BehrensG/MADC_ARTY/Hardware/Pinout.txt

GAIN_x10 - IO0 - T14
GAIN_x100 - IO1 - U12
SW_VRH - IO3 - V13
AD_CMP - IO4 - V15
AD_IRN - IO5 - T15
AD_IRP - IO6 - R16
AD_ID - IO7 - U17
AD_IIN - IO8 - V17
AZ_CTR - IO9 - V18
