BehrensG/MADC_ARTY/Software/vivado/MADC_ARTY_Z7/MADC_ARTY_Z7.runs/impl_1/.init_design.begin.rst

<?xml version="1.0"?>
<ProcessHandle Version="1" Minor="0">
    <Process Command=".planAhead." Owner="grzegorz" Host="" Pid="397433">
    </Process>
</ProcessHandle>
