BehrensG/MADC_ARTY/Software/vivado/MADC_ARTY_Z7/MADC_ARTY_Z7.runs/impl_1/.vivado.begin.rst

<?xml version="1.0"?>
<ProcessHandle Version="1" Minor="0">
    <Process Command="vivado" Owner="grzegorz" Host="archlinux" Pid="49196" HostCore="12" HostMemory="65488520">
    </Process>
</ProcessHandle>
<?xml version="1.0"?>
<ProcessHandle Version="1" Minor="0">
    <Process Command="vivado" Owner="grzegorz" Host="archlinux" Pid="86323" HostCore="12" HostMemory="65488520">
    </Process>
</ProcessHandle>
<?xml version="1.0"?>
<ProcessHandle Version="1" Minor="0">
    <Process Command="vivado" Owner="grzegorz" Host="archlinux" Pid="127596" HostCore="12" HostMemory="65488520">
    </Process>
</ProcessHandle>
<?xml version="1.0"?>
<ProcessHandle Version="1" Minor="0">
    <Process Command="vivado" Owner="grzegorz" Host="archlinux" Pid="166918" HostCore="12" HostMemory="65488520">
    </Process>
</ProcessHandle>
<?xml version="1.0"?>
<ProcessHandle Version="1" Minor="0">
    <Process Command="vivado" Owner="grzegorz" Host="archlinux" Pid="196931" HostCore="12" HostMemory="65488520">
    </Process>
</ProcessHandle>
<?xml version="1.0"?>
<ProcessHandle Version="1" Minor="0">
    <Process Command="vivado" Owner="grzegorz" Host="archlinux" Pid="236867" HostCore="12" HostMemory="65488520">
    </Process>
</ProcessHandle>
<?xml version="1.0"?>
<ProcessHandle Version="1" Minor="0">
    <Process Command="vivado" Owner="grzegorz" Host="archlinux" Pid="271964" HostCore="12" HostMemory="65488520">
    </Process>
</ProcessHandle>
<?xml version="1.0"?>
<ProcessHandle Version="1" Minor="0">
    <Process Command="vivado" Owner="grzegorz" Host="archlinux" Pid="322385" HostCore="12" HostMemory="65488520">
    </Process>
</ProcessHandle>
<?xml version="1.0"?>
<ProcessHandle Version="1" Minor="0">
    <Process Command="vivado" Owner="grzegorz" Host="archlinux" Pid="364940" HostCore="12" HostMemory="65488520">
    </Process>
</ProcessHandle>
<?xml version="1.0"?>
<ProcessHandle Version="1" Minor="0">
    <Process Command="vivado" Owner="grzegorz" Host="archlinux" Pid="397376" HostCore="12" HostMemory="65488520">
    </Process>
</ProcessHandle>
