BehrensG/MADC_ARTY/Software/vivado/MADC_ARTY_Z7/MADC_ARTY_Z7.runs/impl_1/clockInfo.txt

-------------------------------------
| Tool Version : Vivado v.2024.1
| Date         : Wed Oct 14 21:35:47 2026
| Host         : archlinux
| Design       : design_1
| Device       : xc7z010-clg400-1--
-------------------------------------

For more information on clockInfo.txt clock routing debug file see https://support.xilinx.com/s/article/000035660?language=en_US
