BehrensG/MADC_ARTY/Software/vivado/MADC_ARTY_Z7/MADC_ARTY_Z7.runs/MADC_ARTY_Z7_MADC_0_0_synth_1/.vivado.begin.rst

<?xml version="1.0"?>
<ProcessHandle Version="1" Minor="0">
    <Process Command="vivado" Owner="grzegorz" Host="archlinux" Pid="396401" HostCore="12" HostMemory="65488520">
    </Process>
</ProcessHandle>
