BehrensG/MADC_ARTY/Hardware/MADC_ARTY/CMRR.ods

Freq (Hz) | Sig A (Vrms) | Sig B (Vrms) | CMRR (dB)
100 | 3.5 | 1.83E-03 | 65.6323390923969 | 0.2196
200 | 3.57 | 1.84E-03 | 65.7570078620531 | 0.2208
300 | 3.64 | 3.80E-03 | 59.6263557406449 | 0.456
400 | 3.42 | 3.80E-03 | 59.0848501887865 | 0.456
500 | 3.5 | 3.81E-03 | 59.2628613734931 | 0.4572
600 | 3.53 | 3.81E-03 | 59.3369945942441 | 0.4572
700 | 3.64 | 3.40E-03 | 60.592449332136 | 0.408
800 | 3.57 | 3.40E-03 | 60.4237859813988 | 0.408
900 | 3.39 | 3.36E-03 | 60.0772084162648 | 0.4032
1000 | 3.42 | 3.40E-03 | 60.0509437802776 | 0.408
2000 | 3.42 | 3.04E-03 | 61.0230504489476 | 0.3648
3000 | 3.54 | 3.03E-03 | 61.3512126704697 | 0.3636
4000 | 3.41 | 2.60E-03 | 62.3556206204336 | 0.312
5000 | 3.51 | 2.60E-03 | 62.6066753699001 | 0.312
6000 | 3.54 | 2.60E-03 | 62.6805982810994 | 0.312
7000 | 3.43 | 2.63E-03 | 62.3067674310603 | 0.3156
8000 | 3.57 | 1.90E-03 | 65.4782923031873 | 0.228
9000 | 3.39 | 1.90E-03 | 65.0289219450051 | 0.228
10000 | 3.42 | 1.90E-03 | 65.1054501020661 | 0.228
20000 | 3.55 | 2.14E-03 | 64.3962915941181 | 0.2568
30000 | 3.54 | 2.41E-03 | 63.3397243890184 | 0.2892
40000 | 3.55 | 2.70E-03 | 62.3772917779221 | 0.324
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
