BehrensG/MADC_ARTY/Hardware/MADC/MADC.step

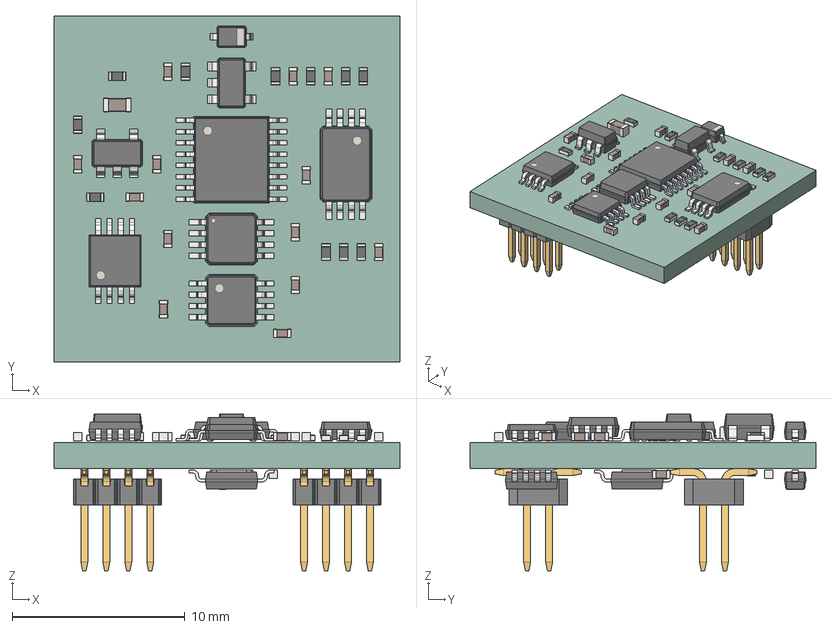
[picture p1: CAD file, 2025-08-14]
Hardware/MADC/MADC.step
20.0 x 20.0 x 9.05 mm
C_0402_1005Metric x 15
D_SOD-323 x 2
R_0402_1005Metric x 12
TSSOP-8_4.4x3mm_P0.65mm
C_0603_1608Metric
SOT-23-5 x 2
TSSOP-16_4.4x5mm_P0.65mm
VSSOP-8_3x3mm_P0.65mm
MSOP-8-1EP_3x3mm_P0.65mm_EP1.73x1.85mm x 3
MSOP-8_3x3mm_P0.65mm
621x0821021_Housing x 2
6210xx21021_PIN x 16
MADC_PCB
