BehrensG/MADC_ARTY/LTSpice/MADC.asc

A1: and
A3: dflop; Vhigh=3.3 Vlow=0 Ref=1.65
C1: cap; 0.0022µ; V=50 Irms=0 Rser=0.0481 Lser=423p mfg="Würth Elektronik" pn="885012008051 WCAP-CSGP 1206" type="NP0"
C2: cap; 33p; V=25 Irms=0 Rser=0 Lser=0 mfg="Murata" pn="GRM0335C1E330JA01" type="C0G"
D1: diode; 1N4148
D2: diode; 1N4148
R1: res; 62k
R2: res; 62
R3: res; 39k
R4: res; 3k9
R5: res; 3k9
R6: res; 620
R7: res; 12k
U1: OPAx140
U2: OPAx192
U3: ADA4177
U4: LT5400-1
U5: ADA4177
U6: LT5400-2
U8: ADG5412
U10: RH111
V1: voltage; 7
V2: voltage; 18
V3: voltage; -14
V4: voltage; 3.3
V5: voltage; 6
V6: voltage; 3.3
V9: voltage; 0
V11: voltage; PULSE(3.3 0 100u 100n 100n 50u 100u)
Named nets: 0, VDD, VSS, AD_REF_N, AD_REF_P, AD_IIN, AD_IRP, AD_IRN, AD_ID, MEAS_VOLT, VCC, AD_CMP, WAVE
.tran 0 0.021 40u 1u uic
.options plotwinsize=0
.wave "Z:\\home\\grzegorz\\git\\MADC_ARTY\\LTSpice\\wave.wav" 16 1000000 V(wave)
