BehrensG/MADC_ARTY/LTSpice/Logic.asc

A2: srflop; Vhigh=3.3 Vlow=0 Ref=1.65
C1: cap; 100n
R1: res; 10
V1: voltage; PULSE(0 3.3 0 1n 1n 1u 200u)
V2: voltage; PULSE(0 3.3 0 1n 1n 100u 200u)
Named nets: 0
.tran 25m uic
