BehrensG/MADC_ARTY/LTSpice/Draft1.asc

J1: njf
R1: res; 10k
R2: res; 10k
R3: res; 3k2
U1: OP07
Named nets: 0
