BehrensG/MADC_ARTY/LTSpice/Frontend.asc

1Meg: res; 100k
J1: njf; 2N4392
J2: njf; 2N4392
Q1: npn; SST3904
Q2: npn; SST3904
Q3: npn; SST3904
Q4: npn; SST3904
Q5: npn; SST3904
Q6: npn; SST3904
Q7: npn; SST3904
Q8: npn; SST3904
R1: res; 21k5
R2: res; 2k
R3: res; 14k7
R4: res; 2k
R5: res; 2k
R6: res; 21k5
R7: res; 21k5
R8: res; 21k5
R9: res; 2k
R10: res; 14k7
R11: res; 2k
R12: res; 2k
R13: res; 21k5
R14: res; 21k5
R15: res; 10
R16: res; 10
R17: res; 100k
U1: ADA4622
U2: ADA4622
U3: ADA4622
U4: ADA4622
U5: JFEx140
U6: JFEx140
U7: JFEx140
U8: JFEx140
U9: OP27
U10: ADA4622
U11: OP27
U12: ADA4622
U13: ADA4622
U14: ADA4622
V1: voltage; 16
V2: voltage; -16
V3: voltage; 10
V4: voltage; SINE(0 10 800k); AC 1
Named nets: 0, VCC, VEE, VREF, OUT_P, OUT_N, IN_P, IN_N
.tran 0.0001 uic
.ac oct 1000 1 50Meg
