BehrensG/MADC_ARTY/LTSpice/LDOs.asc

C1: cap; 10µ; V=50 Irms=0 Rser=0.003 Lser=1.2n mfg="Würth Elektronik" pn="885012214005 WCAP-CSGP 2220" type="X7R"
C2: cap; 10µ; V=50 Irms=0 Rser=0.003 Lser=1.2n mfg="Würth Elektronik" pn="885012214005 WCAP-CSGP 2220" type="X7R"
C3: cap; 10µ; V=50 Irms=0 Rser=0.003 Lser=1.2n mfg="Würth Elektronik" pn="885012214005 WCAP-CSGP 2220" type="X7R"
C4: cap; 10µ; V=50 Irms=0 Rser=0.003 Lser=1.2n mfg="Würth Elektronik" pn="885012214005 WCAP-CSGP 2220" type="X7R"
C5: cap; 10µ; V=50 Irms=0 Rser=0.003 Lser=1.2n mfg="Würth Elektronik" pn="885012214005 WCAP-CSGP 2220" type="X7R"
C6: cap; 10µ; V=50 Irms=0 Rser=0.003 Lser=1.2n mfg="Würth Elektronik" pn="885012214005 WCAP-CSGP 2220" type="X7R"
C7: cap; 10µ; V=50 Irms=0 Rser=0.003 Lser=1.2n mfg="Würth Elektronik" pn="885012214005 WCAP-CSGP 2220" type="X7R"
R1: res; 620k
R2: res; 44.3k
R3: res; 620k
R4: res; 49.9k
R5: res; 620k
R6: res; 45.2k
R7: res; 620k
R8: res; 51.1k
R9: res; 620k
R10: res; 59k
U1: ADP7142
U2: ADP7142
U3: ADP7182
U5: ADP7182
U6: ADP7182
V1: voltage; 20
V2: voltage; -20
V3: voltage; -20
Named nets: 0
.tran 1
