BehrensG/MADC_ARTY/LTSpice/REFV.asc

C1: cap; 1µ; V=50 Irms=0 Rser=0.008 Lser=0 mfg="TDK" pn="C3225X7RlHlO5M" type="X7R"
D1: diode; STZ5_6N
D2: diode; STZ5_6N
Q1: npn; BC847C
Q2: pnp; BC857C
R1: res; 12
R2: res; 12k
R3: res; 2.49k
R4: res; 12k
R5: res; 8.2k
R6: res; 100k
U1: ADR1399E
U2: AD706
U3: LT5400-1
U5: AD706
V1: voltage; 15
V2: voltage; -15
Named nets: 0, VCC, VEE
.tran 0.5 startup
