BehrensG/MADC_ARTY/LTSpice/VREF.asc

C1: cap; 0.1µ; V=100 Irms=835m Rser=0.0936732 Lser=0 mfg="KEMET" pn="C1812C104K1RAC" type="X7R"
C2: cap; 0.1µ; V=100 Irms=835m Rser=0.0936732 Lser=0 mfg="KEMET" pn="C1812C104K1RAC" type="X7R"
R1: res; 2k7
R2: res; 62
R3: res; 2k7
R4: res; 62
R5: res; 5k
R6: res; 5k
R7: res; 10k
R8: res; 6k98
R9: res; 69.8
R10: res; 5k
R11: res; 5k
R12: res; 10k
R13: res; 6k98
R14: res; 69.8
U1: ADR1399E
U2: OP27
U3: ADR1399H
U4: OP27
U5: OP27
U6: OP27
U7: OP27
U8: OP27
V1: voltage; 18
V2: voltage; -18
V3: voltage; -14
Named nets: 0, VCC, VEE, VDD, P7VA, N7VA, P10VA, P7VB, N7VB, P10VB
.tran 40
