BehrensG/MADC_ARTY/Hardware/MADC_ARTY/MADC_ARTY.kicad_pcb

## KiCad design Hardware/MADC_ARTY/MADC_ARTY.kicad_pcb (2025-08-14)

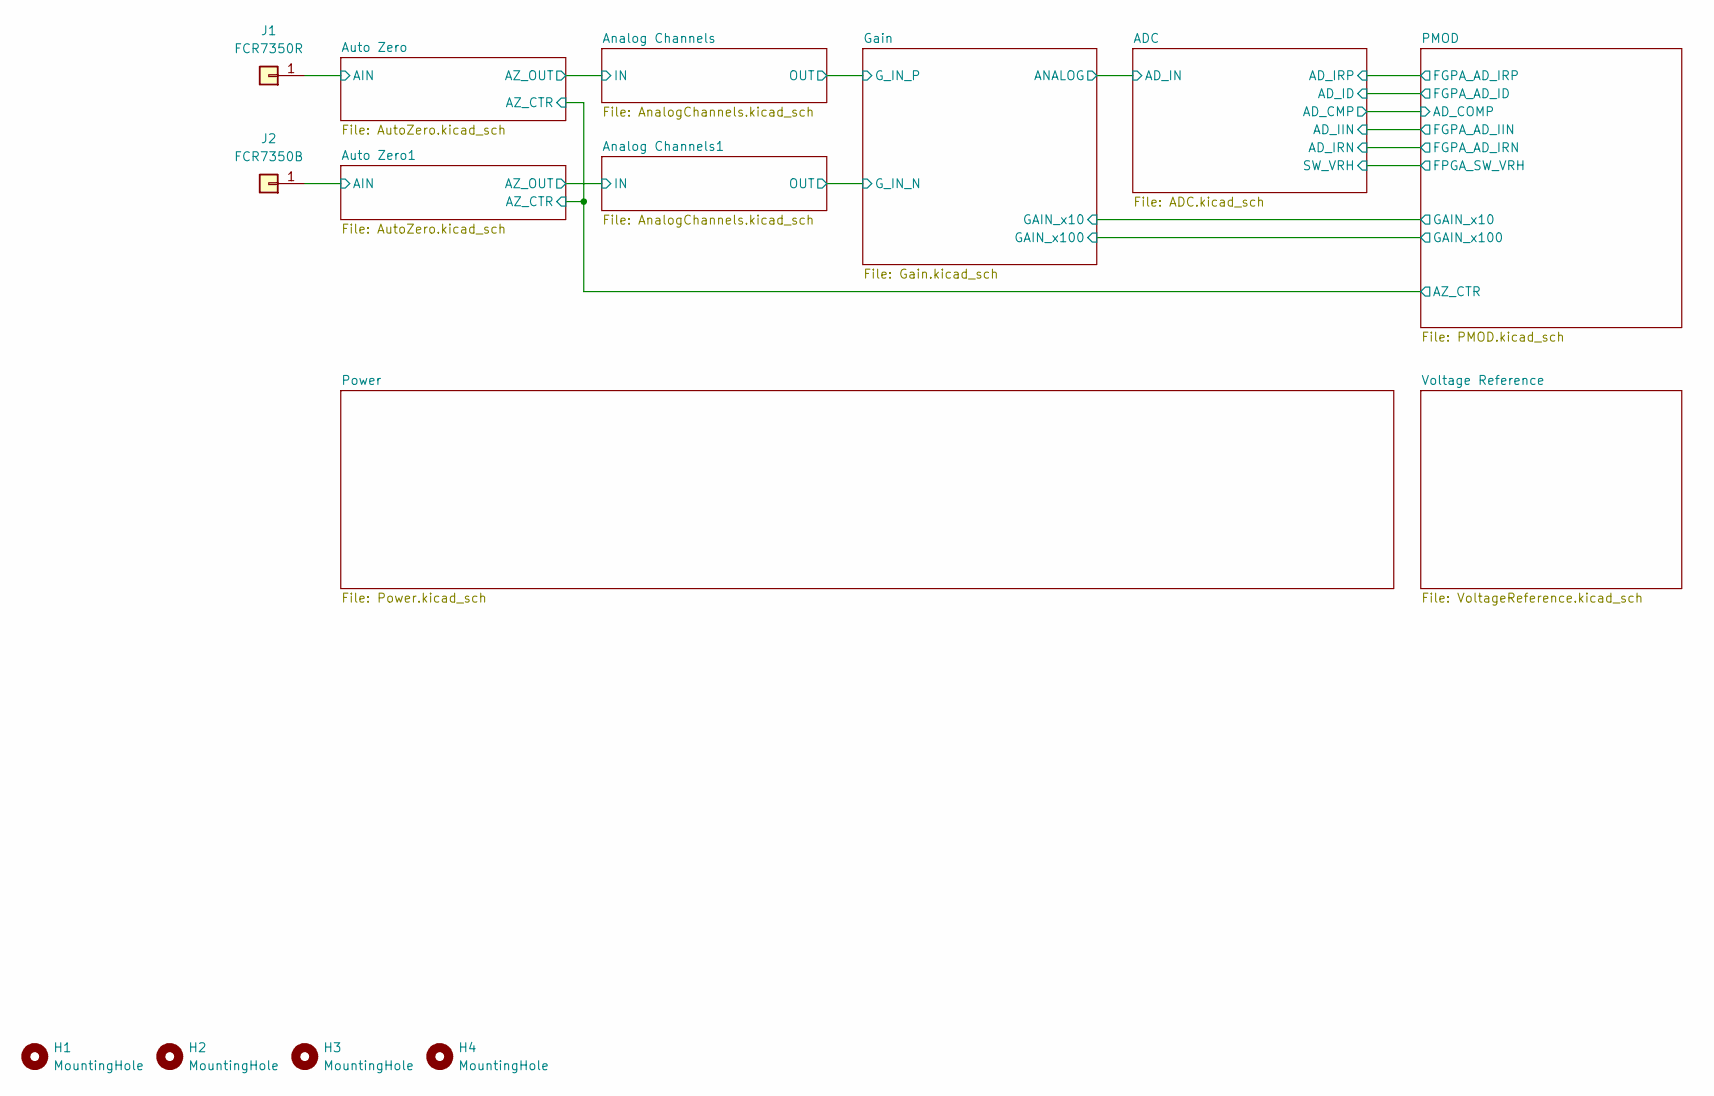
[picture p2: schematic BlockDiagram.kicad_sch]

Parts:
H1, H2, H3, H4: MountingHole; MountingHole_3.2mm_M3_DIN965_Pad
J1: FCR7350R; S16N-PC
J2: FCR7350B; S16N-PC

Connections:
/Block Diagram/Auto Zero1/AIN: J2.1; also elsewhere on the board
/Block Diagram/Auto Zero/AIN: J1.1; also elsewhere on the board

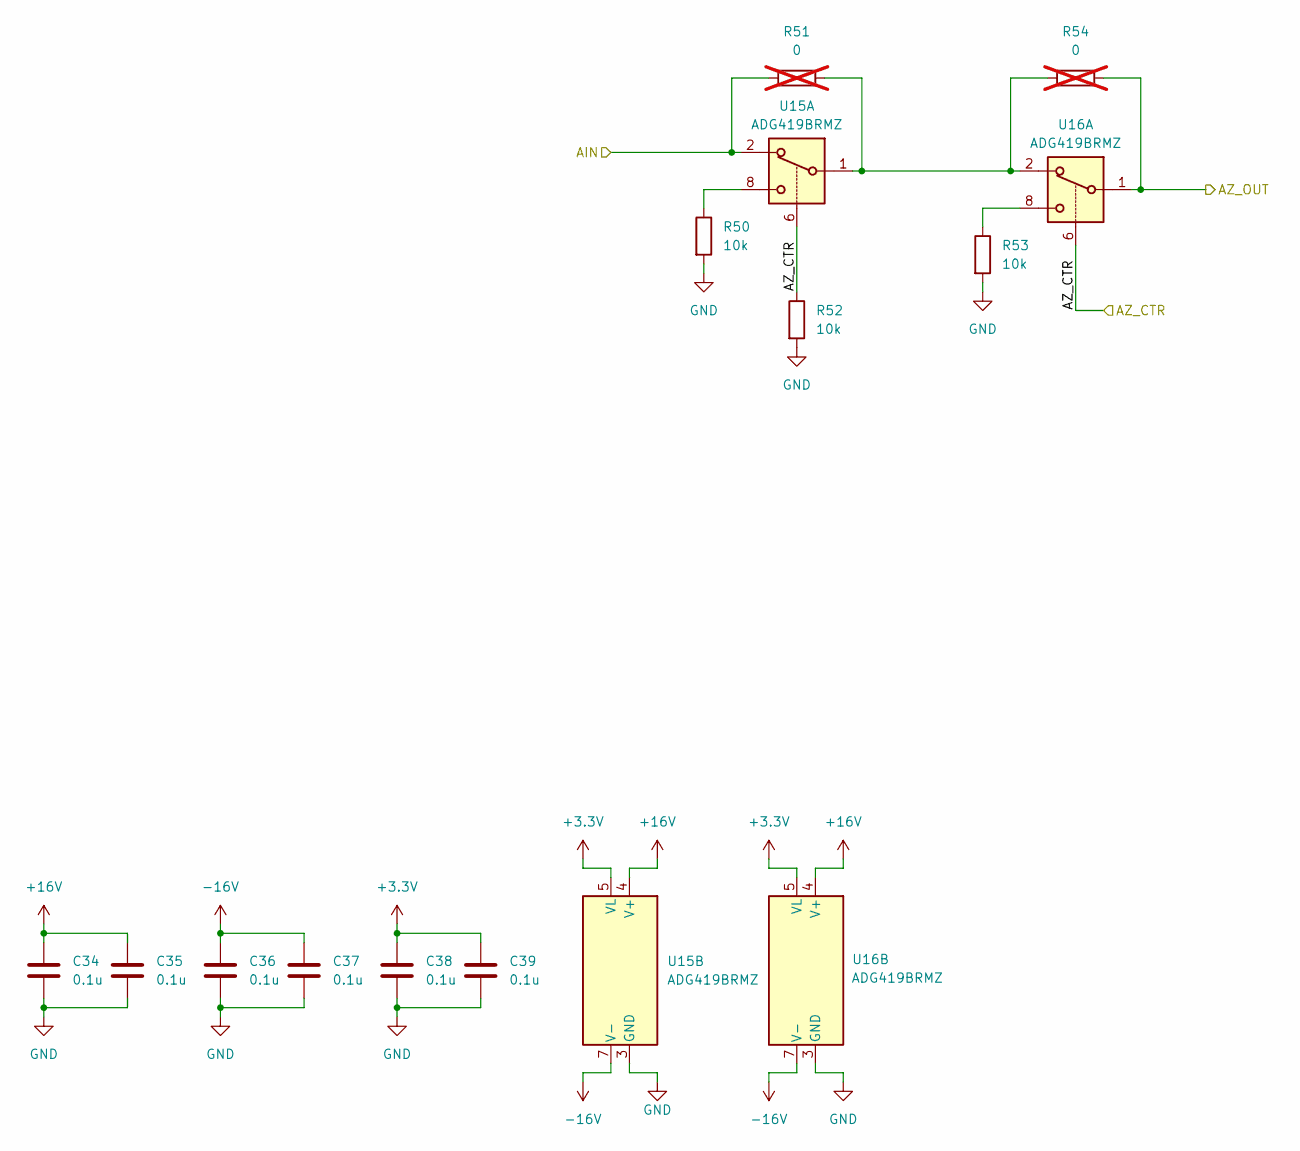
[picture p3: schematic AutoZero.kicad_sch]

Parts:
C34, C35, C36, C37, C38, C39: 0.1u; C_0603_1608Metric
R50, R52, R53: 10k; R_0603_1608Metric
R51, R54: 0; R_0603_1608Metric; not fitted
U15, U16: ADG419BRMZ; MSOP-8_3x3mm_P0.65mm

Connections:
+3.3V: C38.1, C39.1, U15.5 (VL), U16.5 (VL); also elsewhere on the board
+16V: C34.1, C35.1, U15.4 (V+), U16.4 (V+); also elsewhere on the board
-16V: C36.1, C37.1, U15.7 (V-), U16.7 (V-); also elsewhere on the board
/Block Diagram/Analog Channels/IN: R54.2, U16.1; also elsewhere on the board
/Block Diagram/Auto Zero/AIN: R51.1, U15.2; also elsewhere on the board
/Block Diagram/Auto Zero/AZ_CTR: R52.1, U15.6, U16.6; also elsewhere on the board
GND: C34.2, C35.2, C36.2, C37.2, C38.2, C39.2, R50.2, R52.2, R53.2, U15.3 (GND), U16.3 (GND); also elsewhere on the board
unnamed: R50.1, U15.8
unnamed: R51.2, R54.1, U15.1, U16.2
unnamed: R53.1, U16.8

Parts of its further copies:
C47, C48, C49, C50, C51, C52: 0.1u; C_0603_1608Metric
R76, R78, R79: 10k; R_0603_1608Metric
R77, R80: 0; R_0603_1608Metric; not fitted
U23, U24: ADG419BRMZ; MSOP-8_3x3mm_P0.65mm

Connections of its further copies:
+3.3V: C51.1, C52.1, U23.5 (VL), U24.5 (VL); also elsewhere on the board
+16V: C47.1, C48.1, U23.4 (V+), U24.4 (V+); also elsewhere on the board
-16V: C49.1, C50.1, U23.7 (V-), U24.7 (V-); also elsewhere on the board
/Block Diagram/Analog Channels1/IN: R80.2, U24.1; also elsewhere on the board
/Block Diagram/Auto Zero1/AIN: R77.1, U23.2; also elsewhere on the board
/Block Diagram/Auto Zero/AZ_CTR: R78.1, U23.6, U24.6; also elsewhere on the board
GND: C47.2, C48.2, C49.2, C50.2, C51.2, C52.2, R76.2, R78.2, R79.2, U23.3 (GND), U24.3 (GND); also elsewhere on the board
unnamed: R76.1, U23.8
unnamed: R77.2, R80.1, U23.1, U24.2
unnamed: R79.1, U24.8

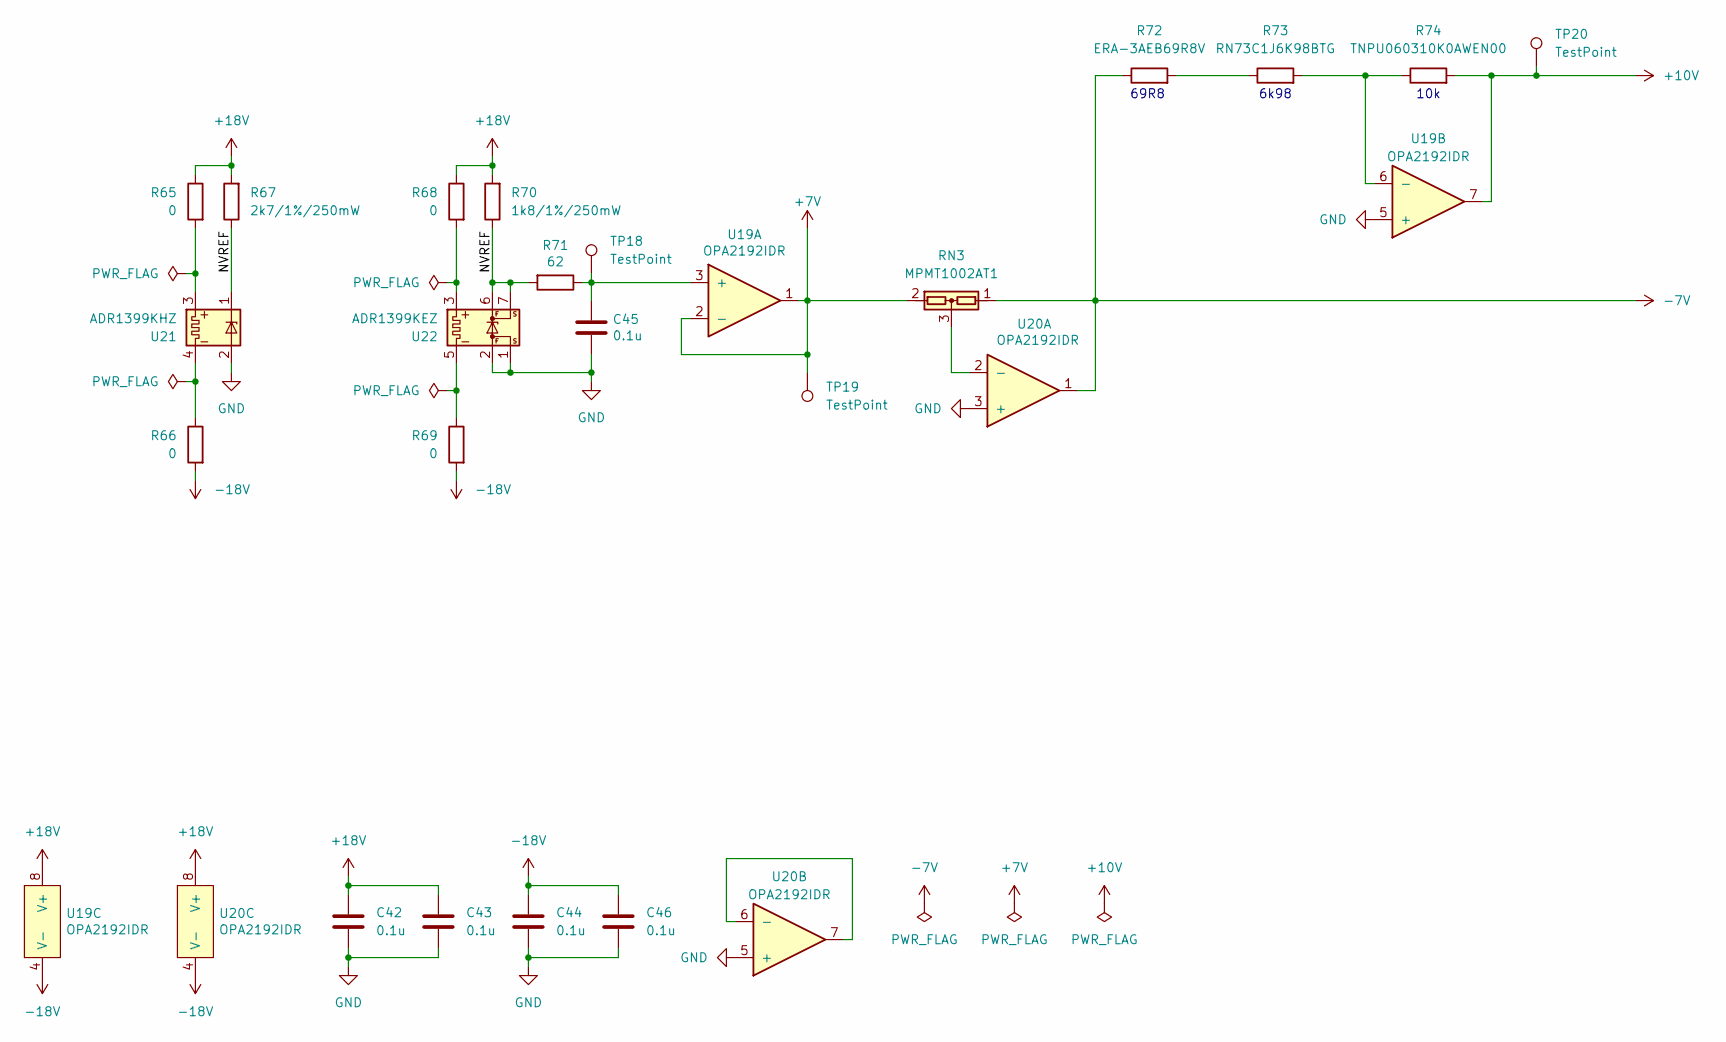
[picture p4: schematic VoltageReference.kicad_sch]

Parts:
C42, C43, C44, C45, C46: 0.1u; C_0603_1608Metric
R65, R66, R68, R69: 0; R_0603_1608Metric
R67: 2k7/1%/250mW; R_0603_1608Metric
R70: 1k8/1%/250mW; R_0603_1608Metric
R71: 62; R_0603_1608Metric
R72: ERA-3AEB69R8V; R_0603_1608Metric
R73: RN73C1J6K98BTG; R_0603_1608Metric
R74: TNPU060310K0AWEN00; R_0603_1608Metric
RN3: MPMT1002AT1; SOT-23
TP18, TP19, TP20: TestPoint; TestPoint_Pad_D2.0mm
U19, U20: OPA2192IDR; SOIC-8_3.9x4.9mm_P1.27mm
U21: ADR1399KHZ; Analog_TO-46-4_ThermalShield
U22: ADR1399KEZ; Analog_LCC-8_5x5mm_P1.27mm

Connections:
+7V: RN3.2, TP19.1, U19.1, U19.2 (-); also elsewhere on the board
+10V: R74.2, TP20.1, U19.7; also elsewhere on the board
+18V: C42.1, C43.1, R65.1, R67.2, R68.1, R70.2, U19.8 (V+), U20.8 (V+); also elsewhere on the board
-7V: R72.1, RN3.1, U20.1; also elsewhere on the board
-18V: C44.1, C46.1, R66.2, R69.2, U19.4 (V-), U20.4 (V-); also elsewhere on the board
/Block Diagram/Voltage Reference/NVREF: R67.1, R70.1, R71.2, U21.1, U22.6 (+REFF), U22.7 (+REFS)
GND: C42.2, C43.2, C44.2, C45.2, C46.2, U19.5 (+), U20.3 (+), U20.5 (+), U21.2, U22.1 (-REFS), U22.2 (-REFF); also elsewhere on the board
unnamed: R65.2, U21.3
unnamed: R66.1, U21.4
unnamed: R72.2, R73.1
unnamed: C45.1, R71.1, TP18.1, U19.3 (+)
unnamed: R73.2, R74.1, U19.6 (-)
unnamed: RN3.3, U20.2 (-)
unnamed: U20.6 (-), U20.7
unnamed: R68.2, U22.3 (HEATER+)
unnamed: R69.1, U22.5 (HEATER-)

Notes on the sheet:
6k98
10k
69R8

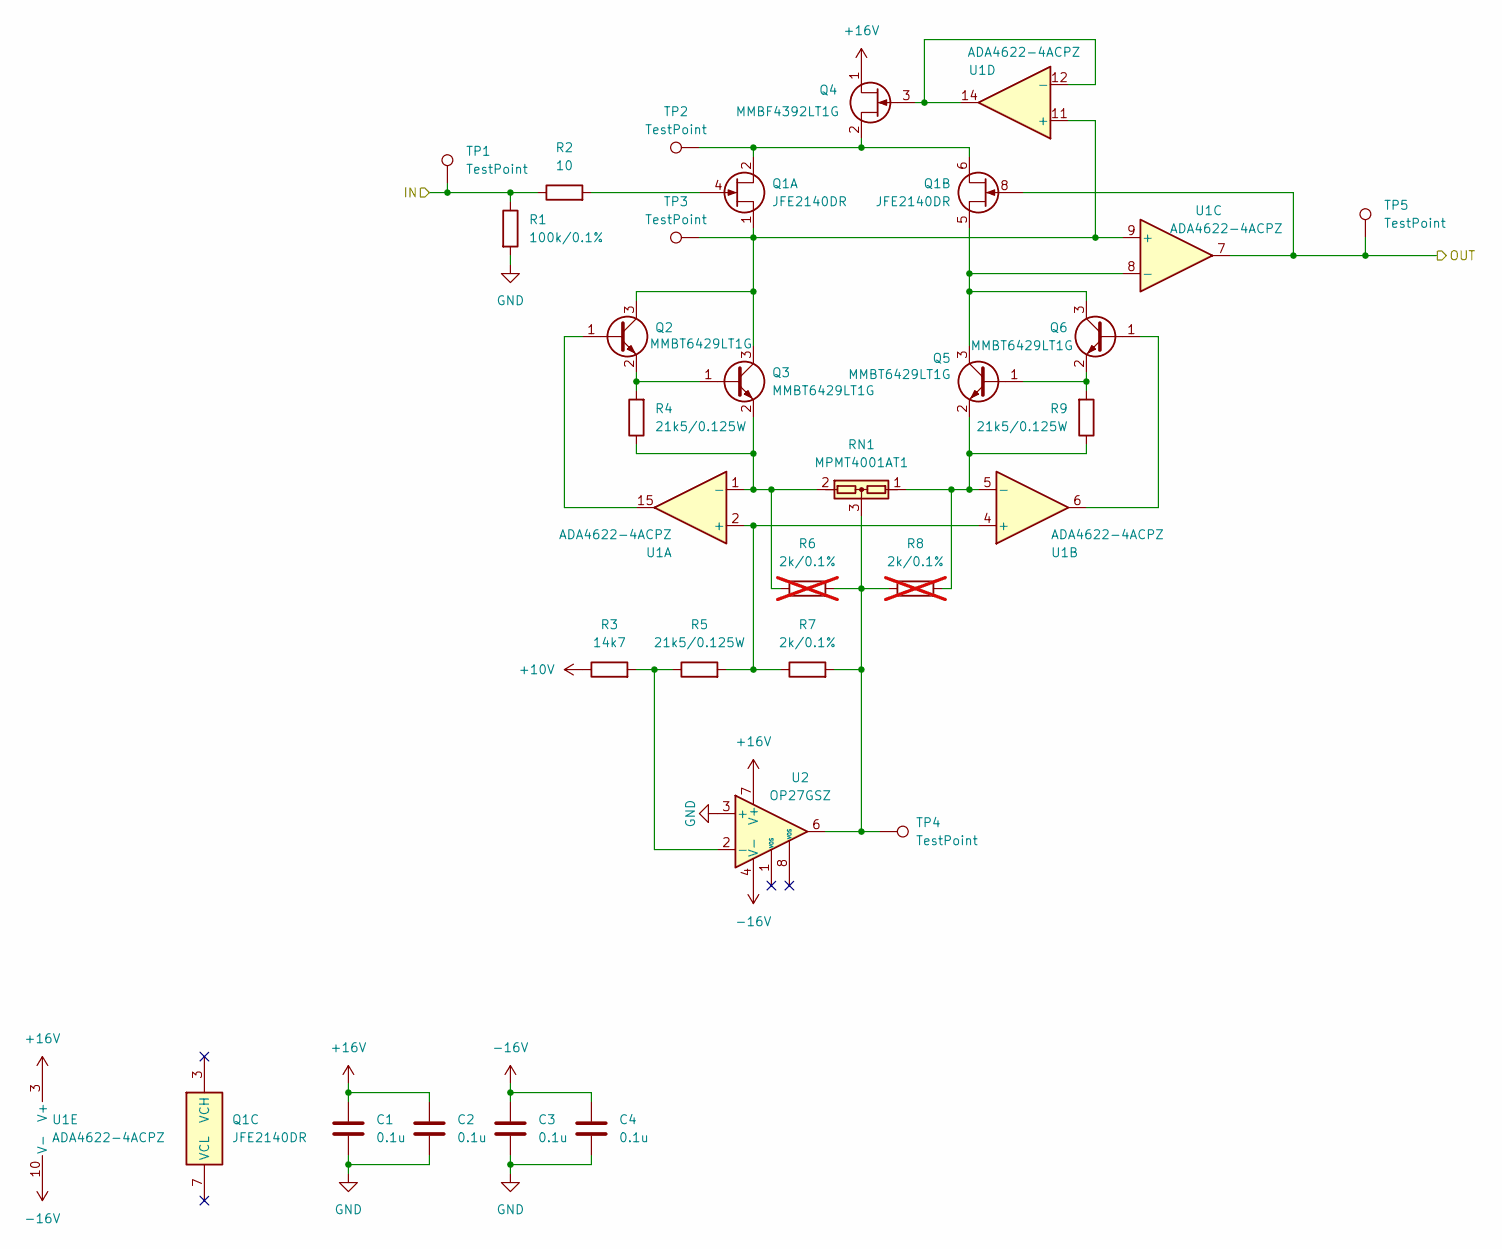
[picture p5: schematic AnalogChannels.kicad_sch]

Parts:
C1, C2, C3, C4: 0.1u; C_0603_1608Metric
Q1: JFE2140DR; SOIC-8_3.9x4.9mm_P1.27mm
Q2, Q3, Q5, Q6: MMBT6429LT1G; SOT-23
Q4: MMBF4392LT1G; SOT-23
R1: 100k/0.1%; R_0603_1608Metric
R2: 10; R_0603_1608Metric
R3: 14k7; R_0603_1608Metric
R4, R5, R9: 21k5/0.125W; R_0603_1608Metric
R6, R8: 2k/0.1%; R_0603_1608Metric; not fitted
R7: 2k/0.1%; R_0603_1608Metric
RN1: MPMT4001AT1; SOT-23
TP1, TP2, TP3, TP4, TP5: TestPoint; TestPoint_Pad_D2.0mm
U1: ADA4622-4ACPZ; Analog_LFCSP-16-1EP_4x4mm_P0.65mm_EP2.35x2.35mm
U2: OP27GSZ; SOIC-8_3.9x4.9mm_P1.27mm

Connections:
+10V: R3.1; also elsewhere on the board
+16V: C1.1, C2.1, Q4.1 (D), U1.3 (V+), U1.17 (V+), U2.7 (V+); also elsewhere on the board
-16V: C3.1, C4.1, U1.10 (V-), U2.4 (V-); also elsewhere on the board
/Block Diagram/Analog Channels/IN: R1.1, R2.1, TP1.1; also elsewhere on the board
/Block Diagram/Analog Channels/OUT: Q1.8, TP5.1, U1.7; also elsewhere on the board
GND: C1.2, C2.2, C3.2, C4.2, R1.2, U2.3 (+); also elsewhere on the board
unnamed: Q1.4, R2.2
unnamed: Q2.1 (B), U1.15
unnamed: Q1.1, Q2.3 (C), Q3.3 (C), TP3.1, U1.9 (+), U1.11 (+)
unnamed: Q2.2 (E), Q3.1 (B), R4.2
unnamed: Q3.2 (E), R4.1, R6.1, RN1.2, U1.1 (-)
unnamed: Q4.3 (G), U1.12 (-), U1.14
unnamed: Q1.2, Q1.6, Q4.2 (S), TP2.1
unnamed: Q5.1 (B), Q6.2 (E), R9.2
unnamed: Q1.5, Q5.3 (C), Q6.3 (C), U1.8 (-)
unnamed: Q5.2 (E), R8.2, R9.1, RN1.1, U1.5 (-)
unnamed: Q6.1 (B), U1.6
unnamed: R6.2, R7.2, R8.1, RN1.3, TP4.1, U2.6
unnamed: R5.2, R7.1, U1.2 (+), U1.4 (+)
unnamed: R3.2, R5.1, U2.2 (-)

Parts of its further copies:
C53, C54, C55, C56: 0.1u; C_0603_1608Metric
Q9: JFE2140DR; SOIC-8_3.9x4.9mm_P1.27mm
Q10, Q11, Q13, Q14: MMBT6429LT1G; SOT-23
Q12: MMBF4392LT1G; SOT-23
R81: 100k/0.1%; R_0603_1608Metric
R82: 10; R_0603_1608Metric
R83: 14k7; R_0603_1608Metric
R84, R85, R89: 21k5/0.125W; R_0603_1608Metric
R86, R88: 2k/0.1%; R_0603_1608Metric; not fitted
R87: 2k/0.1%; R_0603_1608Metric
RN4: MPMT4001AT1; SOT-23
TP30, TP31, TP32, TP33, TP34: TestPoint; TestPoint_Pad_D2.0mm
U25: ADA4622-4ACPZ; Analog_LFCSP-16-1EP_4x4mm_P0.65mm_EP2.35x2.35mm
U26: OP27GSZ; SOIC-8_3.9x4.9mm_P1.27mm

Connections of its further copies:
+10V: R83.1; also elsewhere on the board
+16V: C53.1, C54.1, Q12.1 (D), U25.3 (V+), U25.17 (V+), U26.7 (V+); also elsewhere on the board
-16V: C55.1, C56.1, U25.10 (V-), U26.4 (V-); also elsewhere on the board
/Block Diagram/Analog Channels1/IN: R81.1, R82.1, TP30.1; also elsewhere on the board
/Block Diagram/Analog Channels1/OUT: Q9.8, TP34.1, U25.7; also elsewhere on the board
GND: C53.2, C54.2, C55.2, C56.2, R81.2, U26.3 (+); also elsewhere on the board
unnamed: Q9.4, R82.2
unnamed: Q10.1 (B), U25.15
unnamed: Q9.1, Q10.3 (C), Q11.3 (C), TP32.1, U25.9 (+), U25.11 (+)
unnamed: Q10.2 (E), Q11.1 (B), R84.2
unnamed: Q11.2 (E), R84.1, R86.1, RN4.2, U25.1 (-)
unnamed: Q12.3 (G), U25.12 (-), U25.14
unnamed: Q9.2, Q9.6, Q12.2 (S), TP31.1
unnamed: Q13.1 (B), Q14.2 (E), R89.2
unnamed: Q9.5, Q13.3 (C), Q14.3 (C), U25.8 (-)
unnamed: Q13.2 (E), R88.2, R89.1, RN4.1, U25.5 (-)
unnamed: Q14.1 (B), U25.6
unnamed: R86.2, R87.2, R88.1, RN4.3, TP33.1, U26.6
unnamed: R85.2, R87.1, U25.2 (+), U25.4 (+)
unnamed: R83.2, R85.1, U26.2 (-)

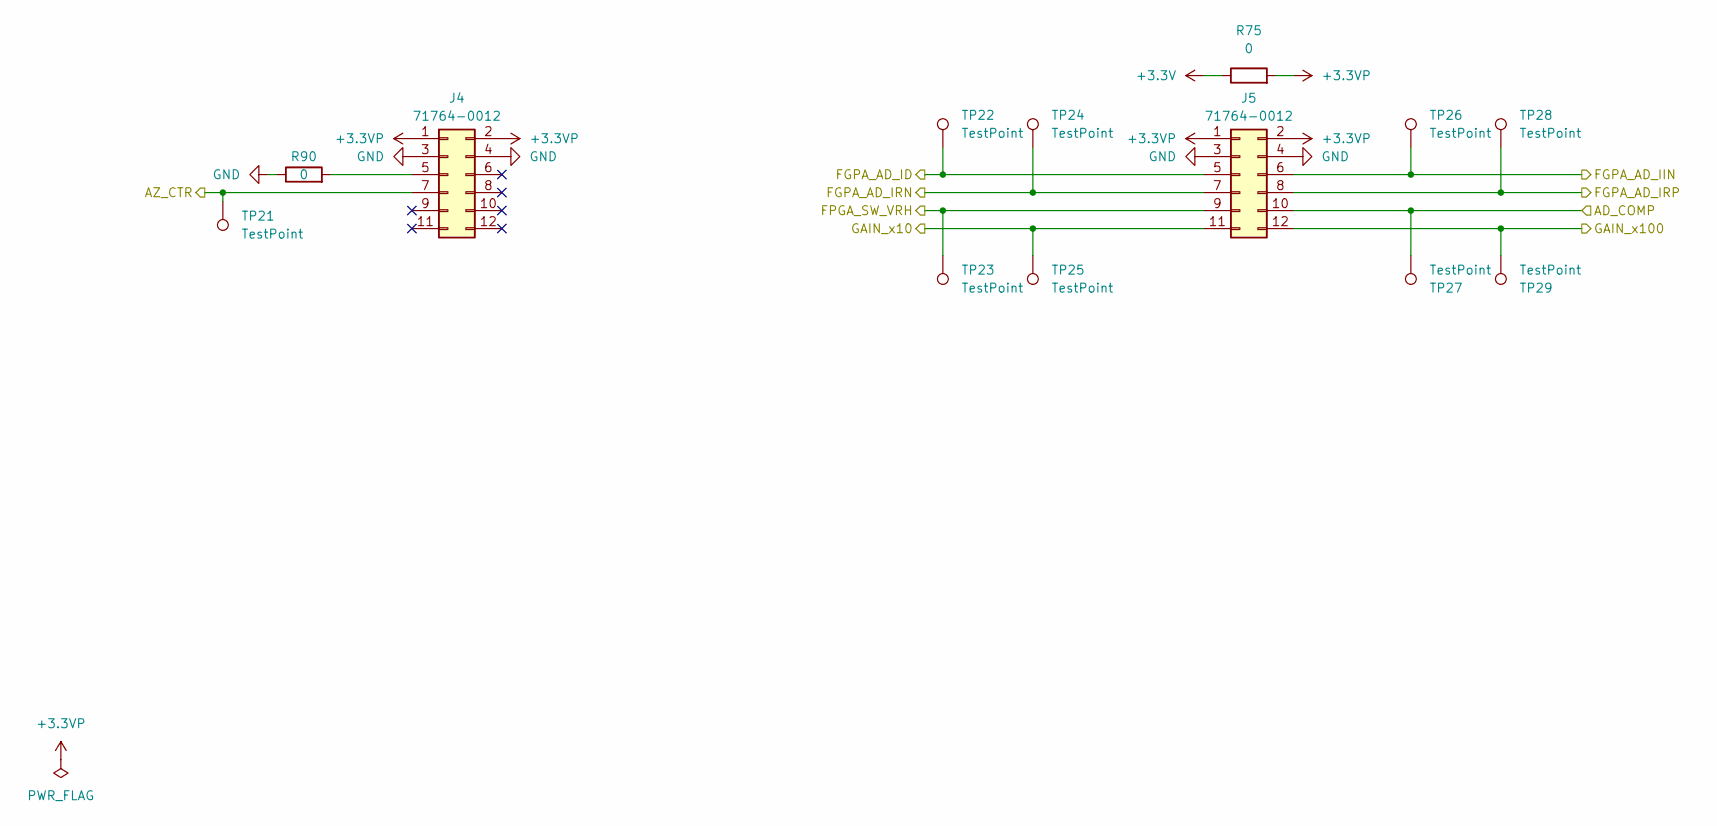
[picture p6: schematic PMOD.kicad_sch]

Parts:
J4, J5: 71764-0012; PinHeader_2x06_P2.54mm_Horizontal
R75, R90: 0; R_0603_1608Metric
TP21, TP22, TP23, TP24, TP25, TP26, TP27, TP28, TP29: TestPoint; TestPoint_Pad_D2.0mm

Connections:
+3.3V: R75.1; also elsewhere on the board
+3.3VP: J4.1, J4.2, J5.1, J5.2, R75.2; also elsewhere on the board
/Block Diagram/ADC/AD_CMP: J5.10, TP27.1; also elsewhere on the board
/Block Diagram/ADC/AD_ID: J5.5, TP22.1; also elsewhere on the board
/Block Diagram/ADC/AD_IIN: J5.6, TP26.1; also elsewhere on the board
/Block Diagram/ADC/AD_IRN: J5.7, TP24.1; also elsewhere on the board
/Block Diagram/ADC/AD_IRP: J5.8, TP28.1; also elsewhere on the board
/Block Diagram/ADC/SW_VRH: J5.9, TP23.1; also elsewhere on the board
/Block Diagram/Auto Zero/AZ_CTR: J4.7, TP21.1; also elsewhere on the board
/Block Diagram/Gain/GAIN_x10: J5.11, TP25.1; also elsewhere on the board
/Block Diagram/Gain/GAIN_x100: J5.12, TP29.1; also elsewhere on the board
GND: J4.3, J4.4, J5.3, J5.4, R90.1; also elsewhere on the board
unnamed: J4.5, R90.2

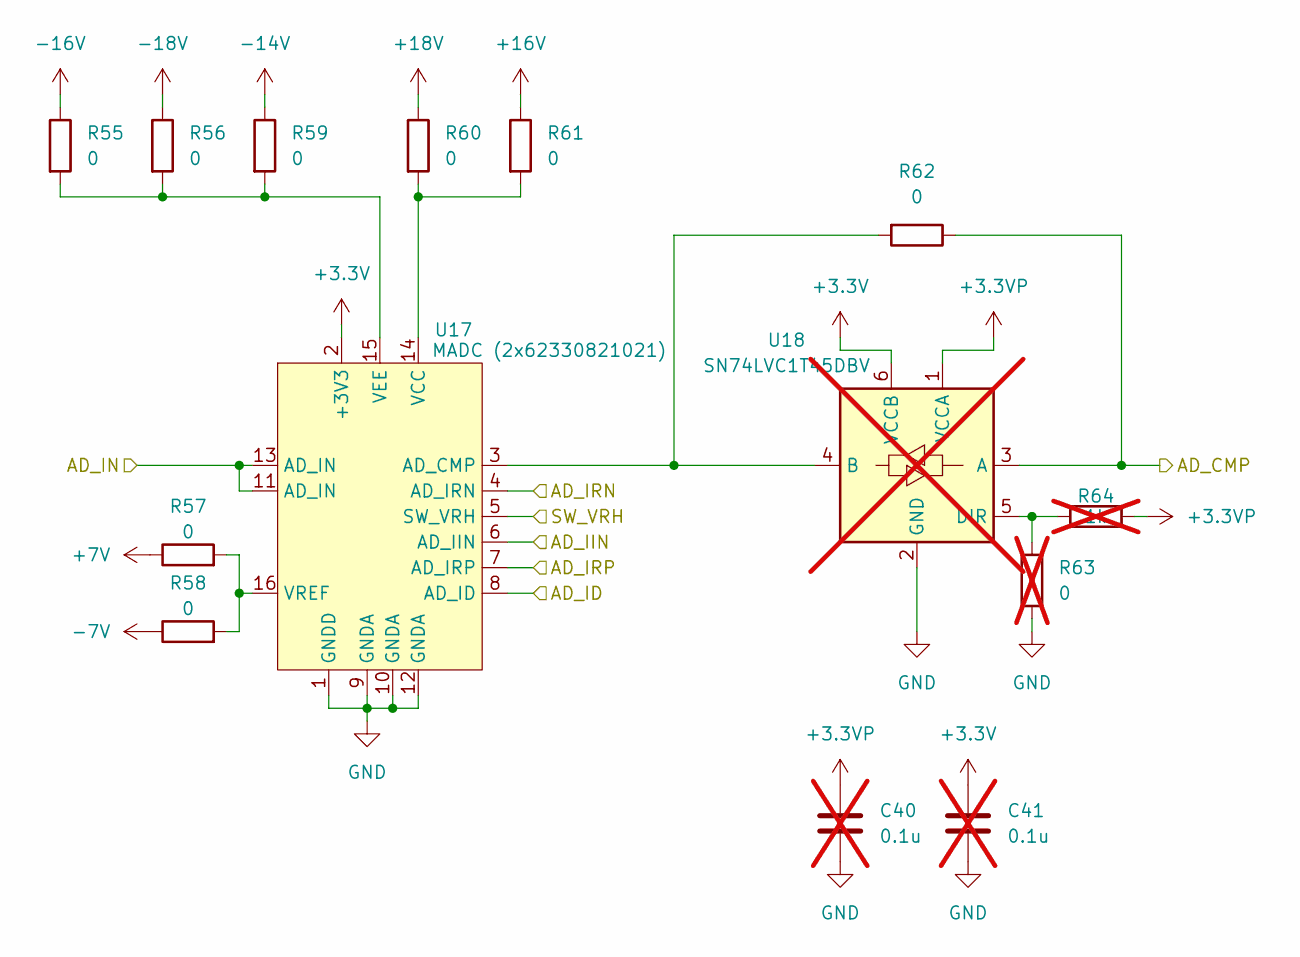
[picture p7: schematic ADC.kicad_sch]

Parts:
C40, C41: 0.1u; C_0603_1608Metric; not fitted
R55, R56, R57, R58, R59, R60, R61, R62: 0; R_0603_1608Metric
R63: 0; R_0603_1608Metric; not fitted
R64: 1k; R_0603_1608Metric; not fitted
U17: MADC (2x62330821021); MADC
U18: SN74LVC1T45DBV; SOT-23-6; not fitted

Connections:
+3.3V: C41.1, U17.2 (+3V3), U18.6 (VCCB); also elsewhere on the board
+3.3VP: C40.1, R64.1, U18.1 (VCCA); also elsewhere on the board
+7V: R57.1; also elsewhere on the board
+16V: R61.1; also elsewhere on the board
+18V: R60.1; also elsewhere on the board
-7V: R58.1; also elsewhere on the board
-14V: R59.1; also elsewhere on the board
-16V: R55.1; also elsewhere on the board
-18V: R56.1; also elsewhere on the board
/Block Diagram/ADC/AD_CMP: R62.1, U18.3 (A); also elsewhere on the board
/Block Diagram/ADC/AD_ID: U17.8 (AD_ID); also elsewhere on the board
/Block Diagram/ADC/AD_IIN: U17.6 (AD_IIN); also elsewhere on the board
/Block Diagram/ADC/AD_IN: U17.11 (AD_IN), U17.13 (AD_IN); also elsewhere on the board
/Block Diagram/ADC/AD_IRN: U17.4 (AD_IRN); also elsewhere on the board
/Block Diagram/ADC/AD_IRP: U17.7 (AD_IRP); also elsewhere on the board
/Block Diagram/ADC/SW_VRH: U17.5 (SW_VRH); also elsewhere on the board
GND: C40.2, C41.2, R63.1, U17.1 (GNDD), U17.9 (GNDA), U17.10 (GNDA), U17.12 (GNDA), U18.2 (GND); also elsewhere on the board
unnamed: R62.2, U17.3 (AD_CMP), U18.4 (B)
unnamed: R60.2, R61.2, U17.14 (VCC)
unnamed: R55.2, R56.2, R59.2, U17.15 (VEE)
unnamed: R57.2, R58.2, U17.16 (VREF)
unnamed: R63.2, R64.2, U18.5 (DIR)

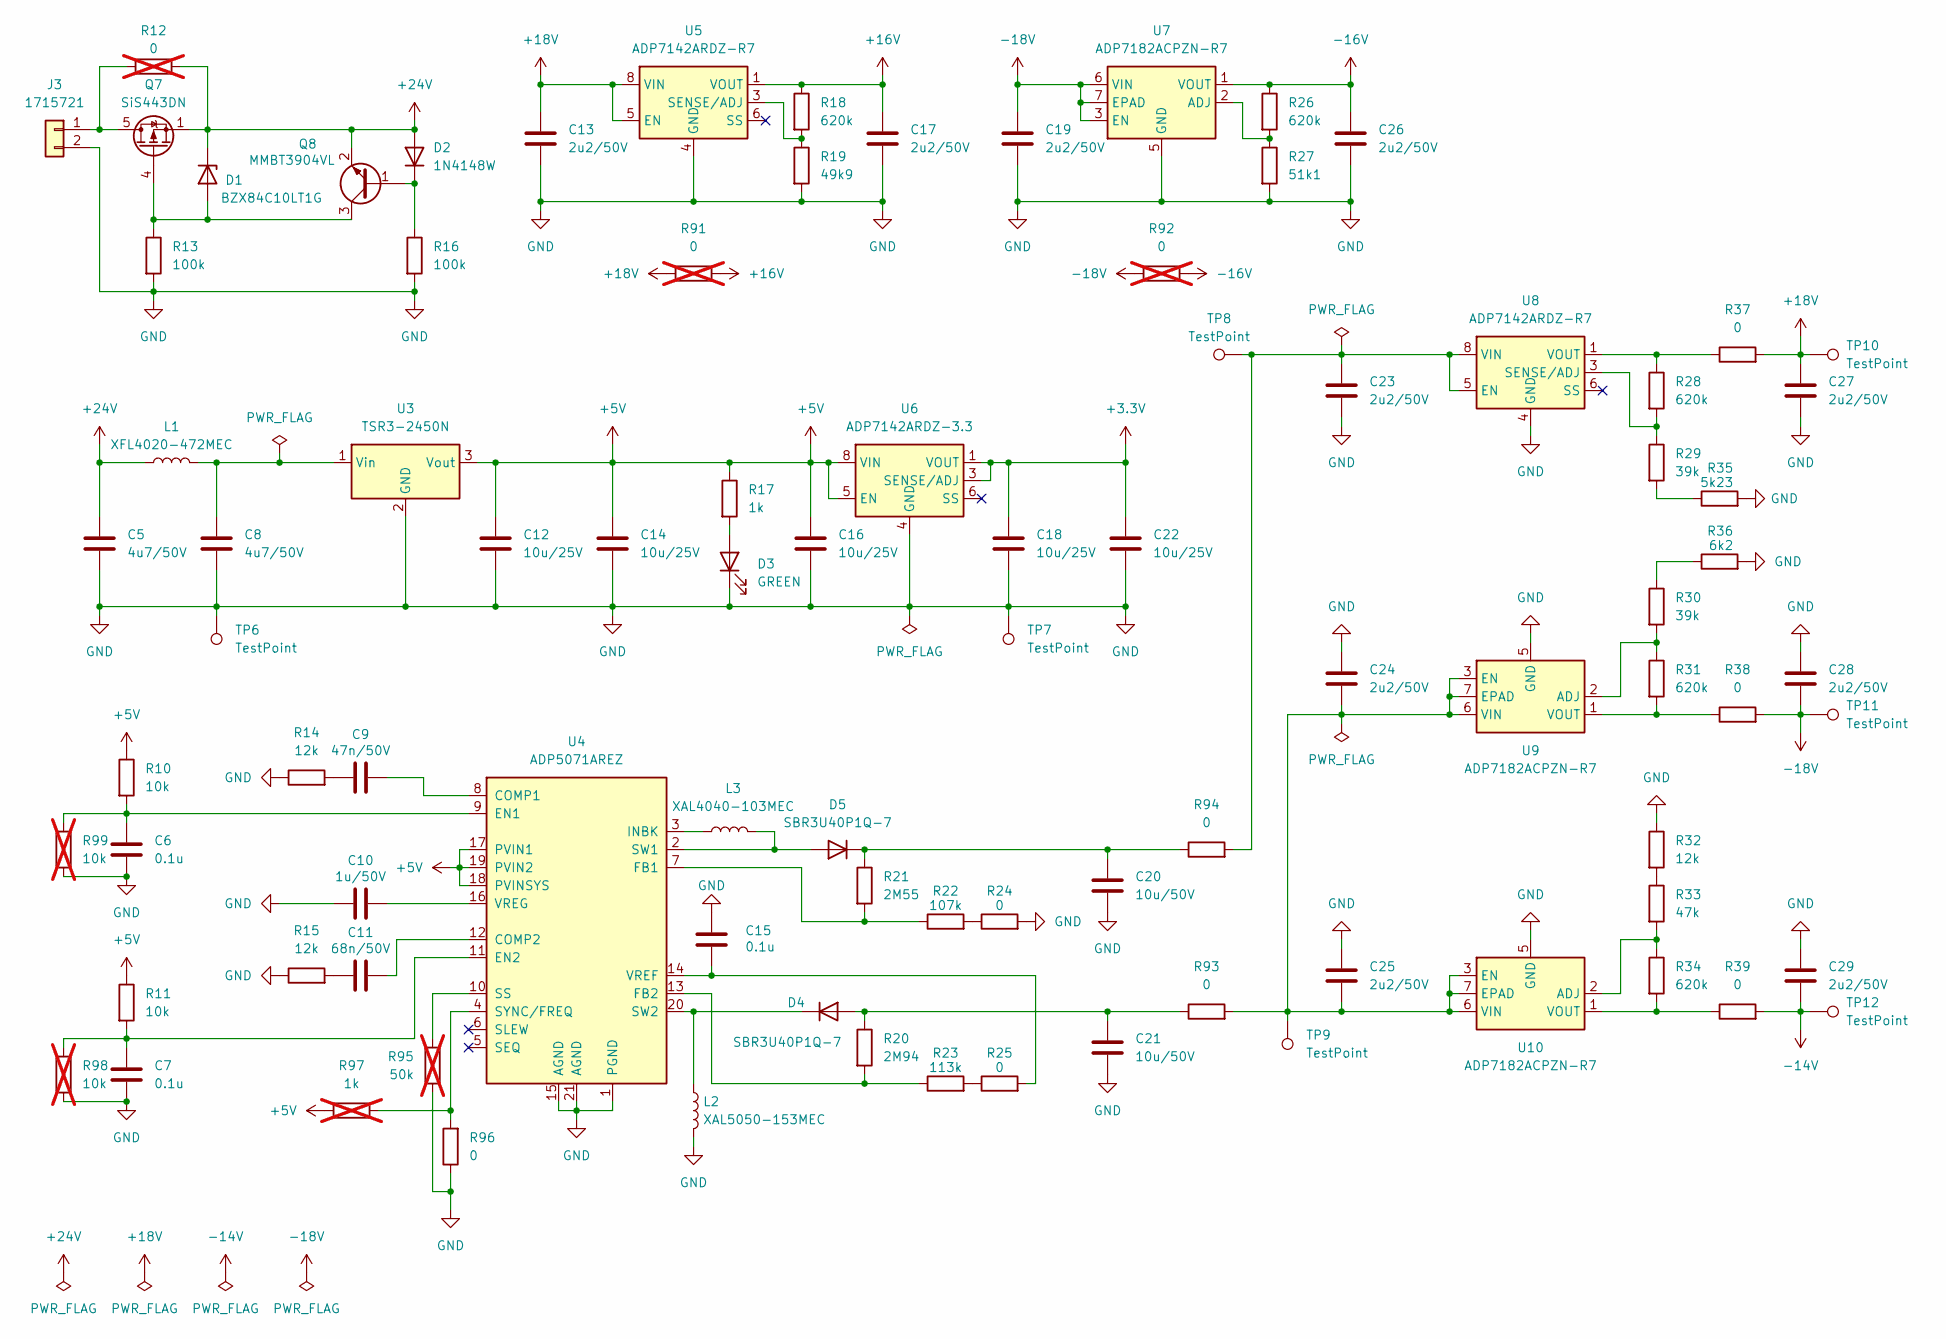
[picture p8: schematic Power.kicad_sch]

Parts:
C5, C8: 4u7/50V; C_0805_2012Metric
C6, C7, C15: 0.1u; C_0603_1608Metric
C9: 47n/50V; C_0603_1608Metric
C10: 1u/50V; C_0603_1608Metric
C11: 68n/50V; C_0603_1608Metric
C12, C14, C16, C18, C22: 10u/25V; C_0805_2012Metric
C13, C17, C19, C23, C24, C25, C26, C27, C28, C29: 2u2/50V; C_1206_3216Metric
C20, C21: 10u/50V; C_1206_3216Metric
D1: BZX84C10LT1G; SOT-23
D2: 1N4148W; D_SOD-123
D3: GREEN; LED_0603_1608Metric_Pad1.05x0.95mm_HandSolder
D4, D5: SBR3U40P1Q-7; D_PowerDI-123
J3: 1715721; TerminalBlock_Phoenix_MKDS-1,5-2-5.08_1x02_P5.08mm_Horizont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
L1: XFL4020-472MEC; L_Coilcraft_XAL4020-XXX
L2: XAL5050-153MEC; L_Coilcraft_XAL5050-XXX
L3: XAL4040-103MEC; L_Coilcraft_XAL4040-XXX
Q7: SiS443DN; Vishay_PowerPAK_1212-8_Single
Q8: MMBT3904VL; SOT-23
R10, R11: 10k; R_0603_1608Metric
R12, R91, R92: 0; R_0603_1608Metric; not fitted
R13, R16: 100k; R_0603_1608Metric
R14, R15, R32: 12k; R_0603_1608Metric
R17: 1k; R_0603_1608Metric
R18, R26, R28, R31, R34: 620k; R_0603_1608Metric
R19: 49k9; R_0603_1608Metric
R20: 2M94; R_0603_1608Metric
R21: 2M55; R_0603_1608Metric
R22: 107k; R_0603_1608Metric
R23: 113k; R_0603_1608Metric
R24, R25, R37, R38, R39, R93, R94, R96: 0; R_0603_1608Metric
R27: 51k1; R_0603_1608Metric
R29, R30: 39k; R_0603_1608Metric
R33: 47k; R_0603_1608Metric
R35: 5k23; R_0603_1608Metric
R36: 6k2; R_0603_1608Metric
R95: 50k; R_0603_1608Metric; not fitted
R97: 1k; R_0603_1608Metric; not fitted
R98, R99: 10k; R_0603_1608Metric; not fitted
TP6, TP7: TestPoint; TestPoint_Keystone_5010-5014_Multipurpose
TP8, TP9, TP10, TP11, TP12: TestPoint; TestPoint_Pad_D2.0mm
U3: TSR3-2450N; Converter_DCDC_TRACO_TSR2-24xxN_TSR2-24xxxN_THT
U4: ADP5071AREZ; ETSSOP-20-1EP_4.4x6.5mm_P0.65mm_EP3x4.2mm
U5, U8: ADP7142ARDZ-R7; SOIC-8-1EP_3.9x4.9mm_P1.27mm_EP2.29x3mm
U6: ADP7142ARDZ-3.3; SOIC-8-1EP_3.9x4.9mm_P1.27mm_EP2.29x3mm
U7, U9, U10: ADP7182ACPZN-R7; LFCSP-6-1EP_2x2mm_P0.65mm_EP1x1.6mm

Connections:
+3.3V: C18.1, C22.1, U6.1 (VOUT), U6.2 (VOUT), U6.3 (SENSE/ADJ); also elsewhere on the board
+5V: C12.1, C14.1, C16.1, R10.1, R11.1, R17.1, R97.2, U3.3 (Vout), U4.17 (PVIN1), U4.18 (PVINSYS), U4.19 (PVIN2), U6.5 (EN), U6.7 (VIN), U6.8 (VIN)
+16V: C17.1, R18.1, R91.2, U5.1 (VOUT), U5.2 (VOUT); also elsewhere on the board
+18V: C13.1, C27.1, R37.2, R91.1, TP10.1, U5.5 (EN), U5.7 (VIN), U5.8 (VIN); also elsewhere on the board
+24V: C5.1, D1.3 (K), D2.2 (A), L1.1, Q7.1 (S), Q7.2 (S), Q7.3 (S), Q8.2 (E), R12.2
-14V: C29.2, R39.2, TP12.1; also elsewhere on the board
-16V: C26.1, R26.1, R92.2, U7.1 (VOUT); also elsewhere on the board
-18V: C19.1, C28.2, R38.2, R92.1, TP11.1, U7.3 (EN), U7.6 (VIN), U7.7 (EPAD); also elsewhere on the board
GND: C5.2, C6.2, C7.2, C8.2, C10.1, C12.2, C13.2, C14.2, C15.2, C16.2, C17.2, C18.2, C19.2, C20.2, C21.2, C22.2, C23.2, C24.1, C25.1, C26.2, C27.2, C28.1, C29.1, D3.1 (K), J3.2, L2.2, R13.2, R14.1, R15.1, R16.2, R19.2, R24.2, R27.2, R32.1, R35.2, R36.2, R95.1, R96.1, R98.2, R99.2, TP6.1, TP7.1, U3.2 (GND), U4.1 (PGND), U4.15 (AGND), U4.21 (AGND), U5.4 (GND), U5.9 (GND), U6.4 (GND), U6.9 (GND), U7.5 (GND), U8.4 (GND), U8.9 (GND), U9.5 (GND), U10.5 (GND); also elsewhere on the board
unnamed: C9.1, R14.2
unnamed: C11.1, R15.2
unnamed: D1.1 (A), Q7.4 (G), Q8.3 (C), R13.1
unnamed: D2.1 (K), Q8.1 (B), R16.1
unnamed: D3.2 (A), R17.2
unnamed: C21.1, D4.2 (A), R20.1, R93.1
unnamed: D4.1 (K), L2.1, U4.20 (SW2)
unnamed: D5.2 (A), L3.2, U4.2 (SW1)
unnamed: C20.1, D5.1 (K), R21.1, R94.1
unnamed: J3.1, Q7.5 (D), R12.1
unnamed: R22.2, R24.1
unnamed: R23.2, R25.1
unnamed: R28.1, R37.1, U8.1 (VOUT), U8.2 (VOUT)
unnamed: R29.2, R35.1
unnamed: R30.1, R36.1
unnamed: R32.2, R33.1
unnamed: C8.1, L1.2, U3.1 (Vin)
unnamed: C9.2, U4.8 (COMP1)
unnamed: C11.2, U4.12 (COMP2)
unnamed: C6.1, R10.2, R99.1, U4.9 (EN1)
unnamed: C7.1, R11.2, R98.1, U4.11 (EN2)
unnamed: R21.2, R22.1, U4.7 (FB1)
unnamed: R20.2, R23.1, U4.13 (FB2)
unnamed: L3.1, U4.3 (INBK)
unnamed: R95.2, U4.10 (SS)
unnamed: R96.2, R97.1, U4.4 (SYNC/FREQ)
unnamed: C15.1, R25.2, U4.14 (VREF)
unnamed: C10.2, U4.16 (VREG)
unnamed: R18.2, R19.1, U5.3 (SENSE/ADJ)
unnamed: R26.2, R27.1, U7.2 (ADJ)
unnamed: C23.1, R94.2, TP8.1, U8.5 (EN), U8.7 (VIN), U8.8 (VIN)
unnamed: R28.2, R29.1, U8.3 (SENSE/ADJ)
unnamed: R30.2, R31.1, U9.2 (ADJ)
unnamed: R31.2, R38.1, U9.1 (VOUT)
unnamed: R33.2, R34.1, U10.2 (ADJ)
unnamed: C24.2, C25.2, R93.2, TP9.1, U9.3 (EN), U9.6 (VIN), U9.7 (EPAD), U10.3 (EN), U10.6 (VIN), U10.7 (EPAD)
unnamed: R34.2, R39.1, U10.1 (VOUT)
