BehrensG/MADC_ARTY/Hardware/MADC_ARTY/MADC_ARTY.kicad_pcb

## KiCad design Hardware/MADC_ARTY/MADC_ARTY.kicad_pcb (continued)

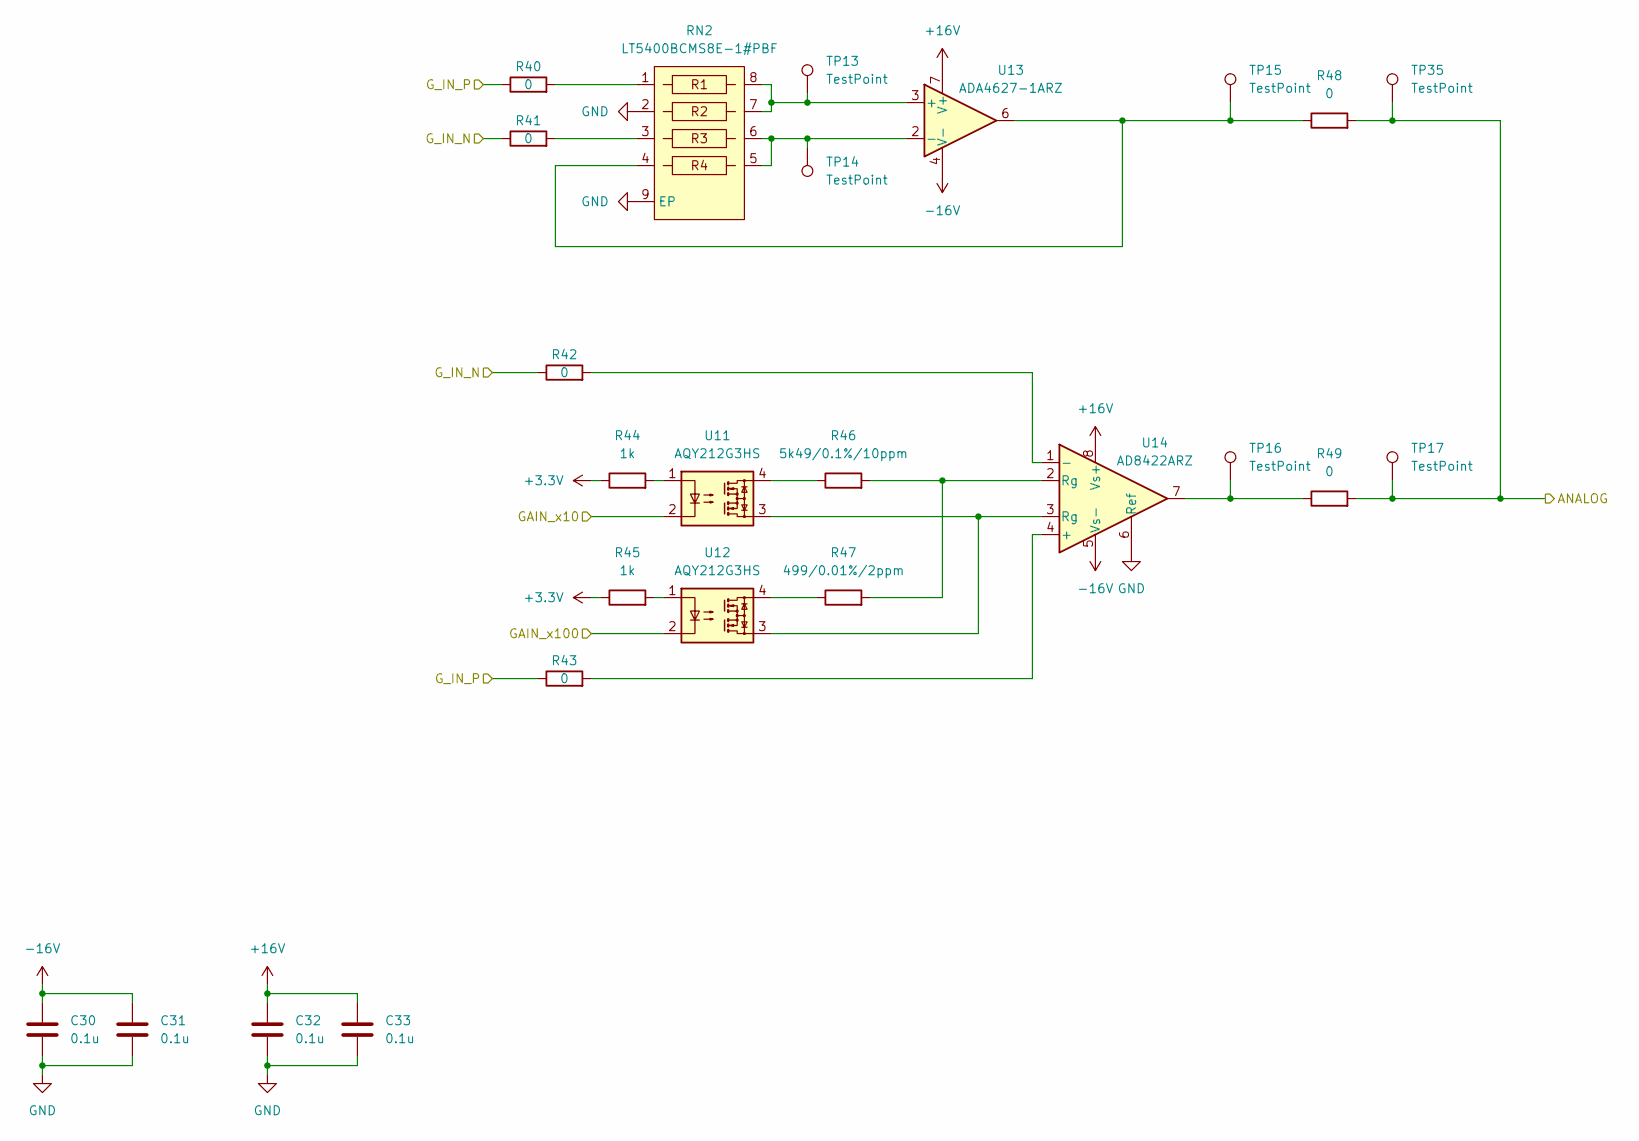
[picture p9: schematic Gain.kicad_sch]

Parts:
C30, C31, C32, C33: 0.1u; C_0603_1608Metric
R40, R41, R42, R43, R48, R49: 0; R_0603_1608Metric
R44, R45: 1k; R_0603_1608Metric
R46: 5k49/0.1%/10ppm; R_0603_1608Metric
R47: 499/0.01%/2ppm; R_0603_1608Metric
RN2: LT5400BCMS8E-1#PBF; MSOP-8-1EP_3x3mm_P0.65mm_EP1.73x1.85mm
TP13, TP14, TP15, TP16, TP17, TP35: TestPoint; TestPoint_Pad_D2.0mm
U11, U12: AQY212G3HS; SO-4_4.4x4.3mm_P2.54mm
U13: ADA4627-1ARZ; SOIC-8_3.9x4.9mm_P1.27mm
U14: AD8422ARZ; SOIC-8_3.9x4.9mm_P1.27mm

Connections:
+3.3V: R44.1, R45.1; also elsewhere on the board
+16V: C32.1, C33.1, U13.7 (V+), U14.8 (Vs+); also elsewhere on the board
-16V: C30.1, C31.1, U13.4 (V-), U14.5 (Vs-); also elsewhere on the board
/Block Diagram/ADC/AD_IN: R48.2, R49.2, TP17.1, TP35.1; also elsewhere on the board
/Block Diagram/Analog Channels1/OUT: R41.1, R42.1; also elsewhere on the board
/Block Diagram/Analog Channels/OUT: R40.1, R43.1; also elsewhere on the board
/Block Diagram/Gain/GAIN_x10: U11.2; also elsewhere on the board
/Block Diagram/Gain/GAIN_x100: U12.2; also elsewhere on the board
GND: C30.2, C31.2, C32.2, C33.2, RN2.2, RN2.9 (EP), U14.6 (Ref); also elsewhere on the board
unnamed: R40.2, RN2.1
unnamed: R41.2, RN2.3
unnamed: R44.2, U11.1
unnamed: R45.2, U12.1
unnamed: R46.1, U11.4
unnamed: R46.2, R47.2, U14.2 (Rg)
unnamed: R47.1, U12.4
unnamed: R48.1, RN2.4, TP15.1, U13.6
unnamed: R49.1, TP16.1, U14.7
unnamed: U11.3, U12.3, U14.3 (Rg)
unnamed: RN2.7, RN2.8, TP13.1, U13.3 (+)
unnamed: RN2.5, RN2.6, TP14.1, U13.2 (-)
unnamed: R43.2, U14.4 (+)
unnamed: R42.2, U14.1 (-)

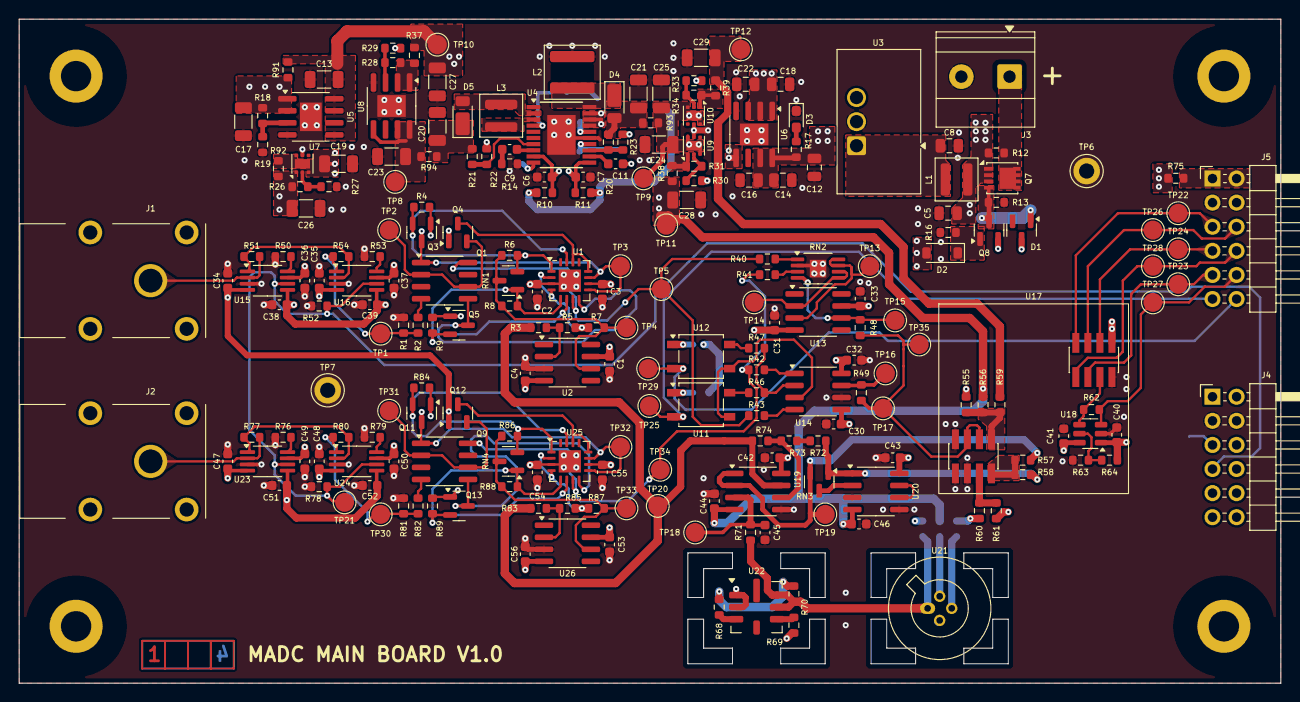
[picture p10: board MADC_ARTY.kicad_pcb from above]

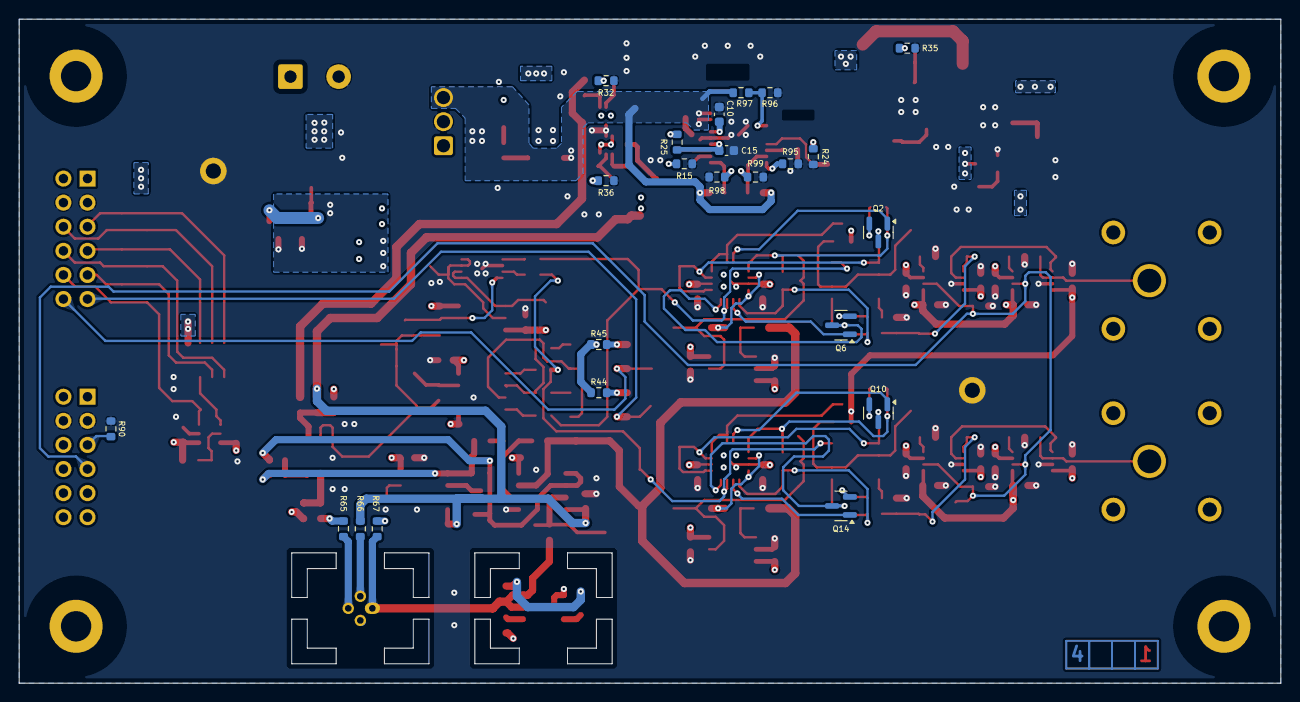
[picture p11: board MADC_ARTY.kicad_pcb from below]

Board: 4 copper layers, 133.0 x 70.0 mm, 251 parts (23 on the bottom side), 130 nets.
