BehrensG/MADC_ARTY/Hardware/NJFET_MATCHING/NJFET_MATCHING.kicad_pcb

## KiCad design Hardware/NJFET_MATCHING/NJFET_MATCHING.kicad_pcb (2025-08-14)

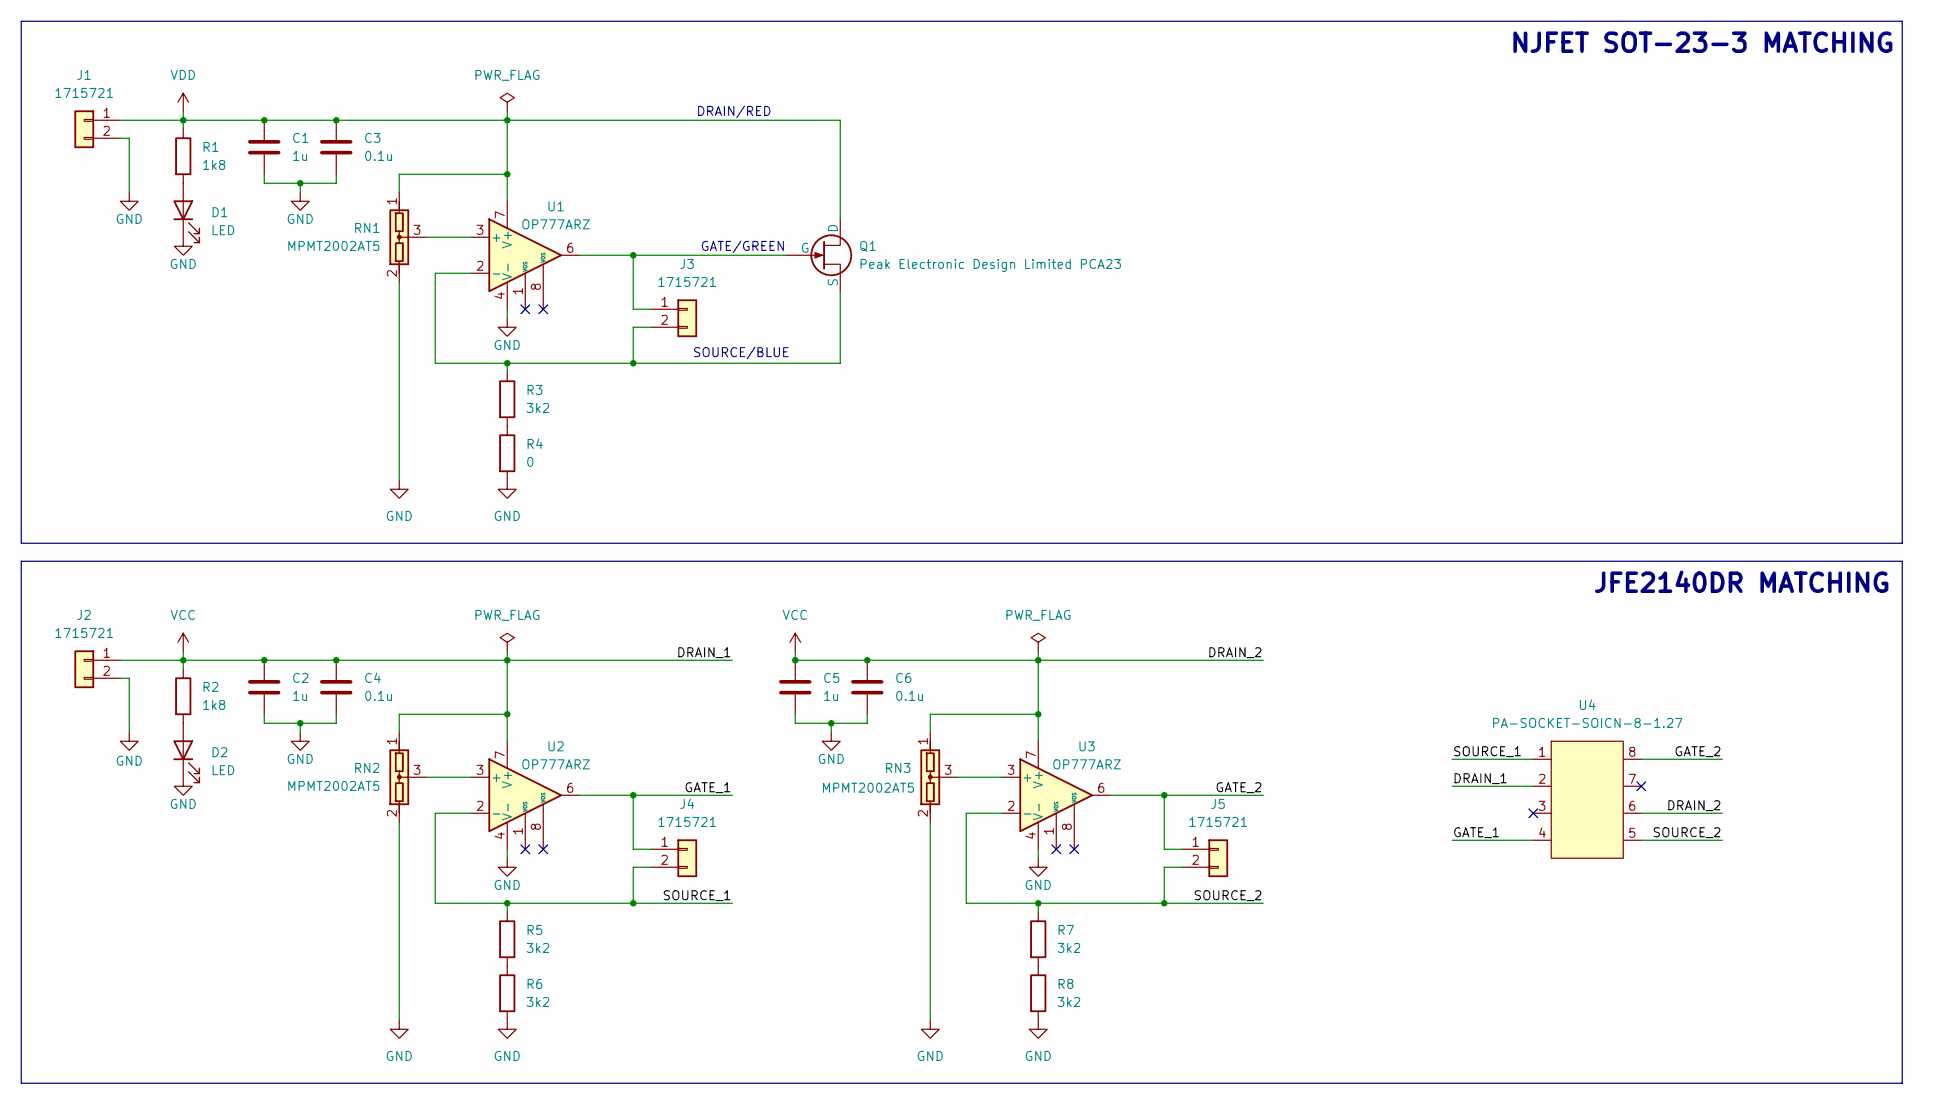
[picture p12: schematic NJFET_MATCHING.kicad_sch]

Parts:
C1, C2, C5: 1u; C_0603_1608Metric
C3, C4, C6: 0.1u; C_0603_1608Metric
D1, D2: LED; LED_0603_1608Metric
J1, J2, J3, J4, J5: 1715721; TerminalBlock_Phoenix_MKDS-1,5-2-5.08_1x02_P5.08mm_Horizont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
Q1: Peak Electronic Design Limited PCA23; PCA23
R1, R2: 1k8; R_0603_1608Metric
R3, R5, R6, R7, R8: 3k2; R_0603_1608Metric
R4: 0; R_0603_1608Metric
RN1, RN2, RN3: MPMT2002AT5; SOT-23
U1, U2, U3: OP777ARZ; SOIC-8_3.9x4.9mm_P1.27mm
U4: PA-SOCKET-SOICN-8-1.27; PA-SOCKET-SOICN-8-1_27

Connections:
/GATE_1: J4.1, U2.6, U4.4
/GATE_2: J5.1, U3.6, U4.8
/SOURCE_1: J4.2, R5.1, U2.2 (-), U4.1
/SOURCE_2: J5.2, R7.1, U3.2 (-), U4.5
GND: C1.2, C2.2, C3.2, C4.2, C5.2, C6.2, D1.1 (K), D2.1 (K), J1.2, J2.2, R4.2, R6.2, R8.2, RN1.2, RN2.2, RN3.2, U1.4 (V-), U2.4 (V-), U3.4 (V-)
unnamed: D1.2 (A), R1.2
unnamed: D2.2 (A), R2.2
unnamed: J3.1, Q1.2 (G), U1.6
unnamed: J3.2, Q1.3 (S), R3.1, U1.2 (-)
unnamed: R3.2, R4.1
unnamed: R5.2, R6.1
unnamed: R7.2, R8.1
unnamed: RN1.3, U1.3 (+)
unnamed: RN2.3, U2.3 (+)
unnamed: RN3.3, U3.3 (+)
VCC: C2.1, C4.1, C5.1, C6.1, J2.1, R2.1, RN2.1, RN3.1, U2.7 (V+), U3.7 (V+), U4.2, U4.6
VDD: C1.1, C3.1, J1.1, Q1.1 (D), R1.1, RN1.1, U1.7 (V+)

Notes on the sheet:
JFE2140DR MATCHING
NJFET SOT-23-3 MATCHING
SOURCE/BLUE
GATE/GREEN
DRAIN/RED

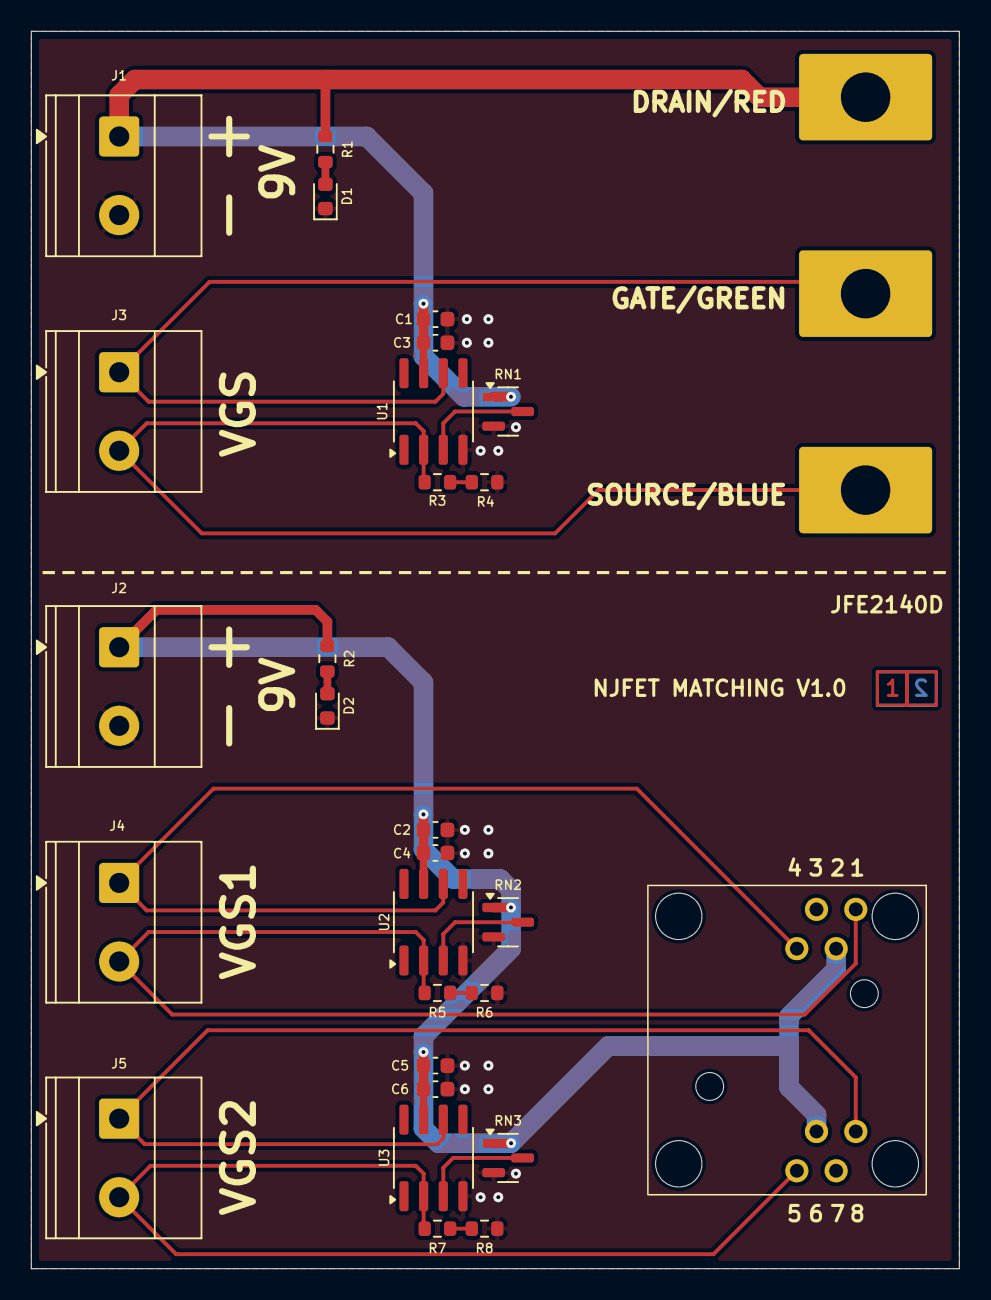
[picture p13: board NJFET_MATCHING.kicad_pcb from above]

Board: 2 copper layers, 60.0 x 80.0 mm, 29 parts (0 on the bottom side), 17 nets.
