BehrensG/MADC_ARTY/Hardware/MADC/MADC.kicad_pcb

## KiCad design Hardware/MADC/MADC.kicad_pcb (2025-08-14)

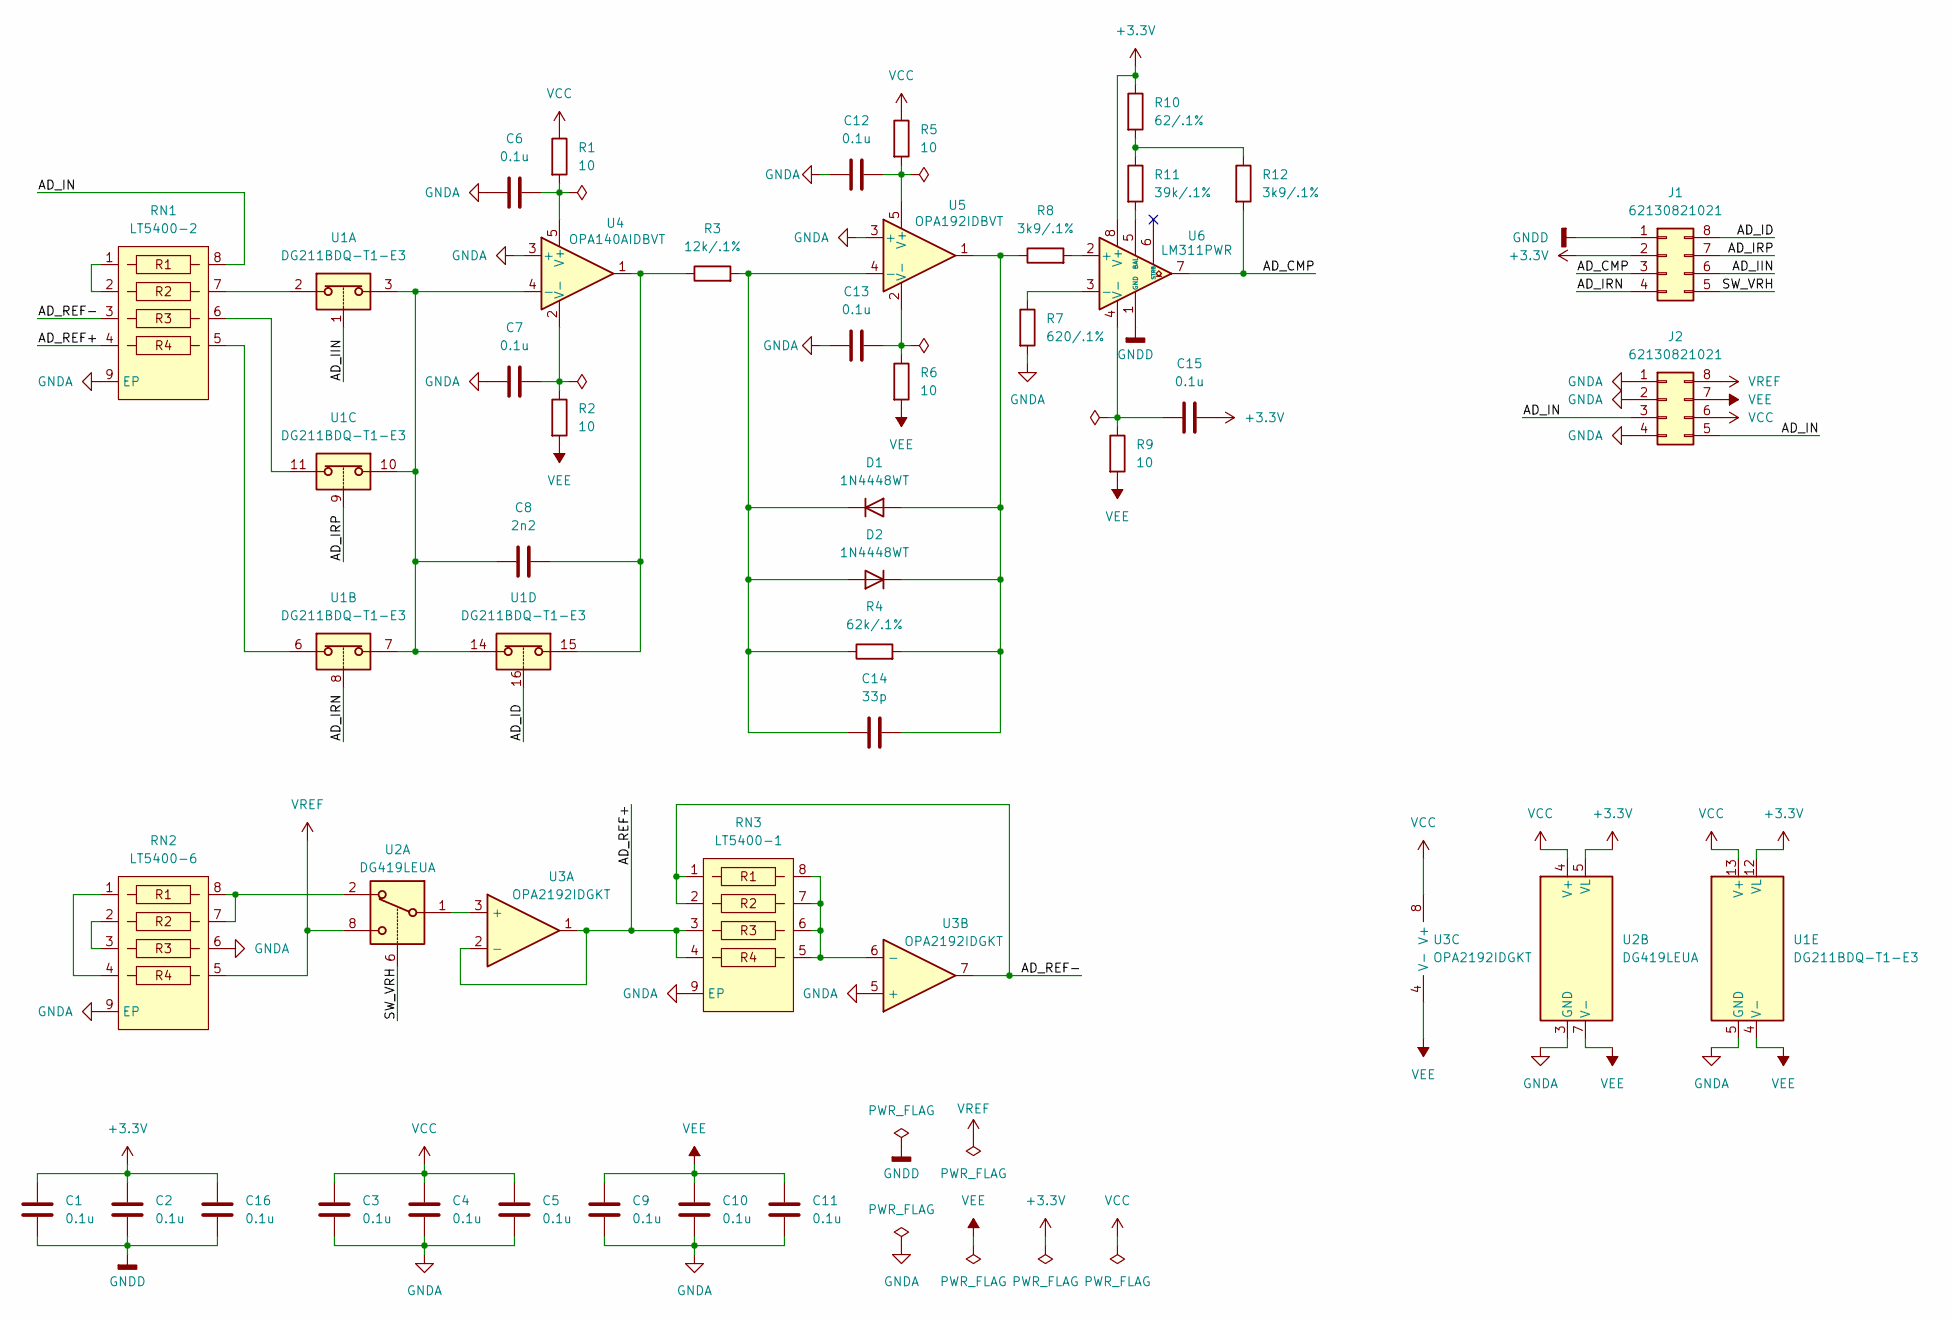
[picture p14: schematic MADC.kicad_sch]

Parts:
C1, C2, C3, C4, C5, C6, C7, C9, C10, C11, C12, C13, C15, C16: 0.1u; C_0402_1005Metric_Pad0.74x0.62mm_HandSolder
C8: 2n2; C_0603_1608Metric
C14: 33p; C_0402_1005Metric_Pad0.74x0.62mm_HandSolder
D1, D2: 1N4448WT; D_SOD-323
J1, J2: 62130821021; PinHeader_2x04_P1.27mm_Vertical_SMD
R1, R2, R5, R6, R9: 10; R_0402_1005Metric_Pad0.72x0.64mm_HandSolder
R3: 12k/.1%; R_0402_1005Metric_Pad0.72x0.64mm_HandSolder
R4: 62k/.1%; R_0402_1005Metric_Pad0.72x0.64mm_HandSolder
R7: 620/.1%; R_0402_1005Metric_Pad0.72x0.64mm_HandSolder
R8, R12: 3k9/.1%; R_0402_1005Metric_Pad0.72x0.64mm_HandSolder
R10: 62/.1%; R_0402_1005Metric_Pad0.72x0.64mm_HandSolder
R11: 39k/.1%; R_0402_1005Metric_Pad0.72x0.64mm_HandSolder
RN1: LT5400-2; MSOP-8-1EP_3x3mm_P0.65mm_EP1.73x1.85mm
RN2: LT5400-6; MSOP-8-1EP_3x3mm_P0.65mm_EP1.73x1.85mm
RN3: LT5400-1; MSOP-8-1EP_3x3mm_P0.65mm_EP1.73x1.85mm
U1: DG211BDQ-T1-E3; TSSOP-16_4.4x5mm_P0.65mm
U2: DG419LEUA; MSOP-8_3x3mm_P0.65mm
U3: OPA2192IDGKT; VSSOP-8_3x3mm_P0.65mm
U4: OPA140AIDBVT; SOT-23-5
U5: OPA192IDBVT; SOT-23-5
U6: LM311PWR; TSSOP-8_4.4x3mm_P0.65mm

Connections:
+3.3V: C1.2, C2.2, C15.2, C16.2, J1.2, R10.1, U1.12 (VL), U2.5 (VL), U6.8 (V+)
/AD_CMP: J1.3, R12.2, U6.7
/AD_ID: J1.8, U1.16
/AD_IIN: J1.6, U1.1
/AD_IN: J2.3, J2.5, RN1.8
/AD_IRN: J1.4, U1.8
/AD_IRP: J1.7, U1.9
/AD_REF+: RN1.4, RN3.3, RN3.4, U3.1, U3.2 (-)
/AD_REF-: RN1.3, RN3.1, RN3.2, U3.7
/SW_VRH: J1.5, U2.6
GNDA: C3.1, C4.1, C5.1, C6.1, C7.1, C9.1, C10.1, C11.1, C12.1, C13.1, J2.1, J2.2, J2.4, R7.2, RN1.9 (EP), RN2.6, RN2.9 (EP), RN3.9 (EP), U1.5 (GND), U2.3 (GND), U3.5 (+), U4.3 (+), U5.3 (+)
GNDD: C1.1, C2.1, C16.1, J1.1, U6.1 (GND)
unnamed: C8.2, R3.1, U1.15, U4.1
unnamed: C14.2, D1.2 (A), D2.1 (K), R4.2, R8.1, U5.1
unnamed: C14.1, D1.1 (K), D2.2 (A), R3.2, R4.1, U5.4 (-)
unnamed: R10.2, R11.1, R12.1
unnamed: RN1.1, RN1.2
unnamed: RN1.5, U1.6
unnamed: RN1.6, U1.11
unnamed: RN1.7, U1.2
unnamed: RN2.1, RN2.4
unnamed: RN2.2, RN2.3
unnamed: RN2.7, RN2.8, U2.2
unnamed: U2.1, U3.3 (+)
unnamed: RN3.5, RN3.6, RN3.7, RN3.8, U3.6 (-)
unnamed: C8.1, U1.3, U1.7, U1.10, U1.14, U4.4 (-)
unnamed: C6.2, R1.2, U4.5 (V+)
unnamed: C7.2, R2.1, U4.2 (V-)
unnamed: C12.2, R5.2, U5.5 (V+)
unnamed: C13.2, R6.1, U5.2 (V-)
unnamed: R8.2, U6.2 (+)
unnamed: R7.1, U6.3 (-)
unnamed: R11.2, U6.5 (BAL)
unnamed: C15.1, R9.1, U6.4 (V-)
VCC: C3.2, C4.2, C5.2, J2.6, R1.1, R5.1, U1.13 (V+), U2.4 (V+), U3.8 (V+)
VEE: C9.2, C10.2, C11.2, J2.7, R2.2, R6.2, R9.2, U1.4 (V-), U2.7 (V-), U3.4 (V-)
VREF: J2.8, RN2.5, U2.8

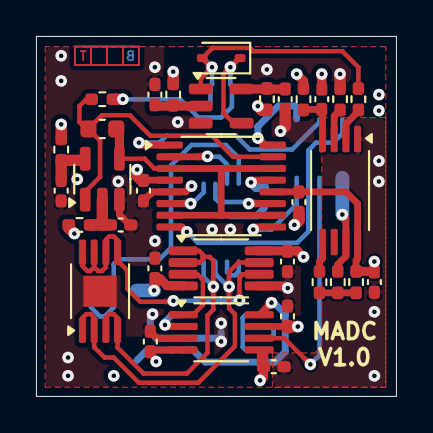
[picture p15: board MADC.kicad_pcb from above]

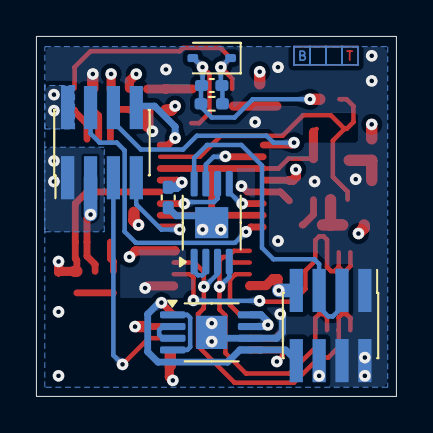
[picture p16: board MADC.kicad_pcb from below]

Board: 4 copper layers, 20.0 x 20.0 mm, 41 parts (8 on the bottom side), 37 nets.
