BehrensG/MADC_ARTY/Software/vivado/MADC_ARTY_Z7/MADC_ARTY_Z7.runs/MADC_ARTY_Z7_processing_system7_0_0_synth_1/.Xil/MADC_ARTY_Z7_processing_system7_0_0_propImpl.xdc

set_property SRC_FILE_INFO {cfile:/home/grzegorz/git/MADC_ARTY/Software/vivado/MADC_ARTY_Z7/MADC_ARTY_Z7.gen/sources_1/bd/MADC_ARTY_Z7/ip/MADC_ARTY_Z7_processing_system7_0_0/MADC_ARTY_Z7_processing_system7_0_0.xdc rfile:../../../MADC_ARTY_Z7.gen/sources_1/bd/MADC_ARTY_Z7/ip/MADC_ARTY_Z7_processing_system7_0_0/MADC_ARTY_Z7_processing_system7_0_0.xdc id:1 order:EARLY scoped_inst:inst} [current_design]
current_instance inst
set_property src_info {type:SCOPED_XDC file:1 line:21 export:INPUT save:INPUT read:READ} [current_design]
set_input_jitter clk_fpga_0 0.3
set_property src_info {type:SCOPED_XDC file:1 line:31 export:INPUT save:INPUT read:READ} [current_design]
set_property PACKAGE_PIN "C11" [get_ports "MIO[53]"]
set_property src_info {type:SCOPED_XDC file:1 line:38 export:INPUT save:INPUT read:READ} [current_design]
set_property PACKAGE_PIN "C10" [get_ports "MIO[52]"]
set_property src_info {type:SCOPED_XDC file:1 line:45 export:INPUT save:INPUT read:READ} [current_design]
set_property PACKAGE_PIN "B9" [get_ports "MIO[51]"]
set_property src_info {type:SCOPED_XDC file:1 line:52 export:INPUT save:INPUT read:READ} [current_design]
set_property PACKAGE_PIN "B13" [get_ports "MIO[50]"]
set_property src_info {type:SCOPED_XDC file:1 line:59 export:INPUT save:INPUT read:READ} [current_design]
set_property PACKAGE_PIN "C12" [get_ports "MIO[49]"]
set_property src_info {type:SCOPED_XDC file:1 line:66 export:INPUT save:INPUT read:READ} [current_design]
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
set_property PACKAGE_PIN "D6" [get_ports "MIO[3]"]
set_property src_info {type:SCOPED_XDC file:1 line:382 export:INPUT save:INPUT read:READ} [current_design]
set_property PACKAGE_PIN "B8" [get_ports "MIO[2]"]
set_property src_info {type:SCOPED_XDC file:1 line:388 export:INPUT save:INPUT read:READ} [current_design]
set_property PACKAGE_PIN "A7" [get_ports "MIO[1]"]
set_property src_info {type:SCOPED_XDC file:1 line:395 export:INPUT save:INPUT read:READ} [current_design]
set_property PACKAGE_PIN "E6" [get_ports "MIO[0]"]
set_property src_info {type:SCOPED_XDC file:1 line:401 export:INPUT save:INPUT read:READ} [current_design]
set_property PACKAGE_PIN "H5" [get_ports "DDR_VRP"]
set_property src_info {type:SCOPED_XDC file:1 line:405 export:INPUT save:INPUT read:READ} [current_design]
set_property PACKAGE_PIN "G5" [get_ports "DDR_VRN"]
set_property src_info {type:SCOPED_XDC file:1 line:409 export:INPUT save:INPUT read:READ} [current_design]
set_property PACKAGE_PIN "M5" [get_ports "DDR_WEB"]
set_property src_info {type:SCOPED_XDC file:1 line:413 export:INPUT save:INPUT read:READ} [current_design]
set_property PACKAGE_PIN "P4" [get_ports "DDR_RAS_n"]
set_property src_info {type:SCOPED_XDC file:1 line:417 export:INPUT save:INPUT read:READ} [current_design]
set_property PACKAGE_PIN "N5" [get_ports "DDR_ODT"]
set_property src_info {type:SCOPED_XDC file:1 line:421 export:INPUT save:INPUT read:READ} [current_design]
set_property PACKAGE_PIN "B4" [get_ports "DDR_DRSTB"]
set_property src_info {type:SCOPED_XDC file:1 line:425 export:INPUT save:INPUT read:READ} [current_design]
set_property PACKAGE_PIN "W5" [get_ports "DDR_DQS[3]"]
set_property src_info {type:SCOPED_XDC file:1 line:430 export:INPUT save:INPUT read:READ} [current_design]
set_property PACKAGE_PIN "R2" [get_ports "DDR_DQS[2]"]
set_property src_info {type:SCOPED_XDC file:1 line:435 export:INPUT save:INPUT read:READ} [current_design]
set_property PACKAGE_PIN "G2" [get_ports "DDR_DQS[1]"]
set_property src_info {type:SCOPED_XDC file:1 line:439 export:INPUT save:INPUT read:READ} [current_design]
set_property PACKAGE_PIN "C2" [get_ports "DDR_DQS[0]"]
set_property src_info {type:SCOPED_XDC file:1 line:443 export:INPUT save:INPUT read:READ} [current_design]
set_property PACKAGE_PIN "W4" [get_ports "DDR_DQS_n[3]"]
set_property src_info {type:SCOPED_XDC file:1 line:448 export:INPUT save:INPUT read:READ} [current_design]
set_property PACKAGE_PIN "T2" [get_ports "DDR_DQS_n[2]"]
set_property src_info {type:SCOPED_XDC file:1 line:453 export:INPUT save:INPUT read:READ} [current_design]
set_property PACKAGE_PIN "F2" [get_ports "DDR_DQS_n[1]"]
set_property src_info {type:SCOPED_XDC file:1 line:457 export:INPUT save:INPUT read:READ} [current_design]
set_property PACKAGE_PIN "B2" [get_ports "DDR_DQS_n[0]"]
set_property src_info {type:SCOPED_XDC file:1 line:461 export:INPUT save:INPUT read:READ} [current_design]
set_property PACKAGE_PIN "E3" [get_ports "DDR_DQ[9]"]
set_property src_info {type:SCOPED_XDC file:1 line:465 export:INPUT save:INPUT read:READ} [current_design]
set_property PACKAGE_PIN "E2" [get_ports "DDR_DQ[8]"]
set_property src_info {type:SCOPED_XDC file:1 line:469 export:INPUT save:INPUT read:READ} [current_design]
set_property PACKAGE_PIN "E1" [get_ports "DDR_DQ[7]"]
set_property src_info {type:SCOPED_XDC file:1 line:473 export:INPUT save:INPUT read:READ} [current_design]
set_property PACKAGE_PIN "C1" [get_ports "DDR_DQ[6]"]
set_property src_info {type:SCOPED_XDC file:1 line:477 export:INPUT save:INPUT read:READ} [current_design]
set_property PACKAGE_PIN "D1" [get_ports "DDR_DQ[5]"]
set_property src_info {type:SCOPED_XDC file:1 line:481 export:INPUT save:INPUT read:READ} [current_design]
set_property PACKAGE_PIN "D3" [get_ports "DDR_DQ[4]"]
set_property src_info {type:SCOPED_XDC file:1 line:485 export:INPUT save:INPUT read:READ} [current_design]
set_property PACKAGE_PIN "A4" [get_ports "DDR_DQ[3]"]
set_property src_info {type:SCOPED_XDC file:1 line:489 export:INPUT save:INPUT read:READ} [current_design]
set_property PACKAGE_PIN "V3" [get_ports "DDR_DQ[31]"]
set_property src_info {type:SCOPED_XDC file:1 line:494 export:INPUT save:INPUT read:READ} [current_design]
set_property PACKAGE_PIN "V2" [get_ports "DDR_DQ[30]"]
set_property src_info {type:SCOPED_XDC file:1 line:499 export:INPUT save:INPUT read:READ} [current_design]
set_property PACKAGE_PIN "A2" [get_ports "DDR_DQ[2]"]
set_property src_info {type:SCOPED_XDC file:1 line:503 export:INPUT save:INPUT read:READ} [current_design]
set_property PACKAGE_PIN "W3" [get_ports "DDR_DQ[29]"]
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
set_property PACKAGE_PIN "D4" [get_ports "DDR_Addr[13]"]
set_property src_info {type:SCOPED_XDC file:1 line:699 export:INPUT save:INPUT read:READ} [current_design]
set_property PACKAGE_PIN "E4" [get_ports "DDR_Addr[12]"]
set_property src_info {type:SCOPED_XDC file:1 line:703 export:INPUT save:INPUT read:READ} [current_design]
set_property PACKAGE_PIN "G4" [get_ports "DDR_Addr[11]"]
set_property src_info {type:SCOPED_XDC file:1 line:707 export:INPUT save:INPUT read:READ} [current_design]
set_property PACKAGE_PIN "F5" [get_ports "DDR_Addr[10]"]
set_property src_info {type:SCOPED_XDC file:1 line:711 export:INPUT save:INPUT read:READ} [current_design]
set_property PACKAGE_PIN "N2" [get_ports "DDR_Addr[0]"]
set_property src_info {type:SCOPED_XDC file:1 line:715 export:INPUT save:INPUT read:READ} [current_design]
set_property PACKAGE_PIN "C7" [get_ports "PS_PORB"]
set_property src_info {type:SCOPED_XDC file:1 line:718 export:INPUT save:INPUT read:READ} [current_design]
set_property PACKAGE_PIN "B10" [get_ports "PS_SRSTB"]
set_property src_info {type:SCOPED_XDC file:1 line:721 export:INPUT save:INPUT read:READ} [current_design]
set_property PACKAGE_PIN "E7" [get_ports "PS_CLK"]
