BehrensG/MADC_ARTY/Software/vivado/MADC_ARTY_Z7/MADC_ARTY_Z7.runs/synth_1/.Xil/MADC_ARTY_Z7_wrapper_propImpl.xdc

set_property SRC_FILE_INFO {cfile:/home/grzegorz/git/MADC_ARTY/Software/vivado/MADC_ARTY_Z7/MADC_ARTY_Z7.srcs/constrs_1/new/madc_constr.xdc rfile:../../../MADC_ARTY_Z7.srcs/constrs_1/new/madc_constr.xdc id:1} [current_design]
set_property src_info {type:XDC file:1 line:10 export:INPUT save:INPUT read:READ} [current_design]
set_property PACKAGE_PIN V18 [get_ports {ctr_4bits_tri_o[0]}]
set_property src_info {type:XDC file:1 line:11 export:INPUT save:INPUT read:READ} [current_design]
set_property PACKAGE_PIN T14 [get_ports {ctr_4bits_tri_o[1]}]
set_property src_info {type:XDC file:1 line:12 export:INPUT save:INPUT read:READ} [current_design]
set_property PACKAGE_PIN U12 [get_ports {ctr_4bits_tri_o[2]}]
set_property src_info {type:XDC file:1 line:13 export:INPUT save:INPUT read:READ} [current_design]
set_property PACKAGE_PIN T16 [get_ports {ctr_4bits_tri_o[3]}]
set_property src_info {type:XDC file:1 line:20 export:INPUT save:INPUT read:READ} [current_design]
set_property PACKAGE_PIN V13 [get_ports sw_vrh]
set_property src_info {type:XDC file:1 line:21 export:INPUT save:INPUT read:READ} [current_design]
set_property PACKAGE_PIN V15 [get_ports ad_cmp]
set_property src_info {type:XDC file:1 line:22 export:INPUT save:INPUT read:READ} [current_design]
set_property PACKAGE_PIN U17 [get_ports ad_id]
set_property src_info {type:XDC file:1 line:23 export:INPUT save:INPUT read:READ} [current_design]
set_property PACKAGE_PIN V17 [get_ports ad_iin]
set_property src_info {type:XDC file:1 line:24 export:INPUT save:INPUT read:READ} [current_design]
set_property PACKAGE_PIN T15 [get_ports ad_irn]
set_property src_info {type:XDC file:1 line:25 export:INPUT save:INPUT read:READ} [current_design]
set_property PACKAGE_PIN R16 [get_ports ad_irp]
