BehrensG/MADC_ARTY/Software/vivado/MADC_ARTY_Z7/MADC_ARTY_Z7.srcs/constrs_1/new/madc_constr.xdc

set_property IOSTANDARD LVCMOS33 [get_ports {ctr_4bits_tri_o[3]}]
set_property IOSTANDARD LVCMOS33 [get_ports {ctr_4bits_tri_o[2]}]
set_property IOSTANDARD LVCMOS33 [get_ports {ctr_4bits_tri_o[1]}]
set_property IOSTANDARD LVCMOS33 [get_ports {ctr_4bits_tri_o[0]}]
set_property OFFCHIP_TERM NONE [get_ports ad_id]
set_property OFFCHIP_TERM NONE [get_ports ad_iin]
set_property OFFCHIP_TERM NONE [get_ports ad_irn]
set_property OFFCHIP_TERM NONE [get_ports ad_irp]
set_property OFFCHIP_TERM NONE [get_ports sw_vrh]
set_property PACKAGE_PIN V18 [get_ports {ctr_4bits_tri_o[0]}]
set_property PACKAGE_PIN T14 [get_ports {ctr_4bits_tri_o[1]}]
set_property PACKAGE_PIN U12 [get_ports {ctr_4bits_tri_o[2]}]
set_property PACKAGE_PIN T16 [get_ports {ctr_4bits_tri_o[3]}]
set_property IOSTANDARD LVCMOS33 [get_ports ad_cmp]
set_property IOSTANDARD LVCMOS33 [get_ports ad_id]
set_property IOSTANDARD LVCMOS33 [get_ports ad_iin]
set_property IOSTANDARD LVCMOS33 [get_ports ad_irn]
set_property IOSTANDARD LVCMOS33 [get_ports ad_irp]
set_property IOSTANDARD LVCMOS33 [get_ports sw_vrh]
set_property PACKAGE_PIN V13 [get_ports sw_vrh]
set_property PACKAGE_PIN V15 [get_ports ad_cmp]
set_property PACKAGE_PIN U17 [get_ports ad_id]
set_property PACKAGE_PIN V17 [get_ports ad_iin]
set_property PACKAGE_PIN T15 [get_ports ad_irn]
set_property PACKAGE_PIN R16 [get_ports ad_irp]
