BehrensG/MADC_ARTY/Software/vivado/MADC_ARTY_Z7/MADC_ARTY_Z7.gen/sources_1/bd/MADC_ARTY_Z7/synth/MADC_ARTY_Z7.vhd

--Copyright 1986-2022 Xilinx, Inc. All Rights Reserved.
--Copyright 2022-2024 Advanced Micro Devices, Inc. All Rights Reserved.
----------------------------------------------------------------------------------
--Tool Version: Vivado v.2024.1 (lin64) Build 5076996 Wed May 22 18:36:09 MDT 2024
--Date        : Wed Oct 14 21:33:25 2026
--Host        : archlinux running 64-bit Arch Linux
--Command     : generate_target MADC_ARTY_Z7.bd
--Design      : MADC_ARTY_Z7
--Purpose     : IP block netlist
----------------------------------------------------------------------------------
library IEEE;
use IEEE.STD_LOGIC_1164.ALL;
library UNISIM;
use UNISIM.VCOMPONENTS.ALL;
entity m00_couplers_imp_RXNZS0 is
  port (
    M_ACLK : in STD_LOGIC;
    M_ARESETN : in STD_LOGIC;
    M_AXI_araddr : out STD_LOGIC_VECTOR ( 31 downto 0 );
    M_AXI_arready : in STD_LOGIC_VECTOR ( 0 to 0 );
    M_AXI_arvalid : out STD_LOGIC_VECTOR ( 0 to 0 );
    M_AXI_awaddr : out STD_LOGIC_VECTOR ( 31 downto 0 );
    M_AXI_awready : in STD_LOGIC_VECTOR ( 0 to 0 );
    M_AXI_awvalid : out STD_LOGIC_VECTOR ( 0 to 0 );
    M_AXI_bready : out STD_LOGIC_VECTOR ( 0 to 0 );
    M_AXI_bresp : in STD_LOGIC_VECTOR ( 1 downto 0 );
    M_AXI_bvalid : in STD_LOGIC_VECTOR ( 0 to 0 );
    M_AXI_rdata : in STD_LOGIC_VECTOR ( 31 downto 0 );
    M_AXI_rready : out STD_LOGIC_VECTOR ( 0 to 0 );
    M_AXI_rresp : in STD_LOGIC_VECTOR ( 1 downto 0 );
    M_AXI_rvalid : in STD_LOGIC_VECTOR ( 0 to 0 );
    M_AXI_wdata : out STD_LOGIC_VECTOR ( 31 downto 0 );
    M_AXI_wready : in STD_LOGIC_VECTOR ( 0 to 0 );
    M_AXI_wstrb : out STD_LOGIC_VECTOR ( 3 downto 0 );
    M_AXI_wvalid : out STD_LOGIC_VECTOR ( 0 to 0 );
    S_ACLK : in STD_LOGIC;
    S_ARESETN : in STD_LOGIC;
    S_AXI_araddr : in STD_LOGIC_VECTOR ( 31 downto 0 );
    S_AXI_arready : out STD_LOGIC_VECTOR ( 0 to 0 );
    S_AXI_arvalid : in STD_LOGIC_VECTOR ( 0 to 0 );
    S_AXI_awaddr : in STD_LOGIC_VECTOR ( 31 downto 0 );
    S_AXI_awready : out STD_LOGIC_VECTOR ( 0 to 0 );
    S_AXI_awvalid : in STD_LOGIC_VECTOR ( 0 to 0 );
    S_AXI_bready : in STD_LOGIC_VECTOR ( 0 to 0 );
    S_AXI_bresp : out STD_LOGIC_VECTOR ( 1 downto 0 );
    S_AXI_bvalid : out STD_LOGIC_VECTOR ( 0 to 0 );
    S_AXI_rdata : out STD_LOGIC_VECTOR ( 31 downto 0 );
    S_AXI_rready : in STD_LOGIC_VECTOR ( 0 to 0 );
    S_AXI_rresp : out STD_LOGIC_VECTOR ( 1 downto 0 );
    S_AXI_rvalid : out STD_LOGIC_VECTOR ( 0 to 0 );
    S_AXI_wdata : in STD_LOGIC_VECTOR ( 31 downto 0 );
    S_AXI_wready : out STD_LOGIC_VECTOR ( 0 to 0 );
    S_AXI_wstrb : in STD_LOGIC_VECTOR ( 3 downto 0 );
    S_AXI_wvalid : in STD_LOGIC_VECTOR ( 0 to 0 )
  );
end m00_couplers_imp_RXNZS0;

architecture STRUCTURE of m00_couplers_imp_RXNZS0 is
  signal m00_couplers_to_m00_couplers_ARADDR : STD_LOGIC_VECTOR ( 31 downto 0 );
  signal m00_couplers_to_m00_couplers_ARREADY : STD_LOGIC_VECTOR ( 0 to 0 );
  signal m00_couplers_to_m00_couplers_ARVALID : STD_LOGIC_VECTOR ( 0 to 0 );
  signal m00_couplers_to_m00_couplers_AWADDR : STD_LOGIC_VECTOR ( 31 downto 0 );
  signal m00_couplers_to_m00_couplers_AWREADY : STD_LOGIC_VECTOR ( 0 to 0 );
  signal m00_couplers_to_m00_couplers_AWVALID : STD_LOGIC_VECTOR ( 0 to 0 );
  signal m00_couplers_to_m00_couplers_BREADY : STD_LOGIC_VECTOR ( 0 to 0 );
  signal m00_couplers_to_m00_couplers_BRESP : STD_LOGIC_VECTOR ( 1 downto 0 );
  signal m00_couplers_to_m00_couplers_BVALID : STD_LOGIC_VECTOR ( 0 to 0 );
  signal m00_couplers_to_m00_couplers_RDATA : STD_LOGIC_VECTOR ( 31 downto 0 );
  signal m00_couplers_to_m00_couplers_RREADY : STD_LOGIC_VECTOR ( 0 to 0 );
  signal m00_couplers_to_m00_couplers_RRESP : STD_LOGIC_VECTOR ( 1 downto 0 );
  signal m00_couplers_to_m00_couplers_RVALID : STD_LOGIC_VECTOR ( 0 to 0 );
  signal m00_couplers_to_m00_couplers_WDATA : STD_LOGIC_VECTOR ( 31 downto 0 );
  signal m00_couplers_to_m00_couplers_WREADY : STD_LOGIC_VECTOR ( 0 to 0 );
  signal m00_couplers_to_m00_couplers_WSTRB : STD_LOGIC_VECTOR ( 3 downto 0 );
  signal m00_couplers_to_m00_couplers_WVALID : STD_LOGIC_VECTOR ( 0 to 0 );
begin
  M_AXI_araddr(31 downto 0) <= m00_couplers_to_m00_couplers_ARADDR(31 downto 0);
  M_AXI_arvalid(0) <= m00_couplers_to_m00_couplers_ARVALID(0);
  M_AXI_awaddr(31 downto 0) <= m00_couplers_to_m00_couplers_AWADDR(31 downto 0);
  M_AXI_awvalid(0) <= m00_couplers_to_m00_couplers_AWVALID(0);
  M_AXI_bready(0) <= m00_couplers_to_m00_couplers_BREADY(0);
  M_AXI_rready(0) <= m00_couplers_to_m00_couplers_RREADY(0);
  M_AXI_wdata(31 downto 0) <= m00_couplers_to_m00_couplers_WDATA(31 downto 0);
  M_AXI_wstrb(3 downto 0) <= m00_couplers_to_m00_couplers_WSTRB(3 downto 0);
  M_AXI_wvalid(0) <= m00_couplers_to_m00_couplers_WVALID(0);
  S_AXI_arready(0) <= m00_couplers_to_m00_couplers_ARREADY(0);
  S_AXI_awready(0) <= m00_couplers_to_m00_couplers_AWREADY(0);
  S_AXI_bresp(1 downto 0) <= m00_couplers_to_m00_couplers_BRESP(1 downto 0);
  S_AXI_bvalid(0) <= m00_couplers_to_m00_couplers_BVALID(0);
  S_AXI_rdata(31 downto 0) <= m00_couplers_to_m00_couplers_RDATA(31 downto 0);
  S_AXI_rresp(1 downto 0) <= m00_couplers_to_m00_couplers_RRESP(1 downto 0);
  S_AXI_rvalid(0) <= m00_couplers_to_m00_couplers_RVALID(0);
  S_AXI_wready(0) <= m00_couplers_to_m00_couplers_WREADY(0);
  m00_couplers_to_m00_couplers_ARADDR(31 downto 0) <= S_AXI_araddr(31 downto 0);
  m00_couplers_to_m00_couplers_ARREADY(0) <= M_AXI_arready(0);
  m00_couplers_to_m00_couplers_ARVALID(0) <= S_AXI_arvalid(0);
  m00_couplers_to_m00_couplers_AWADDR(31 downto 0) <= S_AXI_awaddr(31 downto 0);
  m00_couplers_to_m00_couplers_AWREADY(0) <= M_AXI_awready(0);
  m00_couplers_to_m00_couplers_AWVALID(0) <= S_AXI_awvalid(0);
  m00_couplers_to_m00_couplers_BREADY(0) <= S_AXI_bready(0);
  m00_couplers_to_m00_couplers_BRESP(1 downto 0) <= M_AXI_bresp(1 downto 0);
  m00_couplers_to_m00_couplers_BVALID(0) <= M_AXI_bvalid(0);
  m00_couplers_to_m00_couplers_RDATA(31 downto 0) <= M_AXI_rdata(31 downto 0);
  m00_couplers_to_m00_couplers_RREADY(0) <= S_AXI_rready(0);
  m00_couplers_to_m00_couplers_RRESP(1 downto 0) <= M_AXI_rresp(1 downto 0);
  m00_couplers_to_m00_couplers_RVALID(0) <= M_AXI_rvalid(0);
  m00_couplers_to_m00_couplers_WDATA(31 downto 0) <= S_AXI_wdata(31 downto 0);
  m00_couplers_to_m00_couplers_WREADY(0) <= M_AXI_wready(0);
  m00_couplers_to_m00_couplers_WSTRB(3 downto 0) <= S_AXI_wstrb(3 downto 0);
  m00_couplers_to_m00_couplers_WVALID(0) <= S_AXI_wvalid(0);
end STRUCTURE;
library IEEE;
use IEEE.STD_LOGIC_1164.ALL;
library UNISIM;
use UNISIM.VCOMPONENTS.ALL;
entity m01_couplers_imp_W1XWRK is
  port (
    M_ACLK : in STD_LOGIC;
    M_ARESETN : in STD_LOGIC;
    M_AXI_araddr : out STD_LOGIC_VECTOR ( 31 downto 0 );
    M_AXI_arprot : out STD_LOGIC_VECTOR ( 2 downto 0 );
    M_AXI_arready : in STD_LOGIC;
    M_AXI_arvalid : out STD_LOGIC;
    M_AXI_awaddr : out STD_LOGIC_VECTOR ( 31 downto 0 );
    M_AXI_awprot : out STD_LOGIC_VECTOR ( 2 downto 0 );
    M_AXI_awready : in STD_LOGIC;
    M_AXI_awvalid : out STD_LOGIC;
    M_AXI_bready : out STD_LOGIC;
    M_AXI_bresp : in STD_LOGIC_VECTOR ( 1 downto 0 );
    M_AXI_bvalid : in STD_LOGIC;
    M_AXI_rdata : in STD_LOGIC_VECTOR ( 31 downto 0 );
    M_AXI_rready : out STD_LOGIC;
    M_AXI_rresp : in STD_LOGIC_VECTOR ( 1 downto 0 );
    M_AXI_rvalid : in STD_LOGIC;
    M_AXI_wdata : out STD_LOGIC_VECTOR ( 31 downto 0 );
    M_AXI_wready : in STD_LOGIC;
    M_AXI_wstrb : out STD_LOGIC_VECTOR ( 3 downto 0 );
    M_AXI_wvalid : out STD_LOGIC;
    S_ACLK : in STD_LOGIC;
    S_ARESETN : in STD_LOGIC;
    S_AXI_araddr : in STD_LOGIC_VECTOR ( 31 downto 0 );
    S_AXI_arprot : in STD_LOGIC_VECTOR ( 2 downto 0 );
    S_AXI_arready : out STD_LOGIC;
    S_AXI_arvalid : in STD_LOGIC;
    S_AXI_awaddr : in STD_LOGIC_VECTOR ( 31 downto 0 );
    S_AXI_awprot : in STD_LOGIC_VECTOR ( 2 downto 0 );
    S_AXI_awready : out STD_LOGIC;
    S_AXI_awvalid : in STD_LOGIC;
    S_AXI_bready : in STD_LOGIC;
    S_AXI_bresp : out STD_LOGIC_VECTOR ( 1 downto 0 );
    S_AXI_bvalid : out STD_LOGIC;
    S_AXI_rdata : out STD_LOGIC_VECTOR ( 31 downto 0 );
    S_AXI_rready : in STD_LOGIC;
    S_AXI_rresp : out STD_LOGIC_VECTOR ( 1 downto 0 );
    S_AXI_rvalid : out STD_LOGIC;
    S_AXI_wdata : in STD_LOGIC_VECTOR ( 31 downto 0 );
    S_AXI_wready : out STD_LOGIC;
    S_AXI_wstrb : in STD_LOGIC_VECTOR ( 3 downto 0 );
    S_AXI_wvalid : in STD_LOGIC
  );
end m01_couplers_imp_W1XWRK;

architecture STRUCTURE of m01_couplers_imp_W1XWRK is
  signal m01_couplers_to_m01_couplers_ARADDR : STD_LOGIC_VECTOR ( 31 downto 0 );
  signal m01_couplers_to_m01_couplers_ARPROT : STD_LOGIC_VECTOR ( 2 downto 0 );
  signal m01_couplers_to_m01_couplers_ARREADY : STD_LOGIC;
  signal m01_couplers_to_m01_couplers_ARVALID : STD_LOGIC;
  signal m01_couplers_to_m01_couplers_AWADDR : STD_LOGIC_VECTOR ( 31 downto 0 );
  signal m01_couplers_to_m01_couplers_AWPROT : STD_LOGIC_VECTOR ( 2 downto 0 );
  signal m01_couplers_to_m01_couplers_AWREADY : STD_LOGIC;
  signal m01_couplers_to_m01_couplers_AWVALID : STD_LOGIC;
  signal m01_couplers_to_m01_couplers_BREADY : STD_LOGIC;
  signal m01_couplers_to_m01_couplers_BRESP : STD_LOGIC_VECTOR ( 1 downto 0 );
  signal m01_couplers_to_m01_couplers_BVALID : STD_LOGIC;
  signal m01_couplers_to_m01_couplers_RDATA : STD_LOGIC_VECTOR ( 31 downto 0 );
  signal m01_couplers_to_m01_couplers_RREADY : STD_LOGIC;
  signal m01_couplers_to_m01_couplers_RRESP : STD_LOGIC_VECTOR ( 1 downto 0 );
  signal m01_couplers_to_m01_couplers_RVALID : STD_LOGIC;
  signal m01_couplers_to_m01_couplers_WDATA : STD_LOGIC_VECTOR ( 31 downto 0 );
  signal m01_couplers_to_m01_couplers_WREADY : STD_LOGIC;
  signal m01_couplers_to_m01_couplers_WSTRB : STD_LOGIC_VECTOR ( 3 downto 0 );
  signal m01_couplers_to_m01_couplers_WVALID : STD_LOGIC;
begin
  M_AXI_araddr(31 downto 0) <= m01_couplers_to_m01_couplers_ARADDR(31 downto 0);
  M_AXI_arprot(2 downto 0) <= m01_couplers_to_m01_couplers_ARPROT(2 downto 0);
  M_AXI_arvalid <= m01_couplers_to_m01_couplers_ARVALID;
  M_AXI_awaddr(31 downto 0) <= m01_couplers_to_m01_couplers_AWADDR(31 downto 0);
  M_AXI_awprot(2 downto 0) <= m01_couplers_to_m01_couplers_AWPROT(2 downto 0);
  M_AXI_awvalid <= m01_couplers_to_m01_couplers_AWVALID;
  M_AXI_bready <= m01_couplers_to_m01_couplers_BREADY;
  M_AXI_rready <= m01_couplers_to_m01_couplers_RREADY;
  M_AXI_wdata(31 downto 0) <= m01_couplers_to_m01_couplers_WDATA(31 downto 0);
  M_AXI_wstrb(3 downto 0) <= m01_couplers_to_m01_couplers_WSTRB(3 downto 0);
  M_AXI_wvalid <= m01_couplers_to_m01_couplers_WVALID;
  S_AXI_arready <= m01_couplers_to_m01_couplers_ARREADY;
  S_AXI_awready <= m01_couplers_to_m01_couplers_AWREADY;
  S_AXI_bresp(1 downto 0) <= m01_couplers_to_m01_couplers_BRESP(1 downto 0);
  S_AXI_bvalid <= m01_couplers_to_m01_couplers_BVALID;
  S_AXI_rdata(31 downto 0) <= m01_couplers_to_m01_couplers_RDATA(31 downto 0);
  S_AXI_rresp(1 downto 0) <= m01_couplers_to_m01_couplers_RRESP(1 downto 0);
  S_AXI_rvalid <= m01_couplers_to_m01_couplers_RVALID;
  S_AXI_wready <= m01_couplers_to_m01_couplers_WREADY;
  m01_couplers_to_m01_couplers_ARADDR(31 downto 0) <= S_AXI_araddr(31 downto 0);
  m01_couplers_to_m01_couplers_ARPROT(2 downto 0) <= S_AXI_arprot(2 downto 0);
  m01_couplers_to_m01_couplers_ARREADY <= M_AXI_arready;
  m01_couplers_to_m01_couplers_ARVALID <= S_AXI_arvalid;
  m01_couplers_to_m01_couplers_AWADDR(31 downto 0) <= S_AXI_awaddr(31 downto 0);
  m01_couplers_to_m01_couplers_AWPROT(2 downto 0) <= S_AXI_awprot(2 downto 0);
  m01_couplers_to_m01_couplers_AWREADY <= M_AXI_awready;
  m01_couplers_to_m01_couplers_AWVALID <= S_AXI_awvalid;
  m01_couplers_to_m01_couplers_BREADY <= S_AXI_bready;
  m01_couplers_to_m01_couplers_BRESP(1 downto 0) <= M_AXI_bresp(1 downto 0);
  m01_couplers_to_m01_couplers_BVALID <= M_AXI_bvalid;
  m01_couplers_to_m01_couplers_RDATA(31 downto 0) <= M_AXI_rdata(31 downto 0);
  m01_couplers_to_m01_couplers_RREADY <= S_AXI_rready;
  m01_couplers_to_m01_couplers_RRESP(1 downto 0) <= M_AXI_rresp(1 downto 0);
  m01_couplers_to_m01_couplers_RVALID <= M_AXI_rvalid;
  m01_couplers_to_m01_couplers_WDATA(31 downto 0) <= S_AXI_wdata(31 downto 0);
  m01_couplers_to_m01_couplers_WREADY <= M_AXI_wready;
  m01_couplers_to_m01_couplers_WSTRB(3 downto 0) <= S_AXI_wstrb(3 downto 0);
  m01_couplers_to_m01_couplers_WVALID <= S_AXI_wvalid;
end STRUCTURE;
library IEEE;
use IEEE.STD_LOGIC_1164.ALL;
library UNISIM;
use UNISIM.VCOMPONENTS.ALL;
entity s00_couplers_imp_XU79YR is
  port (
    M_ACLK : in STD_LOGIC;
    M_ARESETN : in STD_LOGIC;
    M_AXI_araddr : out STD_LOGIC_VECTOR ( 31 downto 0 );
    M_AXI_arprot : out STD_LOGIC_VECTOR ( 2 downto 0 );
    M_AXI_arready : in STD_LOGIC;
    M_AXI_arvalid : out STD_LOGIC;
    M_AXI_awaddr : out STD_LOGIC_VECTOR ( 31 downto 0 );
    M_AXI_awprot : out STD_LOGIC_VECTOR ( 2 downto 0 );
    M_AXI_awready : in STD_LOGIC;
    M_AXI_awvalid : out STD_LOGIC;
    M_AXI_bready : out STD_LOGIC;
    M_AXI_bresp : in STD_LOGIC_VECTOR ( 1 downto 0 );
    M_AXI_bvalid : in STD_LOGIC;
    M_AXI_rdata : in STD_LOGIC_VECTOR ( 31 downto 0 );
    M_AXI_rready : out STD_LOGIC;
    M_AXI_rresp : in STD_LOGIC_VECTOR ( 1 downto 0 );
    M_AXI_rvalid : in STD_LOGIC;
    M_AXI_wdata : out STD_LOGIC_VECTOR ( 31 downto 0 );
    M_AXI_wready : in STD_LOGIC;
    M_AXI_wstrb : out STD_LOGIC_VECTOR ( 3 downto 0 );
    M_AXI_wvalid : out STD_LOGIC;
    S_ACLK : in STD_LOGIC;
    S_ARESETN : in STD_LOGIC;
    S_AXI_araddr : in STD_LOGIC_VECTOR ( 31 downto 0 );
    S_AXI_arburst : in STD_LOGIC_VECTOR ( 1 downto 0 );
    S_AXI_arcache : in STD_LOGIC_VECTOR ( 3 downto 0 );
    S_AXI_arid : in STD_LOGIC_VECTOR ( 11 downto 0 );
    S_AXI_arlen : in STD_LOGIC_VECTOR ( 3 downto 0 );
    S_AXI_arlock : in STD_LOGIC_VECTOR ( 1 downto 0 );
    S_AXI_arprot : in STD_LOGIC_VECTOR ( 2 downto 0 );
    S_AXI_arqos : in STD_LOGIC_VECTOR ( 3 downto 0 );
    S_AXI_arready : out STD_LOGIC;
    S_AXI_arsize : in STD_LOGIC_VECTOR ( 2 downto 0 );
    S_AXI_arvalid : in STD_LOGIC;
    S_AXI_awaddr : in STD_LOGIC_VECTOR ( 31 downto 0 );
    S_AXI_awburst : in STD_LOGIC_VECTOR ( 1 downto 0 );
    S_AXI_awcache : in STD_LOGIC_VECTOR ( 3 downto 0 );
    S_AXI_awid : in STD_LOGIC_VECTOR ( 11 downto 0 );
    S_AXI_awlen : in STD_LOGIC_VECTOR ( 3 downto 0 );
    S_AXI_awlock : in STD_LOGIC_VECTOR ( 1 downto 0 );
    S_AXI_awprot : in STD_LOGIC_VECTOR ( 2 downto 0 );
    S_AXI_awqos : in STD_LOGIC_VECTOR ( 3 downto 0 );
    S_AXI_awready : out STD_LOGIC;
    S_AXI_awsize : in STD_LOGIC_VECTOR ( 2 downto 0 );
    S_AXI_awvalid : in STD_LOGIC;
    S_AXI_bid : out STD_LOGIC_VECTOR ( 11 downto 0 );
    S_AXI_bready : in STD_LOGIC;
    S_AXI_bresp : out STD_LOGIC_VECTOR ( 1 downto 0 );
    S_AXI_bvalid : out STD_LOGIC;
    S_AXI_rdata : out STD_LOGIC_VECTOR ( 31 downto 0 );
    S_AXI_rid : out STD_LOGIC_VECTOR ( 11 downto 0 );
    S_AXI_rlast : out STD_LOGIC;
    S_AXI_rready : in STD_LOGIC;
    S_AXI_rresp : out STD_LOGIC_VECTOR ( 1 downto 0 );
    S_AXI_rvalid : out STD_LOGIC;
    S_AXI_wdata : in STD_LOGIC_VECTOR ( 31 downto 0 );
    S_AXI_wid : in STD_LOGIC_VECTOR ( 11 downto 0 );
    S_AXI_wlast : in STD_LOGIC;
    S_AXI_wready : out STD_LOGIC;
    S_AXI_wstrb : in STD_LOGIC_VECTOR ( 3 downto 0 );
    S_AXI_wvalid : in STD_LOGIC
  );
end s00_couplers_imp_XU79YR;

architecture STRUCTURE of s00_couplers_imp_XU79YR is
  component MADC_ARTY_Z7_auto_pc_0 is
  port (
    aclk : in STD_LOGIC;
    aresetn : in STD_LOGIC;
    s_axi_awid : in STD_LOGIC_VECTOR ( 11 downto 0 );
    s_axi_awaddr : in STD_LOGIC_VECTOR ( 31 downto 0 );
    s_axi_awlen : in STD_LOGIC_VECTOR ( 3 downto 0 );
    s_axi_awsize : in STD_LOGIC_VECTOR ( 2 downto 0 );
    s_axi_awburst : in STD_LOGIC_VECTOR ( 1 downto 0 );
    s_axi_awlock : in STD_LOGIC_VECTOR ( 1 downto 0 );
    s_axi_awcache : in STD_LOGIC_VECTOR ( 3 downto 0 );
    s_axi_awprot : in STD_LOGIC_VECTOR ( 2 downto 0 );
    s_axi_awqos : in STD_LOGIC_VECTOR ( 3 downto 0 );
    s_axi_awvalid : in STD_LOGIC;
    s_axi_awready : out STD_LOGIC;
    s_axi_wid : in STD_LOGIC_VECTOR ( 11 downto 0 );
    s_axi_wdata : in STD_LOGIC_VECTOR ( 31 downto 0 );
    s_axi_wstrb : in STD_LOGIC_VECTOR ( 3 downto 0 );
    s_axi_wlast : in STD_LOGIC;
    s_axi_wvalid : in STD_LOGIC;
    s_axi_wready : out STD_LOGIC;
    s_axi_bid : out STD_LOGIC_VECTOR ( 11 downto 0 );
    s_axi_bresp : out STD_LOGIC_VECTOR ( 1 downto 0 );
    s_axi_bvalid : out STD_LOGIC;
    s_axi_bready : in STD_LOGIC;
    s_axi_arid : in STD_LOGIC_VECTOR ( 11 downto 0 );
    s_axi_araddr : in STD_LOGIC_VECTOR ( 31 downto 0 );
    s_axi_arlen : in STD_LOGIC_VECTOR ( 3 downto 0 );
    s_axi_arsize : in STD_LOGIC_VECTOR ( 2 downto 0 );
    s_axi_arburst : in STD_LOGIC_VECTOR ( 1 downto 0 );
    s_axi_arlock : in STD_LOGIC_VECTOR ( 1 downto 0 );
    s_axi_arcache : in STD_LOGIC_VECTOR ( 3 downto 0 );
    s_axi_arprot : in STD_LOGIC_VECTOR ( 2 downto 0 );
    s_axi_arqos : in STD_LOGIC_VECTOR ( 3 downto 0 );
    s_axi_arvalid : in STD_LOGIC;
    s_axi_arready : out STD_LOGIC;
    s_axi_rid : out STD_LOGIC_VECTOR ( 11 downto 0 );
    s_axi_rdata : out STD_LOGIC_VECTOR ( 31 downto 0 );
    s_axi_rresp : out STD_LOGIC_VECTOR ( 1 downto 0 );
    s_axi_rlast : out STD_LOGIC;
    s_axi_rvalid : out STD_LOGIC;
    s_axi_rready : in STD_LOGIC;
    m_axi_awaddr : out STD_LOGIC_VECTOR ( 31 downto 0 );
    m_axi_awprot : out STD_LOGIC_VECTOR ( 2 downto 0 );
    m_axi_awvalid : out STD_LOGIC;
    m_axi_awready : in STD_LOGIC;
    m_axi_wdata : out STD_LOGIC_VECTOR ( 31 downto 0 );
    m_axi_wstrb : out STD_LOGIC_VECTOR ( 3 downto 0 );
    m_axi_wvalid : out STD_LOGIC;
    m_axi_wready : in STD_LOGIC;
    m_axi_bresp : in STD_LOGIC_VECTOR ( 1 downto 0 );
    m_axi_bvalid : in STD_LOGIC;
    m_axi_bready : out STD_LOGIC;
    m_axi_araddr : out STD_LOGIC_VECTOR ( 31 downto 0 );
    m_axi_arprot : out STD_LOGIC_VECTOR ( 2 downto 0 );
    m_axi_arvalid : out STD_LOGIC;
    m_axi_arready : in STD_LOGIC;
    m_axi_rdata : in STD_LOGIC_VECTOR ( 31 downto 0 );
    m_axi_rresp : in STD_LOGIC_VECTOR ( 1 downto 0 );
    m_axi_rvalid : in STD_LOGIC;
    m_axi_rready : out STD_LOGIC
  );
  end component MADC_ARTY_Z7_auto_pc_0;
  signal S_ACLK_1 : STD_LOGIC;
  signal S_ARESETN_1 : STD_LOGIC;
  signal auto_pc_to_s00_couplers_ARADDR : STD_LOGIC_VECTOR ( 31 downto 0 );
  signal auto_pc_to_s00_couplers_ARPROT : STD_LOGIC_VECTOR ( 2 downto 0 );
  signal auto_pc_to_s00_couplers_ARREADY : STD_LOGIC;
  signal auto_pc_to_s00_couplers_ARVALID : STD_LOGIC;
  signal auto_pc_to_s00_couplers_AWADDR : STD_LOGIC_VECTOR ( 31 downto 0 );
  signal auto_pc_to_s00_couplers_AWPROT : STD_LOGIC_VECTOR ( 2 downto 0 );
  signal auto_pc_to_s00_couplers_AWREADY : STD_LOGIC;
  signal auto_pc_to_s00_couplers_AWVALID : STD_LOGIC;
  signal auto_pc_to_s00_couplers_BREADY : STD_LOGIC;
  signal auto_pc_to_s00_couplers_BRESP : STD_LOGIC_VECTOR ( 1 downto 0 );
  signal auto_pc_to_s00_couplers_BVALID : STD_LOGIC;
  signal auto_pc_to_s00_couplers_RDATA : STD_LOGIC_VECTOR ( 31 downto 0 );
  signal auto_pc_to_s00_couplers_RREADY : STD_LOGIC;
  signal auto_pc_to_s00_couplers_RRESP : STD_LOGIC_VECTOR ( 1 downto 0 );
  signal auto_pc_to_s00_couplers_RVALID : STD_LOGIC;
  signal auto_pc_to_s00_couplers_WDATA : STD_LOGIC_VECTOR ( 31 downto 0 );
  signal auto_pc_to_s00_couplers_WREADY : STD_LOGIC;
  signal auto_pc_to_s00_couplers_WSTRB : STD_LOGIC_VECTOR ( 3 downto 0 );
  signal auto_pc_to_s00_couplers_WVALID : STD_LOGIC;
  signal s00_couplers_to_auto_pc_ARADDR : STD_LOGIC_VECTOR ( 31 downto 0 );
  signal s00_couplers_to_auto_pc_ARBURST : STD_LOGIC_VECTOR ( 1 downto 0 );
  signal s00_couplers_to_auto_pc_ARCACHE : STD_LOGIC_VECTOR ( 3 downto 0 );
  signal s00_couplers_to_auto_pc_ARID : STD_LOGIC_VECTOR ( 11 downto 0 );
  signal s00_couplers_to_auto_pc_ARLEN : STD_LOGIC_VECTOR ( 3 downto 0 );
  signal s00_couplers_to_auto_pc_ARLOCK : STD_LOGIC_VECTOR ( 1 downto 0 );
  signal s00_couplers_to_auto_pc_ARPROT : STD_LOGIC_VECTOR ( 2 downto 0 );
  signal s00_couplers_to_auto_pc_ARQOS : STD_LOGIC_VECTOR ( 3 downto 0 );
  signal s00_couplers_to_auto_pc_ARREADY : STD_LOGIC;
  signal s00_couplers_to_auto_pc_ARSIZE : STD_LOGIC_VECTOR ( 2 downto 0 );
  signal s00_couplers_to_auto_pc_ARVALID : STD_LOGIC;
  signal s00_couplers_to_auto_pc_AWADDR : STD_LOGIC_VECTOR ( 31 downto 0 );
  signal s00_couplers_to_auto_pc_AWBURST : STD_LOGIC_VECTOR ( 1 downto 0 );
  signal s00_couplers_to_auto_pc_AWCACHE : STD_LOGIC_VECTOR ( 3 downto 0 );
  signal s00_couplers_to_auto_pc_AWID : STD_LOGIC_VECTOR ( 11 downto 0 );
  signal s00_couplers_to_auto_pc_AWLEN : STD_LOGIC_VECTOR ( 3 downto 0 );
  signal s00_couplers_to_auto_pc_AWLOCK : STD_LOGIC_VECTOR ( 1 downto 0 );
  signal s00_couplers_to_auto_pc_AWPROT : STD_LOGIC_VECTOR ( 2 downto 0 );
  signal s00_couplers_to_auto_pc_AWQOS : STD_LOGIC_VECTOR ( 3 downto 0 );
  signal s00_couplers_to_auto_pc_AWREADY : STD_LOGIC;
  signal s00_couplers_to_auto_pc_AWSIZE : STD_LOGIC_VECTOR ( 2 downto 0 );
  signal s00_couplers_to_auto_pc_AWVALID : STD_LOGIC;
  signal s00_couplers_to_auto_pc_BID : STD_LOGIC_VECTOR ( 11 downto 0 );
  signal s00_couplers_to_auto_pc_BREADY : STD_LOGIC;
  signal s00_couplers_to_auto_pc_BRESP : STD_LOGIC_VECTOR ( 1 downto 0 );
  signal s00_couplers_to_auto_pc_BVALID : STD_LOGIC;
  signal s00_couplers_to_auto_pc_RDATA : STD_LOGIC_VECTOR ( 31 downto 0 );
  signal s00_couplers_to_auto_pc_RID : STD_LOGIC_VECTOR ( 11 downto 0 );
  signal s00_couplers_to_auto_pc_RLAST : STD_LOGIC;
  signal s00_couplers_to_auto_pc_RREADY : STD_LOGIC;
  signal s00_couplers_to_auto_pc_RRESP : STD_LOGIC_VECTOR ( 1 downto 0 );
  signal s00_couplers_to_auto_pc_RVALID : STD_LOGIC;
  signal s00_couplers_to_auto_pc_WDATA : STD_LOGIC_VECTOR ( 31 downto 0 );
  signal s00_couplers_to_auto_pc_WID : STD_LOGIC_VECTOR ( 11 downto 0 );
  signal s00_couplers_to_auto_pc_WLAST : STD_LOGIC;
  signal s00_couplers_to_auto_pc_WREADY : STD_LOGIC;
  signal s00_couplers_to_auto_pc_WSTRB : STD_LOGIC_VECTOR ( 3 downto 0 );
  signal s00_couplers_to_auto_pc_WVALID : STD_LOGIC;
begin
  M_AXI_araddr(31 downto 0) <= auto_pc_to_s00_couplers_ARADDR(31 downto 0);
  M_AXI_arprot(2 downto 0) <= auto_pc_to_s00_couplers_ARPROT(2 downto 0);
  M_AXI_arvalid <= auto_pc_to_s00_couplers_ARVALID;
  M_AXI_awaddr(31 downto 0) <= auto_pc_to_s00_couplers_AWADDR(31 downto 0);
  M_AXI_awprot(2 downto 0) <= auto_pc_to_s00_couplers_AWPROT(2 downto 0);
  M_AXI_awvalid <= auto_pc_to_s00_couplers_AWVALID;
  M_AXI_bready <= auto_pc_to_s00_couplers_BREADY;
  M_AXI_rready <= auto_pc_to_s00_couplers_RREADY;
  M_AXI_wdata(31 downto 0) <= auto_pc_to_s00_couplers_WDATA(31 downto 0);
  M_AXI_wstrb(3 downto 0) <= auto_pc_to_s00_couplers_WSTRB(3 downto 0);
  M_AXI_wvalid <= auto_pc_to_s00_couplers_WVALID;
  S_ACLK_1 <= S_ACLK;
  S_ARESETN_1 <= S_ARESETN;
  S_AXI_arready <= s00_couplers_to_auto_pc_ARREADY;
  S_AXI_awready <= s00_couplers_to_auto_pc_AWREADY;
  S_AXI_bid(11 downto 0) <= s00_couplers_to_auto_pc_BID(11 downto 0);
  S_AXI_bresp(1 downto 0) <= s00_couplers_to_auto_pc_BRESP(1 downto 0);
  S_AXI_bvalid <= s00_couplers_to_auto_pc_BVALID;
  S_AXI_rdata(31 downto 0) <= s00_couplers_to_auto_pc_RDATA(31 downto 0);
  S_AXI_rid(11 downto 0) <= s00_couplers_to_auto_pc_RID(11 downto 0);
  S_AXI_rlast <= s00_couplers_to_auto_pc_RLAST;
  S_AXI_rresp(1 downto 0) <= s00_couplers_to_auto_pc_RRESP(1 downto 0);
  S_AXI_rvalid <= s00_couplers_to_auto_pc_RVALID;
  S_AXI_wready <= s00_couplers_to_auto_pc_WREADY;
  auto_pc_to_s00_couplers_ARREADY <= M_AXI_arready;
  auto_pc_to_s00_couplers_AWREADY <= M_AXI_awready;
  auto_pc_to_s00_couplers_BRESP(1 downto 0) <= M_AXI_bresp(1 downto 0);
  auto_pc_to_s00_couplers_BVALID <= M_AXI_bvalid;
  auto_pc_to_s00_couplers_RDATA(31 downto 0) <= M_AXI_rdata(31 downto 0);
  auto_pc_to_s00_couplers_RRESP(1 downto 0) <= M_AXI_rresp(1 downto 0);
  auto_pc_to_s00_couplers_RVALID <= M_AXI_rvalid;
  auto_pc_to_s00_couplers_WREADY <= M_AXI_wready;
  s00_couplers_to_auto_pc_ARADDR(31 downto 0) <= S_AXI_araddr(31 downto 0);
  s00_couplers_to_auto_pc_ARBURST(1 downto 0) <= S_AXI_arburst(1 downto 0);
  s00_couplers_to_auto_pc_ARCACHE(3 downto 0) <= S_AXI_arcache(3 downto 0);
  s00_couplers_to_auto_pc_ARID(11 downto 0) <= S_AXI_arid(11 downto 0);
  s00_couplers_to_auto_pc_ARLEN(3 downto 0) <= S_AXI_arlen(3 downto 0);
  s00_couplers_to_auto_pc_ARLOCK(1 downto 0) <= S_AXI_arlock(1 downto 0);
  s00_couplers_to_auto_pc_ARPROT(2 downto 0) <= S_AXI_arprot(2 downto 0);
  s00_couplers_to_auto_pc_ARQOS(3 downto 0) <= S_AXI_arqos(3 downto 0);
  s00_couplers_to_auto_pc_ARSIZE(2 downto 0) <= S_AXI_arsize(2 downto 0);
  s00_couplers_to_auto_pc_ARVALID <= S_AXI_arvalid;
  s00_couplers_to_auto_pc_AWADDR(31 downto 0) <= S_AXI_awaddr(31 downto 0);
  s00_couplers_to_auto_pc_AWBURST(1 downto 0) <= S_AXI_awburst(1 downto 0);
  s00_couplers_to_auto_pc_AWCACHE(3 downto 0) <= S_AXI_awcache(3 downto 0);
  s00_couplers_to_auto_pc_AWID(11 downto 0) <= S_AXI_awid(11 downto 0);
  s00_couplers_to_auto_pc_AWLEN(3 downto 0) <= S_AXI_awlen(3 downto 0);
  s00_couplers_to_auto_pc_AWLOCK(1 downto 0) <= S_AXI_awlock(1 downto 0);
  s00_couplers_to_auto_pc_AWPROT(2 downto 0) <= S_AXI_awprot(2 downto 0);
  s00_couplers_to_auto_pc_AWQOS(3 downto 0) <= S_AXI_awqos(3 downto 0);
  s00_couplers_to_auto_pc_AWSIZE(2 downto 0) <= S_AXI_awsize(2 downto 0);
  s00_couplers_to_auto_pc_AWVALID <= S_AXI_awvalid;
  s00_couplers_to_auto_pc_BREADY <= S_AXI_bready;
  s00_couplers_to_auto_pc_RREADY <= S_AXI_rready;
  s00_couplers_to_auto_pc_WDATA(31 downto 0) <= S_AXI_wdata(31 downto 0);
  s00_couplers_to_auto_pc_WID(11 downto 0) <= S_AXI_wid(11 downto 0);
  s00_couplers_to_auto_pc_WLAST <= S_AXI_wlast;
  s00_couplers_to_auto_pc_WSTRB(3 downto 0) <= S_AXI_wstrb(3 downto 0);
  s00_couplers_to_auto_pc_WVALID <= S_AXI_wvalid;
auto_pc: component MADC_ARTY_Z7_auto_pc_0
     port map (
      aclk => S_ACLK_1,
      aresetn => S_ARESETN_1,
      m_axi_araddr(31 downto 0) => auto_pc_to_s00_couplers_ARADDR(31 downto 0),
      m_axi_arprot(2 downto 0) => auto_pc_to_s00_couplers_ARPROT(2 downto 0),
      m_axi_arready => auto_pc_to_s00_couplers_ARREADY,
      m_axi_arvalid => auto_pc_to_s00_couplers_ARVALID,
      m_axi_awaddr(31 downto 0) => auto_pc_to_s00_couplers_AWADDR(31 downto 0),
      m_axi_awprot(2 downto 0) => auto_pc_to_s00_couplers_AWPROT(2 downto 0),
      m_axi_awready => auto_pc_to_s00_couplers_AWREADY,
      m_axi_awvalid => auto_pc_to_s00_couplers_AWVALID,
      m_axi_bready => auto_pc_to_s00_couplers_BREADY,
      m_axi_bresp(1 downto 0) => auto_pc_to_s00_couplers_BRESP(1 downto 0),
      m_axi_bvalid => auto_pc_to_s00_couplers_BVALID,
      m_axi_rdata(31 downto 0) => auto_pc_to_s00_couplers_RDATA(31 downto 0),
      m_axi_rready => auto_pc_to_s00_couplers_RREADY,
      m_axi_rresp(1 downto 0) => auto_pc_to_s00_couplers_RRESP(1 downto 0),
      m_axi_rvalid => auto_pc_to_s00_couplers_RVALID,
      m_axi_wdata(31 downto 0) => auto_pc_to_s00_couplers_WDATA(31 downto 0),
      m_axi_wready => auto_pc_to_s00_couplers_WREADY,
      m_axi_wstrb(3 downto 0) => auto_pc_to_s00_couplers_WSTRB(3 downto 0),
      m_axi_wvalid => auto_pc_to_s00_couplers_WVALID,
      s_axi_araddr(31 downto 0) => s00_couplers_to_auto_pc_ARADDR(31 downto 0),
      s_axi_arburst(1 downto 0) => s00_couplers_to_auto_pc_ARBURST(1 downto 0),
      s_axi_arcache(3 downto 0) => s00_couplers_to_auto_pc_ARCACHE(3 downto 0),
      s_axi_arid(11 downto 0) => s00_couplers_to_auto_pc_ARID(11 downto 0),
      s_axi_arlen(3 downto 0) => s00_couplers_to_auto_pc_ARLEN(3 downto 0),
      s_axi_arlock(1 downto 0) => s00_couplers_to_auto_pc_ARLOCK(1 downto 0),
      s_axi_arprot(2 downto 0) => s00_couplers_to_auto_pc_ARPROT(2 downto 0),
      s_axi_arqos(3 downto 0) => s00_couplers_to_auto_pc_ARQOS(3 downto 0),
      s_axi_arready => s00_couplers_to_auto_pc_ARREADY,
      s_axi_arsize(2 downto 0) => s00_couplers_to_auto_pc_ARSIZE(2 downto 0),
      s_axi_arvalid => s00_couplers_to_auto_pc_ARVALID,
      s_axi_awaddr(31 downto 0) => s00_couplers_to_auto_pc_AWADDR(31 downto 0),
      s_axi_awburst(1 downto 0) => s00_couplers_to_auto_pc_AWBURST(1 downto 0),
      s_axi_awcache(3 downto 0) => s00_couplers_to_auto_pc_AWCACHE(3 downto 0),
      s_axi_awid(11 downto 0) => s00_couplers_to_auto_pc_AWID(11 downto 0),
      s_axi_awlen(3 downto 0) => s00_couplers_to_auto_pc_AWLEN(3 downto 0),
      s_axi_awlock(1 downto 0) => s00_couplers_to_auto_pc_AWLOCK(1 downto 0),
      s_axi_awprot(2 downto 0) => s00_couplers_to_auto_pc_AWPROT(2 downto 0),
      s_axi_awqos(3 downto 0) => s00_couplers_to_auto_pc_AWQOS(3 downto 0),
      s_axi_awready => s00_couplers_to_auto_pc_AWREADY,
      s_axi_awsize(2 downto 0) => s00_couplers_to_auto_pc_AWSIZE(2 downto 0),
      s_axi_awvalid => s00_couplers_to_auto_pc_AWVALID,
      s_axi_bid(11 downto 0) => s00_couplers_to_auto_pc_BID(11 downto 0),
      s_axi_bready => s00_couplers_to_auto_pc_BREADY,
      s_axi_bresp(1 downto 0) => s00_couplers_to_auto_pc_BRESP(1 downto 0),
      s_axi_bvalid => s00_couplers_to_auto_pc_BVALID,
      s_axi_rdata(31 downto 0) => s00_couplers_to_auto_pc_RDATA(31 downto 0),
      s_axi_rid(11 downto 0) => s00_couplers_to_auto_pc_RID(11 downto 0),
      s_axi_rlast => s00_couplers_to_auto_pc_RLAST,
      s_axi_rready => s00_couplers_to_auto_pc_RREADY,
      s_axi_rresp(1 downto 0) => s00_couplers_to_auto_pc_RRESP(1 downto 0),
      s_axi_rvalid => s00_couplers_to_auto_pc_RVALID,
      s_axi_wdata(31 downto 0) => s00_couplers_to_auto_pc_WDATA(31 downto 0),
      s_axi_wid(11 downto 0) => s00_couplers_to_auto_pc_WID(11 downto 0),
      s_axi_wlast => s00_couplers_to_auto_pc_WLAST,
      s_axi_wready => s00_couplers_to_auto_pc_WREADY,
      s_axi_wstrb(3 downto 0) => s00_couplers_to_auto_pc_WSTRB(3 downto 0),
      s_axi_wvalid => s00_couplers_to_auto_pc_WVALID
    );
end STRUCTURE;
library IEEE;
use IEEE.STD_LOGIC_1164.ALL;
library UNISIM;
use UNISIM.VCOMPONENTS.ALL;
entity MADC_ARTY_Z7_ps7_0_axi_periph_0 is
  port (
    ACLK : in STD_LOGIC;
    ARESETN : in STD_LOGIC;
    M00_ACLK : in STD_LOGIC;
    M00_ARESETN : in STD_LOGIC;
    M00_AXI_araddr : out STD_LOGIC_VECTOR ( 31 downto 0 );
    M00_AXI_arready : in STD_LOGIC_VECTOR ( 0 to 0 );
    M00_AXI_arvalid : out STD_LOGIC_VECTOR ( 0 to 0 );
    M00_AXI_awaddr : out STD_LOGIC_VECTOR ( 31 downto 0 );
    M00_AXI_awready : in STD_LOGIC_VECTOR ( 0 to 0 );
    M00_AXI_awvalid : out STD_LOGIC_VECTOR ( 0 to 0 );
    M00_AXI_bready : out STD_LOGIC_VECTOR ( 0 to 0 );
    M00_AXI_bresp : in STD_LOGIC_VECTOR ( 1 downto 0 );
    M00_AXI_bvalid : in STD_LOGIC_VECTOR ( 0 to 0 );
    M00_AXI_rdata : in STD_LOGIC_VECTOR ( 31 downto 0 );
    M00_AXI_rready : out STD_LOGIC_VECTOR ( 0 to 0 );
    M00_AXI_rresp : in STD_LOGIC_VECTOR ( 1 downto 0 );
    M00_AXI_rvalid : in STD_LOGIC_VECTOR ( 0 to 0 );
    M00_AXI_wdata : out STD_LOGIC_VECTOR ( 31 downto 0 );
    M00_AXI_wready : in STD_LOGIC_VECTOR ( 0 to 0 );
    M00_AXI_wstrb : out STD_LOGIC_VECTOR ( 3 downto 0 );
    M00_AXI_wvalid : out STD_LOGIC_VECTOR ( 0 to 0 );
    M01_ACLK : in STD_LOGIC;
    M01_ARESETN : in STD_LOGIC;
    M01_AXI_araddr : out STD_LOGIC_VECTOR ( 31 downto 0 );
    M01_AXI_arprot : out STD_LOGIC_VECTOR ( 2 downto 0 );
    M01_AXI_arready : in STD_LOGIC;
    M01_AXI_arvalid : out STD_LOGIC;
    M01_AXI_awaddr : out STD_LOGIC_VECTOR ( 31 downto 0 );
    M01_AXI_awprot : out STD_LOGIC_VECTOR ( 2 downto 0 );
    M01_AXI_awready : in STD_LOGIC;
    M01_AXI_awvalid : out STD_LOGIC;
    M01_AXI_bready : out STD_LOGIC;
    M01_AXI_bresp : in STD_LOGIC_VECTOR ( 1 downto 0 );
    M01_AXI_bvalid : in STD_LOGIC;
    M01_AXI_rdata : in STD_LOGIC_VECTOR ( 31 downto 0 );
    M01_AXI_rready : out STD_LOGIC;
    M01_AXI_rresp : in STD_LOGIC_VECTOR ( 1 downto 0 );
    M01_AXI_rvalid : in STD_LOGIC;
    M01_AXI_wdata : out STD_LOGIC_VECTOR ( 31 downto 0 );
    M01_AXI_wready : in STD_LOGIC;
    M01_AXI_wstrb : out STD_LOGIC_VECTOR ( 3 downto 0 );
    M01_AXI_wvalid : out STD_LOGIC;
    S00_ACLK : in STD_LOGIC;
    S00_ARESETN : in STD_LOGIC;
    S00_AXI_araddr : in STD_LOGIC_VECTOR ( 31 downto 0 );
    S00_AXI_arburst : in STD_LOGIC_VECTOR ( 1 downto 0 );
    S00_AXI_arcache : in STD_LOGIC_VECTOR ( 3 downto 0 );
    S00_AXI_arid : in STD_LOGIC_VECTOR ( 11 downto 0 );
    S00_AXI_arlen : in STD_LOGIC_VECTOR ( 3 downto 0 );
    S00_AXI_arlock : in STD_LOGIC_VECTOR ( 1 downto 0 );
    S00_AXI_arprot : in STD_LOGIC_VECTOR ( 2 downto 0 );
    S00_AXI_arqos : in STD_LOGIC_VECTOR ( 3 downto 0 );
    S00_AXI_arready : out STD_LOGIC;
    S00_AXI_arsize : in STD_LOGIC_VECTOR ( 2 downto 0 );
    S00_AXI_arvalid : in STD_LOGIC;
    S00_AXI_awaddr : in STD_LOGIC_VECTOR ( 31 downto 0 );
    S00_AXI_awburst : in STD_LOGIC_VECTOR ( 1 downto 0 );
    S00_AXI_awcache : in STD_LOGIC_VECTOR ( 3 downto 0 );
    S00_AXI_awid : in STD_LOGIC_VECTOR ( 11 downto 0 );
    S00_AXI_awlen : in STD_LOGIC_VECTOR ( 3 downto 0 );
    S00_AXI_awlock : in STD_LOGIC_VECTOR ( 1 downto 0 );
    S00_AXI_awprot : in STD_LOGIC_VECTOR ( 2 downto 0 );
    S00_AXI_awqos : in STD_LOGIC_VECTOR ( 3 downto 0 );
    S00_AXI_awready : out STD_LOGIC;
    S00_AXI_awsize : in STD_LOGIC_VECTOR ( 2 downto 0 );
    S00_AXI_awvalid : in STD_LOGIC;
    S00_AXI_bid : out STD_LOGIC_VECTOR ( 11 downto 0 );
    S00_AXI_bready : in STD_LOGIC;
    S00_AXI_bresp : out STD_LOGIC_VECTOR ( 1 downto 0 );
    S00_AXI_bvalid : out STD_LOGIC;
    S00_AXI_rdata : out STD_LOGIC_VECTOR ( 31 downto 0 );
    S00_AXI_rid : out STD_LOGIC_VECTOR ( 11 downto 0 );
    S00_AXI_rlast : out STD_LOGIC;
    S00_AXI_rready : in STD_LOGIC;
    S00_AXI_rresp : out STD_LOGIC_VECTOR ( 1 downto 0 );
    S00_AXI_rvalid : out STD_LOGIC;
    S00_AXI_wdata : in STD_LOGIC_VECTOR ( 31 downto 0 );
    S00_AXI_wid : in STD_LOGIC_VECTOR ( 11 downto 0 );
    S00_AXI_wlast : in STD_LOGIC;
    S00_AXI_wready : out STD_LOGIC;
    S00_AXI_wstrb : in STD_LOGIC_VECTOR ( 3 downto 0 );
    S00_AXI_wvalid : in STD_LOGIC
  );
end MADC_ARTY_Z7_ps7_0_axi_periph_0;

architecture STRUCTURE of MADC_ARTY_Z7_ps7_0_axi_periph_0 is
  component MADC_ARTY_Z7_xbar_0 is
  port (
    aclk : in STD_LOGIC;
    aresetn : in STD_LOGIC;
    s_axi_awaddr : in STD_LOGIC_VECTOR ( 31 downto 0 );
    s_axi_awprot : in STD_LOGIC_VECTOR ( 2 downto 0 );
    s_axi_awvalid : in STD_LOGIC_VECTOR ( 0 to 0 );
    s_axi_awready : out STD_LOGIC_VECTOR ( 0 to 0 );
    s_axi_wdata : in STD_LOGIC_VECTOR ( 31 downto 0 );
    s_axi_wstrb : in STD_LOGIC_VECTOR ( 3 downto 0 );
    s_axi_wvalid : in STD_LOGIC_VECTOR ( 0 to 0 );
    s_axi_wready : out STD_LOGIC_VECTOR ( 0 to 0 );
    s_axi_bresp : out STD_LOGIC_VECTOR ( 1 downto 0 );
    s_axi_bvalid : out STD_LOGIC_VECTOR ( 0 to 0 );
    s_axi_bready : in STD_LOGIC_VECTOR ( 0 to 0 );
    s_axi_araddr : in STD_LOGIC_VECTOR ( 31 downto 0 );
    s_axi_arprot : in STD_LOGIC_VECTOR ( 2 downto 0 );
    s_axi_arvalid : in STD_LOGIC_VECTOR ( 0 to 0 );
    s_axi_arready : out STD_LOGIC_VECTOR ( 0 to 0 );
    s_axi_rdata : out STD_LOGIC_VECTOR ( 31 downto 0 );
    s_axi_rresp : out STD_LOGIC_VECTOR ( 1 downto 0 );
    s_axi_rvalid : out STD_LOGIC_VECTOR ( 0 to 0 );
    s_axi_rready : in STD_LOGIC_VECTOR ( 0 to 0 );
    m_axi_awaddr : out STD_LOGIC_VECTOR ( 63 downto 0 );
    m_axi_awprot : out STD_LOGIC_VECTOR ( 5 downto 0 );
    m_axi_awvalid : out STD_LOGIC_VECTOR ( 1 downto 0 );
    m_axi_awready : in STD_LOGIC_VECTOR ( 1 downto 0 );
    m_axi_wdata : out STD_LOGIC_VECTOR ( 63 downto 0 );
    m_axi_wstrb : out STD_LOGIC_VECTOR ( 7 downto 0 );
    m_axi_wvalid : out STD_LOGIC_VECTOR ( 1 downto 0 );
    m_axi_wready : in STD_LOGIC_VECTOR ( 1 downto 0 );
    m_axi_bresp : in STD_LOGIC_VECTOR ( 3 downto 0 );
    m_axi_bvalid : in STD_LOGIC_VECTOR ( 1 downto 0 );
    m_axi_bready : out STD_LOGIC_VECTOR ( 1 downto 0 );
    m_axi_araddr : out STD_LOGIC_VECTOR ( 63 downto 0 );
    m_axi_arprot : out STD_LOGIC_VECTOR ( 5 downto 0 );
    m_axi_arvalid : out STD_LOGIC_VECTOR ( 1 downto 0 );
    m_axi_arready : in STD_LOGIC_VECTOR ( 1 downto 0 );
    m_axi_rdata : in STD_LOGIC_VECTOR ( 63 downto 0 );
    m_axi_rresp : in STD_LOGIC_VECTOR ( 3 downto 0 );
    m_axi_rvalid : in STD_LOGIC_VECTOR ( 1 downto 0 );
    m_axi_rready : out STD_LOGIC_VECTOR ( 1 downto 0 )
  );
  end component MADC_ARTY_Z7_xbar_0;
  signal m00_couplers_to_ps7_0_axi_periph_ARADDR : STD_LOGIC_VECTOR ( 31 downto 0 );
  signal m00_couplers_to_ps7_0_axi_periph_ARREADY : STD_LOGIC_VECTOR ( 0 to 0 );
  signal m00_couplers_to_ps7_0_axi_periph_ARVALID : STD_LOGIC_VECTOR ( 0 to 0 );
  signal m00_couplers_to_ps7_0_axi_periph_AWADDR : STD_LOGIC_VECTOR ( 31 downto 0 );
  signal m00_couplers_to_ps7_0_axi_periph_AWREADY : STD_LOGIC_VECTOR ( 0 to 0 );
  signal m00_couplers_to_ps7_0_axi_periph_AWVALID : STD_LOGIC_VECTOR ( 0 to 0 );
  signal m00_couplers_to_ps7_0_axi_periph_BREADY : STD_LOGIC_VECTOR ( 0 to 0 );
  signal m00_couplers_to_ps7_0_axi_periph_BRESP : STD_LOGIC_VECTOR ( 1 downto 0 );
  signal m00_couplers_to_ps7_0_axi_periph_BVALID : STD_LOGIC_VECTOR ( 0 to 0 );
  signal m00_couplers_to_ps7_0_axi_periph_RDATA : STD_LOGIC_VECTOR ( 31 downto 0 );
  signal m00_couplers_to_ps7_0_axi_periph_RREADY : STD_LOGIC_VECTOR ( 0 to 0 );
  signal m00_couplers_to_ps7_0_axi_periph_RRESP : STD_LOGIC_VECTOR ( 1 downto 0 );
  signal m00_couplers_to_ps7_0_axi_periph_RVALID : STD_LOGIC_VECTOR ( 0 to 0 );
  signal m00_couplers_to_ps7_0_axi_periph_WDATA : STD_LOGIC_VECTOR ( 31 downto 0 );
  signal m00_couplers_to_ps7_0_axi_periph_WREADY : STD_LOGIC_VECTOR ( 0 to 0 );
  signal m00_couplers_to_ps7_0_axi_periph_WSTRB : STD_LOGIC_VECTOR ( 3 downto 0 );
  signal m00_couplers_to_ps7_0_axi_periph_WVALID : STD_LOGIC_VECTOR ( 0 to 0 );
  signal m01_couplers_to_ps7_0_axi_periph_ARADDR : STD_LOGIC_VECTOR ( 31 downto 0 );
  signal m01_couplers_to_ps7_0_axi_periph_ARPROT : STD_LOGIC_VECTOR ( 2 downto 0 );
  signal m01_couplers_to_ps7_0_axi_periph_ARREADY : STD_LOGIC;
  signal m01_couplers_to_ps7_0_axi_periph_ARVALID : STD_LOGIC;
  signal m01_couplers_to_ps7_0_axi_periph_AWADDR : STD_LOGIC_VECTOR ( 31 downto 0 );
  signal m01_couplers_to_ps7_0_axi_periph_AWPROT : STD_LOGIC_VECTOR ( 2 downto 0 );
  signal m01_couplers_to_ps7_0_axi_periph_AWREADY : STD_LOGIC;
  signal m01_couplers_to_ps7_0_axi_periph_AWVALID : STD_LOGIC;
  signal m01_couplers_to_ps7_0_axi_periph_BREADY : STD_LOGIC;
  signal m01_couplers_to_ps7_0_axi_periph_BRESP : STD_LOGIC_VECTOR ( 1 downto 0 );
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
  signal s00_couplers_to_xbar_BREADY : STD_LOGIC;
  signal s00_couplers_to_xbar_BRESP : STD_LOGIC_VECTOR ( 1 downto 0 );
  signal s00_couplers_to_xbar_BVALID : STD_LOGIC_VECTOR ( 0 to 0 );
  signal s00_couplers_to_xbar_RDATA : STD_LOGIC_VECTOR ( 31 downto 0 );
  signal s00_couplers_to_xbar_RREADY : STD_LOGIC;
  signal s00_couplers_to_xbar_RRESP : STD_LOGIC_VECTOR ( 1 downto 0 );
  signal s00_couplers_to_xbar_RVALID : STD_LOGIC_VECTOR ( 0 to 0 );
  signal s00_couplers_to_xbar_WDATA : STD_LOGIC_VECTOR ( 31 downto 0 );
  signal s00_couplers_to_xbar_WREADY : STD_LOGIC_VECTOR ( 0 to 0 );
  signal s00_couplers_to_xbar_WSTRB : STD_LOGIC_VECTOR ( 3 downto 0 );
  signal s00_couplers_to_xbar_WVALID : STD_LOGIC;
  signal xbar_to_m00_couplers_ARADDR : STD_LOGIC_VECTOR ( 31 downto 0 );
  signal xbar_to_m00_couplers_ARREADY : STD_LOGIC_VECTOR ( 0 to 0 );
  signal xbar_to_m00_couplers_ARVALID : STD_LOGIC_VECTOR ( 0 to 0 );
  signal xbar_to_m00_couplers_AWADDR : STD_LOGIC_VECTOR ( 31 downto 0 );
  signal xbar_to_m00_couplers_AWREADY : STD_LOGIC_VECTOR ( 0 to 0 );
  signal xbar_to_m00_couplers_AWVALID : STD_LOGIC_VECTOR ( 0 to 0 );
  signal xbar_to_m00_couplers_BREADY : STD_LOGIC_VECTOR ( 0 to 0 );
  signal xbar_to_m00_couplers_BRESP : STD_LOGIC_VECTOR ( 1 downto 0 );
  signal xbar_to_m00_couplers_BVALID : STD_LOGIC_VECTOR ( 0 to 0 );
  signal xbar_to_m00_couplers_RDATA : STD_LOGIC_VECTOR ( 31 downto 0 );
  signal xbar_to_m00_couplers_RREADY : STD_LOGIC_VECTOR ( 0 to 0 );
  signal xbar_to_m00_couplers_RRESP : STD_LOGIC_VECTOR ( 1 downto 0 );
  signal xbar_to_m00_couplers_RVALID : STD_LOGIC_VECTOR ( 0 to 0 );
  signal xbar_to_m00_couplers_WDATA : STD_LOGIC_VECTOR ( 31 downto 0 );
  signal xbar_to_m00_couplers_WREADY : STD_LOGIC_VECTOR ( 0 to 0 );
  signal xbar_to_m00_couplers_WSTRB : STD_LOGIC_VECTOR ( 3 downto 0 );
  signal xbar_to_m00_couplers_WVALID : STD_LOGIC_VECTOR ( 0 to 0 );
  signal xbar_to_m01_couplers_ARADDR : STD_LOGIC_VECTOR ( 63 downto 32 );
  signal xbar_to_m01_couplers_ARPROT : STD_LOGIC_VECTOR ( 5 downto 3 );
  signal xbar_to_m01_couplers_ARREADY : STD_LOGIC;
  signal xbar_to_m01_couplers_ARVALID : STD_LOGIC_VECTOR ( 1 to 1 );
  signal xbar_to_m01_couplers_AWADDR : STD_LOGIC_VECTOR ( 63 downto 32 );
  signal xbar_to_m01_couplers_AWPROT : STD_LOGIC_VECTOR ( 5 downto 3 );
  signal xbar_to_m01_couplers_AWREADY : STD_LOGIC;
  signal xbar_to_m01_couplers_AWVALID : STD_LOGIC_VECTOR ( 1 to 1 );
  signal xbar_to_m01_couplers_BREADY : STD_LOGIC_VECTOR ( 1 to 1 );
  signal xbar_to_m01_couplers_BRESP : STD_LOGIC_VECTOR ( 1 downto 0 );
  signal xbar_to_m01_couplers_BVALID : STD_LOGIC;
  signal xbar_to_m01_couplers_RDATA : STD_LOGIC_VECTOR ( 31 downto 0 );
  signal xbar_to_m01_couplers_RREADY : STD_LOGIC_VECTOR ( 1 to 1 );
  signal xbar_to_m01_couplers_RRESP : STD_LOGIC_VECTOR ( 1 downto 0 );
  signal xbar_to_m01_couplers_RVALID : STD_LOGIC;
  signal xbar_to_m01_couplers_WDATA : STD_LOGIC_VECTOR ( 63 downto 32 );
  signal xbar_to_m01_couplers_WREADY : STD_LOGIC;
  signal xbar_to_m01_couplers_WSTRB : STD_LOGIC_VECTOR ( 7 downto 4 );
  signal xbar_to_m01_couplers_WVALID : STD_LOGIC_VECTOR ( 1 to 1 );
  signal NLW_xbar_m_axi_arprot_UNCONNECTED : STD_LOGIC_VECTOR ( 2 downto 0 );
  signal NLW_xbar_m_axi_awprot_UNCONNECTED : STD_LOGIC_VECTOR ( 2 downto 0 );
begin
  M00_AXI_araddr(31 downto 0) <= m00_couplers_to_ps7_0_axi_periph_ARADDR(31 downto 0);
  M00_AXI_arvalid(0) <= m00_couplers_to_ps7_0_axi_periph_ARVALID(0);
  M00_AXI_awaddr(31 downto 0) <= m00_couplers_to_ps7_0_axi_periph_AWADDR(31 downto 0);
  M00_AXI_awvalid(0) <= m00_couplers_to_ps7_0_axi_periph_AWVALID(0);
  M00_AXI_bready(0) <= m00_couplers_to_ps7_0_axi_periph_BREADY(0);
  M00_AXI_rready(0) <= m00_couplers_to_ps7_0_axi_periph_RREADY(0);
  M00_AXI_wdata(31 downto 0) <= m00_couplers_to_ps7_0_axi_periph_WDATA(31 downto 0);
  M00_AXI_wstrb(3 downto 0) <= m00_couplers_to_ps7_0_axi_periph_WSTRB(3 downto 0);
  M00_AXI_wvalid(0) <= m00_couplers_to_ps7_0_axi_periph_WVALID(0);
  M01_AXI_araddr(31 downto 0) <= m01_couplers_to_ps7_0_axi_periph_ARADDR(31 downto 0);
  M01_AXI_arprot(2 downto 0) <= m01_couplers_to_ps7_0_axi_periph_ARPROT(2 downto 0);
  M01_AXI_arvalid <= m01_couplers_to_ps7_0_axi_periph_ARVALID;
  M01_AXI_awaddr(31 downto 0) <= m01_couplers_to_ps7_0_axi_periph_AWADDR(31 downto 0);
  M01_AXI_awprot(2 downto 0) <= m01_couplers_to_ps7_0_axi_periph_AWPROT(2 downto 0);
  M01_AXI_awvalid <= m01_couplers_to_ps7_0_axi_periph_AWVALID;
  M01_AXI_bready <= m01_couplers_to_ps7_0_axi_periph_BREADY;
  M01_AXI_rready <= m01_couplers_to_ps7_0_axi_periph_RREADY;
  M01_AXI_wdata(31 downto 0) <= m01_couplers_to_ps7_0_axi_periph_WDATA(31 downto 0);
  M01_AXI_wstrb(3 downto 0) <= m01_couplers_to_ps7_0_axi_periph_WSTRB(3 downto 0);
  M01_AXI_wvalid <= m01_couplers_to_ps7_0_axi_periph_WVALID;
  S00_AXI_arready <= ps7_0_axi_periph_to_s00_couplers_ARREADY;
  S00_AXI_awready <= ps7_0_axi_periph_to_s00_couplers_AWREADY;
  S00_AXI_bid(11 downto 0) <= ps7_0_axi_periph_to_s00_couplers_BID(11 downto 0);
  S00_AXI_bresp(1 downto 0) <= ps7_0_axi_periph_to_s00_couplers_BRESP(1 downto 0);
  S00_AXI_bvalid <= ps7_0_axi_periph_to_s00_couplers_BVALID;
  S00_AXI_rdata(31 downto 0) <= ps7_0_axi_periph_to_s00_couplers_RDATA(31 downto 0);
  S00_AXI_rid(11 downto 0) <= ps7_0_axi_periph_to_s00_couplers_RID(11 downto 0);
  S00_AXI_rlast <= ps7_0_axi_periph_to_s00_couplers_RLAST;
  S00_AXI_rresp(1 downto 0) <= ps7_0_axi_periph_to_s00_couplers_RRESP(1 downto 0);
  S00_AXI_rvalid <= ps7_0_axi_periph_to_s00_couplers_RVALID;
  S00_AXI_wready <= ps7_0_axi_periph_to_s00_couplers_WREADY;
  m00_couplers_to_ps7_0_axi_periph_ARREADY(0) <= M00_AXI_arready(0);
  m00_couplers_to_ps7_0_axi_periph_AWREADY(0) <= M00_AXI_awready(0);
  m00_couplers_to_ps7_0_axi_periph_BRESP(1 downto 0) <= M00_AXI_bresp(1 downto 0);
  m00_couplers_to_ps7_0_axi_periph_BVALID(0) <= M00_AXI_bvalid(0);
  m00_couplers_to_ps7_0_axi_periph_RDATA(31 downto 0) <= M00_AXI_rdata(31 downto 0);
  m00_couplers_to_ps7_0_axi_periph_RRESP(1 downto 0) <= M00_AXI_rresp(1 downto 0);
  m00_couplers_to_ps7_0_axi_periph_RVALID(0) <= M00_AXI_rvalid(0);
  m00_couplers_to_ps7_0_axi_periph_WREADY(0) <= M00_AXI_wready(0);
  m01_couplers_to_ps7_0_axi_periph_ARREADY <= M01_AXI_arready;
  m01_couplers_to_ps7_0_axi_periph_AWREADY <= M01_AXI_awready;
  m01_couplers_to_ps7_0_axi_periph_BRESP(1 downto 0) <= M01_AXI_bresp(1 downto 0);
  m01_couplers_to_ps7_0_axi_periph_BVALID <= M01_AXI_bvalid;
  m01_couplers_to_ps7_0_axi_periph_RDATA(31 downto 0) <= M01_AXI_rdata(31 downto 0);
  m01_couplers_to_ps7_0_axi_periph_RRESP(1 downto 0) <= M01_AXI_rresp(1 downto 0);
  m01_couplers_to_ps7_0_axi_periph_RVALID <= M01_AXI_rvalid;
  m01_couplers_to_ps7_0_axi_periph_WREADY <= M01_AXI_wready;
  ps7_0_axi_periph_ACLK_net <= ACLK;
  ps7_0_axi_periph_ARESETN_net <= ARESETN;
  ps7_0_axi_periph_to_s00_couplers_ARADDR(31 downto 0) <= S00_AXI_araddr(31 downto 0);
  ps7_0_axi_periph_to_s00_couplers_ARBURST(1 downto 0) <= S00_AXI_arburst(1 downto 0);
  ps7_0_axi_periph_to_s00_couplers_ARCACHE(3 downto 0) <= S00_AXI_arcache(3 downto 0);
  ps7_0_axi_periph_to_s00_couplers_ARID(11 downto 0) <= S00_AXI_arid(11 downto 0);
  ps7_0_axi_periph_to_s00_couplers_ARLEN(3 downto 0) <= S00_AXI_arlen(3 downto 0);
  ps7_0_axi_periph_to_s00_couplers_ARLOCK(1 downto 0) <= S00_AXI_arlock(1 downto 0);
  ps7_0_axi_periph_to_s00_couplers_ARPROT(2 downto 0) <= S00_AXI_arprot(2 downto 0);
  ps7_0_axi_periph_to_s00_couplers_ARQOS(3 downto 0) <= S00_AXI_arqos(3 downto 0);
  ps7_0_axi_periph_to_s00_couplers_ARSIZE(2 downto 0) <= S00_AXI_arsize(2 downto 0);
  ps7_0_axi_periph_to_s00_couplers_ARVALID <= S00_AXI_arvalid;
  ps7_0_axi_periph_to_s00_couplers_AWADDR(31 downto 0) <= S00_AXI_awaddr(31 downto 0);
  ps7_0_axi_periph_to_s00_couplers_AWBURST(1 downto 0) <= S00_AXI_awburst(1 downto 0);
  ps7_0_axi_periph_to_s00_couplers_AWCACHE(3 downto 0) <= S00_AXI_awcache(3 downto 0);
  ps7_0_axi_periph_to_s00_couplers_AWID(11 downto 0) <= S00_AXI_awid(11 downto 0);
  ps7_0_axi_periph_to_s00_couplers_AWLEN(3 downto 0) <= S00_AXI_awlen(3 downto 0);
  ps7_0_axi_periph_to_s00_couplers_AWLOCK(1 downto 0) <= S00_AXI_awlock(1 downto 0);
  ps7_0_axi_periph_to_s00_couplers_AWPROT(2 downto 0) <= S00_AXI_awprot(2 downto 0);
  ps7_0_axi_periph_to_s00_couplers_AWQOS(3 downto 0) <= S00_AXI_awqos(3 downto 0);
  ps7_0_axi_periph_to_s00_couplers_AWSIZE(2 downto 0) <= S00_AXI_awsize(2 downto 0);
  ps7_0_axi_periph_to_s00_couplers_AWVALID <= S00_AXI_awvalid;
  ps7_0_axi_periph_to_s00_couplers_BREADY <= S00_AXI_bready;
  ps7_0_axi_periph_to_s00_couplers_RREADY <= S00_AXI_rready;
  ps7_0_axi_periph_to_s00_couplers_WDATA(31 downto 0) <= S00_AXI_wdata(31 downto 0);
  ps7_0_axi_periph_to_s00_couplers_WID(11 downto 0) <= S00_AXI_wid(11 downto 0);
  ps7_0_axi_periph_to_s00_couplers_WLAST <= S00_AXI_wlast;
  ps7_0_axi_periph_to_s00_couplers_WSTRB(3 downto 0) <= S00_AXI_wstrb(3 downto 0);
  ps7_0_axi_periph_to_s00_couplers_WVALID <= S00_AXI_wvalid;
m00_couplers: entity work.m00_couplers_imp_RXNZS0
     port map (
      M_ACLK => ps7_0_axi_periph_ACLK_net,
      M_ARESETN => ps7_0_axi_periph_ARESETN_net,
      M_AXI_araddr(31 downto 0) => m00_couplers_to_ps7_0_axi_periph_ARADDR(31 downto 0),
      M_AXI_arready(0) => m00_couplers_to_ps7_0_axi_periph_ARREADY(0),
      M_AXI_arvalid(0) => m00_couplers_to_ps7_0_axi_periph_ARVALID(0),
      M_AXI_awaddr(31 downto 0) => m00_couplers_to_ps7_0_axi_periph_AWADDR(31 downto 0),
      M_AXI_awready(0) => m00_couplers_to_ps7_0_axi_periph_AWREADY(0),
      M_AXI_awvalid(0) => m00_couplers_to_ps7_0_axi_periph_AWVALID(0),
      M_AXI_bready(0) => m00_couplers_to_ps7_0_axi_periph_BREADY(0),
      M_AXI_bresp(1 downto 0) => m00_couplers_to_ps7_0_axi_periph_BRESP(1 downto 0),
      M_AXI_bvalid(0) => m00_couplers_to_ps7_0_axi_periph_BVALID(0),
      M_AXI_rdata(31 downto 0) => m00_couplers_to_ps7_0_axi_periph_RDATA(31 downto 0),
      M_AXI_rready(0) => m00_couplers_to_ps7_0_axi_periph_RREADY(0),
      M_AXI_rresp(1 downto 0) => m00_couplers_to_ps7_0_axi_periph_RRESP(1 downto 0),
      M_AXI_rvalid(0) => m00_couplers_to_ps7_0_axi_periph_RVALID(0),
      M_AXI_wdata(31 downto 0) => m00_couplers_to_ps7_0_axi_periph_WDATA(31 downto 0),
      M_AXI_wready(0) => m00_couplers_to_ps7_0_axi_periph_WREADY(0),
      M_AXI_wstrb(3 downto 0) => m00_couplers_to_ps7_0_axi_periph_WSTRB(3 downto 0),
      M_AXI_wvalid(0) => m00_couplers_to_ps7_0_axi_periph_WVALID(0),
      S_ACLK => ps7_0_axi_periph_ACLK_net,
      S_ARESETN => ps7_0_axi_periph_ARESETN_net,
      S_AXI_araddr(31 downto 0) => xbar_to_m00_couplers_ARADDR(31 downto 0),
      S_AXI_arready(0) => xbar_to_m00_couplers_ARREADY(0),
      S_AXI_arvalid(0) => xbar_to_m00_couplers_ARVALID(0),
      S_AXI_awaddr(31 downto 0) => xbar_to_m00_couplers_AWADDR(31 downto 0),
      S_AXI_awready(0) => xbar_to_m00_couplers_AWREADY(0),
      S_AXI_awvalid(0) => xbar_to_m00_couplers_AWVALID(0),
      S_AXI_bready(0) => xbar_to_m00_couplers_BREADY(0),
      S_AXI_bresp(1 downto 0) => xbar_to_m00_couplers_BRESP(1 downto 0),
      S_AXI_bvalid(0) => xbar_to_m00_couplers_BVALID(0),
      S_AXI_rdata(31 downto 0) => xbar_to_m00_couplers_RDATA(31 downto 0),
      S_AXI_rready(0) => xbar_to_m00_couplers_RREADY(0),
      S_AXI_rresp(1 downto 0) => xbar_to_m00_couplers_RRESP(1 downto 0),
      S_AXI_rvalid(0) => xbar_to_m00_couplers_RVALID(0),
      S_AXI_wdata(31 downto 0) => xbar_to_m00_couplers_WDATA(31 downto 0),
      S_AXI_wready(0) => xbar_to_m00_couplers_WREADY(0),
      S_AXI_wstrb(3 downto 0) => xbar_to_m00_couplers_WSTRB(3 downto 0),
      S_AXI_wvalid(0) => xbar_to_m00_couplers_WVALID(0)
    );
m01_couplers: entity work.m01_couplers_imp_W1XWRK
     port map (
      M_ACLK => ps7_0_axi_periph_ACLK_net,
      M_ARESETN => ps7_0_axi_periph_ARESETN_net,
      M_AXI_araddr(31 downto 0) => m01_couplers_to_ps7_0_axi_periph_ARADDR(31 downto 0),
      M_AXI_arprot(2 downto 0) => m01_couplers_to_ps7_0_axi_periph_ARPROT(2 downto 0),
      M_AXI_arready => m01_couplers_to_ps7_0_axi_periph_ARREADY,
      M_AXI_arvalid => m01_couplers_to_ps7_0_axi_periph_ARVALID,
      M_AXI_awaddr(31 downto 0) => m01_couplers_to_ps7_0_axi_periph_AWADDR(31 downto 0),
      M_AXI_awprot(2 downto 0) => m01_couplers_to_ps7_0_axi_periph_AWPROT(2 downto 0),
      M_AXI_awready => m01_couplers_to_ps7_0_axi_periph_AWREADY,
      M_AXI_awvalid => m01_couplers_to_ps7_0_axi_periph_AWVALID,
      M_AXI_bready => m01_couplers_to_ps7_0_axi_periph_BREADY,
      M_AXI_bresp(1 downto 0) => m01_couplers_to_ps7_0_axi_periph_BRESP(1 downto 0),
      M_AXI_bvalid => m01_couplers_to_ps7_0_axi_periph_BVALID,
      M_AXI_rdata(31 downto 0) => m01_couplers_to_ps7_0_axi_periph_RDATA(31 downto 0),
      M_AXI_rready => m01_couplers_to_ps7_0_axi_periph_RREADY,
      M_AXI_rresp(1 downto 0) => m01_couplers_to_ps7_0_axi_periph_RRESP(1 downto 0),
      M_AXI_rvalid => m01_couplers_to_ps7_0_axi_periph_RVALID,
      M_AXI_wdata(31 downto 0) => m01_couplers_to_ps7_0_axi_periph_WDATA(31 downto 0),
      M_AXI_wready => m01_couplers_to_ps7_0_axi_periph_WREADY,
      M_AXI_wstrb(3 downto 0) => m01_couplers_to_ps7_0_axi_periph_WSTRB(3 downto 0),
      M_AXI_wvalid => m01_couplers_to_ps7_0_axi_periph_WVALID,
      S_ACLK => ps7_0_axi_periph_ACLK_net,
      S_ARESETN => ps7_0_axi_periph_ARESETN_net,
      S_AXI_araddr(31 downto 0) => xbar_to_m01_couplers_ARADDR(63 downto 32),
      S_AXI_arprot(2 downto 0) => xbar_to_m01_couplers_ARPROT(5 downto 3),
      S_AXI_arready => xbar_to_m01_couplers_ARREADY,
      S_AXI_arvalid => xbar_to_m01_couplers_ARVALID(1),
      S_AXI_awaddr(31 downto 0) => xbar_to_m01_couplers_AWADDR(63 downto 32),
      S_AXI_awprot(2 downto 0) => xbar_to_m01_couplers_AWPROT(5 downto 3),
      S_AXI_awready => xbar_to_m01_couplers_AWREADY,
      S_AXI_awvalid => xbar_to_m01_couplers_AWVALID(1),
      S_AXI_bready => xbar_to_m01_couplers_BREADY(1),
      S_AXI_bresp(1 downto 0) => xbar_to_m01_couplers_BRESP(1 downto 0),
      S_AXI_bvalid => xbar_to_m01_couplers_BVALID,
      S_AXI_rdata(31 downto 0) => xbar_to_m01_couplers_RDATA(31 downto 0),
      S_AXI_rready => xbar_to_m01_couplers_RREADY(1),
      S_AXI_rresp(1 downto 0) => xbar_to_m01_couplers_RRESP(1 downto 0),
      S_AXI_rvalid => xbar_to_m01_couplers_RVALID,
      S_AXI_wdata(31 downto 0) => xbar_to_m01_couplers_WDATA(63 downto 32),
      S_AXI_wready => xbar_to_m01_couplers_WREADY,
      S_AXI_wstrb(3 downto 0) => xbar_to_m01_couplers_WSTRB(7 downto 4),
      S_AXI_wvalid => xbar_to_m01_couplers_WVALID(1)
    );
s00_couplers: entity work.s00_couplers_imp_XU79YR
     port map (
      M_ACLK => ps7_0_axi_periph_ACLK_net,
      M_ARESETN => ps7_0_axi_periph_ARESETN_net,
      M_AXI_araddr(31 downto 0) => s00_couplers_to_xbar_ARADDR(31 downto 0),
      M_AXI_arprot(2 downto 0) => s00_couplers_to_xbar_ARPROT(2 downto 0),
      M_AXI_arready => s00_couplers_to_xbar_ARREADY(0),
      M_AXI_arvalid => s00_couplers_to_xbar_ARVALID,
      M_AXI_awaddr(31 downto 0) => s00_couplers_to_xbar_AWADDR(31 downto 0),
      M_AXI_awprot(2 downto 0) => s00_couplers_to_xbar_AWPROT(2 downto 0),
      M_AXI_awready => s00_couplers_to_xbar_AWREADY(0),
      M_AXI_awvalid => s00_couplers_to_xbar_AWVALID,
      M_AXI_bready => s00_couplers_to_xbar_BREADY,
      M_AXI_bresp(1 downto 0) => s00_couplers_to_xbar_BRESP(1 downto 0),
      M_AXI_bvalid => s00_couplers_to_xbar_BVALID(0),
      M_AXI_rdata(31 downto 0) => s00_couplers_to_xbar_RDATA(31 downto 0),
      M_AXI_rready => s00_couplers_to_xbar_RREADY,
      M_AXI_rresp(1 downto 0) => s00_couplers_to_xbar_RRESP(1 downto 0),
      M_AXI_rvalid => s00_couplers_to_xbar_RVALID(0),
      M_AXI_wdata(31 downto 0) => s00_couplers_to_xbar_WDATA(31 downto 0),
      M_AXI_wready => s00_couplers_to_xbar_WREADY(0),
      M_AXI_wstrb(3 downto 0) => s00_couplers_to_xbar_WSTRB(3 downto 0),
      M_AXI_wvalid => s00_couplers_to_xbar_WVALID,
      S_ACLK => ps7_0_axi_periph_ACLK_net,
      S_ARESETN => ps7_0_axi_periph_ARESETN_net,
      S_AXI_araddr(31 downto 0) => ps7_0_axi_periph_to_s00_couplers_ARADDR(31 downto 0),
      S_AXI_arburst(1 downto 0) => ps7_0_axi_periph_to_s00_couplers_ARBURST(1 downto 0),
      S_AXI_arcache(3 downto 0) => ps7_0_axi_periph_to_s00_couplers_ARCACHE(3 downto 0),
      S_AXI_arid(11 downto 0) => ps7_0_axi_periph_to_s00_couplers_ARID(11 downto 0),
      S_AXI_arlen(3 downto 0) => ps7_0_axi_periph_to_s00_couplers_ARLEN(3 downto 0),
      S_AXI_arlock(1 downto 0) => ps7_0_axi_periph_to_s00_couplers_ARLOCK(1 downto 0),
      S_AXI_arprot(2 downto 0) => ps7_0_axi_periph_to_s00_couplers_ARPROT(2 downto 0),
      S_AXI_arqos(3 downto 0) => ps7_0_axi_periph_to_s00_couplers_ARQOS(3 downto 0),
      S_AXI_arready => ps7_0_axi_periph_to_s00_couplers_ARREADY,
      S_AXI_arsize(2 downto 0) => ps7_0_axi_periph_to_s00_couplers_ARSIZE(2 downto 0),
      S_AXI_arvalid => ps7_0_axi_periph_to_s00_couplers_ARVALID,
      S_AXI_awaddr(31 downto 0) => ps7_0_axi_periph_to_s00_couplers_AWADDR(31 downto 0),
      S_AXI_awburst(1 downto 0) => ps7_0_axi_periph_to_s00_couplers_AWBURST(1 downto 0),
      S_AXI_awcache(3 downto 0) => ps7_0_axi_periph_to_s00_couplers_AWCACHE(3 downto 0),
      S_AXI_awid(11 downto 0) => ps7_0_axi_periph_to_s00_couplers_AWID(11 downto 0),
      S_AXI_awlen(3 downto 0) => ps7_0_axi_periph_to_s00_couplers_AWLEN(3 downto 0),
      S_AXI_awlock(1 downto 0) => ps7_0_axi_periph_to_s00_couplers_AWLOCK(1 downto 0),
      S_AXI_awprot(2 downto 0) => ps7_0_axi_periph_to_s00_couplers_AWPROT(2 downto 0),
      S_AXI_awqos(3 downto 0) => ps7_0_axi_periph_to_s00_couplers_AWQOS(3 downto 0),
      S_AXI_awready => ps7_0_axi_periph_to_s00_couplers_AWREADY,
      S_AXI_awsize(2 downto 0) => ps7_0_axi_periph_to_s00_couplers_AWSIZE(2 downto 0),
      S_AXI_awvalid => ps7_0_axi_periph_to_s00_couplers_AWVALID,
      S_AXI_bid(11 downto 0) => ps7_0_axi_periph_to_s00_couplers_BID(11 downto 0),
      S_AXI_bready => ps7_0_axi_periph_to_s00_couplers_BREADY,
      S_AXI_bresp(1 downto 0) => ps7_0_axi_periph_to_s00_couplers_BRESP(1 downto 0),
      S_AXI_bvalid => ps7_0_axi_periph_to_s00_couplers_BVALID,
      S_AXI_rdata(31 downto 0) => ps7_0_axi_periph_to_s00_couplers_RDATA(31 downto 0),
      S_AXI_rid(11 downto 0) => ps7_0_axi_periph_to_s00_couplers_RID(11 downto 0),
      S_AXI_rlast => ps7_0_axi_periph_to_s00_couplers_RLAST,
      S_AXI_rready => ps7_0_axi_periph_to_s00_couplers_RREADY,
      S_AXI_rresp(1 downto 0) => ps7_0_axi_periph_to_s00_couplers_RRESP(1 downto 0),
      S_AXI_rvalid => ps7_0_axi_periph_to_s00_couplers_RVALID,
      S_AXI_wdata(31 downto 0) => ps7_0_axi_periph_to_s00_couplers_WDATA(31 downto 0),
      S_AXI_wid(11 downto 0) => ps7_0_axi_periph_to_s00_couplers_WID(11 downto 0),
      S_AXI_wlast => ps7_0_axi_periph_to_s00_couplers_WLAST,
      S_AXI_wready => ps7_0_axi_periph_to_s00_couplers_WREADY,
      S_AXI_wstrb(3 downto 0) => ps7_0_axi_periph_to_s00_couplers_WSTRB(3 downto 0),
      S_AXI_wvalid => ps7_0_axi_periph_to_s00_couplers_WVALID
    );
xbar: component MADC_ARTY_Z7_xbar_0
     port map (
      aclk => ps7_0_axi_periph_ACLK_net,
      aresetn => ps7_0_axi_periph_ARESETN_net,
      m_axi_araddr(63 downto 32) => xbar_to_m01_couplers_ARADDR(63 downto 32),
      m_axi_araddr(31 downto 0) => xbar_to_m00_couplers_ARADDR(31 downto 0),
      m_axi_arprot(5 downto 3) => xbar_to_m01_couplers_ARPROT(5 downto 3),
      m_axi_arprot(2 downto 0) => NLW_xbar_m_axi_arprot_UNCONNECTED(2 downto 0),
      m_axi_arready(1) => xbar_to_m01_couplers_ARREADY,
      m_axi_arready(0) => xbar_to_m00_couplers_ARREADY(0),
      m_axi_arvalid(1) => xbar_to_m01_couplers_ARVALID(1),
      m_axi_arvalid(0) => xbar_to_m00_couplers_ARVALID(0),
      m_axi_awaddr(63 downto 32) => xbar_to_m01_couplers_AWADDR(63 downto 32),
      m_axi_awaddr(31 downto 0) => xbar_to_m00_couplers_AWADDR(31 downto 0),
      m_axi_awprot(5 downto 3) => xbar_to_m01_couplers_AWPROT(5 downto 3),
      m_axi_awprot(2 downto 0) => NLW_xbar_m_axi_awprot_UNCONNECTED(2 downto 0),
      m_axi_awready(1) => xbar_to_m01_couplers_AWREADY,
      m_axi_awready(0) => xbar_to_m00_couplers_AWREADY(0),
      m_axi_awvalid(1) => xbar_to_m01_couplers_AWVALID(1),
      m_axi_awvalid(0) => xbar_to_m00_couplers_AWVALID(0),
      m_axi_bready(1) => xbar_to_m01_couplers_BREADY(1),
      m_axi_bready(0) => xbar_to_m00_couplers_BREADY(0),
      m_axi_bresp(3 downto 2) => xbar_to_m01_couplers_BRESP(1 downto 0),
      m_axi_bresp(1 downto 0) => xbar_to_m00_couplers_BRESP(1 downto 0),
      m_axi_bvalid(1) => xbar_to_m01_couplers_BVALID,
      m_axi_bvalid(0) => xbar_to_m00_couplers_BVALID(0),
      m_axi_rdata(63 downto 32) => xbar_to_m01_couplers_RDATA(31 downto 0),
      m_axi_rdata(31 downto 0) => xbar_to_m00_couplers_RDATA(31 downto 0),
      m_axi_rready(1) => xbar_to_m01_couplers_RREADY(1),
      m_axi_rready(0) => xbar_to_m00_couplers_RREADY(0),
      m_axi_rresp(3 downto 2) => xbar_to_m01_couplers_RRESP(1 downto 0),
      m_axi_rresp(1 downto 0) => xbar_to_m00_couplers_RRESP(1 downto 0),
      m_axi_rvalid(1) => xbar_to_m01_couplers_RVALID,
      m_axi_rvalid(0) => xbar_to_m00_couplers_RVALID(0),
      m_axi_wdata(63 downto 32) => xbar_to_m01_couplers_WDATA(63 downto 32),
      m_axi_wdata(31 downto 0) => xbar_to_m00_couplers_WDATA(31 downto 0),
      m_axi_wready(1) => xbar_to_m01_couplers_WREADY,
      m_axi_wready(0) => xbar_to_m00_couplers_WREADY(0),
      m_axi_wstrb(7 downto 4) => xbar_to_m01_couplers_WSTRB(7 downto 4),
      m_axi_wstrb(3 downto 0) => xbar_to_m00_couplers_WSTRB(3 downto 0),
      m_axi_wvalid(1) => xbar_to_m01_couplers_WVALID(1),
      m_axi_wvalid(0) => xbar_to_m00_couplers_WVALID(0),
      s_axi_araddr(31 downto 0) => s00_couplers_to_xbar_ARADDR(31 downto 0),
      s_axi_arprot(2 downto 0) => s00_couplers_to_xbar_ARPROT(2 downto 0),
      s_axi_arready(0) => s00_couplers_to_xbar_ARREADY(0),
      s_axi_arvalid(0) => s00_couplers_to_xbar_ARVALID,
      s_axi_awaddr(31 downto 0) => s00_couplers_to_xbar_AWADDR(31 downto 0),
      s_axi_awprot(2 downto 0) => s00_couplers_to_xbar_AWPROT(2 downto 0),
      s_axi_awready(0) => s00_couplers_to_xbar_AWREADY(0),
      s_axi_awvalid(0) => s00_couplers_to_xbar_AWVALID,
      s_axi_bready(0) => s00_couplers_to_xbar_BREADY,
      s_axi_bresp(1 downto 0) => s00_couplers_to_xbar_BRESP(1 downto 0),
      s_axi_bvalid(0) => s00_couplers_to_xbar_BVALID(0),
      s_axi_rdata(31 downto 0) => s00_couplers_to_xbar_RDATA(31 downto 0),
      s_axi_rready(0) => s00_couplers_to_xbar_RREADY,
      s_axi_rresp(1 downto 0) => s00_couplers_to_xbar_RRESP(1 downto 0),
      s_axi_rvalid(0) => s00_couplers_to_xbar_RVALID(0),
      s_axi_wdata(31 downto 0) => s00_couplers_to_xbar_WDATA(31 downto 0),
      s_axi_wready(0) => s00_couplers_to_xbar_WREADY(0),
      s_axi_wstrb(3 downto 0) => s00_couplers_to_xbar_WSTRB(3 downto 0),
      s_axi_wvalid(0) => s00_couplers_to_xbar_WVALID
    );
end STRUCTURE;
library IEEE;
use IEEE.STD_LOGIC_1164.ALL;
library UNISIM;
use UNISIM.VCOMPONENTS.ALL;
entity MADC_ARTY_Z7 is
  port (
    DDR_addr : inout STD_LOGIC_VECTOR ( 14 downto 0 );
    DDR_ba : inout STD_LOGIC_VECTOR ( 2 downto 0 );
    DDR_cas_n : inout STD_LOGIC;
    DDR_ck_n : inout STD_LOGIC;
    DDR_ck_p : inout STD_LOGIC;
    DDR_cke : inout STD_LOGIC;
    DDR_cs_n : inout STD_LOGIC;
    DDR_dm : inout STD_LOGIC_VECTOR ( 3 downto 0 );
    DDR_dq : inout STD_LOGIC_VECTOR ( 31 downto 0 );
    DDR_dqs_n : inout STD_LOGIC_VECTOR ( 3 downto 0 );
    DDR_dqs_p : inout STD_LOGIC_VECTOR ( 3 downto 0 );
    DDR_odt : inout STD_LOGIC;
    DDR_ras_n : inout STD_LOGIC;
    DDR_reset_n : inout STD_LOGIC;
    DDR_we_n : inout STD_LOGIC;
    FIXED_IO_ddr_vrn : inout STD_LOGIC;
    FIXED_IO_ddr_vrp : inout STD_LOGIC;
    FIXED_IO_mio : inout STD_LOGIC_VECTOR ( 53 downto 0 );
    FIXED_IO_ps_clk : inout STD_LOGIC;
    FIXED_IO_ps_porb : inout STD_LOGIC;
    FIXED_IO_ps_srstb : inout STD_LOGIC;
    ad_cmp : in STD_LOGIC;
    ad_id : out STD_LOGIC;
    ad_iin : out STD_LOGIC;
    ad_irn : out STD_LOGIC;
    ad_irp : out STD_LOGIC;
    ctr_4bits_tri_o : out STD_LOGIC_VECTOR ( 3 downto 0 );
    leds_4bits_tri_o : out STD_LOGIC_VECTOR ( 3 downto 0 );
    sw_vrh : out STD_LOGIC
  );
  attribute CORE_GENERATION_INFO : string;
  attribute CORE_GENERATION_INFO of MADC_ARTY_Z7 : entity is "MADC_ARTY_Z7,IP_Integrator,{x_ipVendor=xilinx.com,x_ipLibrary=BlockDiagram,x_ipName=MADC_ARTY_Z7,x_ipVersion=1.00.a,x_ipLanguage=VHDL,numBlks=10,numReposBlks=6,numNonXlnxBlks=1,numHierBlks=4,maxHierDepth=0,numSysgenBlks=0,numHlsBlks=0,numHdlrefBlks=0,numPkgbdBlks=0,bdsource=USER,da_axi4_cnt=2,da_board_cnt=2,da_ps7_cnt=1,synth_mode=Hierarchical}";
  attribute HW_HANDOFF : string;
  attribute HW_HANDOFF of MADC_ARTY_Z7 : entity is "MADC_ARTY_Z7.hwdef";
end MADC_ARTY_Z7;

architecture STRUCTURE of MADC_ARTY_Z7 is
  component MADC_ARTY_Z7_processing_system7_0_0 is
  port (
    USB0_PORT_INDCTL : out STD_LOGIC_VECTOR ( 1 downto 0 );
    USB0_VBUS_PWRSELECT : out STD_LOGIC;
    USB0_VBUS_PWRFAULT : in STD_LOGIC;
    M_AXI_GP0_ARVALID : out STD_LOGIC;
    M_AXI_GP0_AWVALID : out STD_LOGIC;
    M_AXI_GP0_BREADY : out STD_LOGIC;
    M_AXI_GP0_RREADY : out STD_LOGIC;
    M_AXI_GP0_WLAST : out STD_LOGIC;
    M_AXI_GP0_WVALID : out STD_LOGIC;
    M_AXI_GP0_ARID : out STD_LOGIC_VECTOR ( 11 downto 0 );
    M_AXI_GP0_AWID : out STD_LOGIC_VECTOR ( 11 downto 0 );
    M_AXI_GP0_WID : out STD_LOGIC_VECTOR ( 11 downto 0 );
    M_AXI_GP0_ARBURST : out STD_LOGIC_VECTOR ( 1 downto 0 );
    M_AXI_GP0_ARLOCK : out STD_LOGIC_VECTOR ( 1 downto 0 );
    M_AXI_GP0_ARSIZE : out STD_LOGIC_VECTOR ( 2 downto 0 );
    M_AXI_GP0_AWBURST : out STD_LOGIC_VECTOR ( 1 downto 0 );
    M_AXI_GP0_AWLOCK : out STD_LOGIC_VECTOR ( 1 downto 0 );
    M_AXI_GP0_AWSIZE : out STD_LOGIC_VECTOR ( 2 downto 0 );
    M_AXI_GP0_ARPROT : out STD_LOGIC_VECTOR ( 2 downto 0 );
    M_AXI_GP0_AWPROT : out STD_LOGIC_VECTOR ( 2 downto 0 );
    M_AXI_GP0_ARADDR : out STD_LOGIC_VECTOR ( 31 downto 0 );
    M_AXI_GP0_AWADDR : out STD_LOGIC_VECTOR ( 31 downto 0 );
    M_AXI_GP0_WDATA : out STD_LOGIC_VECTOR ( 31 downto 0 );
    M_AXI_GP0_ARCACHE : out STD_LOGIC_VECTOR ( 3 downto 0 );
    M_AXI_GP0_ARLEN : out STD_LOGIC_VECTOR ( 3 downto 0 );
    M_AXI_GP0_ARQOS : out STD_LOGIC_VECTOR ( 3 downto 0 );
    M_AXI_GP0_AWCACHE : out STD_LOGIC_VECTOR ( 3 downto 0 );
    M_AXI_GP0_AWLEN : out STD_LOGIC_VECTOR ( 3 downto 0 );
    M_AXI_GP0_AWQOS : out STD_LOGIC_VECTOR ( 3 downto 0 );
    M_AXI_GP0_WSTRB : out STD_LOGIC_VECTOR ( 3 downto 0 );
    M_AXI_GP0_ACLK : in STD_LOGIC;
    M_AXI_GP0_ARREADY : in STD_LOGIC;
    M_AXI_GP0_AWREADY : in STD_LOGIC;
    M_AXI_GP0_BVALID : in STD_LOGIC;
    M_AXI_GP0_RLAST : in STD_LOGIC;
    M_AXI_GP0_RVALID : in STD_LOGIC;
    M_AXI_GP0_WREADY : in STD_LOGIC;
    M_AXI_GP0_BID : in STD_LOGIC_VECTOR ( 11 downto 0 );
    M_AXI_GP0_RID : in STD_LOGIC_VECTOR ( 11 downto 0 );
    M_AXI_GP0_BRESP : in STD_LOGIC_VECTOR ( 1 downto 0 );
    M_AXI_GP0_RRESP : in STD_LOGIC_VECTOR ( 1 downto 0 );
    M_AXI_GP0_RDATA : in STD_LOGIC_VECTOR ( 31 downto 0 );
    FCLK_CLK0 : out STD_LOGIC;
    FCLK_RESET0_N : out STD_LOGIC;
    MIO : inout STD_LOGIC_VECTOR ( 53 downto 0 );
    DDR_CAS_n : inout STD_LOGIC;
    DDR_CKE : inout STD_LOGIC;
    DDR_Clk_n : inout STD_LOGIC;
    DDR_Clk : inout STD_LOGIC;
    DDR_CS_n : inout STD_LOGIC;
    DDR_DRSTB : inout STD_LOGIC;
    DDR_ODT : inout STD_LOGIC;
    DDR_RAS_n : inout STD_LOGIC;
    DDR_WEB : inout STD_LOGIC;
    DDR_BankAddr : inout STD_LOGIC_VECTOR ( 2 downto 0 );
    DDR_Addr : inout STD_LOGIC_VECTOR ( 14 downto 0 );
    DDR_VRN : inout STD_LOGIC;
    DDR_VRP : inout STD_LOGIC;
    DDR_DM : inout STD_LOGIC_VECTOR ( 3 downto 0 );
    DDR_DQ : inout STD_LOGIC_VECTOR ( 31 downto 0 );
    DDR_DQS_n : inout STD_LOGIC_VECTOR ( 3 downto 0 );
    DDR_DQS : inout STD_LOGIC_VECTOR ( 3 downto 0 );
    PS_SRSTB : inout STD_LOGIC;
    PS_CLK : inout STD_LOGIC;
    PS_PORB : inout STD_LOGIC
  );
  end component MADC_ARTY_Z7_processing_system7_0_0;
  component MADC_ARTY_Z7_axi_gpio_0_0 is
  port (
    s_axi_aclk : in STD_LOGIC;
    s_axi_aresetn : in STD_LOGIC;
    s_axi_awaddr : in STD_LOGIC_VECTOR ( 8 downto 0 );
    s_axi_awvalid : in STD_LOGIC;
    s_axi_awready : out STD_LOGIC;
    s_axi_wdata : in STD_LOGIC_VECTOR ( 31 downto 0 );
    s_axi_wstrb : in STD_LOGIC_VECTOR ( 3 downto 0 );
    s_axi_wvalid : in STD_LOGIC;
    s_axi_wready : out STD_LOGIC;
    s_axi_bresp : out STD_LOGIC_VECTOR ( 1 downto 0 );
    s_axi_bvalid : out STD_LOGIC;
    s_axi_bready : in STD_LOGIC;
    s_axi_araddr : in STD_LOGIC_VECTOR ( 8 downto 0 );
    s_axi_arvalid : in STD_LOGIC;
    s_axi_arready : out STD_LOGIC;
    s_axi_rdata : out STD_LOGIC_VECTOR ( 31 downto 0 );
    s_axi_rresp : out STD_LOGIC_VECTOR ( 1 downto 0 );
    s_axi_rvalid : out STD_LOGIC;
    s_axi_rready : in STD_LOGIC;
    gpio_io_o : out STD_LOGIC_VECTOR ( 3 downto 0 );
    gpio2_io_o : out STD_LOGIC_VECTOR ( 3 downto 0 )
  );
  end component MADC_ARTY_Z7_axi_gpio_0_0;
  component MADC_ARTY_Z7_rst_ps7_0_100M_0 is
  port (
    slowest_sync_clk : in STD_LOGIC;
    ext_reset_in : in STD_LOGIC;
    aux_reset_in : in STD_LOGIC;
    mb_debug_sys_rst : in STD_LOGIC;
    dcm_locked : in STD_LOGIC;
    mb_reset : out STD_LOGIC;
    bus_struct_reset : out STD_LOGIC_VECTOR ( 0 to 0 );
    peripheral_reset : out STD_LOGIC_VECTOR ( 0 to 0 );
    interconnect_aresetn : out STD_LOGIC_VECTOR ( 0 to 0 );
    peripheral_aresetn : out STD_LOGIC_VECTOR ( 0 to 0 )
  );
  end component MADC_ARTY_Z7_rst_ps7_0_100M_0;
  component MADC_ARTY_Z7_MADC_0_0 is
  port (
    ad_iin : out STD_LOGIC;
    ad_irn : out STD_LOGIC;
    ad_irp : out STD_LOGIC;
    sw_vrh : out STD_LOGIC;
    ad_id : out STD_LOGIC;
    ad_cmp : in STD_LOGIC;
    s00_axi_aclk : in STD_LOGIC;
    s00_axi_aresetn : in STD_LOGIC;
    s00_axi_awaddr : in STD_LOGIC_VECTOR ( 7 downto 0 );
    s00_axi_awprot : in STD_LOGIC_VECTOR ( 2 downto 0 );
    s00_axi_awvalid : in STD_LOGIC;
    s00_axi_awready : out STD_LOGIC;
    s00_axi_wdata : in STD_LOGIC_VECTOR ( 31 downto 0 );
    s00_axi_wstrb : in STD_LOGIC_VECTOR ( 3 downto 0 );
    s00_axi_wvalid : in STD_LOGIC;
    s00_axi_wready : out STD_LOGIC;
    s00_axi_bresp : out STD_LOGIC_VECTOR ( 1 downto 0 );
    s00_axi_bvalid : out STD_LOGIC;
    s00_axi_bready : in STD_LOGIC;
    s00_axi_araddr : in STD_LOGIC_VECTOR ( 7 downto 0 );
    s00_axi_arprot : in STD_LOGIC_VECTOR ( 2 downto 0 );
    s00_axi_arvalid : in STD_LOGIC;
    s00_axi_arready : out STD_LOGIC;
    s00_axi_rdata : out STD_LOGIC_VECTOR ( 31 downto 0 );
    s00_axi_rresp : out STD_LOGIC_VECTOR ( 1 downto 0 );
    s00_axi_rvalid : out STD_LOGIC;
    s00_axi_rready : in STD_LOGIC
  );
  end component MADC_ARTY_Z7_MADC_0_0;
  signal MADC_0_ad_id : STD_LOGIC;
  signal MADC_0_ad_iin : STD_LOGIC;
  signal MADC_0_ad_irn : STD_LOGIC;
  signal MADC_0_ad_irp : STD_LOGIC;
  signal MADC_0_sw_vrh : STD_LOGIC;
  signal ad_cmp_1 : STD_LOGIC;
  signal axi_gpio_0_GPIO2_TRI_O : STD_LOGIC_VECTOR ( 3 downto 0 );
  signal axi_gpio_0_GPIO_TRI_O : STD_LOGIC_VECTOR ( 3 downto 0 );
  signal processing_system7_0_DDR_ADDR : STD_LOGIC_VECTOR ( 14 downto 0 );
  signal processing_system7_0_DDR_BA : STD_LOGIC_VECTOR ( 2 downto 0 );
  signal processing_system7_0_DDR_CAS_N : STD_LOGIC;
  signal processing_system7_0_DDR_CKE : STD_LOGIC;
  signal processing_system7_0_DDR_CK_N : STD_LOGIC;
  signal processing_system7_0_DDR_CK_P : STD_LOGIC;
  signal processing_system7_0_DDR_CS_N : STD_LOGIC;
  signal processing_system7_0_DDR_DM : STD_LOGIC_VECTOR ( 3 downto 0 );
  signal processing_system7_0_DDR_DQ : STD_LOGIC_VECTOR ( 31 downto 0 );
  signal processing_system7_0_DDR_DQS_N : STD_LOGIC_VECTOR ( 3 downto 0 );
  signal processing_system7_0_DDR_DQS_P : STD_LOGIC_VECTOR ( 3 downto 0 );
  signal processing_system7_0_DDR_ODT : STD_LOGIC;
  signal processing_system7_0_DDR_RAS_N : STD_LOGIC;
  signal processing_system7_0_DDR_RESET_N : STD_LOGIC;
  signal processing_system7_0_DDR_WE_N : STD_LOGIC;
  signal processing_system7_0_FCLK_CLK0 : STD_LOGIC;
  signal processing_system7_0_FCLK_RESET0_N : STD_LOGIC;
  signal processing_system7_0_FIXED_IO_DDR_VRN : STD_LOGIC;
  signal processing_system7_0_FIXED_IO_DDR_VRP : STD_LOGIC;
  signal processing_system7_0_FIXED_IO_MIO : STD_LOGIC_VECTOR ( 53 downto 0 );
  signal processing_system7_0_FIXED_IO_PS_CLK : STD_LOGIC;
  signal processing_system7_0_FIXED_IO_PS_PORB : STD_LOGIC;
  signal processing_system7_0_FIXED_IO_PS_SRSTB : STD_LOGIC;
  signal processing_system7_0_M_AXI_GP0_ARADDR : STD_LOGIC_VECTOR ( 31 downto 0 );
  signal processing_system7_0_M_AXI_GP0_ARBURST : STD_LOGIC_VECTOR ( 1 downto 0 );
  signal processing_system7_0_M_AXI_GP0_ARCACHE : STD_LOGIC_VECTOR ( 3 downto 0 );
  signal processing_system7_0_M_AXI_GP0_ARID : STD_LOGIC_VECTOR ( 11 downto 0 );
  signal processing_system7_0_M_AXI_GP0_ARLEN : STD_LOGIC_VECTOR ( 3 downto 0 );
  signal processing_system7_0_M_AXI_GP0_ARLOCK : STD_LOGIC_VECTOR ( 1 downto 0 );
  signal processing_system7_0_M_AXI_GP0_ARPROT : STD_LOGIC_VECTOR ( 2 downto 0 );
  signal processing_system7_0_M_AXI_GP0_ARQOS : STD_LOGIC_VECTOR ( 3 downto 0 );
  signal processing_system7_0_M_AXI_GP0_ARREADY : STD_LOGIC;
  signal processing_system7_0_M_AXI_GP0_ARSIZE : STD_LOGIC_VECTOR ( 2 downto 0 );
  signal processing_system7_0_M_AXI_GP0_ARVALID : STD_LOGIC;
  signal processing_system7_0_M_AXI_GP0_AWADDR : STD_LOGIC_VECTOR ( 31 downto 0 );
  signal processing_system7_0_M_AXI_GP0_AWBURST : STD_LOGIC_VECTOR ( 1 downto 0 );
  signal processing_system7_0_M_AXI_GP0_AWCACHE : STD_LOGIC_VECTOR ( 3 downto 0 );
  signal processing_system7_0_M_AXI_GP0_AWID : STD_LOGIC_VECTOR ( 11 downto 0 );
  signal processing_system7_0_M_AXI_GP0_AWLEN : STD_LOGIC_VECTOR ( 3 downto 0 );
  signal processing_system7_0_M_AXI_GP0_AWLOCK : STD_LOGIC_VECTOR ( 1 downto 0 );
  signal processing_system7_0_M_AXI_GP0_AWPROT : STD_LOGIC_VECTOR ( 2 downto 0 );
  signal processing_system7_0_M_AXI_GP0_AWQOS : STD_LOGIC_VECTOR ( 3 downto 0 );
  signal processing_system7_0_M_AXI_GP0_AWREADY : STD_LOGIC;
  signal processing_system7_0_M_AXI_GP0_AWSIZE : STD_LOGIC_VECTOR ( 2 downto 0 );
  signal processing_system7_0_M_AXI_GP0_AWVALID : STD_LOGIC;
  signal processing_system7_0_M_AXI_GP0_BID : STD_LOGIC_VECTOR ( 11 downto 0 );
  signal processing_system7_0_M_AXI_GP0_BREADY : STD_LOGIC;
  signal processing_system7_0_M_AXI_GP0_BRESP : STD_LOGIC_VECTOR ( 1 downto 0 );
  signal processing_system7_0_M_AXI_GP0_BVALID : STD_LOGIC;
  signal processing_system7_0_M_AXI_GP0_RDATA : STD_LOGIC_VECTOR ( 31 downto 0 );
  signal processing_system7_0_M_AXI_GP0_RID : STD_LOGIC_VECTOR ( 11 downto 0 );
  signal processing_system7_0_M_AXI_GP0_RLAST : STD_LOGIC;
  signal processing_system7_0_M_AXI_GP0_RREADY : STD_LOGIC;
  signal processing_system7_0_M_AXI_GP0_RRESP : STD_LOGIC_VECTOR ( 1 downto 0 );
  signal processing_system7_0_M_AXI_GP0_RVALID : STD_LOGIC;
  signal processing_system7_0_M_AXI_GP0_WDATA : STD_LOGIC_VECTOR ( 31 downto 0 );
  signal processing_system7_0_M_AXI_GP0_WID : STD_LOGIC_VECTOR ( 11 downto 0 );
  signal processing_system7_0_M_AXI_GP0_WLAST : STD_LOGIC;
  signal processing_system7_0_M_AXI_GP0_WREADY : STD_LOGIC;
  signal processing_system7_0_M_AXI_GP0_WSTRB : STD_LOGIC_VECTOR ( 3 downto 0 );
  signal processing_system7_0_M_AXI_GP0_WVALID : STD_LOGIC;
  signal ps7_0_axi_periph_M00_AXI_ARADDR : STD_LOGIC_VECTOR ( 31 downto 0 );
  signal ps7_0_axi_periph_M00_AXI_ARREADY : STD_LOGIC;
  signal ps7_0_axi_periph_M00_AXI_ARVALID : STD_LOGIC_VECTOR ( 0 to 0 );
  signal ps7_0_axi_periph_M00_AXI_AWADDR : STD_LOGIC_VECTOR ( 31 downto 0 );
  signal ps7_0_axi_periph_M00_AXI_AWREADY : STD_LOGIC;
  signal ps7_0_axi_periph_M00_AXI_AWVALID : STD_LOGIC_VECTOR ( 0 to 0 );
  signal ps7_0_axi_periph_M00_AXI_BREADY : STD_LOGIC_VECTOR ( 0 to 0 );
  signal ps7_0_axi_periph_M00_AXI_BRESP : STD_LOGIC_VECTOR ( 1 downto 0 );
  signal ps7_0_axi_periph_M00_AXI_BVALID : STD_LOGIC;
  signal ps7_0_axi_periph_M00_AXI_RDATA : STD_LOGIC_VECTOR ( 31 downto 0 );
  signal ps7_0_axi_periph_M00_AXI_RREADY : STD_LOGIC_VECTOR ( 0 to 0 );
  signal ps7_0_axi_periph_M00_AXI_RRESP : STD_LOGIC_VECTOR ( 1 downto 0 );
  signal ps7_0_axi_periph_M00_AXI_RVALID : STD_LOGIC;
  signal ps7_0_axi_periph_M00_AXI_WDATA : STD_LOGIC_VECTOR ( 31 downto 0 );
  signal ps7_0_axi_periph_M00_AXI_WREADY : STD_LOGIC;
  signal ps7_0_axi_periph_M00_AXI_WSTRB : STD_LOGIC_VECTOR ( 3 downto 0 );
  signal ps7_0_axi_periph_M00_AXI_WVALID : STD_LOGIC_VECTOR ( 0 to 0 );
  signal ps7_0_axi_periph_M01_AXI_ARADDR : STD_LOGIC_VECTOR ( 31 downto 0 );
  signal ps7_0_axi_periph_M01_AXI_ARPROT : STD_LOGIC_VECTOR ( 2 downto 0 );
  signal ps7_0_axi_periph_M01_AXI_ARREADY : STD_LOGIC;
  signal ps7_0_axi_periph_M01_AXI_ARVALID : STD_LOGIC;
  signal ps7_0_axi_periph_M01_AXI_AWADDR : STD_LOGIC_VECTOR ( 31 downto 0 );
  signal ps7_0_axi_periph_M01_AXI_AWPROT : STD_LOGIC_VECTOR ( 2 downto 0 );
  signal ps7_0_axi_periph_M01_AXI_AWREADY : STD_LOGIC;
  signal ps7_0_axi_periph_M01_AXI_AWVALID : STD_LOGIC;
  signal ps7_0_axi_periph_M01_AXI_BREADY : STD_LOGIC;
  signal ps7_0_axi_periph_M01_AXI_BRESP : STD_LOGIC_VECTOR ( 1 downto 0 );
  signal ps7_0_axi_periph_M01_AXI_BVALID : STD_LOGIC;
  signal ps7_0_axi_periph_M01_AXI_RDATA : STD_LOGIC_VECTOR ( 31 downto 0 );
  signal ps7_0_axi_periph_M01_AXI_RREADY : STD_LOGIC;
  signal ps7_0_axi_periph_M01_AXI_RRESP : STD_LOGIC_VECTOR ( 1 downto 0 );
  signal ps7_0_axi_periph_M01_AXI_RVALID : STD_LOGIC;
  signal ps7_0_axi_periph_M01_AXI_WDATA : STD_LOGIC_VECTOR ( 31 downto 0 );
  signal ps7_0_axi_periph_M01_AXI_WREADY : STD_LOGIC;
  signal ps7_0_axi_periph_M01_AXI_WSTRB : STD_LOGIC_VECTOR ( 3 downto 0 );
  signal ps7_0_axi_periph_M01_AXI_WVALID : STD_LOGIC;
  signal rst_ps7_0_100M_peripheral_aresetn : STD_LOGIC_VECTOR ( 0 to 0 );
  signal NLW_processing_system7_0_USB0_VBUS_PWRSELECT_UNCONNECTED : STD_LOGIC;
  signal NLW_processing_system7_0_USB0_PORT_INDCTL_UNCONNECTED : STD_LOGIC_VECTOR ( 1 downto 0 );
  signal NLW_rst_ps7_0_100M_mb_reset_UNCONNECTED : STD_LOGIC;
  signal NLW_rst_ps7_0_100M_bus_struct_reset_UNCONNECTED : STD_LOGIC_VECTOR ( 0 to 0 );
  signal NLW_rst_ps7_0_100M_interconnect_aresetn_UNCONNECTED : STD_LOGIC_VECTOR ( 0 to 0 );
  signal NLW_rst_ps7_0_100M_peripheral_reset_UNCONNECTED : STD_LOGIC_VECTOR ( 0 to 0 );
  attribute X_INTERFACE_INFO : string;
  attribute X_INTERFACE_INFO of DDR_cas_n : signal is "xilinx.com:interface:ddrx:1.0 DDR CAS_N";
  attribute X_INTERFACE_INFO of DDR_ck_n : signal is "xilinx.com:interface:ddrx:1.0 DDR CK_N";
  attribute X_INTERFACE_INFO of DDR_ck_p : signal is "xilinx.com:interface:ddrx:1.0 DDR CK_P";
  attribute X_INTERFACE_INFO of DDR_cke : signal is "xilinx.com:interface:ddrx:1.0 DDR CKE";
  attribute X_INTERFACE_INFO of DDR_cs_n : signal is "xilinx.com:interface:ddrx:1.0 DDR CS_N";
  attribute X_INTERFACE_INFO of DDR_odt : signal is "xilinx.com:interface:ddrx:1.0 DDR ODT";
  attribute X_INTERFACE_INFO of DDR_ras_n : signal is "xilinx.com:interface:ddrx:1.0 DDR RAS_N";
  attribute X_INTERFACE_INFO of DDR_reset_n : signal is "xilinx.com:interface:ddrx:1.0 DDR RESET_N";
  attribute X_INTERFACE_INFO of DDR_we_n : signal is "xilinx.com:interface:ddrx:1.0 DDR WE_N";
  attribute X_INTERFACE_INFO of FIXED_IO_ddr_vrn : signal is "xilinx.com:display_processing_system7:fixedio:1.0 FIXED_IO DDR_VRN";
  attribute X_INTERFACE_PARAMETER : string;
  attribute X_INTERFACE_PARAMETER of FIXED_IO_ddr_vrn : signal is "XIL_INTERFACENAME FIXED_IO, CAN_DEBUG false";
  attribute X_INTERFACE_INFO of FIXED_IO_ddr_vrp : signal is "xilinx.com:display_processing_system7:fixedio:1.0 FIXED_IO DDR_VRP";
  attribute X_INTERFACE_INFO of FIXED_IO_ps_clk : signal is "xilinx.com:display_processing_system7:fixedio:1.0 FIXED_IO PS_CLK";
  attribute X_INTERFACE_INFO of FIXED_IO_ps_porb : signal is "xilinx.com:display_processing_system7:fixedio:1.0 FIXED_IO PS_PORB";
  attribute X_INTERFACE_INFO of FIXED_IO_ps_srstb : signal is "xilinx.com:display_processing_system7:fixedio:1.0 FIXED_IO PS_SRSTB";
  attribute X_INTERFACE_INFO of DDR_addr : signal is "xilinx.com:interface:ddrx:1.0 DDR ADDR";
  attribute X_INTERFACE_PARAMETER of DDR_addr : signal is "XIL_INTERFACENAME DDR, AXI_ARBITRATION_SCHEME TDM, BURST_LENGTH 8, CAN_DEBUG false, CAS_LATENCY 11, CAS_WRITE_LATENCY 11, CS_ENABLED true, DATA_MASK_ENABLED true, DATA_WIDTH 8, MEMORY_TYPE COMPONENTS, MEM_ADDR_MAP ROW_COLUMN_BANK, SLOT Single, TIMEPERIOD_PS 1250";
  attribute X_INTERFACE_INFO of DDR_ba : signal is "xilinx.com:interface:ddrx:1.0 DDR BA";
  attribute X_INTERFACE_INFO of DDR_dm : signal is "xilinx.com:interface:ddrx:1.0 DDR DM";
  attribute X_INTERFACE_INFO of DDR_dq : signal is "xilinx.com:interface:ddrx:1.0 DDR DQ";
  attribute X_INTERFACE_INFO of DDR_dqs_n : signal is "xilinx.com:interface:ddrx:1.0 DDR DQS_N";
  attribute X_INTERFACE_INFO of DDR_dqs_p : signal is "xilinx.com:interface:ddrx:1.0 DDR DQS_P";
  attribute X_INTERFACE_INFO of FIXED_IO_mio : signal is "xilinx.com:display_processing_system7:fixedio:1.0 FIXED_IO MIO";
  attribute X_INTERFACE_INFO of ctr_4bits_tri_o : signal is "xilinx.com:interface:gpio:1.0 ctr_4bits TRI_O";
  attribute X_INTERFACE_INFO of leds_4bits_tri_o : signal is "xilinx.com:interface:gpio:1.0 leds_4bits TRI_O";
begin
  ad_cmp_1 <= ad_cmp;
  ad_id <= MADC_0_ad_id;
  ad_iin <= MADC_0_ad_iin;
  ad_irn <= MADC_0_ad_irn;
  ad_irp <= MADC_0_ad_irp;
  ctr_4bits_tri_o(3 downto 0) <= axi_gpio_0_GPIO2_TRI_O(3 downto 0);
  leds_4bits_tri_o(3 downto 0) <= axi_gpio_0_GPIO_TRI_O(3 downto 0);
  sw_vrh <= MADC_0_sw_vrh;
MADC_0: component MADC_ARTY_Z7_MADC_0_0
     port map (
      ad_cmp => ad_cmp_1,
      ad_id => MADC_0_ad_id,
      ad_iin => MADC_0_ad_iin,
      ad_irn => MADC_0_ad_irn,
      ad_irp => MADC_0_ad_irp,
      s00_axi_aclk => processing_system7_0_FCLK_CLK0,
      s00_axi_araddr(7 downto 0) => ps7_0_axi_periph_M01_AXI_ARADDR(7 downto 0),
      s00_axi_aresetn => rst_ps7_0_100M_peripheral_aresetn(0),
      s00_axi_arprot(2 downto 0) => ps7_0_axi_periph_M01_AXI_ARPROT(2 downto 0),
      s00_axi_arready => ps7_0_axi_periph_M01_AXI_ARREADY,
      s00_axi_arvalid => ps7_0_axi_periph_M01_AXI_ARVALID,
      s00_axi_awaddr(7 downto 0) => ps7_0_axi_periph_M01_AXI_AWADDR(7 downto 0),
      s00_axi_awprot(2 downto 0) => ps7_0_axi_periph_M01_AXI_AWPROT(2 downto 0),
      s00_axi_awready => ps7_0_axi_periph_M01_AXI_AWREADY,
      s00_axi_awvalid => ps7_0_axi_periph_M01_AXI_AWVALID,
      s00_axi_bready => ps7_0_axi_periph_M01_AXI_BREADY,
      s00_axi_bresp(1 downto 0) => ps7_0_axi_periph_M01_AXI_BRESP(1 downto 0),
      s00_axi_bvalid => ps7_0_axi_periph_M01_AXI_BVALID,
      s00_axi_rdata(31 downto 0) => ps7_0_axi_periph_M01_AXI_RDATA(31 downto 0),
      s00_axi_rready => ps7_0_axi_periph_M01_AXI_RREADY,
      s00_axi_rresp(1 downto 0) => ps7_0_axi_periph_M01_AXI_RRESP(1 downto 0),
      s00_axi_rvalid => ps7_0_axi_periph_M01_AXI_RVALID,
      s00_axi_wdata(31 downto 0) => ps7_0_axi_periph_M01_AXI_WDATA(31 downto 0),
      s00_axi_wready => ps7_0_axi_periph_M01_AXI_WREADY,
      s00_axi_wstrb(3 downto 0) => ps7_0_axi_periph_M01_AXI_WSTRB(3 downto 0),
      s00_axi_wvalid => ps7_0_axi_periph_M01_AXI_WVALID,
      sw_vrh => MADC_0_sw_vrh
    );
axi_gpio_0: component MADC_ARTY_Z7_axi_gpio_0_0
     port map (
      gpio2_io_o(3 downto 0) => axi_gpio_0_GPIO2_TRI_O(3 downto 0),
      gpio_io_o(3 downto 0) => axi_gpio_0_GPIO_TRI_O(3 downto 0),
      s_axi_aclk => processing_system7_0_FCLK_CLK0,
      s_axi_araddr(8 downto 0) => ps7_0_axi_periph_M00_AXI_ARADDR(8 downto 0),
      s_axi_aresetn => rst_ps7_0_100M_peripheral_aresetn(0),
      s_axi_arready => ps7_0_axi_periph_M00_AXI_ARREADY,
      s_axi_arvalid => ps7_0_axi_periph_M00_AXI_ARVALID(0),
      s_axi_awaddr(8 downto 0) => ps7_0_axi_periph_M00_AXI_AWADDR(8 downto 0),
      s_axi_awready => ps7_0_axi_periph_M00_AXI_AWREADY,
      s_axi_awvalid => ps7_0_axi_periph_M00_AXI_AWVALID(0),
      s_axi_bready => ps7_0_axi_periph_M00_AXI_BREADY(0),
      s_axi_bresp(1 downto 0) => ps7_0_axi_periph_M00_AXI_BRESP(1 downto 0),
      s_axi_bvalid => ps7_0_axi_periph_M00_AXI_BVALID,
      s_axi_rdata(31 downto 0) => ps7_0_axi_periph_M00_AXI_RDATA(31 downto 0),
      s_axi_rready => ps7_0_axi_periph_M00_AXI_RREADY(0),
      s_axi_rresp(1 downto 0) => ps7_0_axi_periph_M00_AXI_RRESP(1 downto 0),
      s_axi_rvalid => ps7_0_axi_periph_M00_AXI_RVALID,
      s_axi_wdata(31 downto 0) => ps7_0_axi_periph_M00_AXI_WDATA(31 downto 0),
      s_axi_wready => ps7_0_axi_periph_M00_AXI_WREADY,
      s_axi_wstrb(3 downto 0) => ps7_0_axi_periph_M00_AXI_WSTRB(3 downto 0),
      s_axi_wvalid => ps7_0_axi_periph_M00_AXI_WVALID(0)
    );
processing_system7_0: component MADC_ARTY_Z7_processing_system7_0_0
     port map (
      DDR_Addr(14 downto 0) => DDR_addr(14 downto 0),
      DDR_BankAddr(2 downto 0) => DDR_ba(2 downto 0),
      DDR_CAS_n => DDR_cas_n,
      DDR_CKE => DDR_cke,
      DDR_CS_n => DDR_cs_n,
      DDR_Clk => DDR_ck_p,
      DDR_Clk_n => DDR_ck_n,
      DDR_DM(3 downto 0) => DDR_dm(3 downto 0),
      DDR_DQ(31 downto 0) => DDR_dq(31 downto 0),
      DDR_DQS(3 downto 0) => DDR_dqs_p(3 downto 0),
      DDR_DQS_n(3 downto 0) => DDR_dqs_n(3 downto 0),
      DDR_DRSTB => DDR_reset_n,
      DDR_ODT => DDR_odt,
      DDR_RAS_n => DDR_ras_n,
      DDR_VRN => FIXED_IO_ddr_vrn,
      DDR_VRP => FIXED_IO_ddr_vrp,
      DDR_WEB => DDR_we_n,
      FCLK_CLK0 => processing_system7_0_FCLK_CLK0,
      FCLK_RESET0_N => processing_system7_0_FCLK_RESET0_N,
      MIO(53 downto 0) => FIXED_IO_mio(53 downto 0),
      M_AXI_GP0_ACLK => processing_system7_0_FCLK_CLK0,
      M_AXI_GP0_ARADDR(31 downto 0) => processing_system7_0_M_AXI_GP0_ARADDR(31 downto 0),
      M_AXI_GP0_ARBURST(1 downto 0) => processing_system7_0_M_AXI_GP0_ARBURST(1 downto 0),
      M_AXI_GP0_ARCACHE(3 downto 0) => processing_system7_0_M_AXI_GP0_ARCACHE(3 downto 0),
      M_AXI_GP0_ARID(11 downto 0) => processing_system7_0_M_AXI_GP0_ARID(11 downto 0),
      M_AXI_GP0_ARLEN(3 downto 0) => processing_system7_0_M_AXI_GP0_ARLEN(3 downto 0),
      M_AXI_GP0_ARLOCK(1 downto 0) => processing_system7_0_M_AXI_GP0_ARLOCK(1 downto 0),
      M_AXI_GP0_ARPROT(2 downto 0) => processing_system7_0_M_AXI_GP0_ARPROT(2 downto 0),
      M_AXI_GP0_ARQOS(3 downto 0) => processing_system7_0_M_AXI_GP0_ARQOS(3 downto 0),
      M_AXI_GP0_ARREADY => processing_system7_0_M_AXI_GP0_ARREADY,
      M_AXI_GP0_ARSIZE(2 downto 0) => processing_system7_0_M_AXI_GP0_ARSIZE(2 downto 0),
      M_AXI_GP0_ARVALID => processing_system7_0_M_AXI_GP0_ARVALID,
      M_AXI_GP0_AWADDR(31 downto 0) => processing_system7_0_M_AXI_GP0_AWADDR(31 downto 0),
      M_AXI_GP0_AWBURST(1 downto 0) => processing_system7_0_M_AXI_GP0_AWBURST(1 downto 0),
      M_AXI_GP0_AWCACHE(3 downto 0) => processing_system7_0_M_AXI_GP0_AWCACHE(3 downto 0),
      M_AXI_GP0_AWID(11 downto 0) => processing_system7_0_M_AXI_GP0_AWID(11 downto 0),
      M_AXI_GP0_AWLEN(3 downto 0) => processing_system7_0_M_AXI_GP0_AWLEN(3 downto 0),
      M_AXI_GP0_AWLOCK(1 downto 0) => processing_system7_0_M_AXI_GP0_AWLOCK(1 downto 0),
      M_AXI_GP0_AWPROT(2 downto 0) => processing_system7_0_M_AXI_GP0_AWPROT(2 downto 0),
      M_AXI_GP0_AWQOS(3 downto 0) => processing_system7_0_M_AXI_GP0_AWQOS(3 downto 0),
      M_AXI_GP0_AWREADY => processing_system7_0_M_AXI_GP0_AWREADY,
      M_AXI_GP0_AWSIZE(2 downto 0) => processing_system7_0_M_AXI_GP0_AWSIZE(2 downto 0),
      M_AXI_GP0_AWVALID => processing_system7_0_M_AXI_GP0_AWVALID,
      M_AXI_GP0_BID(11 downto 0) => processing_system7_0_M_AXI_GP0_BID(11 downto 0),
      M_AXI_GP0_BREADY => processing_system7_0_M_AXI_GP0_BREADY,
      M_AXI_GP0_BRESP(1 downto 0) => processing_system7_0_M_AXI_GP0_BRESP(1 downto 0),
      M_AXI_GP0_BVALID => processing_system7_0_M_AXI_GP0_BVALID,
      M_AXI_GP0_RDATA(31 downto 0) => processing_system7_0_M_AXI_GP0_RDATA(31 downto 0),
      M_AXI_GP0_RID(11 downto 0) => processing_system7_0_M_AXI_GP0_RID(11 downto 0),
      M_AXI_GP0_RLAST => processing_system7_0_M_AXI_GP0_RLAST,
      M_AXI_GP0_RREADY => processing_system7_0_M_AXI_GP0_RREADY,
      M_AXI_GP0_RRESP(1 downto 0) => processing_system7_0_M_AXI_GP0_RRESP(1 downto 0),
      M_AXI_GP0_RVALID => processing_system7_0_M_AXI_GP0_RVALID,
      M_AXI_GP0_WDATA(31 downto 0) => processing_system7_0_M_AXI_GP0_WDATA(31 downto 0),
      M_AXI_GP0_WID(11 downto 0) => processing_system7_0_M_AXI_GP0_WID(11 downto 0),
      M_AXI_GP0_WLAST => processing_system7_0_M_AXI_GP0_WLAST,
      M_AXI_GP0_WREADY => processing_system7_0_M_AXI_GP0_WREADY,
      M_AXI_GP0_WSTRB(3 downto 0) => processing_system7_0_M_AXI_GP0_WSTRB(3 downto 0),
      M_AXI_GP0_WVALID => processing_system7_0_M_AXI_GP0_WVALID,
      PS_CLK => FIXED_IO_ps_clk,
      PS_PORB => FIXED_IO_ps_porb,
      PS_SRSTB => FIXED_IO_ps_srstb,
      USB0_PORT_INDCTL(1 downto 0) => NLW_processing_system7_0_USB0_PORT_INDCTL_UNCONNECTED(1 downto 0),
      USB0_VBUS_PWRFAULT => '0',
      USB0_VBUS_PWRSELECT => NLW_processing_system7_0_USB0_VBUS_PWRSELECT_UNCONNECTED
    );
ps7_0_axi_periph: entity work.MADC_ARTY_Z7_ps7_0_axi_periph_0
     port map (
      ACLK => processing_system7_0_FCLK_CLK0,
      ARESETN => rst_ps7_0_100M_peripheral_aresetn(0),
      M00_ACLK => processing_system7_0_FCLK_CLK0,
      M00_ARESETN => rst_ps7_0_100M_peripheral_aresetn(0),
      M00_AXI_araddr(31 downto 0) => ps7_0_axi_periph_M00_AXI_ARADDR(31 downto 0),
      M00_AXI_arready(0) => ps7_0_axi_periph_M00_AXI_ARREADY,
      M00_AXI_arvalid(0) => ps7_0_axi_periph_M00_AXI_ARVALID(0),
      M00_AXI_awaddr(31 downto 0) => ps7_0_axi_periph_M00_AXI_AWADDR(31 downto 0),
      M00_AXI_awready(0) => ps7_0_axi_periph_M00_AXI_AWREADY,
      M00_AXI_awvalid(0) => ps7_0_axi_periph_M00_AXI_AWVALID(0),
      M00_AXI_bready(0) => ps7_0_axi_periph_M00_AXI_BREADY(0),
      M00_AXI_bresp(1 downto 0) => ps7_0_axi_periph_M00_AXI_BRESP(1 downto 0),
      M00_AXI_bvalid(0) => ps7_0_axi_periph_M00_AXI_BVALID,
      M00_AXI_rdata(31 downto 0) => ps7_0_axi_periph_M00_AXI_RDATA(31 downto 0),
      M00_AXI_rready(0) => ps7_0_axi_periph_M00_AXI_RREADY(0),
      M00_AXI_rresp(1 downto 0) => ps7_0_axi_periph_M00_AXI_RRESP(1 downto 0),
      M00_AXI_rvalid(0) => ps7_0_axi_periph_M00_AXI_RVALID,
      M00_AXI_wdata(31 downto 0) => ps7_0_axi_periph_M00_AXI_WDATA(31 downto 0),
      M00_AXI_wready(0) => ps7_0_axi_periph_M00_AXI_WREADY,
      M00_AXI_wstrb(3 downto 0) => ps7_0_axi_periph_M00_AXI_WSTRB(3 downto 0),
      M00_AXI_wvalid(0) => ps7_0_axi_periph_M00_AXI_WVALID(0),
      M01_ACLK => processing_system7_0_FCLK_CLK0,
      M01_ARESETN => rst_ps7_0_100M_peripheral_aresetn(0),
      M01_AXI_araddr(31 downto 0) => ps7_0_axi_periph_M01_AXI_ARADDR(31 downto 0),
      M01_AXI_arprot(2 downto 0) => ps7_0_axi_periph_M01_AXI_ARPROT(2 downto 0),
      M01_AXI_arready => ps7_0_axi_periph_M01_AXI_ARREADY,
      M01_AXI_arvalid => ps7_0_axi_periph_M01_AXI_ARVALID,
      M01_AXI_awaddr(31 downto 0) => ps7_0_axi_periph_M01_AXI_AWADDR(31 downto 0),
      M01_AXI_awprot(2 downto 0) => ps7_0_axi_periph_M01_AXI_AWPROT(2 downto 0),
      M01_AXI_awready => ps7_0_axi_periph_M01_AXI_AWREADY,
      M01_AXI_awvalid => ps7_0_axi_periph_M01_AXI_AWVALID,
      M01_AXI_bready => ps7_0_axi_periph_M01_AXI_BREADY,
      M01_AXI_bresp(1 downto 0) => ps7_0_axi_periph_M01_AXI_BRESP(1 downto 0),
      M01_AXI_bvalid => ps7_0_axi_periph_M01_AXI_BVALID,
      M01_AXI_rdata(31 downto 0) => ps7_0_axi_periph_M01_AXI_RDATA(31 downto 0),
      M01_AXI_rready => ps7_0_axi_periph_M01_AXI_RREADY,
      M01_AXI_rresp(1 downto 0) => ps7_0_axi_periph_M01_AXI_RRESP(1 downto 0),
      M01_AXI_rvalid => ps7_0_axi_periph_M01_AXI_RVALID,
      M01_AXI_wdata(31 downto 0) => ps7_0_axi_periph_M01_AXI_WDATA(31 downto 0),
      M01_AXI_wready => ps7_0_axi_periph_M01_AXI_WREADY,
      M01_AXI_wstrb(3 downto 0) => ps7_0_axi_periph_M01_AXI_WSTRB(3 downto 0),
      M01_AXI_wvalid => ps7_0_axi_periph_M01_AXI_WVALID,
      S00_ACLK => processing_system7_0_FCLK_CLK0,
      S00_ARESETN => rst_ps7_0_100M_peripheral_aresetn(0),
      S00_AXI_araddr(31 downto 0) => processing_system7_0_M_AXI_GP0_ARADDR(31 downto 0),
      S00_AXI_arburst(1 downto 0) => processing_system7_0_M_AXI_GP0_ARBURST(1 downto 0),
      S00_AXI_arcache(3 downto 0) => processing_system7_0_M_AXI_GP0_ARCACHE(3 downto 0),
      S00_AXI_arid(11 downto 0) => processing_system7_0_M_AXI_GP0_ARID(11 downto 0),
      S00_AXI_arlen(3 downto 0) => processing_system7_0_M_AXI_GP0_ARLEN(3 downto 0),
      S00_AXI_arlock(1 downto 0) => processing_system7_0_M_AXI_GP0_ARLOCK(1 downto 0),
      S00_AXI_arprot(2 downto 0) => processing_system7_0_M_AXI_GP0_ARPROT(2 downto 0),
      S00_AXI_arqos(3 downto 0) => processing_system7_0_M_AXI_GP0_ARQOS(3 downto 0),
      S00_AXI_arready => processing_system7_0_M_AXI_GP0_ARREADY,
      S00_AXI_arsize(2 downto 0) => processing_system7_0_M_AXI_GP0_ARSIZE(2 downto 0),
      S00_AXI_arvalid => processing_system7_0_M_AXI_GP0_ARVALID,
      S00_AXI_awaddr(31 downto 0) => processing_system7_0_M_AXI_GP0_AWADDR(31 downto 0),
      S00_AXI_awburst(1 downto 0) => processing_system7_0_M_AXI_GP0_AWBURST(1 downto 0),
      S00_AXI_awcache(3 downto 0) => processing_system7_0_M_AXI_GP0_AWCACHE(3 downto 0),
      S00_AXI_awid(11 downto 0) => processing_system7_0_M_AXI_GP0_AWID(11 downto 0),
      S00_AXI_awlen(3 downto 0) => processing_system7_0_M_AXI_GP0_AWLEN(3 downto 0),
      S00_AXI_awlock(1 downto 0) => processing_system7_0_M_AXI_GP0_AWLOCK(1 downto 0),
      S00_AXI_awprot(2 downto 0) => processing_system7_0_M_AXI_GP0_AWPROT(2 downto 0),
      S00_AXI_awqos(3 downto 0) => processing_system7_0_M_AXI_GP0_AWQOS(3 downto 0),
      S00_AXI_awready => processing_system7_0_M_AXI_GP0_AWREADY,
      S00_AXI_awsize(2 downto 0) => processing_system7_0_M_AXI_GP0_AWSIZE(2 downto 0),
      S00_AXI_awvalid => processing_system7_0_M_AXI_GP0_AWVALID,
      S00_AXI_bid(11 downto 0) => processing_system7_0_M_AXI_GP0_BID(11 downto 0),
      S00_AXI_bready => processing_system7_0_M_AXI_GP0_BREADY,
      S00_AXI_bresp(1 downto 0) => processing_system7_0_M_AXI_GP0_BRESP(1 downto 0),
      S00_AXI_bvalid => processing_system7_0_M_AXI_GP0_BVALID,
      S00_AXI_rdata(31 downto 0) => processing_system7_0_M_AXI_GP0_RDATA(31 downto 0),
      S00_AXI_rid(11 downto 0) => processing_system7_0_M_AXI_GP0_RID(11 downto 0),
      S00_AXI_rlast => processing_system7_0_M_AXI_GP0_RLAST,
      S00_AXI_rready => processing_system7_0_M_AXI_GP0_RREADY,
      S00_AXI_rresp(1 downto 0) => processing_system7_0_M_AXI_GP0_RRESP(1 downto 0),
      S00_AXI_rvalid => processing_system7_0_M_AXI_GP0_RVALID,
      S00_AXI_wdata(31 downto 0) => processing_system7_0_M_AXI_GP0_WDATA(31 downto 0),
      S00_AXI_wid(11 downto 0) => processing_system7_0_M_AXI_GP0_WID(11 downto 0),
      S00_AXI_wlast => processing_system7_0_M_AXI_GP0_WLAST,
      S00_AXI_wready => processing_system7_0_M_AXI_GP0_WREADY,
      S00_AXI_wstrb(3 downto 0) => processing_system7_0_M_AXI_GP0_WSTRB(3 downto 0),
      S00_AXI_wvalid => processing_system7_0_M_AXI_GP0_WVALID
    );
rst_ps7_0_100M: component MADC_ARTY_Z7_rst_ps7_0_100M_0
     port map (
      aux_reset_in => '1',
      bus_struct_reset(0) => NLW_rst_ps7_0_100M_bus_struct_reset_UNCONNECTED(0),
      dcm_locked => '1',
      ext_reset_in => processing_system7_0_FCLK_RESET0_N,
      interconnect_aresetn(0) => NLW_rst_ps7_0_100M_interconnect_aresetn_UNCONNECTED(0),
      mb_debug_sys_rst => '0',
      mb_reset => NLW_rst_ps7_0_100M_mb_reset_UNCONNECTED,
      peripheral_aresetn(0) => rst_ps7_0_100M_peripheral_aresetn(0),
      peripheral_reset(0) => NLW_rst_ps7_0_100M_peripheral_reset_UNCONNECTED(0),
      slowest_sync_clk => processing_system7_0_FCLK_CLK0
    );
end STRUCTURE;
