BehrensG/MADC_ARTY/Software/vivado/MADC_ARTY_Z7/MADC_ARTY_Z7.gen/sources_1/bd/MADC_ARTY_Z7/synth/MADC_ARTY_Z7.v

//Copyright 1986-2022 Xilinx, Inc. All Rights Reserved.
//Copyright 2022-2024 Advanced Micro Devices, Inc. All Rights Reserved.
//--------------------------------------------------------------------------------
//Tool Version: Vivado v.2024.1 (lin64) Build 5076996 Wed May 22 18:36:09 MDT 2024
//Date        : Thu Sep  3 18:47:29 2026
//Host        : archlinux running 64-bit Arch Linux
//Command     : generate_target MADC_ARTY_Z7.bd
//Design      : MADC_ARTY_Z7
//Purpose     : IP block netlist
//--------------------------------------------------------------------------------
`timescale 1 ps / 1 ps

(* CORE_GENERATION_INFO = "MADC_ARTY_Z7,IP_Integrator,{x_ipVendor=xilinx.com,x_ipLibrary=BlockDiagram,x_ipName=MADC_ARTY_Z7,x_ipVersion=1.00.a,x_ipLanguage=VERILOG,numBlks=10,numReposBlks=6,numNonXlnxBlks=1,numHierBlks=4,maxHierDepth=0,numSysgenBlks=0,numHlsBlks=0,numHdlrefBlks=0,numPkgbdBlks=0,bdsource=USER,da_axi4_cnt=2,da_board_cnt=1,da_ps7_cnt=1,synth_mode=Hierarchical}" *) (* HW_HANDOFF = "MADC_ARTY_Z7.hwdef" *) 
module MADC_ARTY_Z7
   (DDR_addr,
    DDR_ba,
    DDR_cas_n,
    DDR_ck_n,
    DDR_ck_p,
    DDR_cke,
    DDR_cs_n,
    DDR_dm,
    DDR_dq,
    DDR_dqs_n,
    DDR_dqs_p,
    DDR_odt,
    DDR_ras_n,
    DDR_reset_n,
    DDR_we_n,
    FIXED_IO_ddr_vrn,
    FIXED_IO_ddr_vrp,
    FIXED_IO_mio,
    FIXED_IO_ps_clk,
    FIXED_IO_ps_porb,
    FIXED_IO_ps_srstb,
    ad_cmp,
    ad_id,
    ad_iin,
    ad_irn,
    ad_irp,
    btns_4bits_tri_i,
    sw_vrh);
  (* X_INTERFACE_INFO = "xilinx.com:interface:ddrx:1.0 DDR ADDR" *) (* X_INTERFACE_PARAMETER = "XIL_INTERFACENAME DDR, AXI_ARBITRATION_SCHEME TDM, BURST_LENGTH 8, CAN_DEBUG false, CAS_LATENCY 11, CAS_WRITE_LATENCY 11, CS_ENABLED true, DATA_MASK_ENABLED true, DATA_WIDTH 8, MEMORY_TYPE COMPONENTS, MEM_ADDR_MAP ROW_COLUMN_BANK, SLOT Single, TIMEPERIOD_PS 1250" *) inout [14:0]DDR_addr;
  (* X_INTERFACE_INFO = "xilinx.com:interface:ddrx:1.0 DDR BA" *) inout [2:0]DDR_ba;
  (* X_INTERFACE_INFO = "xilinx.com:interface:ddrx:1.0 DDR CAS_N" *) inout DDR_cas_n;
  (* X_INTERFACE_INFO = "xilinx.com:interface:ddrx:1.0 DDR CK_N" *) inout DDR_ck_n;
  (* X_INTERFACE_INFO = "xilinx.com:interface:ddrx:1.0 DDR CK_P" *) inout DDR_ck_p;
  (* X_INTERFACE_INFO = "xilinx.com:interface:ddrx:1.0 DDR CKE" *) inout DDR_cke;
  (* X_INTERFACE_INFO = "xilinx.com:interface:ddrx:1.0 DDR CS_N" *) inout DDR_cs_n;
  (* X_INTERFACE_INFO = "xilinx.com:interface:ddrx:1.0 DDR DM" *) inout [3:0]DDR_dm;
  (* X_INTERFACE_INFO = "xilinx.com:interface:ddrx:1.0 DDR DQ" *) inout [31:0]DDR_dq;
  (* X_INTERFACE_INFO = "xilinx.com:interface:ddrx:1.0 DDR DQS_N" *) inout [3:0]DDR_dqs_n;
  (* X_INTERFACE_INFO = "xilinx.com:interface:ddrx:1.0 DDR DQS_P" *) inout [3:0]DDR_dqs_p;
  (* X_INTERFACE_INFO = "xilinx.com:interface:ddrx:1.0 DDR ODT" *) inout DDR_odt;
  (* X_INTERFACE_INFO = "xilinx.com:interface:ddrx:1.0 DDR RAS_N" *) inout DDR_ras_n;
  (* X_INTERFACE_INFO = "xilinx.com:interface:ddrx:1.0 DDR RESET_N" *) inout DDR_reset_n;
  (* X_INTERFACE_INFO = "xilinx.com:interface:ddrx:1.0 DDR WE_N" *) inout DDR_we_n;
  (* X_INTERFACE_INFO = "xilinx.com:display_processing_system7:fixedio:1.0 FIXED_IO DDR_VRN" *) (* X_INTERFACE_PARAMETER = "XIL_INTERFACENAME FIXED_IO, CAN_DEBUG false" *) inout FIXED_IO_ddr_vrn;
  (* X_INTERFACE_INFO = "xilinx.com:display_processing_system7:fixedio:1.0 FIXED_IO DDR_VRP" *) inout FIXED_IO_ddr_vrp;
  (* X_INTERFACE_INFO = "xilinx.com:display_processing_system7:fixedio:1.0 FIXED_IO MIO" *) inout [53:0]FIXED_IO_mio;
  (* X_INTERFACE_INFO = "xilinx.com:display_processing_system7:fixedio:1.0 FIXED_IO PS_CLK" *) inout FIXED_IO_ps_clk;
  (* X_INTERFACE_INFO = "xilinx.com:display_processing_system7:fixedio:1.0 FIXED_IO PS_PORB" *) inout FIXED_IO_ps_porb;
  (* X_INTERFACE_INFO = "xilinx.com:display_processing_system7:fixedio:1.0 FIXED_IO PS_SRSTB" *) inout FIXED_IO_ps_srstb;
  input ad_cmp;
  output ad_id;
  output ad_iin;
  output ad_irn;
  output ad_irp;
  (* X_INTERFACE_INFO = "xilinx.com:interface:gpio:1.0 btns_4bits TRI_I" *) input [3:0]btns_4bits_tri_i;
  output sw_vrh;

  wire MADC_0_ad_id;
  wire MADC_0_ad_iin;
  wire MADC_0_ad_irn;
  wire MADC_0_ad_irp;
  wire MADC_0_sw_vrh;
  wire ad_cmp_1;
  wire [3:0]axi_gpio_0_GPIO_TRI_I;
  wire [14:0]processing_system7_0_DDR_ADDR;
  wire [2:0]processing_system7_0_DDR_BA;
  wire processing_system7_0_DDR_CAS_N;
  wire processing_system7_0_DDR_CKE;
  wire processing_system7_0_DDR_CK_N;
  wire processing_system7_0_DDR_CK_P;
  wire processing_system7_0_DDR_CS_N;
  wire [3:0]processing_system7_0_DDR_DM;
  wire [31:0]processing_system7_0_DDR_DQ;
  wire [3:0]processing_system7_0_DDR_DQS_N;
  wire [3:0]processing_system7_0_DDR_DQS_P;
  wire processing_system7_0_DDR_ODT;
  wire processing_system7_0_DDR_RAS_N;
  wire processing_system7_0_DDR_RESET_N;
  wire processing_system7_0_DDR_WE_N;
  wire processing_system7_0_FCLK_CLK0;
  wire processing_system7_0_FCLK_RESET0_N;
  wire processing_system7_0_FIXED_IO_DDR_VRN;
  wire processing_system7_0_FIXED_IO_DDR_VRP;
  wire [53:0]processing_system7_0_FIXED_IO_MIO;
  wire processing_system7_0_FIXED_IO_PS_CLK;
  wire processing_system7_0_FIXED_IO_PS_PORB;
  wire processing_system7_0_FIXED_IO_PS_SRSTB;
  wire [31:0]processing_system7_0_M_AXI_GP0_ARADDR;
  wire [1:0]processing_system7_0_M_AXI_GP0_ARBURST;
  wire [3:0]processing_system7_0_M_AXI_GP0_ARCACHE;
  wire [11:0]processing_system7_0_M_AXI_GP0_ARID;
  wire [3:0]processing_system7_0_M_AXI_GP0_ARLEN;
  wire [1:0]processing_system7_0_M_AXI_GP0_ARLOCK;
  wire [2:0]processing_system7_0_M_AXI_GP0_ARPROT;
  wire [3:0]processing_system7_0_M_AXI_GP0_ARQOS;
  wire processing_system7_0_M_AXI_GP0_ARREADY;
  wire [2:0]processing_system7_0_M_AXI_GP0_ARSIZE;
  wire processing_system7_0_M_AXI_GP0_ARVALID;
  wire [31:0]processing_system7_0_M_AXI_GP0_AWADDR;
  wire [1:0]processing_system7_0_M_AXI_GP0_AWBURST;
  wire [3:0]processing_system7_0_M_AXI_GP0_AWCACHE;
  wire [11:0]processing_system7_0_M_AXI_GP0_AWID;
  wire [3:0]processing_system7_0_M_AXI_GP0_AWLEN;
  wire [1:0]processing_system7_0_M_AXI_GP0_AWLOCK;
  wire [2:0]processing_system7_0_M_AXI_GP0_AWPROT;
  wire [3:0]processing_system7_0_M_AXI_GP0_AWQOS;
  wire processing_system7_0_M_AXI_GP0_AWREADY;
  wire [2:0]processing_system7_0_M_AXI_GP0_AWSIZE;
  wire processing_system7_0_M_AXI_GP0_AWVALID;
  wire [11:0]processing_system7_0_M_AXI_GP0_BID;
  wire processing_system7_0_M_AXI_GP0_BREADY;
  wire [1:0]processing_system7_0_M_AXI_GP0_BRESP;
  wire processing_system7_0_M_AXI_GP0_BVALID;
  wire [31:0]processing_system7_0_M_AXI_GP0_RDATA;
  wire [11:0]processing_system7_0_M_AXI_GP0_RID;
  wire processing_system7_0_M_AXI_GP0_RLAST;
  wire processing_system7_0_M_AXI_GP0_RREADY;
  wire [1:0]processing_system7_0_M_AXI_GP0_RRESP;
  wire processing_system7_0_M_AXI_GP0_RVALID;
  wire [31:0]processing_system7_0_M_AXI_GP0_WDATA;
  wire [11:0]processing_system7_0_M_AXI_GP0_WID;
  wire processing_system7_0_M_AXI_GP0_WLAST;
  wire processing_system7_0_M_AXI_GP0_WREADY;
  wire [3:0]processing_system7_0_M_AXI_GP0_WSTRB;
  wire processing_system7_0_M_AXI_GP0_WVALID;
  wire [31:0]ps7_0_axi_periph_M00_AXI_ARADDR;
  wire ps7_0_axi_periph_M00_AXI_ARREADY;
  wire [0:0]ps7_0_axi_periph_M00_AXI_ARVALID;
  wire [31:0]ps7_0_axi_periph_M00_AXI_AWADDR;
  wire ps7_0_axi_periph_M00_AXI_AWREADY;
  wire [0:0]ps7_0_axi_periph_M00_AXI_AWVALID;
  wire [0:0]ps7_0_axi_periph_M00_AXI_BREADY;
  wire [1:0]ps7_0_axi_periph_M00_AXI_BRESP;
  wire ps7_0_axi_periph_M00_AXI_BVALID;
  wire [31:0]ps7_0_axi_periph_M00_AXI_RDATA;
  wire [0:0]ps7_0_axi_periph_M00_AXI_RREADY;
  wire [1:0]ps7_0_axi_periph_M00_AXI_RRESP;
  wire ps7_0_axi_periph_M00_AXI_RVALID;
  wire [31:0]ps7_0_axi_periph_M00_AXI_WDATA;
  wire ps7_0_axi_periph_M00_AXI_WREADY;
  wire [3:0]ps7_0_axi_periph_M00_AXI_WSTRB;
  wire [0:0]ps7_0_axi_periph_M00_AXI_WVALID;
  wire [31:0]ps7_0_axi_periph_M01_AXI_ARADDR;
  wire [2:0]ps7_0_axi_periph_M01_AXI_ARPROT;
  wire ps7_0_axi_periph_M01_AXI_ARREADY;
  wire ps7_0_axi_periph_M01_AXI_ARVALID;
  wire [31:0]ps7_0_axi_periph_M01_AXI_AWADDR;
  wire [2:0]ps7_0_axi_periph_M01_AXI_AWPROT;
  wire ps7_0_axi_periph_M01_AXI_AWREADY;
  wire ps7_0_axi_periph_M01_AXI_AWVALID;
  wire ps7_0_axi_periph_M01_AXI_BREADY;
  wire [1:0]ps7_0_axi_periph_M01_AXI_BRESP;
  wire ps7_0_axi_periph_M01_AXI_BVALID;
  wire [31:0]ps7_0_axi_periph_M01_AXI_RDATA;
  wire ps7_0_axi_periph_M01_AXI_RREADY;
  wire [1:0]ps7_0_axi_periph_M01_AXI_RRESP;
  wire ps7_0_axi_periph_M01_AXI_RVALID;
  wire [31:0]ps7_0_axi_periph_M01_AXI_WDATA;
  wire ps7_0_axi_periph_M01_AXI_WREADY;
  wire [3:0]ps7_0_axi_periph_M01_AXI_WSTRB;
  wire ps7_0_axi_periph_M01_AXI_WVALID;
  wire [0:0]rst_ps7_0_100M_peripheral_aresetn;

  assign ad_cmp_1 = ad_cmp;
  assign ad_id = MADC_0_ad_id;
  assign ad_iin = MADC_0_ad_iin;
  assign ad_irn = MADC_0_ad_irn;
  assign ad_irp = MADC_0_ad_irp;
  assign axi_gpio_0_GPIO_TRI_I = btns_4bits_tri_i[3:0];
  assign sw_vrh = MADC_0_sw_vrh;
  MADC_ARTY_Z7_MADC_0_0 MADC_0
       (.ad_cmp(ad_cmp_1),
        .ad_id(MADC_0_ad_id),
        .ad_iin(MADC_0_ad_iin),
        .ad_irn(MADC_0_ad_irn),
        .ad_irp(MADC_0_ad_irp),
        .s00_axi_aclk(processing_system7_0_FCLK_CLK0),
        .s00_axi_araddr(ps7_0_axi_periph_M01_AXI_ARADDR[3:0]),
        .s00_axi_aresetn(rst_ps7_0_100M_peripheral_aresetn),
        .s00_axi_arprot(ps7_0_axi_periph_M01_AXI_ARPROT),
        .s00_axi_arready(ps7_0_axi_periph_M01_AXI_ARREADY),
        .s00_axi_arvalid(ps7_0_axi_periph_M01_AXI_ARVALID),
        .s00_axi_awaddr(ps7_0_axi_periph_M01_AXI_AWADDR[3:0]),
        .s00_axi_awprot(ps7_0_axi_periph_M01_AXI_AWPROT),
        .s00_axi_awready(ps7_0_axi_periph_M01_AXI_AWREADY),
        .s00_axi_awvalid(ps7_0_axi_periph_M01_AXI_AWVALID),
        .s00_axi_bready(ps7_0_axi_periph_M01_AXI_BREADY),
        .s00_axi_bresp(ps7_0_axi_periph_M01_AXI_BRESP),
        .s00_axi_bvalid(ps7_0_axi_periph_M01_AXI_BVALID),
        .s00_axi_rdata(ps7_0_axi_periph_M01_AXI_RDATA),
        .s00_axi_rready(ps7_0_axi_periph_M01_AXI_RREADY),
        .s00_axi_rresp(ps7_0_axi_periph_M01_AXI_RRESP),
        .s00_axi_rvalid(ps7_0_axi_periph_M01_AXI_RVALID),
        .s00_axi_wdata(ps7_0_axi_periph_M01_AXI_WDATA),
        .s00_axi_wready(ps7_0_axi_periph_M01_AXI_WREADY),
        .s00_axi_wstrb(ps7_0_axi_periph_M01_AXI_WSTRB),
        .s00_axi_wvalid(ps7_0_axi_periph_M01_AXI_WVALID),
        .sw_vrh(MADC_0_sw_vrh));
  MADC_ARTY_Z7_axi_gpio_0_0 axi_gpio_0
       (.gpio_io_i(axi_gpio_0_GPIO_TRI_I),
        .s_axi_aclk(processing_system7_0_FCLK_CLK0),
        .s_axi_araddr(ps7_0_axi_periph_M00_AXI_ARADDR[8:0]),
        .s_axi_aresetn(rst_ps7_0_100M_peripheral_aresetn),
        .s_axi_arready(ps7_0_axi_periph_M00_AXI_ARREADY),
        .s_axi_arvalid(ps7_0_axi_periph_M00_AXI_ARVALID),
        .s_axi_awaddr(ps7_0_axi_periph_M00_AXI_AWADDR[8:0]),
        .s_axi_awready(ps7_0_axi_periph_M00_AXI_AWREADY),
        .s_axi_awvalid(ps7_0_axi_periph_M00_AXI_AWVALID),
        .s_axi_bready(ps7_0_axi_periph_M00_AXI_BREADY),
        .s_axi_bresp(ps7_0_axi_periph_M00_AXI_BRESP),
        .s_axi_bvalid(ps7_0_axi_periph_M00_AXI_BVALID),
        .s_axi_rdata(ps7_0_axi_periph_M00_AXI_RDATA),
        .s_axi_rready(ps7_0_axi_periph_M00_AXI_RREADY),
        .s_axi_rresp(ps7_0_axi_periph_M00_AXI_RRESP),
        .s_axi_rvalid(ps7_0_axi_periph_M00_AXI_RVALID),
        .s_axi_wdata(ps7_0_axi_periph_M00_AXI_WDATA),
        .s_axi_wready(ps7_0_axi_periph_M00_AXI_WREADY),
        .s_axi_wstrb(ps7_0_axi_periph_M00_AXI_WSTRB),
        .s_axi_wvalid(ps7_0_axi_periph_M00_AXI_WVALID));
  MADC_ARTY_Z7_processing_system7_0_0 processing_system7_0
       (.DDR_Addr(DDR_addr[14:0]),
        .DDR_BankAddr(DDR_ba[2:0]),
        .DDR_CAS_n(DDR_cas_n),
        .DDR_CKE(DDR_cke),
        .DDR_CS_n(DDR_cs_n),
        .DDR_Clk(DDR_ck_p),
        .DDR_Clk_n(DDR_ck_n),
        .DDR_DM(DDR_dm[3:0]),
        .DDR_DQ(DDR_dq[31:0]),
        .DDR_DQS(DDR_dqs_p[3:0]),
        .DDR_DQS_n(DDR_dqs_n[3:0]),
        .DDR_DRSTB(DDR_reset_n),
        .DDR_ODT(DDR_odt),
        .DDR_RAS_n(DDR_ras_n),
        .DDR_VRN(FIXED_IO_ddr_vrn),
        .DDR_VRP(FIXED_IO_ddr_vrp),
        .DDR_WEB(DDR_we_n),
        .FCLK_CLK0(processing_system7_0_FCLK_CLK0),
        .FCLK_RESET0_N(processing_system7_0_FCLK_RESET0_N),
        .MIO(FIXED_IO_mio[53:0]),
        .M_AXI_GP0_ACLK(processing_system7_0_FCLK_CLK0),
        .M_AXI_GP0_ARADDR(processing_system7_0_M_AXI_GP0_ARADDR),
        .M_AXI_GP0_ARBURST(processing_system7_0_M_AXI_GP0_ARBURST),
        .M_AXI_GP0_ARCACHE(processing_system7_0_M_AXI_GP0_ARCACHE),
        .M_AXI_GP0_ARID(processing_system7_0_M_AXI_GP0_ARID),
        .M_AXI_GP0_ARLEN(processing_system7_0_M_AXI_GP0_ARLEN),
        .M_AXI_GP0_ARLOCK(processing_system7_0_M_AXI_GP0_ARLOCK),
        .M_AXI_GP0_ARPROT(processing_system7_0_M_AXI_GP0_ARPROT),
        .M_AXI_GP0_ARQOS(processing_system7_0_M_AXI_GP0_ARQOS),
        .M_AXI_GP0_ARREADY(processing_system7_0_M_AXI_GP0_ARREADY),
        .M_AXI_GP0_ARSIZE(processing_system7_0_M_AXI_GP0_ARSIZE),
        .M_AXI_GP0_ARVALID(processing_system7_0_M_AXI_GP0_ARVALID),
        .M_AXI_GP0_AWADDR(processing_system7_0_M_AXI_GP0_AWADDR),
        .M_AXI_GP0_AWBURST(processing_system7_0_M_AXI_GP0_AWBURST),
        .M_AXI_GP0_AWCACHE(processing_system7_0_M_AXI_GP0_AWCACHE),
        .M_AXI_GP0_AWID(processing_system7_0_M_AXI_GP0_AWID),
        .M_AXI_GP0_AWLEN(processing_system7_0_M_AXI_GP0_AWLEN),
        .M_AXI_GP0_AWLOCK(processing_system7_0_M_AXI_GP0_AWLOCK),
        .M_AXI_GP0_AWPROT(processing_system7_0_M_AXI_GP0_AWPROT),
        .M_AXI_GP0_AWQOS(processing_system7_0_M_AXI_GP0_AWQOS),
        .M_AXI_GP0_AWREADY(processing_system7_0_M_AXI_GP0_AWREADY),
        .M_AXI_GP0_AWSIZE(processing_system7_0_M_AXI_GP0_AWSIZE),
        .M_AXI_GP0_AWVALID(processing_system7_0_M_AXI_GP0_AWVALID),
        .M_AXI_GP0_BID(processing_system7_0_M_AXI_GP0_BID),
        .M_AXI_GP0_BREADY(processing_system7_0_M_AXI_GP0_BREADY),
        .M_AXI_GP0_BRESP(processing_system7_0_M_AXI_GP0_BRESP),
        .M_AXI_GP0_BVALID(processing_system7_0_M_AXI_GP0_BVALID),
        .M_AXI_GP0_RDATA(processing_system7_0_M_AXI_GP0_RDATA),
        .M_AXI_GP0_RID(processing_system7_0_M_AXI_GP0_RID),
        .M_AXI_GP0_RLAST(processing_system7_0_M_AXI_GP0_RLAST),
        .M_AXI_GP0_RREADY(processing_system7_0_M_AXI_GP0_RREADY),
        .M_AXI_GP0_RRESP(processing_system7_0_M_AXI_GP0_RRESP),
        .M_AXI_GP0_RVALID(processing_system7_0_M_AXI_GP0_RVALID),
        .M_AXI_GP0_WDATA(processing_system7_0_M_AXI_GP0_WDATA),
        .M_AXI_GP0_WID(processing_system7_0_M_AXI_GP0_WID),
        .M_AXI_GP0_WLAST(processing_system7_0_M_AXI_GP0_WLAST),
        .M_AXI_GP0_WREADY(processing_system7_0_M_AXI_GP0_WREADY),
        .M_AXI_GP0_WSTRB(processing_system7_0_M_AXI_GP0_WSTRB),
        .M_AXI_GP0_WVALID(processing_system7_0_M_AXI_GP0_WVALID),
        .PS_CLK(FIXED_IO_ps_clk),
        .PS_PORB(FIXED_IO_ps_porb),
        .PS_SRSTB(FIXED_IO_ps_srstb),
        .USB0_VBUS_PWRFAULT(1'b0));
  MADC_ARTY_Z7_ps7_0_axi_periph_0 ps7_0_axi_periph
       (.ACLK(processing_system7_0_FCLK_CLK0),
        .ARESETN(rst_ps7_0_100M_peripheral_aresetn),
        .M00_ACLK(processing_system7_0_FCLK_CLK0),
        .M00_ARESETN(rst_ps7_0_100M_peripheral_aresetn),
        .M00_AXI_araddr(ps7_0_axi_periph_M00_AXI_ARADDR),
        .M00_AXI_arready(ps7_0_axi_periph_M00_AXI_ARREADY),
        .M00_AXI_arvalid(ps7_0_axi_periph_M00_AXI_ARVALID),
        .M00_AXI_awaddr(ps7_0_axi_periph_M00_AXI_AWADDR),
        .M00_AXI_awready(ps7_0_axi_periph_M00_AXI_AWREADY),
        .M00_AXI_awvalid(ps7_0_axi_periph_M00_AXI_AWVALID),
        .M00_AXI_bready(ps7_0_axi_periph_M00_AXI_BREADY),
        .M00_AXI_bresp(ps7_0_axi_periph_M00_AXI_BRESP),
        .M00_AXI_bvalid(ps7_0_axi_periph_M00_AXI_BVALID),
        .M00_AXI_rdata(ps7_0_axi_periph_M00_AXI_RDATA),
        .M00_AXI_rready(ps7_0_axi_periph_M00_AXI_RREADY),
        .M00_AXI_rresp(ps7_0_axi_periph_M00_AXI_RRESP),
        .M00_AXI_rvalid(ps7_0_axi_periph_M00_AXI_RVALID),
        .M00_AXI_wdata(ps7_0_axi_periph_M00_AXI_WDATA),
        .M00_AXI_wready(ps7_0_axi_periph_M00_AXI_WREADY),
        .M00_AXI_wstrb(ps7_0_axi_periph_M00_AXI_WSTRB),
        .M00_AXI_wvalid(ps7_0_axi_periph_M00_AXI_WVALID),
        .M01_ACLK(processing_system7_0_FCLK_CLK0),
        .M01_ARESETN(rst_ps7_0_100M_peripheral_aresetn),
        .M01_AXI_araddr(ps7_0_axi_periph_M01_AXI_ARADDR),
        .M01_AXI_arprot(ps7_0_axi_periph_M01_AXI_ARPROT),
        .M01_AXI_arready(ps7_0_axi_periph_M01_AXI_ARREADY),
        .M01_AXI_arvalid(ps7_0_axi_periph_M01_AXI_ARVALID),
        .M01_AXI_awaddr(ps7_0_axi_periph_M01_AXI_AWADDR),
        .M01_AXI_awprot(ps7_0_axi_periph_M01_AXI_AWPROT),
        .M01_AXI_awready(ps7_0_axi_periph_M01_AXI_AWREADY),
        .M01_AXI_awvalid(ps7_0_axi_periph_M01_AXI_AWVALID),
        .M01_AXI_bready(ps7_0_axi_periph_M01_AXI_BREADY),
        .M01_AXI_bresp(ps7_0_axi_periph_M01_AXI_BRESP),
        .M01_AXI_bvalid(ps7_0_axi_periph_M01_AXI_BVALID),
        .M01_AXI_rdata(ps7_0_axi_periph_M01_AXI_RDATA),
        .M01_AXI_rready(ps7_0_axi_periph_M01_AXI_RREADY),
        .M01_AXI_rresp(ps7_0_axi_periph_M01_AXI_RRESP),
        .M01_AXI_rvalid(ps7_0_axi_periph_M01_AXI_RVALID),
        .M01_AXI_wdata(ps7_0_axi_periph_M01_AXI_WDATA),
        .M01_AXI_wready(ps7_0_axi_periph_M01_AXI_WREADY),
        .M01_AXI_wstrb(ps7_0_axi_periph_M01_AXI_WSTRB),
        .M01_AXI_wvalid(ps7_0_axi_periph_M01_AXI_WVALID),
        .S00_ACLK(processing_system7_0_FCLK_CLK0),
        .S00_ARESETN(rst_ps7_0_100M_peripheral_aresetn),
        .S00_AXI_araddr(processing_system7_0_M_AXI_GP0_ARADDR),
        .S00_AXI_arburst(processing_system7_0_M_AXI_GP0_ARBURST),
        .S00_AXI_arcache(processing_system7_0_M_AXI_GP0_ARCACHE),
        .S00_AXI_arid(processing_system7_0_M_AXI_GP0_ARID),
        .S00_AXI_arlen(processing_system7_0_M_AXI_GP0_ARLEN),
        .S00_AXI_arlock(processing_system7_0_M_AXI_GP0_ARLOCK),
        .S00_AXI_arprot(processing_system7_0_M_AXI_GP0_ARPROT),
        .S00_AXI_arqos(processing_system7_0_M_AXI_GP0_ARQOS),
        .S00_AXI_arready(processing_system7_0_M_AXI_GP0_ARREADY),
        .S00_AXI_arsize(processing_system7_0_M_AXI_GP0_ARSIZE),
        .S00_AXI_arvalid(processing_system7_0_M_AXI_GP0_ARVALID),
        .S00_AXI_awaddr(processing_system7_0_M_AXI_GP0_AWADDR),
        .S00_AXI_awburst(processing_system7_0_M_AXI_GP0_AWBURST),
        .S00_AXI_awcache(processing_system7_0_M_AXI_GP0_AWCACHE),
        .S00_AXI_awid(processing_system7_0_M_AXI_GP0_AWID),
        .S00_AXI_awlen(processing_system7_0_M_AXI_GP0_AWLEN),
        .S00_AXI_awlock(processing_system7_0_M_AXI_GP0_AWLOCK),
        .S00_AXI_awprot(processing_system7_0_M_AXI_GP0_AWPROT),
        .S00_AXI_awqos(processing_system7_0_M_AXI_GP0_AWQOS),
        .S00_AXI_awready(processing_system7_0_M_AXI_GP0_AWREADY),
        .S00_AXI_awsize(processing_system7_0_M_AXI_GP0_AWSIZE),
        .S00_AXI_awvalid(processing_system7_0_M_AXI_GP0_AWVALID),
        .S00_AXI_bid(processing_system7_0_M_AXI_GP0_BID),
        .S00_AXI_bready(processing_system7_0_M_AXI_GP0_BREADY),
        .S00_AXI_bresp(processing_system7_0_M_AXI_GP0_BRESP),
        .S00_AXI_bvalid(processing_system7_0_M_AXI_GP0_BVALID),
        .S00_AXI_rdata(processing_system7_0_M_AXI_GP0_RDATA),
        .S00_AXI_rid(processing_system7_0_M_AXI_GP0_RID),
        .S00_AXI_rlast(processing_system7_0_M_AXI_GP0_RLAST),
        .S00_AXI_rready(processing_system7_0_M_AXI_GP0_RREADY),
        .S00_AXI_rresp(processing_system7_0_M_AXI_GP0_RRESP),
        .S00_AXI_rvalid(processing_system7_0_M_AXI_GP0_RVALID),
        .S00_AXI_wdata(processing_system7_0_M_AXI_GP0_WDATA),
        .S00_AXI_wid(processing_system7_0_M_AXI_GP0_WID),
        .S00_AXI_wlast(processing_system7_0_M_AXI_GP0_WLAST),
        .S00_AXI_wready(processing_system7_0_M_AXI_GP0_WREADY),
        .S00_AXI_wstrb(processing_system7_0_M_AXI_GP0_WSTRB),
        .S00_AXI_wvalid(processing_system7_0_M_AXI_GP0_WVALID));
  MADC_ARTY_Z7_rst_ps7_0_100M_0 rst_ps7_0_100M
       (.aux_reset_in(1'b1),
        .dcm_locked(1'b1),
        .ext_reset_in(processing_system7_0_FCLK_RESET0_N),
        .mb_debug_sys_rst(1'b0),
        .peripheral_aresetn(rst_ps7_0_100M_peripheral_aresetn),
        .slowest_sync_clk(processing_system7_0_FCLK_CLK0));
endmodule

module MADC_ARTY_Z7_ps7_0_axi_periph_0
   (ACLK,
    ARESETN,
    M00_ACLK,
    M00_ARESETN,
    M00_AXI_araddr,
    M00_AXI_arready,
    M00_AXI_arvalid,
    M00_AXI_awaddr,
    M00_AXI_awready,
    M00_AXI_awvalid,
    M00_AXI_bready,
    M00_AXI_bresp,
    M00_AXI_bvalid,
    M00_AXI_rdata,
    M00_AXI_rready,
    M00_AXI_rresp,
    M00_AXI_rvalid,
    M00_AXI_wdata,
    M00_AXI_wready,
    M00_AXI_wstrb,
    M00_AXI_wvalid,
    M01_ACLK,
    M01_ARESETN,
    M01_AXI_araddr,
    M01_AXI_arprot,
    M01_AXI_arready,
    M01_AXI_arvalid,
    M01_AXI_awaddr,
    M01_AXI_awprot,
    M01_AXI_awready,
    M01_AXI_awvalid,
    M01_AXI_bready,
    M01_AXI_bresp,
    M01_AXI_bvalid,
    M01_AXI_rdata,
    M01_AXI_rready,
    M01_AXI_rresp,
    M01_AXI_rvalid,
    M01_AXI_wdata,
    M01_AXI_wready,
    M01_AXI_wstrb,
    M01_AXI_wvalid,
    S00_ACLK,
    S00_ARESETN,
    S00_AXI_araddr,
    S00_AXI_arburst,
    S00_AXI_arcache,
    S00_AXI_arid,
    S00_AXI_arlen,
    S00_AXI_arlock,
    S00_AXI_arprot,
    S00_AXI_arqos,
    S00_AXI_arready,
    S00_AXI_arsize,
    S00_AXI_arvalid,
    S00_AXI_awaddr,
    S00_AXI_awburst,
    S00_AXI_awcache,
    S00_AXI_awid,
    S00_AXI_awlen,
    S00_AXI_awlock,
    S00_AXI_awprot,
    S00_AXI_awqos,
    S00_AXI_awready,
    S00_AXI_awsize,
    S00_AXI_awvalid,
    S00_AXI_bid,
    S00_AXI_bready,
    S00_AXI_bresp,
    S00_AXI_bvalid,
    S00_AXI_rdata,
    S00_AXI_rid,
    S00_AXI_rlast,
    S00_AXI_rready,
    S00_AXI_rresp,
    S00_AXI_rvalid,
    S00_AXI_wdata,
    S00_AXI_wid,
    S00_AXI_wlast,
    S00_AXI_wready,
    S00_AXI_wstrb,
    S00_AXI_wvalid);
  input ACLK;
  input ARESETN;
  input M00_ACLK;
  input M00_ARESETN;
  output [31:0]M00_AXI_araddr;
  input [0:0]M00_AXI_arready;
  output [0:0]M00_AXI_arvalid;
  output [31:0]M00_AXI_awaddr;
  input [0:0]M00_AXI_awready;
  output [0:0]M00_AXI_awvalid;
  output [0:0]M00_AXI_bready;
  input [1:0]M00_AXI_bresp;
  input [0:0]M00_AXI_bvalid;
  input [31:0]M00_AXI_rdata;
  output [0:0]M00_AXI_rready;
  input [1:0]M00_AXI_rresp;
  input [0:0]M00_AXI_rvalid;
  output [31:0]M00_AXI_wdata;
  input [0:0]M00_AXI_wready;
  output [3:0]M00_AXI_wstrb;
  output [0:0]M00_AXI_wvalid;
  input M01_ACLK;
  input M01_ARESETN;
  output [31:0]M01_AXI_araddr;
  output [2:0]M01_AXI_arprot;
  input M01_AXI_arready;
  output M01_AXI_arvalid;
  output [31:0]M01_AXI_awaddr;
  output [2:0]M01_AXI_awprot;
  input M01_AXI_awready;
  output M01_AXI_awvalid;
  output M01_AXI_bready;
  input [1:0]M01_AXI_bresp;
  input M01_AXI_bvalid;
  input [31:0]M01_AXI_rdata;
  output M01_AXI_rready;
  input [1:0]M01_AXI_rresp;
  input M01_AXI_rvalid;
  output [31:0]M01_AXI_wdata;
  input M01_AXI_wready;
  output [3:0]M01_AXI_wstrb;
  output M01_AXI_wvalid;
  input S00_ACLK;
  input S00_ARESETN;
  input [31:0]S00_AXI_araddr;
  input [1:0]S00_AXI_arburst;
  input [3:0]S00_AXI_arcache;
  input [11:0]S00_AXI_arid;
  input [3:0]S00_AXI_arlen;
  input [1:0]S00_AXI_arlock;
  input [2:0]S00_AXI_arprot;
  input [3:0]S00_AXI_arqos;
  output S00_AXI_arready;
  input [2:0]S00_AXI_arsize;
  input S00_AXI_arvalid;
  input [31:0]S00_AXI_awaddr;
  input [1:0]S00_AXI_awburst;
  input [3:0]S00_AXI_awcache;
  input [11:0]S00_AXI_awid;
  input [3:0]S00_AXI_awlen;
  input [1:0]S00_AXI_awlock;
  input [2:0]S00_AXI_awprot;
  input [3:0]S00_AXI_awqos;
  output S00_AXI_awready;
  input [2:0]S00_AXI_awsize;
  input S00_AXI_awvalid;
  output [11:0]S00_AXI_bid;
  input S00_AXI_bready;
  output [1:0]S00_AXI_bresp;
  output S00_AXI_bvalid;
  output [31:0]S00_AXI_rdata;
  output [11:0]S00_AXI_rid;
  output S00_AXI_rlast;
  input S00_AXI_rready;
  output [1:0]S00_AXI_rresp;
  output S00_AXI_rvalid;
  input [31:0]S00_AXI_wdata;
  input [11:0]S00_AXI_wid;
  input S00_AXI_wlast;
  output S00_AXI_wready;
  input [3:0]S00_AXI_wstrb;
  input S00_AXI_wvalid;

  wire [31:0]m00_couplers_to_ps7_0_axi_periph_ARADDR;
  wire [0:0]m00_couplers_to_ps7_0_axi_periph_ARREADY;
  wire [0:0]m00_couplers_to_ps7_0_axi_periph_ARVALID;
  wire [31:0]m00_couplers_to_ps7_0_axi_periph_AWADDR;
  wire [0:0]m00_couplers_to_ps7_0_axi_periph_AWREADY;
  wire [0:0]m00_couplers_to_ps7_0_axi_periph_AWVALID;
  wire [0:0]m00_couplers_to_ps7_0_axi_periph_BREADY;
  wire [1:0]m00_couplers_to_ps7_0_axi_periph_BRESP;
  wire [0:0]m00_couplers_to_ps7_0_axi_periph_BVALID;
  wire [31:0]m00_couplers_to_ps7_0_axi_periph_RDATA;
  wire [0:0]m00_couplers_to_ps7_0_axi_periph_RREADY;
  wire [1:0]m00_couplers_to_ps7_0_axi_periph_RRESP;
  wire [0:0]m00_couplers_to_ps7_0_axi_periph_RVALID;
  wire [31:0]m00_couplers_to_ps7_0_axi_periph_WDATA;
  wire [0:0]m00_couplers_to_ps7_0_axi_periph_WREADY;
  wire [3:0]m00_couplers_to_ps7_0_axi_periph_WSTRB;
  wire [0:0]m00_couplers_to_ps7_0_axi_periph_WVALID;
  wire [31:0]m01_couplers_to_ps7_0_axi_periph_ARADDR;
  wire [2:0]m01_couplers_to_ps7_0_axi_periph_ARPROT;
  wire m01_couplers_to_ps7_0_axi_periph_ARREADY;
  wire m01_couplers_to_ps7_0_axi_periph_ARVALID;
  wire [31:0]m01_couplers_to_ps7_0_axi_periph_AWADDR;
  wire [2:0]m01_couplers_to_ps7_0_axi_periph_AWPROT;
  wire m01_couplers_to_ps7_0_axi_periph_AWREADY;
  wire m01_couplers_to_ps7_0_axi_periph_AWVALID;
  wire m01_couplers_to_ps7_0_axi_periph_BREADY;
  wire [1:0]m01_couplers_to_ps7_0_axi_periph_BRESP;
  wire m01_couplers_to_ps7_0_axi_periph_BVALID;
  wire [31:0]m01_couplers_to_ps7_0_axi_periph_RDATA;
  wire m01_couplers_to_ps7_0_axi_periph_RREADY;
  wire [1:0]m01_couplers_to_ps7_0_axi_periph_RRESP;
  wire m01_couplers_to_ps7_0_axi_periph_RVALID;
  wire [31:0]m01_couplers_to_ps7_0_axi_periph_WDATA;
  wire m01_couplers_to_ps7_0_axi_periph_WREADY;
  wire [3:0]m01_couplers_to_ps7_0_axi_periph_WSTRB;
  wire m01_couplers_to_ps7_0_axi_periph_WVALID;
  wire ps7_0_axi_periph_ACLK_net;
  wire ps7_0_axi_periph_ARESETN_net;
  wire [31:0]ps7_0_axi_periph_to_s00_couplers_ARADDR;
  wire [1:0]ps7_0_axi_periph_to_s00_couplers_ARBURST;
  wire [3:0]ps7_0_axi_periph_to_s00_couplers_ARCACHE;
  wire [11:0]ps7_0_axi_periph_to_s00_couplers_ARID;
  wire [3:0]ps7_0_axi_periph_to_s00_couplers_ARLEN;
  wire [1:0]ps7_0_axi_periph_to_s00_couplers_ARLOCK;
  wire [2:0]ps7_0_axi_periph_to_s00_couplers_ARPROT;
  wire [3:0]ps7_0_axi_periph_to_s00_couplers_ARQOS;
  wire ps7_0_axi_periph_to_s00_couplers_ARREADY;
  wire [2:0]ps7_0_axi_periph_to_s00_couplers_ARSIZE;
  wire ps7_0_axi_periph_to_s00_couplers_ARVALID;
  wire [31:0]ps7_0_axi_periph_to_s00_couplers_AWADDR;
  wire [1:0]ps7_0_axi_periph_to_s00_couplers_AWBURST;
  wire [3:0]ps7_0_axi_periph_to_s00_couplers_AWCACHE;
  wire [11:0]ps7_0_axi_periph_to_s00_couplers_AWID;
  wire [3:0]ps7_0_axi_periph_to_s00_couplers_AWLEN;
  wire [1:0]ps7_0_axi_periph_to_s00_couplers_AWLOCK;
  wire [2:0]ps7_0_axi_periph_to_s00_couplers_AWPROT;
  wire [3:0]ps7_0_axi_periph_to_s00_couplers_AWQOS;
  wire ps7_0_axi_periph_to_s00_couplers_AWREADY;
  wire [2:0]ps7_0_axi_periph_to_s00_couplers_AWSIZE;
  wire ps7_0_axi_periph_to_s00_couplers_AWVALID;
  wire [11:0]ps7_0_axi_periph_to_s00_couplers_BID;
  wire ps7_0_axi_periph_to_s00_couplers_BREADY;
  wire [1:0]ps7_0_axi_periph_to_s00_couplers_BRESP;
  wire ps7_0_axi_periph_to_s00_couplers_BVALID;
  wire [31:0]ps7_0_axi_periph_to_s00_couplers_RDATA;
  wire [11:0]ps7_0_axi_periph_to_s00_couplers_RID;
  wire ps7_0_axi_periph_to_s00_couplers_RLAST;
  wire ps7_0_axi_periph_to_s00_couplers_RREADY;
  wire [1:0]ps7_0_axi_periph_to_s00_couplers_RRESP;
  wire ps7_0_axi_periph_to_s00_couplers_RVALID;
  wire [31:0]ps7_0_axi_periph_to_s00_couplers_WDATA;
  wire [11:0]ps7_0_axi_periph_to_s00_couplers_WID;
  wire ps7_0_axi_periph_to_s00_couplers_WLAST;
  wire ps7_0_axi_periph_to_s00_couplers_WREADY;
  wire [3:0]ps7_0_axi_periph_to_s00_couplers_WSTRB;
  wire ps7_0_axi_periph_to_s00_couplers_WVALID;
  wire [31:0]s00_couplers_to_xbar_ARADDR;
  wire [2:0]s00_couplers_to_xbar_ARPROT;
  wire [0:0]s00_couplers_to_xbar_ARREADY;
  wire s00_couplers_to_xbar_ARVALID;
  wire [31:0]s00_couplers_to_xbar_AWADDR;
  wire [2:0]s00_couplers_to_xbar_AWPROT;
  wire [0:0]s00_couplers_to_xbar_AWREADY;
  wire s00_couplers_to_xbar_AWVALID;
  wire s00_couplers_to_xbar_BREADY;
  wire [1:0]s00_couplers_to_xbar_BRESP;
  wire [0:0]s00_couplers_to_xbar_BVALID;
  wire [31:0]s00_couplers_to_xbar_RDATA;
  wire s00_couplers_to_xbar_RREADY;
  wire [1:0]s00_couplers_to_xbar_RRESP;
  wire [0:0]s00_couplers_to_xbar_RVALID;
  wire [31:0]s00_couplers_to_xbar_WDATA;
  wire [0:0]s00_couplers_to_xbar_WREADY;
  wire [3:0]s00_couplers_to_xbar_WSTRB;
  wire s00_couplers_to_xbar_WVALID;
  wire [31:0]xbar_to_m00_couplers_ARADDR;
  wire [0:0]xbar_to_m00_couplers_ARREADY;
  wire [0:0]xbar_to_m00_couplers_ARVALID;
  wire [31:0]xbar_to_m00_couplers_AWADDR;
  wire [0:0]xbar_to_m00_couplers_AWREADY;
  wire [0:0]xbar_to_m00_couplers_AWVALID;
  wire [0:0]xbar_to_m00_couplers_BREADY;
  wire [1:0]xbar_to_m00_couplers_BRESP;
  wire [0:0]xbar_to_m00_couplers_BVALID;
  wire [31:0]xbar_to_m00_couplers_RDATA;
  wire [0:0]xbar_to_m00_couplers_RREADY;
  wire [1:0]xbar_to_m00_couplers_RRESP;
  wire [0:0]xbar_to_m00_couplers_RVALID;
  wire [31:0]xbar_to_m00_couplers_WDATA;
  wire [0:0]xbar_to_m00_couplers_WREADY;
  wire [3:0]xbar_to_m00_couplers_WSTRB;
  wire [0:0]xbar_to_m00_couplers_WVALID;
  wire [63:32]xbar_to_m01_couplers_ARADDR;
  wire [5:3]xbar_to_m01_couplers_ARPROT;
  wire xbar_to_m01_couplers_ARREADY;
  wire [1:1]xbar_to_m01_couplers_ARVALID;
  wire [63:32]xbar_to_m01_couplers_AWADDR;
  wire [5:3]xbar_to_m01_couplers_AWPROT;
  wire xbar_to_m01_couplers_AWREADY;
  wire [1:1]xbar_to_m01_couplers_AWVALID;
  wire [1:1]xbar_to_m01_couplers_BREADY;
  wire [1:0]xbar_to_m01_couplers_BRESP;
  wire xbar_to_m01_couplers_BVALID;
  wire [31:0]xbar_to_m01_couplers_RDATA;
  wire [1:1]xbar_to_m01_couplers_RREADY;
  wire [1:0]xbar_to_m01_couplers_RRESP;
  wire xbar_to_m01_couplers_RVALID;
  wire [63:32]xbar_to_m01_couplers_WDATA;
  wire xbar_to_m01_couplers_WREADY;
  wire [7:4]xbar_to_m01_couplers_WSTRB;
  wire [1:1]xbar_to_m01_couplers_WVALID;
  wire [5:0]NLW_xbar_m_axi_arprot_UNCONNECTED;
  wire [5:0]NLW_xbar_m_axi_awprot_UNCONNECTED;

  assign M00_AXI_araddr[31:0] = m00_couplers_to_ps7_0_axi_periph_ARADDR;
  assign M00_AXI_arvalid[0] = m00_couplers_to_ps7_0_axi_periph_ARVALID;
  assign M00_AXI_awaddr[31:0] = m00_couplers_to_ps7_0_axi_periph_AWADDR;
  assign M00_AXI_awvalid[0] = m00_couplers_to_ps7_0_axi_periph_AWVALID;
  assign M00_AXI_bready[0] = m00_couplers_to_ps7_0_axi_periph_BREADY;
  assign M00_AXI_rready[0] = m00_couplers_to_ps7_0_axi_periph_RREADY;
  assign M00_AXI_wdata[31:0] = m00_couplers_to_ps7_0_axi_periph_WDATA;
  assign M00_AXI_wstrb[3:0] = m00_couplers_to_ps7_0_axi_periph_WSTRB;
  assign M00_AXI_wvalid[0] = m00_couplers_to_ps7_0_axi_periph_WVALID;
  assign M01_AXI_araddr[31:0] = m01_couplers_to_ps7_0_axi_periph_ARADDR;
  assign M01_AXI_arprot[2:0] = m01_couplers_to_ps7_0_axi_periph_ARPROT;
  assign M01_AXI_arvalid = m01_couplers_to_ps7_0_axi_periph_ARVALID;
  assign M01_AXI_awaddr[31:0] = m01_couplers_to_ps7_0_axi_periph_AWADDR;
  assign M01_AXI_awprot[2:0] = m01_couplers_to_ps7_0_axi_periph_AWPROT;
  assign M01_AXI_awvalid = m01_couplers_to_ps7_0_axi_periph_AWVALID;
  assign M01_AXI_bready = m01_couplers_to_ps7_0_axi_periph_BREADY;
  assign M01_AXI_rready = m01_couplers_to_ps7_0_axi_periph_RREADY;
  assign M01_AXI_wdata[31:0] = m01_couplers_to_ps7_0_axi_periph_WDATA;
  assign M01_AXI_wstrb[3:0] = m01_couplers_to_ps7_0_axi_periph_WSTRB;
  assign M01_AXI_wvalid = m01_couplers_to_ps7_0_axi_periph_WVALID;
  assign S00_AXI_arready = ps7_0_axi_periph_to_s00_couplers_ARREADY;
  assign S00_AXI_awready = ps7_0_axi_periph_to_s00_couplers_AWREADY;
  assign S00_AXI_bid[11:0] = ps7_0_axi_periph_to_s00_couplers_BID;
  assign S00_AXI_bresp[1:0] = ps7_0_axi_periph_to_s00_couplers_BRESP;
  assign S00_AXI_bvalid = ps7_0_axi_periph_to_s00_couplers_BVALID;
  assign S00_AXI_rdata[31:0] = ps7_0_axi_periph_to_s00_couplers_RDATA;
  assign S00_AXI_rid[11:0] = ps7_0_axi_periph_to_s00_couplers_RID;
  assign S00_AXI_rlast = ps7_0_axi_periph_to_s00_couplers_RLAST;
  assign S00_AXI_rresp[1:0] = ps7_0_axi_periph_to_s00_couplers_RRESP;
  assign S00_AXI_rvalid = ps7_0_axi_periph_to_s00_couplers_RVALID;
  assign S00_AXI_wready = ps7_0_axi_periph_to_s00_couplers_WREADY;
  assign m00_couplers_to_ps7_0_axi_periph_ARREADY = M00_AXI_arready[0];
  assign m00_couplers_to_ps7_0_axi_periph_AWREADY = M00_AXI_awready[0];
  assign m00_couplers_to_ps7_0_axi_periph_BRESP = M00_AXI_bresp[1:0];
  assign m00_couplers_to_ps7_0_axi_periph_BVALID = M00_AXI_bvalid[0];
  assign m00_couplers_to_ps7_0_axi_periph_RDATA = M00_AXI_rdata[31:0];
  assign m00_couplers_to_ps7_0_axi_periph_RRESP = M00_AXI_rresp[1:0];
  assign m00_couplers_to_ps7_0_axi_periph_RVALID = M00_AXI_rvalid[0];
  assign m00_couplers_to_ps7_0_axi_periph_WREADY = M00_AXI_wready[0];
  assign m01_couplers_to_ps7_0_axi_periph_ARREADY = M01_AXI_arready;
  assign m01_couplers_to_ps7_0_axi_periph_AWREADY = M01_AXI_awready;
  assign m01_couplers_to_ps7_0_axi_periph_BRESP = M01_AXI_bresp[1:0];
  assign m01_couplers_to_ps7_0_axi_periph_BVALID = M01_AXI_bvalid;
  assign m01_couplers_to_ps7_0_axi_periph_RDATA = M01_AXI_rdata[31:0];
  assign m01_couplers_to_ps7_0_axi_periph_RRESP = M01_AXI_rresp[1:0];
  assign m01_couplers_to_ps7_0_axi_periph_RVALID = M01_AXI_rvalid;
  assign m01_couplers_to_ps7_0_axi_periph_WREADY = M01_AXI_wready;
  assign ps7_0_axi_periph_ACLK_net = ACLK;
  assign ps7_0_axi_periph_ARESETN_net = ARESETN;
  assign ps7_0_axi_periph_to_s00_couplers_ARADDR = S00_AXI_araddr[31:0];
  assign ps7_0_axi_periph_to_s00_couplers_ARBURST = S00_AXI_arburst[1:0];
  assign ps7_0_axi_periph_to_s00_couplers_ARCACHE = S00_AXI_arcache[3:0];
  assign ps7_0_axi_periph_to_s00_couplers_ARID = S00_AXI_arid[11:0];
  assign ps7_0_axi_periph_to_s00_couplers_ARLEN = S00_AXI_arlen[3:0];
  assign ps7_0_axi_periph_to_s00_couplers_ARLOCK = S00_AXI_arlock[1:0];
  assign ps7_0_axi_periph_to_s00_couplers_ARPROT = S00_AXI_arprot[2:0];
  assign ps7_0_axi_periph_to_s00_couplers_ARQOS = S00_AXI_arqos[3:0];
  assign ps7_0_axi_periph_to_s00_couplers_ARSIZE = S00_AXI_arsize[2:0];
  assign ps7_0_axi_periph_to_s00_couplers_ARVALID = S00_AXI_arvalid;
  assign ps7_0_axi_periph_to_s00_couplers_AWADDR = S00_AXI_awaddr[31:0];
  assign ps7_0_axi_periph_to_s00_couplers_AWBURST = S00_AXI_awburst[1:0];
  assign ps7_0_axi_periph_to_s00_couplers_AWCACHE = S00_AXI_awcache[3:0];
  assign ps7_0_axi_periph_to_s00_couplers_AWID = S00_AXI_awid[11:0];
  assign ps7_0_axi_periph_to_s00_couplers_AWLEN = S00_AXI_awlen[3:0];
  assign ps7_0_axi_periph_to_s00_couplers_AWLOCK = S00_AXI_awlock[1:0];
  assign ps7_0_axi_periph_to_s00_couplers_AWPROT = S00_AXI_awprot[2:0];
  assign ps7_0_axi_periph_to_s00_couplers_AWQOS = S00_AXI_awqos[3:0];
  assign ps7_0_axi_periph_to_s00_couplers_AWSIZE = S00_AXI_awsize[2:0];
  assign ps7_0_axi_periph_to_s00_couplers_AWVALID = S00_AXI_awvalid;
  assign ps7_0_axi_periph_to_s00_couplers_BREADY = S00_AXI_bready;
  assign ps7_0_axi_periph_to_s00_couplers_RREADY = S00_AXI_rready;
  assign ps7_0_axi_periph_to_s00_couplers_WDATA = S00_AXI_wdata[31:0];
  assign ps7_0_axi_periph_to_s00_couplers_WID = S00_AXI_wid[11:0];
  assign ps7_0_axi_periph_to_s00_couplers_WLAST = S00_AXI_wlast;
  assign ps7_0_axi_periph_to_s00_couplers_WSTRB = S00_AXI_wstrb[3:0];
  assign ps7_0_axi_periph_to_s00_couplers_WVALID = S00_AXI_wvalid;
  m00_couplers_imp_RXNZS0 m00_couplers
       (.M_ACLK(ps7_0_axi_periph_ACLK_net),
        .M_ARESETN(ps7_0_axi_periph_ARESETN_net),
        .M_AXI_araddr(m00_couplers_to_ps7_0_axi_periph_ARADDR),
        .M_AXI_arready(m00_couplers_to_ps7_0_axi_periph_ARREADY),
        .M_AXI_arvalid(m00_couplers_to_ps7_0_axi_periph_ARVALID),
        .M_AXI_awaddr(m00_couplers_to_ps7_0_axi_periph_AWADDR),
        .M_AXI_awready(m00_couplers_to_ps7_0_axi_periph_AWREADY),
        .M_AXI_awvalid(m00_couplers_to_ps7_0_axi_periph_AWVALID),
        .M_AXI_bready(m00_couplers_to_ps7_0_axi_periph_BREADY),
        .M_AXI_bresp(m00_couplers_to_ps7_0_axi_periph_BRESP),
        .M_AXI_bvalid(m00_couplers_to_ps7_0_axi_periph_BVALID),
        .M_AXI_rdata(m00_couplers_to_ps7_0_axi_periph_RDATA),
        .M_AXI_rready(m00_couplers_to_ps7_0_axi_periph_RREADY),
        .M_AXI_rresp(m00_couplers_to_ps7_0_axi_periph_RRESP),
        .M_AXI_rvalid(m00_couplers_to_ps7_0_axi_periph_RVALID),
        .M_AXI_wdata(m00_couplers_to_ps7_0_axi_periph_WDATA),
        .M_AXI_wready(m00_couplers_to_ps7_0_axi_periph_WREADY),
        .M_AXI_wstrb(m00_couplers_to_ps7_0_axi_periph_WSTRB),
        .M_AXI_wvalid(m00_couplers_to_ps7_0_axi_periph_WVALID),
        .S_ACLK(ps7_0_axi_periph_ACLK_net),
        .S_ARESETN(ps7_0_axi_periph_ARESETN_net),
        .S_AXI_araddr(xbar_to_m00_couplers_ARADDR),
        .S_AXI_arready(xbar_to_m00_couplers_ARREADY),
        .S_AXI_arvalid(xbar_to_m00_couplers_ARVALID),
        .S_AXI_awaddr(xbar_to_m00_couplers_AWADDR),
        .S_AXI_awready(xbar_to_m00_couplers_AWREADY),
        .S_AXI_awvalid(xbar_to_m00_couplers_AWVALID),
        .S_AXI_bready(xbar_to_m00_couplers_BREADY),
        .S_AXI_bresp(xbar_to_m00_couplers_BRESP),
        .S_AXI_bvalid(xbar_to_m00_couplers_BVALID),
        .S_AXI_rdata(xbar_to_m00_couplers_RDATA),
        .S_AXI_rready(xbar_to_m00_couplers_RREADY),
        .S_AXI_rresp(xbar_to_m00_couplers_RRESP),
        .S_AXI_rvalid(xbar_to_m00_couplers_RVALID),
        .S_AXI_wdata(xbar_to_m00_couplers_WDATA),
        .S_AXI_wready(xbar_to_m00_couplers_WREADY),
        .S_AXI_wstrb(xbar_to_m00_couplers_WSTRB),
        .S_AXI_wvalid(xbar_to_m00_couplers_WVALID));
  m01_couplers_imp_W1XWRK m01_couplers
       (.M_ACLK(ps7_0_axi_periph_ACLK_net),
        .M_ARESETN(ps7_0_axi_periph_ARESETN_net),
        .M_AXI_araddr(m01_couplers_to_ps7_0_axi_periph_ARADDR),
        .M_AXI_arprot(m01_couplers_to_ps7_0_axi_periph_ARPROT),
        .M_AXI_arready(m01_couplers_to_ps7_0_axi_periph_ARREADY),
        .M_AXI_arvalid(m01_couplers_to_ps7_0_axi_periph_ARVALID),
        .M_AXI_awaddr(m01_couplers_to_ps7_0_axi_periph_AWADDR),
        .M_AXI_awprot(m01_couplers_to_ps7_0_axi_periph_AWPROT),
        .M_AXI_awready(m01_couplers_to_ps7_0_axi_periph_AWREADY),
        .M_AXI_awvalid(m01_couplers_to_ps7_0_axi_periph_AWVALID),
        .M_AXI_bready(m01_couplers_to_ps7_0_axi_periph_BREADY),
        .M_AXI_bresp(m01_couplers_to_ps7_0_axi_periph_BRESP),
        .M_AXI_bvalid(m01_couplers_to_ps7_0_axi_periph_BVALID),
        .M_AXI_rdata(m01_couplers_to_ps7_0_axi_periph_RDATA),
        .M_AXI_rready(m01_couplers_to_ps7_0_axi_periph_RREADY),
        .M_AXI_rresp(m01_couplers_to_ps7_0_axi_periph_RRESP),
        .M_AXI_rvalid(m01_couplers_to_ps7_0_axi_periph_RVALID),
        .M_AXI_wdata(m01_couplers_to_ps7_0_axi_periph_WDATA),
        .M_AXI_wready(m01_couplers_to_ps7_0_axi_periph_WREADY),
        .M_AXI_wstrb(m01_couplers_to_ps7_0_axi_periph_WSTRB),
        .M_AXI_wvalid(m01_couplers_to_ps7_0_axi_periph_WVALID),
        .S_ACLK(ps7_0_axi_periph_ACLK_net),
        .S_ARESETN(ps7_0_axi_periph_ARESETN_net),
        .S_AXI_araddr(xbar_to_m01_couplers_ARADDR),
        .S_AXI_arprot(xbar_to_m01_couplers_ARPROT),
        .S_AXI_arready(xbar_to_m01_couplers_ARREADY),
        .S_AXI_arvalid(xbar_to_m01_couplers_ARVALID),
        .S_AXI_awaddr(xbar_to_m01_couplers_AWADDR),
        .S_AXI_awprot(xbar_to_m01_couplers_AWPROT),
        .S_AXI_awready(xbar_to_m01_couplers_AWREADY),
        .S_AXI_awvalid(xbar_to_m01_couplers_AWVALID),
        .S_AXI_bready(xbar_to_m01_couplers_BREADY),
        .S_AXI_bresp(xbar_to_m01_couplers_BRESP),
        .S_AXI_bvalid(xbar_to_m01_couplers_BVALID),
        .S_AXI_rdata(xbar_to_m01_couplers_RDATA),
        .S_AXI_rready(xbar_to_m01_couplers_RREADY),
        .S_AXI_rresp(xbar_to_m01_couplers_RRESP),
        .S_AXI_rvalid(xbar_to_m01_couplers_RVALID),
        .S_AXI_wdata(xbar_to_m01_couplers_WDATA),
        .S_AXI_wready(xbar_to_m01_couplers_WREADY),
        .S_AXI_wstrb(xbar_to_m01_couplers_WSTRB),
        .S_AXI_wvalid(xbar_to_m01_couplers_WVALID));
  s00_couplers_imp_XU79YR s00_couplers
       (.M_ACLK(ps7_0_axi_periph_ACLK_net),
        .M_ARESETN(ps7_0_axi_periph_ARESETN_net),
        .M_AXI_araddr(s00_couplers_to_xbar_ARADDR),
        .M_AXI_arprot(s00_couplers_to_xbar_ARPROT),
        .M_AXI_arready(s00_couplers_to_xbar_ARREADY),
        .M_AXI_arvalid(s00_couplers_to_xbar_ARVALID),
        .M_AXI_awaddr(s00_couplers_to_xbar_AWADDR),
        .M_AXI_awprot(s00_couplers_to_xbar_AWPROT),
        .M_AXI_awready(s00_couplers_to_xbar_AWREADY),
        .M_AXI_awvalid(s00_couplers_to_xbar_AWVALID),
        .M_AXI_bready(s00_couplers_to_xbar_BREADY),
        .M_AXI_bresp(s00_couplers_to_xbar_BRESP),
        .M_AXI_bvalid(s00_couplers_to_xbar_BVALID),
        .M_AXI_rdata(s00_couplers_to_xbar_RDATA),
        .M_AXI_rready(s00_couplers_to_xbar_RREADY),
        .M_AXI_rresp(s00_couplers_to_xbar_RRESP),
        .M_AXI_rvalid(s00_couplers_to_xbar_RVALID),
        .M_AXI_wdata(s00_couplers_to_xbar_WDATA),
        .M_AXI_wready(s00_couplers_to_xbar_WREADY),
        .M_AXI_wstrb(s00_couplers_to_xbar_WSTRB),
        .M_AXI_wvalid(s00_couplers_to_xbar_WVALID),
        .S_ACLK(ps7_0_axi_periph_ACLK_net),
        .S_ARESETN(ps7_0_axi_periph_ARESETN_net),
        .S_AXI_araddr(ps7_0_axi_periph_to_s00_couplers_ARADDR),
        .S_AXI_arburst(ps7_0_axi_periph_to_s00_couplers_ARBURST),
        .S_AXI_arcache(ps7_0_axi_periph_to_s00_couplers_ARCACHE),
        .S_AXI_arid(ps7_0_axi_periph_to_s00_couplers_ARID),
        .S_AXI_arlen(ps7_0_axi_periph_to_s00_couplers_ARLEN),
        .S_AXI_arlock(ps7_0_axi_periph_to_s00_couplers_ARLOCK),
        .S_AXI_arprot(ps7_0_axi_periph_to_s00_couplers_ARPROT),
        .S_AXI_arqos(ps7_0_axi_periph_to_s00_couplers_ARQOS),
        .S_AXI_arready(ps7_0_axi_periph_to_s00_couplers_ARREADY),
        .S_AXI_arsize(ps7_0_axi_periph_to_s00_couplers_ARSIZE),
        .S_AXI_arvalid(ps7_0_axi_periph_to_s00_couplers_ARVALID),
        .S_AXI_awaddr(ps7_0_axi_periph_to_s00_couplers_AWADDR),
        .S_AXI_awburst(ps7_0_axi_periph_to_s00_couplers_AWBURST),
        .S_AXI_awcache(ps7_0_axi_periph_to_s00_couplers_AWCACHE),
        .S_AXI_awid(ps7_0_axi_periph_to_s00_couplers_AWID),
        .S_AXI_awlen(ps7_0_axi_periph_to_s00_couplers_AWLEN),
        .S_AXI_awlock(ps7_0_axi_periph_to_s00_couplers_AWLOCK),
        .S_AXI_awprot(ps7_0_axi_periph_to_s00_couplers_AWPROT),
        .S_AXI_awqos(ps7_0_axi_periph_to_s00_couplers_AWQOS),
        .S_AXI_awready(ps7_0_axi_periph_to_s00_couplers_AWREADY),
        .S_AXI_awsize(ps7_0_axi_periph_to_s00_couplers_AWSIZE),
        .S_AXI_awvalid(ps7_0_axi_periph_to_s00_couplers_AWVALID),
        .S_AXI_bid(ps7_0_axi_periph_to_s00_couplers_BID),
        .S_AXI_bready(ps7_0_axi_periph_to_s00_couplers_BREADY),
        .S_AXI_bresp(ps7_0_axi_periph_to_s00_couplers_BRESP),
        .S_AXI_bvalid(ps7_0_axi_periph_to_s00_couplers_BVALID),
        .S_AXI_rdata(ps7_0_axi_periph_to_s00_couplers_RDATA),
        .S_AXI_rid(ps7_0_axi_periph_to_s00_couplers_RID),
        .S_AXI_rlast(ps7_0_axi_periph_to_s00_couplers_RLAST),
        .S_AXI_rready(ps7_0_axi_periph_to_s00_couplers_RREADY),
        .S_AXI_rresp(ps7_0_axi_periph_to_s00_couplers_RRESP),
        .S_AXI_rvalid(ps7_0_axi_periph_to_s00_couplers_RVALID),
        .S_AXI_wdata(ps7_0_axi_periph_to_s00_couplers_WDATA),
        .S_AXI_wid(ps7_0_axi_periph_to_s00_couplers_WID),
        .S_AXI_wlast(ps7_0_axi_periph_to_s00_couplers_WLAST),
        .S_AXI_wready(ps7_0_axi_periph_to_s00_couplers_WREADY),
        .S_AXI_wstrb(ps7_0_axi_periph_to_s00_couplers_WSTRB),
        .S_AXI_wvalid(ps7_0_axi_periph_to_s00_couplers_WVALID));
  MADC_ARTY_Z7_xbar_0 xbar
       (.aclk(ps7_0_axi_periph_ACLK_net),
        .aresetn(ps7_0_axi_periph_ARESETN_net),
        .m_axi_araddr({xbar_to_m01_couplers_ARADDR,xbar_to_m00_couplers_ARADDR}),
        .m_axi_arprot({xbar_to_m01_couplers_ARPROT,NLW_xbar_m_axi_arprot_UNCONNECTED[2:0]}),
        .m_axi_arready({xbar_to_m01_couplers_ARREADY,xbar_to_m00_couplers_ARREADY}),
        .m_axi_arvalid({xbar_to_m01_couplers_ARVALID,xbar_to_m00_couplers_ARVALID}),
        .m_axi_awaddr({xbar_to_m01_couplers_AWADDR,xbar_to_m00_couplers_AWADDR}),
        .m_axi_awprot({xbar_to_m01_couplers_AWPROT,NLW_xbar_m_axi_awprot_UNCONNECTED[2:0]}),
        .m_axi_awready({xbar_to_m01_couplers_AWREADY,xbar_to_m00_couplers_AWREADY}),
        .m_axi_awvalid({xbar_to_m01_couplers_AWVALID,xbar_to_m00_couplers_AWVALID}),
        .m_axi_bready({xbar_to_m01_couplers_BREADY,xbar_to_m00_couplers_BREADY}),
        .m_axi_bresp({xbar_to_m01_couplers_BRESP,xbar_to_m00_couplers_BRESP}),
        .m_axi_bvalid({xbar_to_m01_couplers_BVALID,xbar_to_m00_couplers_BVALID}),
        .m_axi_rdata({xbar_to_m01_couplers_RDATA,xbar_to_m00_couplers_RDATA}),
        .m_axi_rready({xbar_to_m01_couplers_RREADY,xbar_to_m00_couplers_RREADY}),
        .m_axi_rresp({xbar_to_m01_couplers_RRESP,xbar_to_m00_couplers_RRESP}),
        .m_axi_rvalid({xbar_to_m01_couplers_RVALID,xbar_to_m00_couplers_RVALID}),
        .m_axi_wdata({xbar_to_m01_couplers_WDATA,xbar_to_m00_couplers_WDATA}),
        .m_axi_wready({xbar_to_m01_couplers_WREADY,xbar_to_m00_couplers_WREADY}),
        .m_axi_wstrb({xbar_to_m01_couplers_WSTRB,xbar_to_m00_couplers_WSTRB}),
        .m_axi_wvalid({xbar_to_m01_couplers_WVALID,xbar_to_m00_couplers_WVALID}),
        .s_axi_araddr(s00_couplers_to_xbar_ARADDR),
        .s_axi_arprot(s00_couplers_to_xbar_ARPROT),
        .s_axi_arready(s00_couplers_to_xbar_ARREADY),
        .s_axi_arvalid(s00_couplers_to_xbar_ARVALID),
        .s_axi_awaddr(s00_couplers_to_xbar_AWADDR),
        .s_axi_awprot(s00_couplers_to_xbar_AWPROT),
        .s_axi_awready(s00_couplers_to_xbar_AWREADY),
        .s_axi_awvalid(s00_couplers_to_xbar_AWVALID),
        .s_axi_bready(s00_couplers_to_xbar_BREADY),
        .s_axi_bresp(s00_couplers_to_xbar_BRESP),
        .s_axi_bvalid(s00_couplers_to_xbar_BVALID),
        .s_axi_rdata(s00_couplers_to_xbar_RDATA),
        .s_axi_rready(s00_couplers_to_xbar_RREADY),
        .s_axi_rresp(s00_couplers_to_xbar_RRESP),
        .s_axi_rvalid(s00_couplers_to_xbar_RVALID),
        .s_axi_wdata(s00_couplers_to_xbar_WDATA),
        .s_axi_wready(s00_couplers_to_xbar_WREADY),
        .s_axi_wstrb(s00_couplers_to_xbar_WSTRB),
        .s_axi_wvalid(s00_couplers_to_xbar_WVALID));
endmodule

module m00_couplers_imp_RXNZS0
   (M_ACLK,
    M_ARESETN,
    M_AXI_araddr,
    M_AXI_arready,
    M_AXI_arvalid,
    M_AXI_awaddr,
    M_AXI_awready,
    M_AXI_awvalid,
    M_AXI_bready,
    M_AXI_bresp,
    M_AXI_bvalid,
    M_AXI_rdata,
    M_AXI_rready,
    M_AXI_rresp,
    M_AXI_rvalid,
    M_AXI_wdata,
    M_AXI_wready,
    M_AXI_wstrb,
    M_AXI_wvalid,
    S_ACLK,
    S_ARESETN,
    S_AXI_araddr,
    S_AXI_arready,
    S_AXI_arvalid,
    S_AXI_awaddr,
    S_AXI_awready,
    S_AXI_awvalid,
    S_AXI_bready,
    S_AXI_bresp,
    S_AXI_bvalid,
    S_AXI_rdata,
    S_AXI_rready,
    S_AXI_rresp,
    S_AXI_rvalid,
    S_AXI_wdata,
    S_AXI_wready,
    S_AXI_wstrb,
    S_AXI_wvalid);
  input M_ACLK;
  input M_ARESETN;
  output [31:0]M_AXI_araddr;
  input [0:0]M_AXI_arready;
  output [0:0]M_AXI_arvalid;
  output [31:0]M_AXI_awaddr;
  input [0:0]M_AXI_awready;
  output [0:0]M_AXI_awvalid;
  output [0:0]M_AXI_bready;
  input [1:0]M_AXI_bresp;
  input [0:0]M_AXI_bvalid;
  input [31:0]M_AXI_rdata;
  output [0:0]M_AXI_rready;
  input [1:0]M_AXI_rresp;
  input [0:0]M_AXI_rvalid;
  output [31:0]M_AXI_wdata;
  input [0:0]M_AXI_wready;
  output [3:0]M_AXI_wstrb;
  output [0:0]M_AXI_wvalid;
  input S_ACLK;
  input S_ARESETN;
  input [31:0]S_AXI_araddr;
  output [0:0]S_AXI_arready;
  input [0:0]S_AXI_arvalid;
  input [31:0]S_AXI_awaddr;
  output [0:0]S_AXI_awready;
  input [0:0]S_AXI_awvalid;
  input [0:0]S_AXI_bready;
  output [1:0]S_AXI_bresp;
  output [0:0]S_AXI_bvalid;
  output [31:0]S_AXI_rdata;
  input [0:0]S_AXI_rready;
  output [1:0]S_AXI_rresp;
  output [0:0]S_AXI_rvalid;
  input [31:0]S_AXI_wdata;
  output [0:0]S_AXI_wready;
  input [3:0]S_AXI_wstrb;
  input [0:0]S_AXI_wvalid;

  wire [31:0]m00_couplers_to_m00_couplers_ARADDR;
  wire [0:0]m00_couplers_to_m00_couplers_ARREADY;
  wire [0:0]m00_couplers_to_m00_couplers_ARVALID;
  wire [31:0]m00_couplers_to_m00_couplers_AWADDR;
  wire [0:0]m00_couplers_to_m00_couplers_AWREADY;
  wire [0:0]m00_couplers_to_m00_couplers_AWVALID;
  wire [0:0]m00_couplers_to_m00_couplers_BREADY;
  wire [1:0]m00_couplers_to_m00_couplers_BRESP;
  wire [0:0]m00_couplers_to_m00_couplers_BVALID;
  wire [31:0]m00_couplers_to_m00_couplers_RDATA;
  wire [0:0]m00_couplers_to_m00_couplers_RREADY;
  wire [1:0]m00_couplers_to_m00_couplers_RRESP;
  wire [0:0]m00_couplers_to_m00_couplers_RVALID;
  wire [31:0]m00_couplers_to_m00_couplers_WDATA;
  wire [0:0]m00_couplers_to_m00_couplers_WREADY;
  wire [3:0]m00_couplers_to_m00_couplers_WSTRB;
  wire [0:0]m00_couplers_to_m00_couplers_WVALID;

  assign M_AXI_araddr[31:0] = m00_couplers_to_m00_couplers_ARADDR;
  assign M_AXI_arvalid[0] = m00_couplers_to_m00_couplers_ARVALID;
  assign M_AXI_awaddr[31:0] = m00_couplers_to_m00_couplers_AWADDR;
  assign M_AXI_awvalid[0] = m00_couplers_to_m00_couplers_AWVALID;
  assign M_AXI_bready[0] = m00_couplers_to_m00_couplers_BREADY;
  assign M_AXI_rready[0] = m00_couplers_to_m00_couplers_RREADY;
  assign M_AXI_wdata[31:0] = m00_couplers_to_m00_couplers_WDATA;
  assign M_AXI_wstrb[3:0] = m00_couplers_to_m00_couplers_WSTRB;
  assign M_AXI_wvalid[0] = m00_couplers_to_m00_couplers_WVALID;
  assign S_AXI_arready[0] = m00_couplers_to_m00_couplers_ARREADY;
  assign S_AXI_awready[0] = m00_couplers_to_m00_couplers_AWREADY;
  assign S_AXI_bresp[1:0] = m00_couplers_to_m00_couplers_BRESP;
  assign S_AXI_bvalid[0] = m00_couplers_to_m00_couplers_BVALID;
  assign S_AXI_rdata[31:0] = m00_couplers_to_m00_couplers_RDATA;
  assign S_AXI_rresp[1:0] = m00_couplers_to_m00_couplers_RRESP;
  assign S_AXI_rvalid[0] = m00_couplers_to_m00_couplers_RVALID;
  assign S_AXI_wready[0] = m00_couplers_to_m00_couplers_WREADY;
  assign m00_couplers_to_m00_couplers_ARADDR = S_AXI_araddr[31:0];
  assign m00_couplers_to_m00_couplers_ARREADY = M_AXI_arready[0];
  assign m00_couplers_to_m00_couplers_ARVALID = S_AXI_arvalid[0];
  assign m00_couplers_to_m00_couplers_AWADDR = S_AXI_awaddr[31:0];
  assign m00_couplers_to_m00_couplers_AWREADY = M_AXI_awready[0];
  assign m00_couplers_to_m00_couplers_AWVALID = S_AXI_awvalid[0];
  assign m00_couplers_to_m00_couplers_BREADY = S_AXI_bready[0];
  assign m00_couplers_to_m00_couplers_BRESP = M_AXI_bresp[1:0];
  assign m00_couplers_to_m00_couplers_BVALID = M_AXI_bvalid[0];
  assign m00_couplers_to_m00_couplers_RDATA = M_AXI_rdata[31:0];
  assign m00_couplers_to_m00_couplers_RREADY = S_AXI_rready[0];
  assign m00_couplers_to_m00_couplers_RRESP = M_AXI_rresp[1:0];
  assign m00_couplers_to_m00_couplers_RVALID = M_AXI_rvalid[0];
  assign m00_couplers_to_m00_couplers_WDATA = S_AXI_wdata[31:0];
  assign m00_couplers_to_m00_couplers_WREADY = M_AXI_wready[0];
  assign m00_couplers_to_m00_couplers_WSTRB = S_AXI_wstrb[3:0];
  assign m00_couplers_to_m00_couplers_WVALID = S_AXI_wvalid[0];
endmodule

module m01_couplers_imp_W1XWRK
   (M_ACLK,
    M_ARESETN,
    M_AXI_araddr,
    M_AXI_arprot,
    M_AXI_arready,
    M_AXI_arvalid,
    M_AXI_awaddr,
    M_AXI_awprot,
    M_AXI_awready,
    M_AXI_awvalid,
    M_AXI_bready,
    M_AXI_bresp,
    M_AXI_bvalid,
    M_AXI_rdata,
    M_AXI_rready,
    M_AXI_rresp,
    M_AXI_rvalid,
    M_AXI_wdata,
    M_AXI_wready,
    M_AXI_wstrb,
    M_AXI_wvalid,
    S_ACLK,
    S_ARESETN,
    S_AXI_araddr,
    S_AXI_arprot,
    S_AXI_arready,
    S_AXI_arvalid,
    S_AXI_awaddr,
    S_AXI_awprot,
    S_AXI_awready,
    S_AXI_awvalid,
    S_AXI_bready,
    S_AXI_bresp,
    S_AXI_bvalid,
    S_AXI_rdata,
    S_AXI_rready,
    S_AXI_rresp,
    S_AXI_rvalid,
    S_AXI_wdata,
    S_AXI_wready,
    S_AXI_wstrb,
    S_AXI_wvalid);
  input M_ACLK;
  input M_ARESETN;
  output [31:0]M_AXI_araddr;
  output [2:0]M_AXI_arprot;
  input M_AXI_arready;
  output M_AXI_arvalid;
  output [31:0]M_AXI_awaddr;
  output [2:0]M_AXI_awprot;
  input M_AXI_awready;
  output M_AXI_awvalid;
  output M_AXI_bready;
  input [1:0]M_AXI_bresp;
  input M_AXI_bvalid;
  input [31:0]M_AXI_rdata;
  output M_AXI_rready;
  input [1:0]M_AXI_rresp;
  input M_AXI_rvalid;
  output [31:0]M_AXI_wdata;
  input M_AXI_wready;
  output [3:0]M_AXI_wstrb;
  output M_AXI_wvalid;
  input S_ACLK;
  input S_ARESETN;
  input [31:0]S_AXI_araddr;
  input [2:0]S_AXI_arprot;
  output S_AXI_arready;
  input S_AXI_arvalid;
  input [31:0]S_AXI_awaddr;
  input [2:0]S_AXI_awprot;
  output S_AXI_awready;
  input S_AXI_awvalid;
  input S_AXI_bready;
  output [1:0]S_AXI_bresp;
  output S_AXI_bvalid;
  output [31:0]S_AXI_rdata;
  input S_AXI_rready;
  output [1:0]S_AXI_rresp;
  output S_AXI_rvalid;
  input [31:0]S_AXI_wdata;
  output S_AXI_wready;
  input [3:0]S_AXI_wstrb;
  input S_AXI_wvalid;

  wire [31:0]m01_couplers_to_m01_couplers_ARADDR;
  wire [2:0]m01_couplers_to_m01_couplers_ARPROT;
  wire m01_couplers_to_m01_couplers_ARREADY;
  wire m01_couplers_to_m01_couplers_ARVALID;
  wire [31:0]m01_couplers_to_m01_couplers_AWADDR;
  wire [2:0]m01_couplers_to_m01_couplers_AWPROT;
  wire m01_couplers_to_m01_couplers_AWREADY;
  wire m01_couplers_to_m01_couplers_AWVALID;
  wire m01_couplers_to_m01_couplers_BREADY;
  wire [1:0]m01_couplers_to_m01_couplers_BRESP;
  wire m01_couplers_to_m01_couplers_BVALID;
  wire [31:0]m01_couplers_to_m01_couplers_RDATA;
  wire m01_couplers_to_m01_couplers_RREADY;
  wire [1:0]m01_couplers_to_m01_couplers_RRESP;
  wire m01_couplers_to_m01_couplers_RVALID;
  wire [31:0]m01_couplers_to_m01_couplers_WDATA;
  wire m01_couplers_to_m01_couplers_WREADY;
  wire [3:0]m01_couplers_to_m01_couplers_WSTRB;
  wire m01_couplers_to_m01_couplers_WVALID;

  assign M_AXI_araddr[31:0] = m01_couplers_to_m01_couplers_ARADDR;
  assign M_AXI_arprot[2:0] = m01_couplers_to_m01_couplers_ARPROT;
  assign M_AXI_arvalid = m01_couplers_to_m01_couplers_ARVALID;
  assign M_AXI_awaddr[31:0] = m01_couplers_to_m01_couplers_AWADDR;
  assign M_AXI_awprot[2:0] = m01_couplers_to_m01_couplers_AWPROT;
  assign M_AXI_awvalid = m01_couplers_to_m01_couplers_AWVALID;
  assign M_AXI_bready = m01_couplers_to_m01_couplers_BREADY;
  assign M_AXI_rready = m01_couplers_to_m01_couplers_RREADY;
  assign M_AXI_wdata[31:0] = m01_couplers_to_m01_couplers_WDATA;
  assign M_AXI_wstrb[3:0] = m01_couplers_to_m01_couplers_WSTRB;
  assign M_AXI_wvalid = m01_couplers_to_m01_couplers_WVALID;
  assign S_AXI_arready = m01_couplers_to_m01_couplers_ARREADY;
  assign S_AXI_awready = m01_couplers_to_m01_couplers_AWREADY;
  assign S_AXI_bresp[1:0] = m01_couplers_to_m01_couplers_BRESP;
  assign S_AXI_bvalid = m01_couplers_to_m01_couplers_BVALID;
  assign S_AXI_rdata[31:0] = m01_couplers_to_m01_couplers_RDATA;
  assign S_AXI_rresp[1:0] = m01_couplers_to_m01_couplers_RRESP;
  assign S_AXI_rvalid = m01_couplers_to_m01_couplers_RVALID;
  assign S_AXI_wready = m01_couplers_to_m01_couplers_WREADY;
  assign m01_couplers_to_m01_couplers_ARADDR = S_AXI_araddr[31:0];
  assign m01_couplers_to_m01_couplers_ARPROT = S_AXI_arprot[2:0];
  assign m01_couplers_to_m01_couplers_ARREADY = M_AXI_arready;
  assign m01_couplers_to_m01_couplers_ARVALID = S_AXI_arvalid;
  assign m01_couplers_to_m01_couplers_AWADDR = S_AXI_awaddr[31:0];
  assign m01_couplers_to_m01_couplers_AWPROT = S_AXI_awprot[2:0];
  assign m01_couplers_to_m01_couplers_AWREADY = M_AXI_awready;
  assign m01_couplers_to_m01_couplers_AWVALID = S_AXI_awvalid;
  assign m01_couplers_to_m01_couplers_BREADY = S_AXI_bready;
  assign m01_couplers_to_m01_couplers_BRESP = M_AXI_bresp[1:0];
  assign m01_couplers_to_m01_couplers_BVALID = M_AXI_bvalid;
  assign m01_couplers_to_m01_couplers_RDATA = M_AXI_rdata[31:0];
  assign m01_couplers_to_m01_couplers_RREADY = S_AXI_rready;
  assign m01_couplers_to_m01_couplers_RRESP = M_AXI_rresp[1:0];
  assign m01_couplers_to_m01_couplers_RVALID = M_AXI_rvalid;
  assign m01_couplers_to_m01_couplers_WDATA = S_AXI_wdata[31:0];
  assign m01_couplers_to_m01_couplers_WREADY = M_AXI_wready;
  assign m01_couplers_to_m01_couplers_WSTRB = S_AXI_wstrb[3:0];
  assign m01_couplers_to_m01_couplers_WVALID = S_AXI_wvalid;
endmodule

module s00_couplers_imp_XU79YR
   (M_ACLK,
    M_ARESETN,
    M_AXI_araddr,
    M_AXI_arprot,
    M_AXI_arready,
    M_AXI_arvalid,
    M_AXI_awaddr,
    M_AXI_awprot,
    M_AXI_awready,
    M_AXI_awvalid,
    M_AXI_bready,
    M_AXI_bresp,
    M_AXI_bvalid,
    M_AXI_rdata,
    M_AXI_rready,
    M_AXI_rresp,
    M_AXI_rvalid,
    M_AXI_wdata,
    M_AXI_wready,
    M_AXI_wstrb,
    M_AXI_wvalid,
    S_ACLK,
    S_ARESETN,
    S_AXI_araddr,
    S_AXI_arburst,
    S_AXI_arcache,
    S_AXI_arid,
    S_AXI_arlen,
    S_AXI_arlock,
    S_AXI_arprot,
    S_AXI_arqos,
    S_AXI_arready,
    S_AXI_arsize,
    S_AXI_arvalid,
    S_AXI_awaddr,
    S_AXI_awburst,
    S_AXI_awcache,
    S_AXI_awid,
    S_AXI_awlen,
    S_AXI_awlock,
    S_AXI_awprot,
    S_AXI_awqos,
    S_AXI_awready,
    S_AXI_awsize,
    S_AXI_awvalid,
    S_AXI_bid,
    S_AXI_bready,
    S_AXI_bresp,
    S_AXI_bvalid,
    S_AXI_rdata,
    S_AXI_rid,
    S_AXI_rlast,
    S_AXI_rready,
    S_AXI_rresp,
    S_AXI_rvalid,
    S_AXI_wdata,
    S_AXI_wid,
    S_AXI_wlast,
    S_AXI_wready,
    S_AXI_wstrb,
    S_AXI_wvalid);
  input M_ACLK;
  input M_ARESETN;
  output [31:0]M_AXI_araddr;
  output [2:0]M_AXI_arprot;
  input M_AXI_arready;
  output M_AXI_arvalid;
  output [31:0]M_AXI_awaddr;
  output [2:0]M_AXI_awprot;
  input M_AXI_awready;
  output M_AXI_awvalid;
  output M_AXI_bready;
  input [1:0]M_AXI_bresp;
  input M_AXI_bvalid;
  input [31:0]M_AXI_rdata;
  output M_AXI_rready;
  input [1:0]M_AXI_rresp;
  input M_AXI_rvalid;
  output [31:0]M_AXI_wdata;
  input M_AXI_wready;
  output [3:0]M_AXI_wstrb;
  output M_AXI_wvalid;
  input S_ACLK;
  input S_ARESETN;
  input [31:0]S_AXI_araddr;
  input [1:0]S_AXI_arburst;
  input [3:0]S_AXI_arcache;
  input [11:0]S_AXI_arid;
  input [3:0]S_AXI_arlen;
  input [1:0]S_AXI_arlock;
  input [2:0]S_AXI_arprot;
  input [3:0]S_AXI_arqos;
  output S_AXI_arready;
  input [2:0]S_AXI_arsize;
  input S_AXI_arvalid;
  input [31:0]S_AXI_awaddr;
  input [1:0]S_AXI_awburst;
  input [3:0]S_AXI_awcache;
  input [11:0]S_AXI_awid;
  input [3:0]S_AXI_awlen;
  input [1:0]S_AXI_awlock;
  input [2:0]S_AXI_awprot;
  input [3:0]S_AXI_awqos;
  output S_AXI_awready;
  input [2:0]S_AXI_awsize;
  input S_AXI_awvalid;
  output [11:0]S_AXI_bid;
  input S_AXI_bready;
  output [1:0]S_AXI_bresp;
  output S_AXI_bvalid;
  output [31:0]S_AXI_rdata;
  output [11:0]S_AXI_rid;
  output S_AXI_rlast;
  input S_AXI_rready;
  output [1:0]S_AXI_rresp;
  output S_AXI_rvalid;
  input [31:0]S_AXI_wdata;
  input [11:0]S_AXI_wid;
  input S_AXI_wlast;
  output S_AXI_wready;
  input [3:0]S_AXI_wstrb;
  input S_AXI_wvalid;

  wire S_ACLK_1;
  wire S_ARESETN_1;
  wire [31:0]auto_pc_to_s00_couplers_ARADDR;
  wire [2:0]auto_pc_to_s00_couplers_ARPROT;
  wire auto_pc_to_s00_couplers_ARREADY;
  wire auto_pc_to_s00_couplers_ARVALID;
  wire [31:0]auto_pc_to_s00_couplers_AWADDR;
  wire [2:0]auto_pc_to_s00_couplers_AWPROT;
  wire auto_pc_to_s00_couplers_AWREADY;
  wire auto_pc_to_s00_couplers_AWVALID;
  wire auto_pc_to_s00_couplers_BREADY;
  wire [1:0]auto_pc_to_s00_couplers_BRESP;
  wire auto_pc_to_s00_couplers_BVALID;
  wire [31:0]auto_pc_to_s00_couplers_RDATA;
  wire auto_pc_to_s00_couplers_RREADY;
  wire [1:0]auto_pc_to_s00_couplers_RRESP;
  wire auto_pc_to_s00_couplers_RVALID;
  wire [31:0]auto_pc_to_s00_couplers_WDATA;
  wire auto_pc_to_s00_couplers_WREADY;
  wire [3:0]auto_pc_to_s00_couplers_WSTRB;
  wire auto_pc_to_s00_couplers_WVALID;
  wire [31:0]s00_couplers_to_auto_pc_ARADDR;
  wire [1:0]s00_couplers_to_auto_pc_ARBURST;
  wire [3:0]s00_couplers_to_auto_pc_ARCACHE;
  wire [11:0]s00_couplers_to_auto_pc_ARID;
  wire [3:0]s00_couplers_to_auto_pc_ARLEN;
  wire [1:0]s00_couplers_to_auto_pc_ARLOCK;
  wire [2:0]s00_couplers_to_auto_pc_ARPROT;
  wire [3:0]s00_couplers_to_auto_pc_ARQOS;
  wire s00_couplers_to_auto_pc_ARREADY;
  wire [2:0]s00_couplers_to_auto_pc_ARSIZE;
  wire s00_couplers_to_auto_pc_ARVALID;
  wire [31:0]s00_couplers_to_auto_pc_AWADDR;
  wire [1:0]s00_couplers_to_auto_pc_AWBURST;
  wire [3:0]s00_couplers_to_auto_pc_AWCACHE;
  wire [11:0]s00_couplers_to_auto_pc_AWID;
  wire [3:0]s00_couplers_to_auto_pc_AWLEN;
  wire [1:0]s00_couplers_to_auto_pc_AWLOCK;
  wire [2:0]s00_couplers_to_auto_pc_AWPROT;
  wire [3:0]s00_couplers_to_auto_pc_AWQOS;
  wire s00_couplers_to_auto_pc_AWREADY;
  wire [2:0]s00_couplers_to_auto_pc_AWSIZE;
  wire s00_couplers_to_auto_pc_AWVALID;
  wire [11:0]s00_couplers_to_auto_pc_BID;
  wire s00_couplers_to_auto_pc_BREADY;
  wire [1:0]s00_couplers_to_auto_pc_BRESP;
  wire s00_couplers_to_auto_pc_BVALID;
  wire [31:0]s00_couplers_to_auto_pc_RDATA;
  wire [11:0]s00_couplers_to_auto_pc_RID;
  wire s00_couplers_to_auto_pc_RLAST;
  wire s00_couplers_to_auto_pc_RREADY;
  wire [1:0]s00_couplers_to_auto_pc_RRESP;
  wire s00_couplers_to_auto_pc_RVALID;
  wire [31:0]s00_couplers_to_auto_pc_WDATA;
  wire [11:0]s00_couplers_to_auto_pc_WID;
  wire s00_couplers_to_auto_pc_WLAST;
  wire s00_couplers_to_auto_pc_WREADY;
  wire [3:0]s00_couplers_to_auto_pc_WSTRB;
  wire s00_couplers_to_auto_pc_WVALID;

  assign M_AXI_araddr[31:0] = auto_pc_to_s00_couplers_ARADDR;
  assign M_AXI_arprot[2:0] = auto_pc_to_s00_couplers_ARPROT;
  assign M_AXI_arvalid = auto_pc_to_s00_couplers_ARVALID;
  assign M_AXI_awaddr[31:0] = auto_pc_to_s00_couplers_AWADDR;
  assign M_AXI_awprot[2:0] = auto_pc_to_s00_couplers_AWPROT;
  assign M_AXI_awvalid = auto_pc_to_s00_couplers_AWVALID;
  assign M_AXI_bready = auto_pc_to_s00_couplers_BREADY;
  assign M_AXI_rready = auto_pc_to_s00_couplers_RREADY;
  assign M_AXI_wdata[31:0] = auto_pc_to_s00_couplers_WDATA;
  assign M_AXI_wstrb[3:0] = auto_pc_to_s00_couplers_WSTRB;
  assign M_AXI_wvalid = auto_pc_to_s00_couplers_WVALID;
  assign S_ACLK_1 = S_ACLK;
  assign S_ARESETN_1 = S_ARESETN;
  assign S_AXI_arready = s00_couplers_to_auto_pc_ARREADY;
  assign S_AXI_awready = s00_couplers_to_auto_pc_AWREADY;
  assign S_AXI_bid[11:0] = s00_couplers_to_auto_pc_BID;
  assign S_AXI_bresp[1:0] = s00_couplers_to_auto_pc_BRESP;
  assign S_AXI_bvalid = s00_couplers_to_auto_pc_BVALID;
  assign S_AXI_rdata[31:0] = s00_couplers_to_auto_pc_RDATA;
  assign S_AXI_rid[11:0] = s00_couplers_to_auto_pc_RID;
  assign S_AXI_rlast = s00_couplers_to_auto_pc_RLAST;
  assign S_AXI_rresp[1:0] = s00_couplers_to_auto_pc_RRESP;
  assign S_AXI_rvalid = s00_couplers_to_auto_pc_RVALID;
  assign S_AXI_wready = s00_couplers_to_auto_pc_WREADY;
  assign auto_pc_to_s00_couplers_ARREADY = M_AXI_arready;
  assign auto_pc_to_s00_couplers_AWREADY = M_AXI_awready;
  assign auto_pc_to_s00_couplers_BRESP = M_AXI_bresp[1:0];
  assign auto_pc_to_s00_couplers_BVALID = M_AXI_bvalid;
  assign auto_pc_to_s00_couplers_RDATA = M_AXI_rdata[31:0];
  assign auto_pc_to_s00_couplers_RRESP = M_AXI_rresp[1:0];
  assign auto_pc_to_s00_couplers_RVALID = M_AXI_rvalid;
  assign auto_pc_to_s00_couplers_WREADY = M_AXI_wready;
  assign s00_couplers_to_auto_pc_ARADDR = S_AXI_araddr[31:0];
  assign s00_couplers_to_auto_pc_ARBURST = S_AXI_arburst[1:0];
  assign s00_couplers_to_auto_pc_ARCACHE = S_AXI_arcache[3:0];
  assign s00_couplers_to_auto_pc_ARID = S_AXI_arid[11:0];
  assign s00_couplers_to_auto_pc_ARLEN = S_AXI_arlen[3:0];
  assign s00_couplers_to_auto_pc_ARLOCK = S_AXI_arlock[1:0];
  assign s00_couplers_to_auto_pc_ARPROT = S_AXI_arprot[2:0];
  assign s00_couplers_to_auto_pc_ARQOS = S_AXI_arqos[3:0];
  assign s00_couplers_to_auto_pc_ARSIZE = S_AXI_arsize[2:0];
  assign s00_couplers_to_auto_pc_ARVALID = S_AXI_arvalid;
  assign s00_couplers_to_auto_pc_AWADDR = S_AXI_awaddr[31:0];
  assign s00_couplers_to_auto_pc_AWBURST = S_AXI_awburst[1:0];
  assign s00_couplers_to_auto_pc_AWCACHE = S_AXI_awcache[3:0];
  assign s00_couplers_to_auto_pc_AWID = S_AXI_awid[11:0];
  assign s00_couplers_to_auto_pc_AWLEN = S_AXI_awlen[3:0];
  assign s00_couplers_to_auto_pc_AWLOCK = S_AXI_awlock[1:0];
  assign s00_couplers_to_auto_pc_AWPROT = S_AXI_awprot[2:0];
  assign s00_couplers_to_auto_pc_AWQOS = S_AXI_awqos[3:0];
  assign s00_couplers_to_auto_pc_AWSIZE = S_AXI_awsize[2:0];
  assign s00_couplers_to_auto_pc_AWVALID = S_AXI_awvalid;
  assign s00_couplers_to_auto_pc_BREADY = S_AXI_bready;
  assign s00_couplers_to_auto_pc_RREADY = S_AXI_rready;
  assign s00_couplers_to_auto_pc_WDATA = S_AXI_wdata[31:0];
  assign s00_couplers_to_auto_pc_WID = S_AXI_wid[11:0];
  assign s00_couplers_to_auto_pc_WLAST = S_AXI_wlast;
  assign s00_couplers_to_auto_pc_WSTRB = S_AXI_wstrb[3:0];
  assign s00_couplers_to_auto_pc_WVALID = S_AXI_wvalid;
  MADC_ARTY_Z7_auto_pc_0 auto_pc
       (.aclk(S_ACLK_1),
        .aresetn(S_ARESETN_1),
        .m_axi_araddr(auto_pc_to_s00_couplers_ARADDR),
        .m_axi_arprot(auto_pc_to_s00_couplers_ARPROT),
        .m_axi_arready(auto_pc_to_s00_couplers_ARREADY),
        .m_axi_arvalid(auto_pc_to_s00_couplers_ARVALID),
        .m_axi_awaddr(auto_pc_to_s00_couplers_AWADDR),
        .m_axi_awprot(auto_pc_to_s00_couplers_AWPROT),
        .m_axi_awready(auto_pc_to_s00_couplers_AWREADY),
        .m_axi_awvalid(auto_pc_to_s00_couplers_AWVALID),
        .m_axi_bready(auto_pc_to_s00_couplers_BREADY),
        .m_axi_bresp(auto_pc_to_s00_couplers_BRESP),
        .m_axi_bvalid(auto_pc_to_s00_couplers_BVALID),
        .m_axi_rdata(auto_pc_to_s00_couplers_RDATA),
        .m_axi_rready(auto_pc_to_s00_couplers_RREADY),
        .m_axi_rresp(auto_pc_to_s00_couplers_RRESP),
        .m_axi_rvalid(auto_pc_to_s00_couplers_RVALID),
        .m_axi_wdata(auto_pc_to_s00_couplers_WDATA),
        .m_axi_wready(auto_pc_to_s00_couplers_WREADY),
        .m_axi_wstrb(auto_pc_to_s00_couplers_WSTRB),
        .m_axi_wvalid(auto_pc_to_s00_couplers_WVALID),
        .s_axi_araddr(s00_couplers_to_auto_pc_ARADDR),
        .s_axi_arburst(s00_couplers_to_auto_pc_ARBURST),
        .s_axi_arcache(s00_couplers_to_auto_pc_ARCACHE),
        .s_axi_arid(s00_couplers_to_auto_pc_ARID),
        .s_axi_arlen(s00_couplers_to_auto_pc_ARLEN),
        .s_axi_arlock(s00_couplers_to_auto_pc_ARLOCK),
        .s_axi_arprot(s00_couplers_to_auto_pc_ARPROT),
        .s_axi_arqos(s00_couplers_to_auto_pc_ARQOS),
        .s_axi_arready(s00_couplers_to_auto_pc_ARREADY),
        .s_axi_arsize(s00_couplers_to_auto_pc_ARSIZE),
        .s_axi_arvalid(s00_couplers_to_auto_pc_ARVALID),
        .s_axi_awaddr(s00_couplers_to_auto_pc_AWADDR),
        .s_axi_awburst(s00_couplers_to_auto_pc_AWBURST),
        .s_axi_awcache(s00_couplers_to_auto_pc_AWCACHE),
        .s_axi_awid(s00_couplers_to_auto_pc_AWID),
        .s_axi_awlen(s00_couplers_to_auto_pc_AWLEN),
        .s_axi_awlock(s00_couplers_to_auto_pc_AWLOCK),
        .s_axi_awprot(s00_couplers_to_auto_pc_AWPROT),
        .s_axi_awqos(s00_couplers_to_auto_pc_AWQOS),
        .s_axi_awready(s00_couplers_to_auto_pc_AWREADY),
        .s_axi_awsize(s00_couplers_to_auto_pc_AWSIZE),
        .s_axi_awvalid(s00_couplers_to_auto_pc_AWVALID),
        .s_axi_bid(s00_couplers_to_auto_pc_BID),
        .s_axi_bready(s00_couplers_to_auto_pc_BREADY),
        .s_axi_bresp(s00_couplers_to_auto_pc_BRESP),
        .s_axi_bvalid(s00_couplers_to_auto_pc_BVALID),
        .s_axi_rdata(s00_couplers_to_auto_pc_RDATA),
        .s_axi_rid(s00_couplers_to_auto_pc_RID),
        .s_axi_rlast(s00_couplers_to_auto_pc_RLAST),
        .s_axi_rready(s00_couplers_to_auto_pc_RREADY),
        .s_axi_rresp(s00_couplers_to_auto_pc_RRESP),
        .s_axi_rvalid(s00_couplers_to_auto_pc_RVALID),
        .s_axi_wdata(s00_couplers_to_auto_pc_WDATA),
        .s_axi_wid(s00_couplers_to_auto_pc_WID),
        .s_axi_wlast(s00_couplers_to_auto_pc_WLAST),
        .s_axi_wready(s00_couplers_to_auto_pc_WREADY),
        .s_axi_wstrb(s00_couplers_to_auto_pc_WSTRB),
        .s_axi_wvalid(s00_couplers_to_auto_pc_WVALID));
endmodule
