BehrensG/MADC_ARTY/Software/vivado/MADC_ARTY_Z7/MADC_ARTY_Z7.gen/sources_1/bd/MADC_ARTY_Z7/ip/MADC_ARTY_Z7_processing_system7_0_0/MADC_ARTY_Z7_processing_system7_0_0_stub.v

// Copyright 1986-2022 Xilinx, Inc. All Rights Reserved.
// Copyright 2022-2024 Advanced Micro Devices, Inc. All Rights Reserved.
// --------------------------------------------------------------------------------
// Tool Version: Vivado v.2024.1 (lin64) Build 5076996 Wed May 22 18:36:09 MDT 2024
// Date        : Thu Sep  3 18:55:54 2026
// Host        : archlinux running 64-bit Arch Linux
// Command     : write_verilog -force -mode synth_stub
//               /home/grzegorz/git/MADC_ARTY/Software/vivado/MADC_ARTY_Z7/MADC_ARTY_Z7.gen/sources_1/bd/MADC_ARTY_Z7/ip/MADC_ARTY_Z7_processing_system7_0_0/MADC_ARTY_Z7_processing_system7_0_0_stub.v
// Design      : MADC_ARTY_Z7_processing_system7_0_0
// Purpose     : Stub declaration of top-level module interface
// Device      : xc7z010clg400-1
// --------------------------------------------------------------------------------

// This empty module with port declaration file causes synthesis tools to infer a black box for IP.
// The synthesis directives are for Synopsys Synplify support to prevent IO buffer insertion.
// Please paste the declaration into a Verilog source file or add the file as an additional source.
(* X_CORE_INFO = "processing_system7_v5_5_processing_system7,Vivado 2024.1" *)
module MADC_ARTY_Z7_processing_system7_0_0(USB0_PORT_INDCTL, USB0_VBUS_PWRSELECT, 
  USB0_VBUS_PWRFAULT, M_AXI_GP0_ARVALID, M_AXI_GP0_AWVALID, M_AXI_GP0_BREADY, 
  M_AXI_GP0_RREADY, M_AXI_GP0_WLAST, M_AXI_GP0_WVALID, M_AXI_GP0_ARID, M_AXI_GP0_AWID, 
  M_AXI_GP0_WID, M_AXI_GP0_ARBURST, M_AXI_GP0_ARLOCK, M_AXI_GP0_ARSIZE, M_AXI_GP0_AWBURST, 
  M_AXI_GP0_AWLOCK, M_AXI_GP0_AWSIZE, M_AXI_GP0_ARPROT, M_AXI_GP0_AWPROT, M_AXI_GP0_ARADDR, 
  M_AXI_GP0_AWADDR, M_AXI_GP0_WDATA, M_AXI_GP0_ARCACHE, M_AXI_GP0_ARLEN, M_AXI_GP0_ARQOS, 
  M_AXI_GP0_AWCACHE, M_AXI_GP0_AWLEN, M_AXI_GP0_AWQOS, M_AXI_GP0_WSTRB, M_AXI_GP0_ACLK, 
  M_AXI_GP0_ARREADY, M_AXI_GP0_AWREADY, M_AXI_GP0_BVALID, M_AXI_GP0_RLAST, 
  M_AXI_GP0_RVALID, M_AXI_GP0_WREADY, M_AXI_GP0_BID, M_AXI_GP0_RID, M_AXI_GP0_BRESP, 
  M_AXI_GP0_RRESP, M_AXI_GP0_RDATA, FCLK_CLK0, FCLK_RESET0_N, MIO, DDR_CAS_n, DDR_CKE, DDR_Clk_n, 
  DDR_Clk, DDR_CS_n, DDR_DRSTB, DDR_ODT, DDR_RAS_n, DDR_WEB, DDR_BankAddr, DDR_Addr, DDR_VRN, 
  DDR_VRP, DDR_DM, DDR_DQ, DDR_DQS_n, DDR_DQS, PS_SRSTB, PS_CLK, PS_PORB)
/* synthesis syn_black_box black_box_pad_pin="USB0_PORT_INDCTL[1:0],USB0_VBUS_PWRSELECT,USB0_VBUS_PWRFAULT,M_AXI_GP0_ARVALID,M_AXI_GP0_AWVALID,M_AXI_GP0_BREADY,M_AXI_GP0_RREADY,M_AXI_GP0_WLAST,M_AXI_GP0_WVALID,M_AXI_GP0_ARID[11:0],M_AXI_GP0_AWID[11:0],M_AXI_GP0_WID[11:0],M_AXI_GP0_ARBURST[1:0],M_AXI_GP0_ARLOCK[1:0],M_AXI_GP0_ARSIZE[2:0],M_AXI_GP0_AWBURST[1:0],M_AXI_GP0_AWLOCK[1:0],M_AXI_GP0_AWSIZE[2:0],M_AXI_GP0_ARPROT[2:0],M_AXI_GP0_AWPROT[2:0],M_AXI_GP0_ARADDR[31:0],M_AXI_GP0_AWADDR[31:0],M_AXI_GP0_WDATA[31:0],M_AXI_GP0_ARCACHE[3:0],M_AXI_GP0_ARLEN[3:0],M_AXI_GP0_ARQOS[3:0],M_AXI_GP0_AWCACHE[3:0],M_AXI_GP0_AWLEN[3:0],M_AXI_GP0_AWQOS[3:0],M_AXI_GP0_WSTRB[3:0],M_AXI_GP0_ARREADY,M_AXI_GP0_AWREADY,M_AXI_GP0_BVALID,M_AXI_GP0_RLAST,M_AXI_GP0_RVALID,M_AXI_GP0_WREADY,M_AXI_GP0_BID[11:0],M_AXI_GP0_RID[11:0],M_AXI_GP0_BRESP[1:0],M_AXI_GP0_RRESP[1:0],M_AXI_GP0_RDATA[31:0],FCLK_RESET0_N,MIO[53:0],DDR_CAS_n,DDR_CKE,DDR_Clk_n,DDR_Clk,DDR_CS_n,DDR_DRSTB,DDR_ODT,DDR_RAS_n,DDR_WEB,DDR_BankAddr[2:0],DDR_Addr[14:0],DDR_VRN,DDR_VRP,DDR_DM[3:0],DDR_DQ[31:0],DDR_DQS_n[3:0],DDR_DQS[3:0],PS_SRSTB,PS_CLK,PS_PORB" */
/* synthesis syn_force_seq_prim="M_AXI_GP0_ACLK" */
/* synthesis syn_force_seq_prim="FCLK_CLK0" */;
  output [1:0]USB0_PORT_INDCTL;
  output USB0_VBUS_PWRSELECT;
  input USB0_VBUS_PWRFAULT;
  output M_AXI_GP0_ARVALID;
  output M_AXI_GP0_AWVALID;
  output M_AXI_GP0_BREADY;
  output M_AXI_GP0_RREADY;
  output M_AXI_GP0_WLAST;
  output M_AXI_GP0_WVALID;
  output [11:0]M_AXI_GP0_ARID;
  output [11:0]M_AXI_GP0_AWID;
  output [11:0]M_AXI_GP0_WID;
  output [1:0]M_AXI_GP0_ARBURST;
  output [1:0]M_AXI_GP0_ARLOCK;
  output [2:0]M_AXI_GP0_ARSIZE;
  output [1:0]M_AXI_GP0_AWBURST;
  output [1:0]M_AXI_GP0_AWLOCK;
  output [2:0]M_AXI_GP0_AWSIZE;
  output [2:0]M_AXI_GP0_ARPROT;
  output [2:0]M_AXI_GP0_AWPROT;
  output [31:0]M_AXI_GP0_ARADDR;
  output [31:0]M_AXI_GP0_AWADDR;
  output [31:0]M_AXI_GP0_WDATA;
  output [3:0]M_AXI_GP0_ARCACHE;
  output [3:0]M_AXI_GP0_ARLEN;
  output [3:0]M_AXI_GP0_ARQOS;
  output [3:0]M_AXI_GP0_AWCACHE;
  output [3:0]M_AXI_GP0_AWLEN;
  output [3:0]M_AXI_GP0_AWQOS;
  output [3:0]M_AXI_GP0_WSTRB;
  input M_AXI_GP0_ACLK /* synthesis syn_isclock = 1 */;
  input M_AXI_GP0_ARREADY;
  input M_AXI_GP0_AWREADY;
  input M_AXI_GP0_BVALID;
  input M_AXI_GP0_RLAST;
  input M_AXI_GP0_RVALID;
  input M_AXI_GP0_WREADY;
  input [11:0]M_AXI_GP0_BID;
  input [11:0]M_AXI_GP0_RID;
  input [1:0]M_AXI_GP0_BRESP;
  input [1:0]M_AXI_GP0_RRESP;
  input [31:0]M_AXI_GP0_RDATA;
  output FCLK_CLK0 /* synthesis syn_isclock = 1 */;
  output FCLK_RESET0_N;
  inout [53:0]MIO;
  inout DDR_CAS_n;
  inout DDR_CKE;
  inout DDR_Clk_n;
  inout DDR_Clk;
  inout DDR_CS_n;
  inout DDR_DRSTB;
  inout DDR_ODT;
  inout DDR_RAS_n;
  inout DDR_WEB;
  inout [2:0]DDR_BankAddr;
  inout [14:0]DDR_Addr;
  inout DDR_VRN;
  inout DDR_VRP;
  inout [3:0]DDR_DM;
  inout [31:0]DDR_DQ;
  inout [3:0]DDR_DQS_n;
  inout [3:0]DDR_DQS;
  inout PS_SRSTB;
  inout PS_CLK;
  inout PS_PORB;
endmodule
