BehrensG/MADC_ARTY/Software/MADC/MADC.vhd

library ieee;
use ieee.std_logic_1164.all;
use ieee.numeric_std.all;

entity MADC is
	generic(
		-- Users to add parameters here

		-- User parameters ends
		-- Do not modify the parameters beyond this line

		-- Parameters of Axi Slave Bus Interface S00_AXI
		DATA_SIZE : integer := 32;
		ADDR_SIZE : integer := 4;
		-- Custom parameters
		NPLC      : natural := 20000;
		VREF      : natural := 1
	);
	port(
		-- Users to add ports here
		-- MADC -------------------------------------------------------------------
		ad_iin          : out std_logic;
		ad_irn          : out std_logic;
		ad_irp          : out std_logic;
		sw_vrh          : out std_logic;
		ad_id           : out std_logic;
		ad_cmp          : in  std_logic;
		-- User ports ends
		-- Do not modify the ports beyond this line

		-- Ports of Axi Slave Bus Interface S00_AXI
		s00_axi_aclk    : in  std_logic;
		s00_axi_aresetn : in  std_logic;
		s00_axi_awaddr  : in  std_logic_vector(ADDR_SIZE - 1 downto 0);
		s00_axi_awprot  : in  std_logic_vector(2 downto 0);
		s00_axi_awvalid : in  std_logic;
		s00_axi_awready : out std_logic;
		s00_axi_wdata   : in  std_logic_vector(DATA_SIZE - 1 downto 0);
		s00_axi_wstrb   : in  std_logic_vector((DATA_SIZE / 8) - 1 downto 0);
		s00_axi_wvalid  : in  std_logic;
		s00_axi_wready  : out std_logic;
		s00_axi_bresp   : out std_logic_vector(1 downto 0);
		s00_axi_bvalid  : out std_logic;
		s00_axi_bready  : in  std_logic;
		s00_axi_araddr  : in  std_logic_vector(ADDR_SIZE - 1 downto 0);
		s00_axi_arprot  : in  std_logic_vector(2 downto 0);
		s00_axi_arvalid : in  std_logic;
		s00_axi_arready : out std_logic;
		s00_axi_rdata   : out std_logic_vector(DATA_SIZE - 1 downto 0);
		s00_axi_rresp   : out std_logic_vector(1 downto 0);
		s00_axi_rvalid  : out std_logic;
		s00_axi_rready  : in  std_logic
	);
end MADC;

architecture arch_imp of MADC is

	-- component declaration
	component MADC_slave_lite_v1_0_S00_AXI
		generic(
			C_S_AXI_DATA_WIDTH : integer := 32;
			C_S_AXI_ADDR_WIDTH : integer := 4
		);
		port(
			madc_busy     : in  std_logic;
			S_AXI_ACLK    : in  std_logic;
			S_AXI_ARESETN : in  std_logic;
			S_AXI_AWADDR  : in  std_logic_vector(C_S_AXI_ADDR_WIDTH - 1 downto 0);
			S_AXI_AWPROT  : in  std_logic_vector(2 downto 0);
			S_AXI_AWVALID : in  std_logic;
			S_AXI_AWREADY : out std_logic;
			S_AXI_WDATA   : in  std_logic_vector(C_S_AXI_DATA_WIDTH - 1 downto 0);
			S_AXI_WSTRB   : in  std_logic_vector((C_S_AXI_DATA_WIDTH / 8) - 1 downto 0);
			S_AXI_WVALID  : in  std_logic;
			S_AXI_WREADY  : out std_logic;
			S_AXI_BRESP   : out std_logic_vector(1 downto 0);
			S_AXI_BVALID  : out std_logic;
			S_AXI_BREADY  : in  std_logic;
			S_AXI_ARADDR  : in  std_logic_vector(C_S_AXI_ADDR_WIDTH - 1 downto 0);
			S_AXI_ARPROT  : in  std_logic_vector(2 downto 0);
			S_AXI_ARVALID : in  std_logic;
			S_AXI_ARREADY : out std_logic;
			S_AXI_RDATA   : out std_logic_vector(C_S_AXI_DATA_WIDTH - 1 downto 0);
			S_AXI_RRESP   : out std_logic_vector(1 downto 0);
			S_AXI_RVALID  : out std_logic;
			S_AXI_RREADY  : in  std_logic
		);
	end component MADC_slave_lite_v1_0_S00_AXI;

	component madc_ctr
		generic(
			DATA_SIZE : natural := 32;
			ADDR_SIZE : natural := 4;
			NPLC      : natural := 20000;
			VREF      : natural := 1
		);
		port(
			axi4l_clk    : in  std_logic;
			axi4l_rst_n  : in  std_logic;
			axi4l_wdata  : in  std_logic_vector(DATA_SIZE - 1 downto 0);
			axi4l_awaddr : in  std_logic_vector(ADDR_SIZE - 1 downto 0);
			axi4l_wstrb  : in  std_logic_vector((DATA_SIZE / 8) - 1 downto 0);
			axi4l_araddr : in  std_logic_vector(ADDR_SIZE - 1 downto 0);
			axi4l_rdata  : out std_logic_vector(DATA_SIZE - 1 downto 0);
			madc_busy    : out std_logic;
			ad_iin       : out std_logic;
			ad_irn       : out std_logic;
			ad_irp       : out std_logic;
			sw_vrh       : out std_logic;
			ad_id        : out std_logic;
			ad_cmp       : in  std_logic
		);
	end component madc_ctr;

	signal madc_busy : std_logic;
begin
	-- Instantiation of Axi Bus Interface S00_AXI
	MADC_slave_lite_v1_0_S00_AXI_inst : MADC_slave_lite_v1_0_S00_AXI
		generic map(
			C_S_AXI_DATA_WIDTH => DATA_SIZE,
			C_S_AXI_ADDR_WIDTH => ADDR_SIZE
		)
		port map(
			madc_busy     => madc_busy,
			S_AXI_ACLK    => s00_axi_aclk,
			S_AXI_ARESETN => s00_axi_aresetn,
			S_AXI_AWADDR  => s00_axi_awaddr,
			S_AXI_AWPROT  => s00_axi_awprot,
			S_AXI_AWVALID => s00_axi_awvalid,
			S_AXI_AWREADY => s00_axi_awready,
			S_AXI_WDATA   => s00_axi_wdata,
			S_AXI_WSTRB   => s00_axi_wstrb,
			S_AXI_WVALID  => s00_axi_wvalid,
			S_AXI_WREADY  => s00_axi_wready,
			S_AXI_BRESP   => s00_axi_bresp,
			S_AXI_BVALID  => s00_axi_bvalid,
			S_AXI_BREADY  => s00_axi_bready,
			S_AXI_ARADDR  => s00_axi_araddr,
			S_AXI_ARPROT  => s00_axi_arprot,
			S_AXI_ARVALID => s00_axi_arvalid,
			S_AXI_ARREADY => s00_axi_arready,
			S_AXI_RDATA   => s00_axi_rdata,
			S_AXI_RRESP   => s00_axi_rresp,
			S_AXI_RVALID  => s00_axi_rvalid,
			S_AXI_RREADY  => s00_axi_rready
		);

	-- Add user logic here
	madc_ctr_inst : madc_ctr
		generic map(
			DATA_SIZE => DATA_SIZE,
			ADDR_SIZE => ADDR_SIZE,
			NPLC      => NPLC,
			VREF      => VREF
		)
		port map(
			axi4l_clk    => s00_axi_aclk,
			axi4l_rst_n  => s00_axi_aresetn,
			axi4l_wdata  => s00_axi_wdata,
			axi4l_awaddr => s00_axi_awaddr,
			axi4l_wstrb  => s00_axi_wstrb,
			axi4l_araddr => s00_axi_araddr,
			axi4l_rdata  => s00_axi_rdata,
			madc_busy    => madc_busy,
			ad_iin       => ad_iin,
			ad_irn       => ad_irn,
			ad_irp       => ad_irp,
			sw_vrh       => sw_vrh,
			ad_id        => ad_id,
			ad_cmp       => ad_cmp
		);

	-- User logic ends

end arch_imp;
