BehrensG/MADC_ARTY/Software/vivado/MADC_ARTY_Z7/MADC_ARTY_Z7.cache/ip/2024.1/0/1/0184392d3869eee7/MADC_ARTY_Z7_MADC_0_0_stub.v

// Copyright 1986-2022 Xilinx, Inc. All Rights Reserved.
// Copyright 2022-2024 Advanced Micro Devices, Inc. All Rights Reserved.
// --------------------------------------------------------------------------------
// Tool Version: Vivado v.2024.1 (lin64) Build 5076996 Wed May 22 18:36:09 MDT 2024
// Date        : Fri Oct  2 18:40:17 2026
// Host        : archlinux running 64-bit Arch Linux
// Command     : write_verilog -force -mode synth_stub -rename_top decalper_eb_ot_sdeen_pot_pi_dehcac_xnilix -prefix
//               decalper_eb_ot_sdeen_pot_pi_dehcac_xnilix_ MADC_ARTY_Z7_MADC_0_0_stub.v
// Design      : MADC_ARTY_Z7_MADC_0_0
// Purpose     : Stub declaration of top-level module interface
// Device      : xc7z010clg400-1
// --------------------------------------------------------------------------------

// This empty module with port declaration file causes synthesis tools to infer a black box for IP.
// The synthesis directives are for Synopsys Synplify support to prevent IO buffer insertion.
// Please paste the declaration into a Verilog source file or add the file as an additional source.
(* x_core_info = "MADC,Vivado 2024.1" *)
module decalper_eb_ot_sdeen_pot_pi_dehcac_xnilix(ad_iin, ad_irn, ad_irp, sw_vrh, ad_id, ad_cmp, 
  s00_axi_aclk, s00_axi_aresetn, s00_axi_awaddr, s00_axi_awprot, s00_axi_awvalid, 
  s00_axi_awready, s00_axi_wdata, s00_axi_wstrb, s00_axi_wvalid, s00_axi_wready, 
  s00_axi_bresp, s00_axi_bvalid, s00_axi_bready, s00_axi_araddr, s00_axi_arprot, 
  s00_axi_arvalid, s00_axi_arready, s00_axi_rdata, s00_axi_rresp, s00_axi_rvalid, 
  s00_axi_rready)
/* synthesis syn_black_box black_box_pad_pin="ad_iin,ad_irn,ad_irp,sw_vrh,ad_id,ad_cmp,s00_axi_aresetn,s00_axi_awaddr[7:0],s00_axi_awprot[2:0],s00_axi_awvalid,s00_axi_awready,s00_axi_wdata[31:0],s00_axi_wstrb[3:0],s00_axi_wvalid,s00_axi_wready,s00_axi_bresp[1:0],s00_axi_bvalid,s00_axi_bready,s00_axi_araddr[7:0],s00_axi_arprot[2:0],s00_axi_arvalid,s00_axi_arready,s00_axi_rdata[31:0],s00_axi_rresp[1:0],s00_axi_rvalid,s00_axi_rready" */
/* synthesis syn_force_seq_prim="s00_axi_aclk" */;
  output ad_iin;
  output ad_irn;
  output ad_irp;
  output sw_vrh;
  output ad_id;
  input ad_cmp;
  input s00_axi_aclk /* synthesis syn_isclock = 1 */;
  input s00_axi_aresetn;
  input [7:0]s00_axi_awaddr;
  input [2:0]s00_axi_awprot;
  input s00_axi_awvalid;
  output s00_axi_awready;
  input [31:0]s00_axi_wdata;
  input [3:0]s00_axi_wstrb;
  input s00_axi_wvalid;
  output s00_axi_wready;
  output [1:0]s00_axi_bresp;
  output s00_axi_bvalid;
  input s00_axi_bready;
  input [7:0]s00_axi_araddr;
  input [2:0]s00_axi_arprot;
  input s00_axi_arvalid;
  output s00_axi_arready;
  output [31:0]s00_axi_rdata;
  output [1:0]s00_axi_rresp;
  output s00_axi_rvalid;
  input s00_axi_rready;
endmodule
