BehrensG/MADC_ARTY/Software/vivado/MADC_ARTY_Z7/MADC_ARTY_Z7.cache/ip/2024.1/0/1/0184392d3869eee7/MADC_ARTY_Z7_MADC_0_0_sim_netlist.v

// Copyright 1986-2022 Xilinx, Inc. All Rights Reserved.
// Copyright 2022-2024 Advanced Micro Devices, Inc. All Rights Reserved.
// --------------------------------------------------------------------------------
// Tool Version: Vivado v.2024.1 (lin64) Build 5076996 Wed May 22 18:36:09 MDT 2024
// Date        : Fri Oct  2 18:40:17 2026
// Host        : archlinux running 64-bit Arch Linux
// Command     : write_verilog -force -mode funcsim -rename_top decalper_eb_ot_sdeen_pot_pi_dehcac_xnilix -prefix
//               decalper_eb_ot_sdeen_pot_pi_dehcac_xnilix_ MADC_ARTY_Z7_MADC_0_0_sim_netlist.v
// Design      : MADC_ARTY_Z7_MADC_0_0
// Purpose     : This verilog netlist is a functional simulation representation of the design and should not be modified
//               or synthesized. This netlist cannot be used for SDF annotated simulation.
// Device      : xc7z010clg400-1
// --------------------------------------------------------------------------------
`timescale 1 ps / 1 ps

module decalper_eb_ot_sdeen_pot_pi_dehcac_xnilix_MADC
   (s00_axi_awready,
    s00_axi_arready,
    s00_axi_bvalid,
    s00_axi_rvalid,
    s00_axi_rdata,
    ad_iin,
    ad_id,
    ad_irp,
    ad_irn,
    s00_axi_awvalid,
    s00_axi_wvalid,
    s00_axi_aclk,
    s00_axi_bready,
    s00_axi_arvalid,
    s00_axi_rready,
    s00_axi_wdata,
    s00_axi_awaddr,
    s00_axi_wstrb,
    s00_axi_araddr,
    ad_cmp,
    s00_axi_aresetn);
  output s00_axi_awready;
  output s00_axi_arready;
  output s00_axi_bvalid;
  output s00_axi_rvalid;
  output [31:0]s00_axi_rdata;
  output ad_iin;
  output ad_id;
  output ad_irp;
  output ad_irn;
  input s00_axi_awvalid;
  input s00_axi_wvalid;
  input s00_axi_aclk;
  input s00_axi_bready;
  input s00_axi_arvalid;
  input s00_axi_rready;
  input [31:0]s00_axi_wdata;
  input [7:0]s00_axi_awaddr;
  input [3:0]s00_axi_wstrb;
  input [7:0]s00_axi_araddr;
  input ad_cmp;
  input s00_axi_aresetn;

  wire ad_cmp;
  wire ad_id;
  wire ad_id_i_1_n_0;
  wire ad_iin;
  wire ad_iin_i_1_n_0;
  wire ad_iin_i_2_n_0;
  wire ad_irn;
  wire ad_irn2;
  wire ad_irn_i_1_n_0;
  wire ad_irp;
  wire ad_irp_i_1_n_0;
  wire l;
  wire madc_busy;
  wire madc_busy_i_1_n_0;
  wire madc_ctr_inst_n_6;
  wire s00_axi_aclk;
  wire [7:0]s00_axi_araddr;
  wire s00_axi_aresetn;
  wire s00_axi_arready;
  wire s00_axi_arvalid;
  wire [7:0]s00_axi_awaddr;
  wire s00_axi_awready;
  wire s00_axi_awvalid;
  wire s00_axi_bready;
  wire s00_axi_bvalid;
  wire [31:0]s00_axi_rdata;
  wire s00_axi_rready;
  wire s00_axi_rvalid;
  wire [31:0]s00_axi_wdata;
  wire [3:0]s00_axi_wstrb;
  wire s00_axi_wvalid;
  wire [2:0]state;

  decalper_eb_ot_sdeen_pot_pi_dehcac_xnilix_MADC_slave_lite_v1_0_S00_AXI MADC_slave_lite_v1_0_S00_AXI_inst
       (.axi_bvalid_reg_0(madc_ctr_inst_n_6),
        .axi_rvalid_reg_0(ad_iin_i_2_n_0),
        .s00_axi_aclk(s00_axi_aclk),
        .s00_axi_arready(s00_axi_arready),
        .s00_axi_arvalid(s00_axi_arvalid),
        .s00_axi_awready(s00_axi_awready),
        .s00_axi_awvalid(s00_axi_awvalid),
        .s00_axi_bvalid(s00_axi_bvalid),
        .s00_axi_rready(s00_axi_rready),
        .s00_axi_rvalid(s00_axi_rvalid),
        .s00_axi_wvalid(s00_axi_wvalid));
  (* SOFT_HLUTNM = "soft_lutpair50" *) 
  LUT4 #(
    .INIT(16'hDF01)) 
    ad_id_i_1
       (.I0(state[2]),
        .I1(state[0]),
        .I2(state[1]),
        .I3(ad_id),
        .O(ad_id_i_1_n_0));
  LUT5 #(
    .INIT(32'hFFFB300B)) 
    ad_iin_i_1
       (.I0(l),
        .I1(state[0]),
        .I2(state[2]),
        .I3(state[1]),
        .I4(ad_iin),
        .O(ad_iin_i_1_n_0));
  LUT1 #(
    .INIT(2'h1)) 
    ad_iin_i_2
       (.I0(s00_axi_aresetn),
        .O(ad_iin_i_2_n_0));
  LUT6 #(
    .INIT(64'hEFFFFFFF20FF3333)) 
    ad_irn_i_1
       (.I0(ad_cmp),
        .I1(state[2]),
        .I2(ad_irn2),
        .I3(state[0]),
        .I4(state[1]),
        .I5(ad_irn),
        .O(ad_irn_i_1_n_0));
  LUT6 #(
    .INIT(64'hDFCCFFFF10CC3333)) 
    ad_irp_i_1
       (.I0(ad_cmp),
        .I1(state[2]),
        .I2(ad_irn2),
        .I3(state[0]),
        .I4(state[1]),
        .I5(ad_irp),
        .O(ad_irp_i_1_n_0));
  (* SOFT_HLUTNM = "soft_lutpair50" *) 
  LUT4 #(
    .INIT(16'h7F01)) 
    madc_busy_i_1
       (.I0(state[2]),
        .I1(state[0]),
        .I2(state[1]),
        .I3(madc_busy),
        .O(madc_busy_i_1_n_0));
  decalper_eb_ot_sdeen_pot_pi_dehcac_xnilix_madc_ctr madc_ctr_inst
       (.CO(ad_irn2),
        .ad_cmp(ad_cmp),
        .ad_id(ad_id),
        .ad_id_reg_0(ad_id_i_1_n_0),
        .ad_iin(ad_iin),
        .ad_iin_reg_0(ad_iin_i_2_n_0),
        .ad_iin_reg_1(ad_iin_i_1_n_0),
        .ad_irn(ad_irn),
        .ad_irn_reg_0(ad_irn_i_1_n_0),
        .ad_irp(ad_irp),
        .ad_irp_reg_0(ad_irp_i_1_n_0),
        .l(l),
        .madc_busy(madc_busy),
        .madc_busy_reg_0(madc_ctr_inst_n_6),
        .madc_busy_reg_1(madc_busy_i_1_n_0),
        .s00_axi_aclk(s00_axi_aclk),
        .s00_axi_araddr(s00_axi_araddr),
        .s00_axi_awaddr(s00_axi_awaddr),
        .s00_axi_bready(s00_axi_bready),
        .s00_axi_bvalid(s00_axi_bvalid),
        .s00_axi_rdata(s00_axi_rdata),
        .s00_axi_wdata(s00_axi_wdata),
        .s00_axi_wstrb(s00_axi_wstrb),
        .state(state));
endmodule

(* CHECK_LICENSE_TYPE = "MADC_ARTY_Z7_MADC_0_0,MADC,{}" *) (* downgradeipidentifiedwarnings = "yes" *) (* x_core_info = "MADC,Vivado 2024.1" *) 
(* NotValidForBitStream *)
module decalper_eb_ot_sdeen_pot_pi_dehcac_xnilix
   (ad_iin,
    ad_irn,
    ad_irp,
    sw_vrh,
    ad_id,
    ad_cmp,
    s00_axi_aclk,
    s00_axi_aresetn,
    s00_axi_awaddr,
    s00_axi_awprot,
    s00_axi_awvalid,
    s00_axi_awready,
    s00_axi_wdata,
    s00_axi_wstrb,
    s00_axi_wvalid,
    s00_axi_wready,
    s00_axi_bresp,
    s00_axi_bvalid,
    s00_axi_bready,
    s00_axi_araddr,
    s00_axi_arprot,
    s00_axi_arvalid,
    s00_axi_arready,
    s00_axi_rdata,
    s00_axi_rresp,
    s00_axi_rvalid,
    s00_axi_rready);
  output ad_iin;
  output ad_irn;
  output ad_irp;
  output sw_vrh;
  output ad_id;
  input ad_cmp;
  (* x_interface_info = "xilinx.com:signal:clock:1.0 S00_AXI_CLK CLK" *) (* x_interface_parameter = "XIL_INTERFACENAME S00_AXI_CLK, ASSOCIATED_BUSIF S00_AXI, ASSOCIATED_RESET s00_axi_aresetn, FREQ_TOLERANCE_HZ 0, PHASE 0.0, CLK_DOMAIN MADC_ARTY_Z7_processing_system7_0_0_FCLK_CLK0, INSERT_VIP 0" *) input s00_axi_aclk;
  (* x_interface_info = "xilinx.com:signal:reset:1.0 S00_AXI_RST RST" *) (* x_interface_parameter = "XIL_INTERFACENAME S00_AXI_RST, POLARITY ACTIVE_LOW, INSERT_VIP 0" *) input s00_axi_aresetn;
  (* x_interface_info = "xilinx.com:interface:aximm:1.0 S00_AXI AWADDR" *) (* x_interface_parameter = "XIL_INTERFACENAME S00_AXI, WIZ_DATA_WIDTH 32, WIZ_NUM_REG 4, SUPPORTS_NARROW_BURST 0, DATA_WIDTH 32, PROTOCOL AXI4LITE, ID_WIDTH 0, ADDR_WIDTH 8, AWUSER_WIDTH 0, ARUSER_WIDTH 0, WUSER_WIDTH 0, RUSER_WIDTH 0, BUSER_WIDTH 0, READ_WRITE_MODE READ_WRITE, HAS_BURST 0, HAS_LOCK 0, HAS_PROT 1, HAS_CACHE 0, HAS_QOS 0, HAS_REGION 0, HAS_WSTRB 1, HAS_BRESP 1, HAS_RRESP 1, NUM_READ_OUTSTANDING 2, NUM_WRITE_OUTSTANDING 2, MAX_BURST_LENGTH 1, PHASE 0.0, CLK_DOMAIN MADC_ARTY_Z7_processing_system7_0_0_FCLK_CLK0, NUM_READ_THREADS 1, NUM_WRITE_THREADS 1, RUSER_BITS_PER_BYTE 0, WUSER_BITS_PER_BYTE 0, INSERT_VIP 0" *) input [7:0]s00_axi_awaddr;
  (* x_interface_info = "xilinx.com:interface:aximm:1.0 S00_AXI AWPROT" *) input [2:0]s00_axi_awprot;
  (* x_interface_info = "xilinx.com:interface:aximm:1.0 S00_AXI AWVALID" *) input s00_axi_awvalid;
  (* x_interface_info = "xilinx.com:interface:aximm:1.0 S00_AXI AWREADY" *) output s00_axi_awready;
  (* x_interface_info = "xilinx.com:interface:aximm:1.0 S00_AXI WDATA" *) input [31:0]s00_axi_wdata;
  (* x_interface_info = "xilinx.com:interface:aximm:1.0 S00_AXI WSTRB" *) input [3:0]s00_axi_wstrb;
  (* x_interface_info = "xilinx.com:interface:aximm:1.0 S00_AXI WVALID" *) input s00_axi_wvalid;
  (* x_interface_info = "xilinx.com:interface:aximm:1.0 S00_AXI WREADY" *) output s00_axi_wready;
  (* x_interface_info = "xilinx.com:interface:aximm:1.0 S00_AXI BRESP" *) output [1:0]s00_axi_bresp;
  (* x_interface_info = "xilinx.com:interface:aximm:1.0 S00_AXI BVALID" *) output s00_axi_bvalid;
  (* x_interface_info = "xilinx.com:interface:aximm:1.0 S00_AXI BREADY" *) input s00_axi_bready;
  (* x_interface_info = "xilinx.com:interface:aximm:1.0 S00_AXI ARADDR" *) input [7:0]s00_axi_araddr;
  (* x_interface_info = "xilinx.com:interface:aximm:1.0 S00_AXI ARPROT" *) input [2:0]s00_axi_arprot;
  (* x_interface_info = "xilinx.com:interface:aximm:1.0 S00_AXI ARVALID" *) input s00_axi_arvalid;
  (* x_interface_info = "xilinx.com:interface:aximm:1.0 S00_AXI ARREADY" *) output s00_axi_arready;
  (* x_interface_info = "xilinx.com:interface:aximm:1.0 S00_AXI RDATA" *) output [31:0]s00_axi_rdata;
  (* x_interface_info = "xilinx.com:interface:aximm:1.0 S00_AXI RRESP" *) output [1:0]s00_axi_rresp;
  (* x_interface_info = "xilinx.com:interface:aximm:1.0 S00_AXI RVALID" *) output s00_axi_rvalid;
  (* x_interface_info = "xilinx.com:interface:aximm:1.0 S00_AXI RREADY" *) input s00_axi_rready;

  wire \<const0> ;
  wire \<const1> ;
  wire ad_cmp;
  wire ad_id;
  wire ad_iin;
  wire ad_irn;
  wire ad_irp;
  wire s00_axi_aclk;
  wire [7:0]s00_axi_araddr;
  wire s00_axi_aresetn;
  wire s00_axi_arready;
  wire s00_axi_arvalid;
  wire [7:0]s00_axi_awaddr;
  wire s00_axi_awready;
  wire s00_axi_awvalid;
  wire s00_axi_bready;
  wire s00_axi_bvalid;
  wire [31:0]s00_axi_rdata;
  wire s00_axi_rready;
  wire s00_axi_rvalid;
  wire [31:0]s00_axi_wdata;
  wire [3:0]s00_axi_wstrb;
  wire s00_axi_wvalid;

  assign s00_axi_bresp[1] = \<const0> ;
  assign s00_axi_bresp[0] = \<const0> ;
  assign s00_axi_rresp[1] = \<const0> ;
  assign s00_axi_rresp[0] = \<const0> ;
  assign s00_axi_wready = s00_axi_awready;
  assign sw_vrh = \<const1> ;
  GND GND
       (.G(\<const0> ));
  decalper_eb_ot_sdeen_pot_pi_dehcac_xnilix_MADC U0
       (.ad_cmp(ad_cmp),
        .ad_id(ad_id),
        .ad_iin(ad_iin),
        .ad_irn(ad_irn),
        .ad_irp(ad_irp),
        .s00_axi_aclk(s00_axi_aclk),
        .s00_axi_araddr(s00_axi_araddr),
        .s00_axi_aresetn(s00_axi_aresetn),
        .s00_axi_arready(s00_axi_arready),
        .s00_axi_arvalid(s00_axi_arvalid),
        .s00_axi_awaddr(s00_axi_awaddr),
        .s00_axi_awready(s00_axi_awready),
        .s00_axi_awvalid(s00_axi_awvalid),
        .s00_axi_bready(s00_axi_bready),
        .s00_axi_bvalid(s00_axi_bvalid),
        .s00_axi_rdata(s00_axi_rdata),
        .s00_axi_rready(s00_axi_rready),
        .s00_axi_rvalid(s00_axi_rvalid),
        .s00_axi_wdata(s00_axi_wdata),
        .s00_axi_wstrb(s00_axi_wstrb),
        .s00_axi_wvalid(s00_axi_wvalid));
  VCC VCC
       (.P(\<const1> ));
endmodule

module decalper_eb_ot_sdeen_pot_pi_dehcac_xnilix_MADC_slave_lite_v1_0_S00_AXI
   (s00_axi_awready,
    s00_axi_arready,
    s00_axi_bvalid,
    s00_axi_rvalid,
    s00_axi_awvalid,
    s00_axi_wvalid,
    axi_rvalid_reg_0,
    s00_axi_aclk,
    axi_bvalid_reg_0,
    s00_axi_arvalid,
    s00_axi_rready);
  output s00_axi_awready;
  output s00_axi_arready;
  output s00_axi_bvalid;
  output s00_axi_rvalid;
  input s00_axi_awvalid;
  input s00_axi_wvalid;
  input axi_rvalid_reg_0;
  input s00_axi_aclk;
  input axi_bvalid_reg_0;
  input s00_axi_arvalid;
  input s00_axi_rready;

  wire axi_arready0;
  wire axi_awready0__0;
  wire axi_bvalid_reg_0;
  wire axi_rvalid_i_1_n_0;
  wire axi_rvalid_reg_0;
  wire s00_axi_aclk;
  wire s00_axi_arready;
  wire s00_axi_arvalid;
  wire s00_axi_awready;
  wire s00_axi_awvalid;
  wire s00_axi_bvalid;
  wire s00_axi_rready;
  wire s00_axi_rvalid;
  wire s00_axi_wvalid;

  (* SOFT_HLUTNM = "soft_lutpair0" *) 
  LUT2 #(
    .INIT(4'h2)) 
    axi_arready_i_1
       (.I0(s00_axi_arvalid),
        .I1(s00_axi_arready),
        .O(axi_arready0));
  FDRE axi_arready_reg
       (.C(s00_axi_aclk),
        .CE(1'b1),
        .D(axi_arready0),
        .Q(s00_axi_arready),
        .R(axi_rvalid_reg_0));
  LUT3 #(
    .INIT(8'h08)) 
    axi_awready0
       (.I0(s00_axi_awvalid),
        .I1(s00_axi_wvalid),
        .I2(s00_axi_awready),
        .O(axi_awready0__0));
  FDRE axi_awready_reg
       (.C(s00_axi_aclk),
        .CE(1'b1),
        .D(axi_awready0__0),
        .Q(s00_axi_awready),
        .R(axi_rvalid_reg_0));
  FDRE axi_bvalid_reg
       (.C(s00_axi_aclk),
        .CE(1'b1),
        .D(axi_bvalid_reg_0),
        .Q(s00_axi_bvalid),
        .R(axi_rvalid_reg_0));
  (* SOFT_HLUTNM = "soft_lutpair0" *) 
  LUT4 #(
    .INIT(16'h88F8)) 
    axi_rvalid_i_1
       (.I0(s00_axi_arready),
        .I1(s00_axi_arvalid),
        .I2(s00_axi_rvalid),
        .I3(s00_axi_rready),
        .O(axi_rvalid_i_1_n_0));
  FDRE axi_rvalid_reg
       (.C(s00_axi_aclk),
        .CE(1'b1),
        .D(axi_rvalid_i_1_n_0),
        .Q(s00_axi_rvalid),
        .R(axi_rvalid_reg_0));
endmodule

module decalper_eb_ot_sdeen_pot_pi_dehcac_xnilix_madc_ctr
   (l,
    madc_busy,
    ad_iin,
    ad_irn,
    ad_irp,
    ad_id,
    madc_busy_reg_0,
    CO,
    state,
    s00_axi_rdata,
    s00_axi_aclk,
    ad_iin_reg_0,
    madc_busy_reg_1,
    ad_iin_reg_1,
    ad_irn_reg_0,
    ad_irp_reg_0,
    ad_id_reg_0,
    s00_axi_bvalid,
    s00_axi_bready,
    s00_axi_wdata,
    s00_axi_awaddr,
    s00_axi_wstrb,
    s00_axi_araddr,
    ad_cmp);
  output l;
  output madc_busy;
  output ad_iin;
  output ad_irn;
  output ad_irp;
  output ad_id;
  output madc_busy_reg_0;
  output [0:0]CO;
  output [2:0]state;
  output [31:0]s00_axi_rdata;
  input s00_axi_aclk;
  input ad_iin_reg_0;
  input madc_busy_reg_1;
  input ad_iin_reg_1;
  input ad_irn_reg_0;
  input ad_irp_reg_0;
  input ad_id_reg_0;
  input s00_axi_bvalid;
  input s00_axi_bready;
  input [31:0]s00_axi_wdata;
  input [7:0]s00_axi_awaddr;
  input [3:0]s00_axi_wstrb;
  input [7:0]s00_axi_araddr;
  input ad_cmp;

  wire [0:0]CO;
  wire \FSM_sequential_state[0]_i_1_n_0 ;
  wire \FSM_sequential_state[0]_i_2_n_0 ;
  wire \FSM_sequential_state[1]_i_1_n_0 ;
  wire \FSM_sequential_state[1]_i_2_n_0 ;
  wire \FSM_sequential_state[2]_i_1_n_0 ;
  wire T1;
  wire ad_cmp;
  wire ad_id;
  wire ad_id_reg_0;
  wire ad_iin;
  wire ad_iin_reg_0;
  wire ad_iin_reg_1;
  wire ad_irn;
  wire ad_irn2_carry__0_i_1_n_0;
  wire ad_irn2_carry__0_i_2_n_0;
  wire ad_irn2_carry__0_i_3_n_0;
  wire ad_irn2_carry__0_i_4_n_0;
  wire ad_irn2_carry__0_i_5_n_0;
  wire ad_irn2_carry__0_i_6_n_0;
  wire ad_irn2_carry__0_i_7_n_0;
  wire ad_irn2_carry__0_i_8_n_0;
  wire ad_irn2_carry__0_n_0;
  wire ad_irn2_carry__0_n_1;
  wire ad_irn2_carry__0_n_2;
  wire ad_irn2_carry__0_n_3;
  wire ad_irn2_carry__1_i_1_n_0;
  wire ad_irn2_carry__1_i_2_n_0;
  wire ad_irn2_carry__1_i_3_n_0;
  wire ad_irn2_carry__1_i_4_n_0;
  wire ad_irn2_carry__1_i_5_n_0;
  wire ad_irn2_carry__1_i_6_n_0;
  wire ad_irn2_carry__1_i_7_n_0;
  wire ad_irn2_carry__1_i_8_n_0;
  wire ad_irn2_carry__1_n_0;
  wire ad_irn2_carry__1_n_1;
  wire ad_irn2_carry__1_n_2;
  wire ad_irn2_carry__1_n_3;
  wire ad_irn2_carry__2_i_1_n_0;
  wire ad_irn2_carry__2_i_2_n_0;
  wire ad_irn2_carry__2_i_3_n_0;
  wire ad_irn2_carry__2_i_4_n_0;
  wire ad_irn2_carry__2_i_5_n_0;
  wire ad_irn2_carry__2_i_6_n_0;
  wire ad_irn2_carry__2_i_7_n_0;
  wire ad_irn2_carry__2_i_8_n_0;
  wire ad_irn2_carry__2_n_1;
  wire ad_irn2_carry__2_n_2;
  wire ad_irn2_carry__2_n_3;
  wire ad_irn2_carry_i_1_n_0;
  wire ad_irn2_carry_i_2_n_0;
  wire ad_irn2_carry_i_3_n_0;
  wire ad_irn2_carry_i_4_n_0;
  wire ad_irn2_carry_i_5_n_0;
  wire ad_irn2_carry_i_6_n_0;
  wire ad_irn2_carry_i_7_n_0;
  wire ad_irn2_carry_i_8_n_0;
  wire ad_irn2_carry_n_0;
  wire ad_irn2_carry_n_1;
  wire ad_irn2_carry_n_2;
  wire ad_irn2_carry_n_3;
  wire ad_irn_reg_0;
  wire ad_irp;
  wire ad_irp_reg_0;
  wire \axi4l_reg_calib[15]_i_1_n_0 ;
  wire \axi4l_reg_calib[23]_i_1_n_0 ;
  wire \axi4l_reg_calib[31]_i_1_n_0 ;
  wire \axi4l_reg_calib[7]_i_1_n_0 ;
  wire \axi4l_reg_calib_reg_n_0_[0] ;
  wire \axi4l_reg_calib_reg_n_0_[10] ;
  wire \axi4l_reg_calib_reg_n_0_[11] ;
  wire \axi4l_reg_calib_reg_n_0_[12] ;
  wire \axi4l_reg_calib_reg_n_0_[13] ;
  wire \axi4l_reg_calib_reg_n_0_[14] ;
  wire \axi4l_reg_calib_reg_n_0_[15] ;
  wire \axi4l_reg_calib_reg_n_0_[16] ;
  wire \axi4l_reg_calib_reg_n_0_[17] ;
  wire \axi4l_reg_calib_reg_n_0_[18] ;
  wire \axi4l_reg_calib_reg_n_0_[19] ;
  wire \axi4l_reg_calib_reg_n_0_[1] ;
  wire \axi4l_reg_calib_reg_n_0_[20] ;
  wire \axi4l_reg_calib_reg_n_0_[21] ;
  wire \axi4l_reg_calib_reg_n_0_[22] ;
  wire \axi4l_reg_calib_reg_n_0_[23] ;
  wire \axi4l_reg_calib_reg_n_0_[24] ;
  wire \axi4l_reg_calib_reg_n_0_[25] ;
  wire \axi4l_reg_calib_reg_n_0_[26] ;
  wire \axi4l_reg_calib_reg_n_0_[27] ;
  wire \axi4l_reg_calib_reg_n_0_[28] ;
  wire \axi4l_reg_calib_reg_n_0_[29] ;
  wire \axi4l_reg_calib_reg_n_0_[2] ;
  wire \axi4l_reg_calib_reg_n_0_[30] ;
  wire \axi4l_reg_calib_reg_n_0_[31] ;
  wire \axi4l_reg_calib_reg_n_0_[3] ;
  wire \axi4l_reg_calib_reg_n_0_[4] ;
  wire \axi4l_reg_calib_reg_n_0_[5] ;
  wire \axi4l_reg_calib_reg_n_0_[6] ;
  wire \axi4l_reg_calib_reg_n_0_[7] ;
  wire \axi4l_reg_calib_reg_n_0_[8] ;
  wire \axi4l_reg_calib_reg_n_0_[9] ;
  wire axi4l_reg_n_cnt;
  wire \axi4l_reg_n_cnt_reg_n_0_[0] ;
  wire \axi4l_reg_n_cnt_reg_n_0_[10] ;
  wire \axi4l_reg_n_cnt_reg_n_0_[11] ;
  wire \axi4l_reg_n_cnt_reg_n_0_[12] ;
  wire \axi4l_reg_n_cnt_reg_n_0_[13] ;
  wire \axi4l_reg_n_cnt_reg_n_0_[14] ;
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
  wire [3:0]NLW_madc_n_cnt0_carry_O_UNCONNECTED;
  wire [3:0]NLW_madc_n_cnt0_carry__0_O_UNCONNECTED;
  wire [3:0]NLW_madc_n_cnt0_carry__1_O_UNCONNECTED;
  wire [3:0]NLW_madc_n_cnt0_carry__2_O_UNCONNECTED;
  wire [3:0]\NLW_madc_n_cnt1_inferred__0/i__carry_O_UNCONNECTED ;
  wire [3:0]\NLW_madc_n_cnt1_inferred__0/i__carry__0_O_UNCONNECTED ;
  wire [3:0]\NLW_madc_n_cnt1_inferred__0/i__carry__1_O_UNCONNECTED ;
  wire [3:0]\NLW_madc_n_cnt1_inferred__0/i__carry__2_O_UNCONNECTED ;
  wire [3:2]\NLW_plusOp_inferred__1/i__carry__6_CO_UNCONNECTED ;
  wire [3:3]\NLW_plusOp_inferred__1/i__carry__6_O_UNCONNECTED ;
  wire [3:2]\NLW_plusOp_inferred__2/i__carry__6_CO_UNCONNECTED ;
  wire [3:3]\NLW_plusOp_inferred__2/i__carry__6_O_UNCONNECTED ;
  wire [3:0]\NLW_totl_cnt_reg[31]_i_13_O_UNCONNECTED ;
  wire [3:2]\NLW_totl_cnt_reg[31]_i_3_CO_UNCONNECTED ;
  wire [3:0]\NLW_totl_cnt_reg[31]_i_3_O_UNCONNECTED ;
  wire [3:2]\NLW_totl_cnt_reg[31]_i_4_CO_UNCONNECTED ;
  wire [3:3]\NLW_totl_cnt_reg[31]_i_4_O_UNCONNECTED ;
  wire [3:0]\NLW_totl_cnt_reg[31]_i_5_O_UNCONNECTED ;
  wire [3:0]\NLW_totl_cnt_reg[31]_i_8_O_UNCONNECTED ;
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
