BehrensG/MADC_ARTY/Software/vivado/MADC_ARTY_Z7/MADC_ARTY_Z7.cache/ip/2024.1/0/d/0d1976312b5f65bf/MADC_ARTY_Z7_axi_gpio_0_0_sim_netlist.v

// Copyright 1986-2022 Xilinx, Inc. All Rights Reserved.
// Copyright 2022-2024 Advanced Micro Devices, Inc. All Rights Reserved.
// --------------------------------------------------------------------------------
// Tool Version: Vivado v.2024.1 (lin64) Build 5076996 Wed May 22 18:36:09 MDT 2024
// Date        : Thu Sep  3 19:29:10 2026
// Host        : archlinux running 64-bit Arch Linux
// Command     : write_verilog -force -mode funcsim -rename_top decalper_eb_ot_sdeen_pot_pi_dehcac_xnilix -prefix
//               decalper_eb_ot_sdeen_pot_pi_dehcac_xnilix_ MADC_ARTY_Z7_axi_gpio_0_0_sim_netlist.v
// Design      : MADC_ARTY_Z7_axi_gpio_0_0
// Purpose     : This verilog netlist is a functional simulation representation of the design and should not be modified
//               or synthesized. This netlist cannot be used for SDF annotated simulation.
// Device      : xc7z010clg400-1
// --------------------------------------------------------------------------------
`timescale 1 ps / 1 ps

module decalper_eb_ot_sdeen_pot_pi_dehcac_xnilix_GPIO_Core
   (gpio_io_o,
    reg3,
    gpio2_io_o,
    reg1,
    GPIO_xferAck_i,
    gpio_xferAck_Reg,
    ip2bus_wrack_i,
    ip2bus_rdack_i,
    \Dual.ALLOUT0_ND_G1.READ_REG_GEN[0].reg1_reg[28]_0 ,
    s_axi_aclk,
    SR,
    bus2ip_cs,
    bus2ip_rnw,
    E,
    s_axi_wdata,
    \Dual.gpio2_Data_Out_reg[0]_0 );
  output [3:0]gpio_io_o;
  output [3:0]reg3;
  output [3:0]gpio2_io_o;
  output [3:0]reg1;
  output GPIO_xferAck_i;
  output gpio_xferAck_Reg;
  output ip2bus_wrack_i;
  output ip2bus_rdack_i;
  input \Dual.ALLOUT0_ND_G1.READ_REG_GEN[0].reg1_reg[28]_0 ;
  input s_axi_aclk;
  input [0:0]SR;
  input bus2ip_cs;
  input bus2ip_rnw;
  input [0:0]E;
  input [3:0]s_axi_wdata;
  input [0:0]\Dual.gpio2_Data_Out_reg[0]_0 ;

  wire \Dual.ALLOUT0_ND_G1.READ_REG_GEN[0].reg1_reg[28]_0 ;
  wire [0:0]\Dual.gpio2_Data_Out_reg[0]_0 ;
  wire [0:0]E;
  wire GPIO_xferAck_i;
  wire [0:0]SR;
  wire bus2ip_cs;
  wire bus2ip_rnw;
  wire [3:0]gpio2_io_o;
  (* RTL_KEEP = "yes" *) wire [3:0]gpio_io_o;
  wire gpio_xferAck_Reg;
  wire iGPIO_xferAck;
  wire ip2bus_rdack_i;
  wire ip2bus_wrack_i;
  wire [3:0]reg1;
  wire [3:0]reg3;
  wire s_axi_aclk;
  wire [3:0]s_axi_wdata;
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
