BehrensG/MADC_ARTY/(commit log)

2025-08-24 Analog part works, made CMRR measurements
    [CMRR.ods]
2026-07-30 VHDL code
    [ADC.kicad_sch, AnalogChannels.kicad_sch, AutoZero.kicad_sch, BlockDiagram.kicad_sch, Gain.kicad_sch, MADC.kicad_sch, MADC_ARTY.kicad_sch, PMOD.kicad_sch]
2026-09-09 MADC works. Need to fix the init NPLC data, is 200 should be 20000 (in hardware).
    [MADC.c, MADC.h, MADC.vhd, MADC_ARTY_Z7.v, MADC_ARTY_Z7.vhd, MADC_ARTY_Z7_MADC_0_0.vhd, MADC_ARTY_Z7_MADC_0_0_sim_netlist.v, MADC_ARTY_Z7_MADC_0_0_sim_netlist.vhdl]
