BehrensG/MADC_ARTY/(notices)

Notices in the files:
Software/vivado/MADC_ARTY_Z7/MADC_ARTY_Z7.gen/sources_1/bd/MADC_ARTY_Z7/ip/MADC_ARTY_Z7_processing_system7_0_0/hdl/verilog/processing_system7_v5_5_processing_system7.v:
This file contains proprietary and confidential information of
Xilinx, Inc. ("Xilinx"), that is distributed under a license
Copyright 2010 Xilinx, Inc.
All rights reserved.
